MARS-ROBOTICS-star/Dummy-Robot-Reproduction/notes/钢网图案识别.png

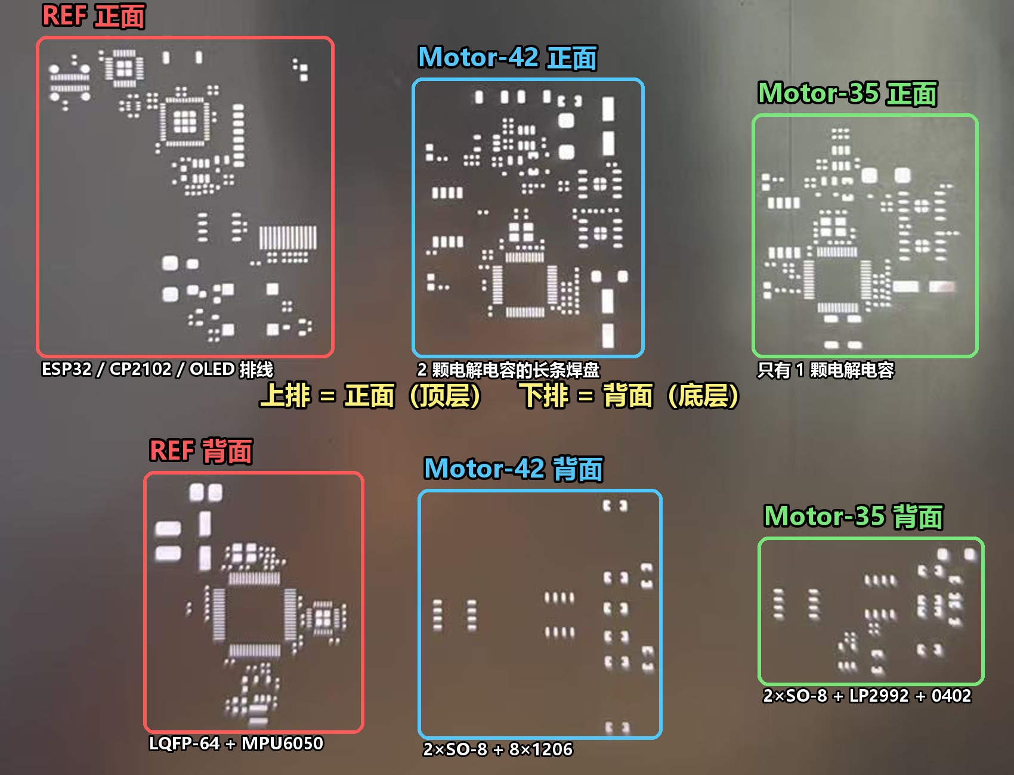
notes/钢网图案识别.png
