MARS-ROBOTICS-star/Dummy-Robot-Reproduction/notes/任同学视频字幕/README.md

# 不爱学习任同学 · Dummy 机械臂复刻系列 — 字幕（已修正）

来源：B 站 UP 主 **不爱学习任同学**（uid 341891548）合集《没有工科经验的人可以复刻稚晖君的 Dummy 机械臂吗》，共 15 集。
字幕为 B 站官方 **AI 自动字幕**（`ai-zh`），经本仓库上下文核对后修正术语与错词。仅作个人学习笔记用。

## 目录

| 目录 | 内容 |
|---|---|
| `srt_原始/` | 下载到的原始 AI 字幕，未改动，用于对照 |
| `srt_术语修正/` | **推荐使用**。时间轴与原始完全一致，可直接挂到视频上；同名 `.txt` 为带时间戳的纯文本 |
| `文稿_修正/` | 加标点、分段、句级改写的可读文稿（目前仅第 01 集，作为样例） |

## 分集清单

| # | BV 号 | 时长 | 标题 | 字幕条数 | 已修正 |
|---|---|---|---|---|---|
| 01 | BV18x421Q7Td | 18:39 | 开篇总览与软件准备 | 379 | 58 |
| 02 | BV1jD42157VY | 20:38 | 电路篇（上）· REF 主控板 | 474 | 81 |
| 03 | BV1YE421g7Uw | 26:19 | 电路篇（下）· CAN 布线与驱动板 | 561 | 58 |
| 04 | BV13m411r78Y | 07:29 | 必备工具 | 159 | 24 |
| 05 | BV1Jm411z78Y | 17:54 | 硬件选型 | 401 | 37 |
| 06 | BV1bi421f7VY | 34:41 | 焊接篇（上） | 621 | 67 |
| 07 | BV1mM4m1D7sS | 06:51 | 焊接篇（下）· 热风枪 | 104 | 20 |
| 08 | BV1vZ421Y77Q | 47:23 | 软件篇（全）· 编译 / 烧录 / CLI-Tool | 1018 | 73 |
| 09 | BV1ui421D7iA | 02:53 | 安装攻略定格动画 | — | 无字幕（纯定格动画，无旁白） |
| 10 | BV15D421V72k | 09:00 | 安装注意细节 / 避坑 | 179 | 38 |
| 11 | BV1by411h7FS | 29:53 | 整机调试教程 · DH 参数与 PID | 624 | 119 |
| 12 | BV11Z421e7YC | 00:22 | 橙白配色展示 | 6 | 0 |
| 13 | BV13Z421n7P3 | 00:24 | 青灰配色 | 4 | 0 |
| 14 | BV1cT421D7sL | 00:30 | 灰黑配色 | 8 | 0 |
| 15 | BV1SBi3eAE8P | 11:21 | 完结 QA + 抽奖 | 209 | 28 |

合计修正 **603** 条字幕。第 04、05 集片尾与第 06 集片头是纯音乐，AI 把歌词也转写了，已替换为「【片头/片尾 BGM，歌词略】」。

## 修正依据

术语拼写一律以**本仓库实际内容**为准，而非凭读音猜测：

- 目录与文件名：`motor42` / `motor35` / `ref-controller`、`dummy-ref-core-fw`、`CLI-Tool`、`DummyStudio`、`Robot/instances/dummy_robot.cpp`、`6dof_kinematic.cpp`
- 元器件型号：`ME3116`、`SY8089A`、`LP2992`、`CP2102`、`MT6816`、`SN65HVD232DR`、`TB67H450FNG`、`MPU6050`、`SH1107`
- 关节对应：`motor42` → J1/J2/J3，`motor35` → J4/J5/J6

### 高频错词对照（节选）

| AI 字幕 | 实际 | 依据 |
|---|---|---|
| 智慧军 / 智慧君 / 智慧基因 / 智慧运 | 稚晖君 | 人名 |
| 当机械臂 / 单机械毕业 / 挡米 / 当米 | Dummy 机械臂 | 项目名 |
| **斜坡** / 吸波减速器 / 细胞减速器 | **谐波减速器** | 全系列高频，108 处 |
| **勾一～勾六** / 高二 / go2 | **J1～J6** | 关节编号，经逐条核对 |
| **pad** / PAID / PIT | **PID** | 上下文为调参、KP/KI/KD |
| 向旭接错了 / 象限相续图 | 相序接错了 / 相序图 | 电机抖动的成因 |
| **镜像磁铁** | **径向磁铁** | 同音；原话解释"磁感线切割"即径向充磁 |
| 珐琅盘 | 法兰盘 | J5 转接件 |
| 卫衣孔 / 沉鱼孔 | 腰形孔 | 皮带轮收紧用 |
| 联系（了） | 连锡 | 焊接语境 |
| 续航 | 虚焊 | 焊接语境 |
| 吸球 / 稀疏 / 吃席 / 上劲 | 锡球 / 锡珠 / 吃锡 / 上锡 | 焊接语境 |
| 妥度 / 土豆 / 懂（吗） | 抖动 / 抖 | 调试语境 |
| 做上胶水 | 做个校准 | 电机校准 |
| 银角 / 阴角 / 音针 | 引脚 | — |
| 那后芯片 / QN 引脚 | QFN 引脚 | 引脚在底下的封装 |
| GABB 文件 | Gerber 文件 | 打板用 |
| STR 文件 / steam 文件 | STL 文件 / STEP 文件 | — |
| 报幕 / BB / BM | BOM 表 | — |
| boss 力 | 波特率 | 串口参数 |
| 包围宝马开关 / 拨码器 | 拨码开关 | 电机 ID 设定 |
| 饿死 / 饿死卡 fire | erase / erase configure | CLI 命令 |
| 木钩 / 木膏 / 木耳 / MOL | MOVJ / MOVL | 插补指令 |
| static | ST-Link | 烧录器 |
| open acd / 开过 | OpenOCD | 烧录后端 |
| 家里创 / 家里窗 / 加一创 | 嘉立创 | — |
| 乌班图 / 无关特 | Ubuntu | — |
| clean | CLion | — |
| out design / auto deserve | Altium Designer | — |
| fashion 360 / 费城 360 / 非 H360 | Fusion 360 | — |
| AITEE / g i t e git | Gitee | — |
| GBT / chat gbd | GPT / ChatGPT | — |
| 腮胡 / 三福 / 五福 | 3V3 / 3.3V / 5V | — |
| 长长臂 | 常闭 | 开关类型 |
| 零二电阻 / 02R | 0Ω 电阻 | 当跳线用 |
| 哈姆达克 | 哈默纳科 | 谐波减速器品牌 |
| 工矿经验 / 攻克经验 | 工科经验 | — |
| 复合成功 | 复刻成功 | — |

## ⚠️ 存疑未改（听音无法确定，保留原文）

这些地方术语表没有动，看视频时需自行判断：

1. **第 01 集 [03:08]**「建一个属于你自己的**纲领**」— 疑为某具体机型名，无法确定。
2. **第 01 集 [06:38]**「可以烧到这个**论坛**里」— 此处疑为 ROM / Flash；但本系列其他地方的"论坛"确实指开源社区，故未统一替换。
3. **第 01 集 [11:09]**「第一个是**孔指挥**的」— 疑为"稚晖君"。
4. **第 01 集 [12:17]**「把**三菱电机二零电机**的区别……板子也分为二零和三五」— 数字识别混乱。按仓库实际应为 42 与 35；已改为"35 电机、42 电机 / 分为 42 和 35"，但原话存疑。
5. **第 04 集 [04:52]**「包括**鞋包**也都买了」— 疑为锡膏。
6. **第 05 集 [01:27]**「STM32 是 103，可以**存档 200**」— 型号后缀不明。
7. **第 05 集 [03:41]**「芯片 232 **玩开镜片**」/「选 2VP232 是根据**报名表**选」— 已知芯片是 SN65HVD232DR，但这两句的修饰词不明。
8. **第 06 集 [02:21]**「但是呢**旺达罗斯**」— 完全不可解。
9. **第 06 集 [15:09]**「尤其是这个 **32 伏**的这个线」— 按电源规格应为 24V。
10. **第 06 集 [19:58]**「这个 **10 米 10 米法**耐压 50 的电容」— 疑为 10μF 或 100μF。
11. **第 08 集 [10:18]**「需要一个**航空员**」— 疑为航空插头。
12. **第 08 集 [18:18]**「为什么要加这个**括号**」— 按 CLI 用法疑为"空格"。
13. **第 08 集 [41:40]**「电机温度我一直是**理由**」— 疑为读数 0。
14. **第 11 集** 减速器参数（mini-11 瞬间最大扭矩 50 / 速比 17 / 平均 5.5；mini-8 为 6.6 / 2.3）— 数字由 AI 转写，未经核对，**不要直接当参数用**。
15. **第 11 集 [15:25]** 归巢位角度「把 70 改成 75」「-75」「木子的是 -73」— 与 `dummy_robot.cpp` 实际值是否一致未核对。

> 提醒：本系列口述的减速比、关节限位、连杆长度等关键参数，与 `6.Docs/DH参数` 图和 `dummy_robot.cpp` 源码之间本就存在冲突（见 `PROJECT_INDEX.md` 第五节）。字幕里的口述数值只能当线索，不能当依据。
