MARS-ROBOTICS-star/Dummy-Robot-Reproduction/workspace/stm32-roadmap-video-evidence/deliverables/zhihu-bilibili-synthesis-20260921.md

# 知乎与 Bilibili STM32/嵌入式调研综合报告

检索与综合日期：2026-09-21  
范围：知乎 13 篇 A 类回答、Bilibili 20 个去重 A 类视频。B/C 来源只用于说明筛选风险，不参与技术共识投票。  
用途：为 Dummy V2 E0-E13 学习与复刻阶段提供决策依据；本报告不是最终 6-12 个月日程表。

## 1. 执行结论

1. 最有效的学习方式不是“先学完再做”，也不是“完全不学基础直接抄项目”，而是以一个有边界的小项目为主线，按需求补 C、数字电路、MCU、外设和调试知识。
2. HAL、LL/标准库和寄存器不是互斥路线。工程层使用项目现有抽象以提高效率；理解和排障时回到参考手册、寄存器、时钟树、中断状态和数据手册。
3. 独立开发不等于不查资料。真正的独立性是能从需求拆模块、搭最小工程、读手册、设计观测点、定位故障、比较实现并记录验证结果。
4. FreeRTOS 和 Linux 不应成为 Dummy V2 前期门槛。Motor-42 的传感器、校准、本地闭环和安全停机稳定后，再在 F405/REF 阶段引入 FreeRTOS；Linux、ROS、视觉属于远期可选扩展。
5. B站的 BLDC/FOC 视频只能向 Dummy V2 迁移闭环、采样、PWM、电角度和坐标变换等概念。Motor-42 使用 MT6816 与 TB67H450，不能照搬三相桥、六步换相、相电流重构和引脚配置。
6. CAN 的学习目标不是“成功发出一帧”，而是完成双向协议、节点寻址、心跳、超时、错误恢复和安全 STOP。只有发送演示不足以通过 E6。
7. 两个平台共同支持“基础和项目交替推进”。对当前任务最合适的主线仍是：单块 Motor-42 可观察、可停止、可复现，再扩展 UART、CAN、F405/REF 和多轴。

## 2. 证据概况

| 平台 | A 类数量 | 强项 | 主要限制 |
|---|---:|---|---|
| 知乎 | 13 篇 | 路线取舍、HAL/寄存器争论、独立开发方法、调试思维 | 具体硬件操作、波形和完整工程证据较少；部分回答年代较旧 |
| Bilibili | 20 个 | 工程操作、代码界面、FOC/CAN/FreeRTOS 过程和可定位时间戳 | 容易受特定板卡、旧库和作者工程假设影响；AI 字幕可能误识别术语 |

知乎五主题中，HAL/寄存器达到 4 个 A 来源；系统嵌入式路线仅 1 个 A 来源。B站六主题中，项目、FOC、CAN、FreeRTOS 各有 4 个 A 入口；STM32 路线只有 2 个，嵌入式路线只有 3 个。缺口没有用广告、资料领取或培训内容补齐。

## 3. 两个平台如何互补

| 问题 | 知乎提供 | B站提供 | 综合用法 |
|---|---|---|---|
| 学习顺序 | 为什么要项目驱动、何时补基础 | 实际项目从建工程到外设运行的过程 | 知乎决定顺序，B站观察操作，再由官方资料确认细节 |
| HAL 与底层 | 抽象层的适用边界及争论 | CubeMX/HAL、标准库和移植实例 | 不为“追新”重写现有固件；排障时下钻寄存器 |
| 独立开发 | 空工程重写、驱动/应用分层、修改需求 | 遥控车、冰箱模拟、智能家居等完整操作 | 不照抄功能，抽取工程方法并改造成 Dummy V2 的下一阶段实验 |
| 调试 | SP/LR、异常压栈、mini shell、寄存器和手册 | 编译、配置、中断、CAN 回调与评论区故障案例 | 每一阶段都预先设计 UART、调试器、状态量和失败退出路径 |
| 电机闭环 | 强调项目、控制、反馈和系统约束 | PWM、ADC、Hall/编码器、Clarke/Park、桥臂画面 | 只迁移概念；Motor-42 参数、拓扑和限流必须本机验证 |
| CAN | 原则性强调协议和系统闭环 | 帧格式、发送/接收、ID、回调和电机报文 | 从单帧演示升级为双节点、超时和故障安全协议 |
| RTOS/Linux | 依据目标项目选择时机 | port、中断入口、任务创建和迁移操作 | FreeRTOS 放到 E8；Linux 不进入当前复刻主线 |

## 4. 跨平台高置信共识

### 4.1 项目驱动，但项目必须有边界

知乎 `512230445` 强调按项目需要学习外设、数据手册和调试；`2047983977533903446` 建议空工程重写、改写例程并做驱动/应用分层。B站 `BV1ptpFzCEix 00:03:18.430` 明确不必等 STM32 全部学完才开始项目，`BV1H4Lt6pENW 00:01:59.500` 建议先用小项目培养兴趣。

综合判断：每次只解决一个可验收问题。对 Dummy V2，项目单位应是“编译”“无运动烧录”“读取角度”“完成校准”“一次有界闭环”，而不是一开始就组装六轴。

### 4.2 底层知识应服务于实现和排障

知乎 `4521131322`、`1996577346627592562` 和 `3032793773` 都支持按目标组合 HAL/LL/寄存器；`62662899737` 建议用串口 mini shell 暴露寄存器和地址空间。B站项目与 FreeRTOS 视频则展示了抽象层对快速建工程和迁移的价值。

综合判断：保留 Dummy V2 原工程使用的库和初始化方式。遇到时钟、中断、SPI、PWM、CAN 或异常问题时，再查看参考手册、寄存器值和底层调用链，而不是提前把整个工程改写成寄存器版或 HAL 版。

### 4.3 教程到独立开发需要二次实现

知乎 `2047983977533903446` 的“脱离参考重写”和 `2448220703` 的时序、DMA、协议、内存约束都说明，跑通例程不是终点。B站项目视频能够演示工程过程，但其板卡、外设和业务需求并不等于 Dummy V2。

综合判断：每个教程只允许完成一次“参考实现”，随后必须完成至少一种二次实现：从空工程重建、修改接口、替换外设、增加故障处理、加入观测量，或在不看原代码时重新组织模块。

### 4.4 调试能力是核心产出

知乎 `512230445` 提到 SP/LR 和异常压栈，`62662899737` 提到寄存器访问与内存 dump，`115442835387` 强调调试器、寄存器状态和时钟。B站 CAN 与 FreeRTOS 视频显示，中断入口、接收回调、ID 分派、port 文件和时基配置决定系统是否真正工作。

综合判断：每一阶段的验收材料应包含构建结果、串口日志或调试变量、输入条件、输出结果、失败现象、定位过程和恢复方法。没有观测证据的“能跑”不算完成。

## 5. 主要分歧及裁决

### 5.1 先完整基础还是先做项目

- 基础优先派强调 C、数电、CPU、寄存器和手册。
- 项目优先派强调立即用小项目暴露知识缺口。
- 裁决：采用“最低必要基础 + 下一阶段实验”。只补足当前阶段需要的知识，不把整套模电、Linux 或 RTOS 课程作为 E0-E4 前置。

### 5.2 HAL 还是寄存器

- HAL 优先观点强调开发效率和现代工具链。
- 寄存器优先观点强调机制理解、性能和故障定位。
- 裁决：工程实现遵循现有项目栈；寄存器用于理解和验证。只有测量证明抽象层造成时序、性能或功能问题时，才在局部使用 LL/寄存器优化。

### 5.3 FreeRTOS 还是 Linux

- 有回答给出 C -> MCU -> RTOS -> Linux 的顺序。
- 也有回答认为应由岗位或现有项目决定。
- 裁决：Dummy V2 当前是 MCU 控制项目，FreeRTOS 与 F405/REF 的 E8 对齐；Linux 不属于 E0-E12 的必要条件。

### 5.4 六步换相是否等于 FOC

- 部分视频把硬件、六步换相和 FOC 放在同一系列中。
- 裁决：六步换相不是 FOC。相关视频可帮助理解电机和功率桥，但不能用六步换相代码替代 Dummy V2 的闭环控制逻辑。

### 5.5 学习广度还是主线深度

- 路线内容经常同时列出 RTOS、Linux、FPGA、无线、Qt、LVGL、ROS 和视觉。
- 裁决：这些是方向地图，不是当前待办。Dummy V2 的主线深度优先于技术栈数量。

## 6. Dummy V2 E0-E13 映射

| 阶段 | 综合学习重点 | 代表证据 | 进入下一阶段前必须证明 |
|---|---|---|---|
| E0 编译 | 工程结构、工具链、链接、错误定位 | 知乎 `2047983977533903446`；B站 `BV1kun3zBEu1` | 原工程可重复构建，错误和产物路径可解释 |
| E1 无运动烧录 | SWD、最小程序、恢复路径 | B站项目建工程演示 | 无电机运动、可擦写、可恢复、串口或 LED 可观察 |
| E2 读取 MT6816 | SPI、时序、状态位、角度连续性 | 知乎 `512230445`、`62662899737`；B站采样/编码器内容 | rawAngle、磁铁状态、奇偶校验和重复性有记录 |
| E3 校准 | 相序、传感器方向、零位、受限输出 | B站 FOC/无刷系列仅提供概念 | 低能量条件下校准可重复，异常可立即停止 |
| E4 本地闭环 | PWM、反馈、采样时序、状态机、限流 | B站 `BV19TSjB4EhV`、`BV1YiTb6dEED`；知乎 `2448220703` | 一次有界动作可重复，退出和断电判据明确 |
| E5 UART | 命令协议、授权、日志、watchdog | B站 `BV1Rven6BEH8`；知乎调试方法 | 非法/丢失命令进入安全状态，STOP 可验证 |
| E6 CAN 双节点 | 帧、ID、收发、心跳、超时、错误恢复 | `BV15b4y1Z7Tk`、`BV1bz411e7RG`、`BV1sZ4y1y7o2`、`BV1Z1421C7dP` | 双向通信、掉线和恢复均有测试；只有发送不通过 |
| E7 单关节 | 机械约束、负载、限位、断电 | B站电机内容仅作概念参考 | 夹具、行程、负载和急停条件经过实测 |
| E8 F405/REF | FreeRTOS port、中断、调度、节点管理 | `BV1394y1h7ho`、`BV1VG9ZYbEYQ`、`BV1BMdzB1E57` | 单节点功能不退化，调度和通信超时可测 |
| E9 参数冻结 | 参数来源、版本、复现实验 | 知乎文档化与工程闭环观点 | 参数、固件、硬件版本和验收结果可追溯 |
| E10-E12 多轴 | 资源预算、同步、故障隔离、整机联调 | 两平台只提供原则性支持 | 单轴成功不能外推；逐轴扩展并保留故障隔离 |
| E13 可选扩展 | ESP32、ROS、视觉、UI | 路线、MQTT、LVGL 内容 | 不影响基础控制安全；不作为当前主线前置 |

## 7. 推荐的按需资料栈

### 决策与学习方法

- 知乎 `2047983977533903446`：从教程到独立开发，空工程重写和分层。
- 知乎 `512230445`：项目驱动、手册、CPU 异常与调试。
- 知乎 `4521131322` 或 `1996577346627592562`：HAL/标准库/寄存器边界。
- B站 `BV1ptpFzCEix`：为什么不应等全部学完才开始项目。

### E0-E1 工程入口

- `BV1kun3zBEu1`：建工程和 GPIO 的操作路径。
- `BV1Rven6BEH8`：项目拆章、UART/蓝牙/状态机；只按需看章节，不建议一次看完近三小时。

### E2-E4 电机与闭环概念

- `BV19TSjB4EhV`：BLDC 基础与 Clarke/Park 概念。
- `BV1YiTb6dEED`：ADC 同步采样、PWM 与定时器初始化。
- `BV1tmsbzgExE`：传感器信号、ADC 和霍尔/编码器概念。
- `BV1RaNjzwEux`：三相桥和六步换相画面，只作拓扑对照。

### E6 CAN

- `BV15b4y1Z7Tk`：基础、发送与接收三部分。
- `BV1bz411e7RG`：电机 CAN 发送、接收回调和 ID 分派。
- `BV1sZ4y1y7o2`：CubeMX、中断和优先级配置。
- `BV1Z1421C7dP`：扩展帧和电机控制帧；作者明确没有接收应答，不能单独作为完整方案。

### E8 FreeRTOS

- `BV1394y1h7ho`：port 文件、中断宏和任务创建。
- `BV1VG9ZYbEYQ`：标准库工程迁移和中断定义。
- `BV1BMdzB1E57`：SVC 和最新 FreeRTOS 移植；LVGL 部分仅作 E13 参考。

## 8. 建议采用的学习闭环

1. 定义一个阶段唯一验收目标和禁止事项。
2. 阅读原项目代码、芯片手册和必要的一个知乎观点来源。
3. 只观看与当前阻塞点直接相关的 B站章节。
4. 先复现原始行为，再脱离教程完成一次重建或修改。
5. 记录输入、输出、日志、寄存器/变量、失败现象和修复过程。
6. 加入断线、非法输入、超时或复位等失败测试。
7. 通过验收后冻结参数、提交记录，再进入下一阶段。

## 9. 证据限制

- 知乎回答用于方法论和观点，不应替代 ST、MT6816、TB67H450、CAN 和 FreeRTOS 官方资料。
- B站 20 个 A 入口中，18 个有字幕时间戳；两个主要依靠实际画面抽帧。AI 字幕可能误识别 API 和芯片术语。
- CAN 视频包含 2020-2022 年材料，库 API 和工具界面可能过时，但帧、仲裁、ID 和收发模型仍可参考。
- FOC 视频主要面向三相 BLDC，与 Dummy V2 的两相驱动拓扑并不等价。
- 播放量、点赞和评论只用于描述来源，不作为技术正确性的证明。
- Gemini 视频提取因 HTTP 402 未完成，本综合报告没有引用未经核验的 Gemini 结论。

## 10. 最终判断

知乎和 B站共同否定了“先把所有课程学完再开始 Dummy V2”的做法，也不支持“照着视频把六轴一次拼完”。最稳妥的方案是以 Dummy V2 原代码和真实硬件为主线，把知识学习压缩到下一实验所需的最小集合；每次只扩大一个变量，并用日志、调试状态和安全退出证明结果。对当前阶段，优先级应保持为 Motor-42 单节点反馈与闭环，其次 UART/CAN，再到 F405/FreeRTOS 和多轴，Linux/ROS/视觉最后处理。
