MARS-ROBOTICS-star/Dummy-Robot-Reproduction/source/1.Dummy V2任同学整理/6.Docs/复刻审计_2026-09-06/deepseek_mechanical.md

> 原始子代理意见，保留用于审计追溯，不是执行依据。本文把同步带型号误认成 60 齿同步轮，3:1 传动比推断不成立；图片参数已由主审补读。以 [审计结论与证据](审计结论与证据.md) 及根目录冻结表为准，不据本文下单。

I now have complete evidence. Writing the final report.

---

# Dummy V2 机械与 BOM 只读审计报告（专职子代理 · DeepSeek V4 Pro）

## 0. 审计范围与方法

只读，未改动任何文件，未运行二进制/烧录/联网/安装依赖。已系统性读取：

- 根目录 `Dummy_V2复刻与学习方案_初稿.md`、`README.md`、`Dummy_V2项目全景科普讲义.md`（略读）
- `4.Model/` 全部机械版本文件树；**实际解析了**视频款 `Dummy-B v2装配体.step`、`改版/Dummy-B.STEP` 及 9 个 CNC `*.step` 的全部 `PRODUCT`/`PRODUCT_DEFINITION_FORMATION` 名称（STEP 为 ISO-10303-21 文本，用 grep 只读提取，非 CAD 几何解析）
- `5.Bom/dummy V2版本_bom.xlsx`（经现成的 `extracted/dummy V2版本_bom.json` 交叉核对原 xlsx，6 张表：REF / Motor-42 / Motor-35 / 部分淘宝123 / 一键购买443 / 其它）
- `6.Docs/`：DH 参数、减速器参数（JPG，**图像无法被本模型读取**，未据图断言）、PCB 照片、引脚/Cable PDF（pdftotext 已抽取）、芯片说明书
- 固件关键值：`dummy-ref-core-fw/Robot/instances/dummy_robot.cpp`、`Robot/algorithms/kinematic/6dof_kinematic.cpp`、`dummy-42motor-fw/UserApp/main.cpp`（用于交叉核对减速比/DH/校准电流，属机械参数溯源，不改动）
- `6.Docs/复刻审计_2026-09-06/` 的 `inventory_summary.json`、`file_inventory.csv`、全部 `extracted/*.txt` 作为辅助线索，均回溯源文件复核

**本报告未做 CAD 几何检查**（无 SolidWorks/FreeCAD、未解析面/体/装配约束），不把文件名当实物证据。

---

## 1. 关键发现（P0 = 阻塞项）

### P0-1 减速比冲突：装配体=50:1 vs 固件 J1~J5=30/24
- **证据**：`Dummy-B v2装配体.step` 与 `改版/Dummy-B.STEP` 的商品牌名含 `minif-11-50`、`min8-50`（谐波减速器标 50）；同文件另有 `D 及轮 5-30`、`5-28`。而 `dummy_robot.cpp:23-28` 配置 `CtrlStepMotor(... reduction=30/30/30/24/30, 角度 -170…720)`。`6.Docs/减速器参数/mini11_parameters.JPG`、`mini8_parameters.JPG` 为图像，本模型无法读，初稿“参数图证明 MINIF11/MINIF08 都有 30:1 和 50:1”**无法在此环境复验**，需人工核图。
- **触发条件**：直接按固件 30:1 或按装配体名 50:1 采购/装配。
- **影响**：总传动比（谐波 × 同步带 × 电机步距角）错 5/3，末端定位与 DH/运动学全错，标定失效，可能撞限位。
- **修复**：先人工读 mini11/mini8 JPG 确认可选减速比；再在 CAD 中反算每轴 `输出转角/输入转角`；同步带档位必须计入——装配体内含 GT2 同步轮 `GBN1302GT-60`、`GBN1502GT-60`（60T）与 `GPA20GT2060-A/B-H5`（20T，内孔 5mm），带传动比=3:1。
- **回归验收**：逐轴实测减速比与整机运动学一致后才写固件；给出“已确认参数表”见 §4。

### P0-2 42 电机长度未冻结（42-34 vs 42-40）
- **证据**：装配体与改版 STEP 同时出现 `42-34Motor Assembly` 与 `42-40Motor Assembly`；BOM“其它”表只列 `42电机 l=40 ×3`。初稿 10.1 已意识到此点，判断正确。
- **触发条件**：只按 BOM l=40 下单 3 台。
- **影响**：若某关节实际用 42-34，安装空间/轴伸/磁铁端不符，返工成本高。
- **修复**：在装配体中定位每个 `42-XXMotor Assembly` 归属的关节与数量，冻结 `l=34/l=40` 组合。
- **回归验收**：BOM 数量与 CAD 逐一对应，形成“零件-工艺-数量-版本-文件”矩阵。

### P0-3 Motor-42 无可机器读的 CPL/贴片坐标；BOM 非最终采购单
- **证据**：`1.Hardware/motor42/` 仅有 `motor42 Gaber.zip`、`Motor-42（焊盘更改版）.rar`、`.SchDoc/.PcbDoc`、History；`inventory_summary.json` 未列任何 `.cpl/.csv/.xlsx` 坐标。xlsx 的 Motor-42/Motor-35/REF 表是**原理图 Designator BOM**（含封装、层、TB/LC 价），但“一键购买/部分淘宝”是立创购物车导出（含 LC 商品编码），并非单套采购单，且**不是贴片坐标**。
- **触发条件**：直接拿现成 Gerber 委外贴片，期望机器可识别。
- **影响**：委外/贴片机无法识位；打样只能空板或手焊。
- **修复**：从 PcbDoc 重新导出 CPL/坐标并人工核对方向；补 REF/Motor 双板的单套 BOM。
- **回归验收**：CPL 与 Gerber 位置/方向一一比对通过。

### P0-4 减速器/同步轮/螺丝采购件不完整（分批门槛）
- **证据**：BOM“其它”表列 4×mini11、1×mini8、6×同步轮(20T 内孔5 外径18)、皮带(实测130×2/150×1)、圆柱销 5×35、轴承 5×13×4 ×4、5×10×4、LED、DC 插座、电源开关，电源 24V6A（原链接失效已换）。**螺丝仅“安装下图买即可”**，无消耗数量表。装配体商品牌名可辨认 `M3-5/8/10/14/16/25/35/40/45`、`M4-12/16/20`、hex nuts M3，但数量未核算。
- **触发条件**：阶段四整机下单。
- **影响**：缺件/多购/错规格，停机。
- **修复**：从 STEP 的紧固件 PRODUCT 去重后统计数量（可文本化统计），建立螺丝/销/轴承/皮带清单；分批采购（见 §6）。

### P0-5 6 针接口同载 24V+CAN，接线方向不同
- **证据**：`Cable_connection.pdf`（pdftotext）：“只有第一条线是同向线，其余都是反向线”；`Pins definations.pdf` 仅标题（REF/42/35 board Pins definations），正文为图片，引脚定义无法文本复验。初稿“接错可能损坏硬件”判断成立。
- **触发条件**：批量打线不分同向/反向或 24V 与 CAN 短接。
- **影响**：烧驱动/烧 MCU。
- **修复**：上线前逐根测通断与线序；统一线色/方向；限流上电。
- **回归验收**：每根 6P 线做 24V-GND-CANH-CANL 对位测试并留档。

---

## 2. P1 发现（中优先级）

- **P1-1 三版本并存**：4.Model 有 `稚晖君原版`(Case/Dummy v164/Motor42上下盖)、`木子晓汶版本3D模型`、`视频款V2`。BOM 仅对应视频款。初稿判断正确；建议物理隔离只读副本。
- **P1-2 改版关系未定**：视频款内有 `改版/`（基座改版.step、J1改版.step、Dummy-B.STEP、改版工程图8张）与 `CNC加工STEP文件/`、`Dummy-B 2D工程图/`。`基座改版/J1改版` 与 CNC 的 `基座/J1` 是否互相替换需在 CAD 中判定，**不可同时下单**。
- **P1-3 工程图维度可读但噪声大**：pdftotext 只抽出尺寸数字与 `M3/M4` 孔标注（±0.05/±0.20 公差），无标题栏/材料/数量。J4法兰盘.pdf、j5法兰盘.pdf 文本为空，Dimension 层缺失，尺寸缺失。公差普遍 `±0.05`（基座 `82 ±0.20`、`R20`、`贯穿 M4/M5`），属 CNC 精度等级，可支撑加工报价，但需人工读图补材料表。
- **P1-4 CCD 中电机/DH 已可确认**（§4），但 `6.Docs/DH参数/dummy V2 版本 DH参数.png` 为图像，无法以该图复核，仅以固件 `6dof_kinematic.cpp:32` 的 `DOF6Kinematic(0.109f,0.035f,0.146f,0.115f,0.052f,0.072f)` 为权威，与初稿 §10.2 提到的 109/35/146/115/52/72 一致。

---

## 3. P2 发现 / 已确认细节

- **P2-1** J2/J3 为合体件 `J23`（CNC `J23.step`、打印 `J23.stl`、工程图 `J23`），初稿按 J2、J3 分列传动比，但结构是一块。
- **P2-2** 打印件清单（25 项）：基座/J1/J2J3/J4/J5A/J5B/J6、J4法兰盘/J5法兰盘、42PCB外壳A/B、35PCB外壳A/B、外壳A/B/C、控制器外壳/内衬/屏幕底板、基座底板、以及 `.3mf`（基座、基座底板、35PCB外壳A/B）和亚克力 PCB 盖板 zip。CNC 件 9 项（基座/J1/J23/J4/J5A/J5B/J6/J4法兰盘/J5法兰盘）。
- **P2-3** 视频款打印件时间戳分散（2023-12 至 2025-02），`外壳A/B` 字节数完全相同（1589984），疑为复制件，需核对是否同一件两命名。
- **P2-4** 同步带档位同步轮明显为 GT2：60T 与 20T（H5=内孔 5mm），与 BOM“20齿内孔5外径18”对应，带传动比 3。
- **P2-5** 旧版模型夹带 `Out_stp1`（SolidWorks 源 SLDPRT/SLDDRW/DXF）为“木子晓汶”版，非视频款，不混用。
- **P2-6** Motor-42/Motor-35 原理图文件几乎字节级相同（inventory 重复组），初稿判断的“350 与 42 固件同源”成立，硬件差异主要在功率级，不在 MCU/编码器。

---

## 4. 已确认参数表（以源码/文本为据，未据图像）

| 项 | 值 | 来源（证据行） |
|---|---|---|
| DH: L_BS / D_BS / L_AM / L_FA / D_EW / L_WT (mm) | 109 / 35 / 146 / 115 / 52 / 72 | `6dof_kinematic.cpp:32` `DOF6Kinematic(0.109,0.035,0.146,0.115,0.052,0.072)` |
| 固件总减速比 J1~J6 | 30/30/30/**24**/30/50 | `dummy_robot.cpp:23-29` |
| 软件角度范围 J1~J6 (°) | -170~170 / -73~90 / 35~180 / -180~180 / -120~120 / -720~720 | `dummy_robot.cpp:24-29` |
| J6 电机 | 35 系列 l=20 行星减速 | BOM“其它”A4 |
| J4/J5 电机 | 35 系列 l=28 ×2 | BOM“其它”A3 |
| J1~J3 电机 | 42 系列 l=40 ×3（长 34 待核） | BOM“其它”A2 |
| 减速器 | mini11 ×4 + mini8 ×1 | BOM“其它”A5/A6 |
| 同步轮 | GT2 20T 内孔5mm 外径18 ×6；装配体含 60T(GBN1302/1502GT-60) | BOM A7 + STEP 商品牌名 |
| 皮带 | GT2，实测 130×2 / 150×1 | BOM“其它”A8 |
| 轴承/销 | 5×13×4 ×4、5×10×4 ×1、圆柱销 5×35 ×4 | BOM“其它”A14-16 |
| 电源 | 24V/6A（原链接失效已换） | BOM“其它”A11 |
| 42 电机板默认校准电流 | 2000 mA（额定 1000 mA） | `main.cpp:41,44` |
| 螺丝规格（可辨认） | M3-5/8/10/14/16/25/35/40/45, M4-12/16/20, M3 螺母 | STEP 商品牌名（数量未核算） |

---

## 5. 初稿必须修改的条目

1. **§10.1 表**：J4 减速比 24 是固件值，但 J4 是否经 3:1 同步带叠加需在装配体反算；表应加“待 CAD 反算”标记，不能当终值下单。
2. **§12 高优先级**：“参数图证明 MINIF11/MINIF08 都有 30:1 和 50:1” —— 本环境无法复验该图，应降为“待人工核图”而非事实；但装配体商品牌名 `minif-11-50`/`min8-50` 与固件 30/24 冲突是**文本可证**的矛盾，应上升为 P0。
3. **§12 高优先级**：需补一句“Motor-42/35/REF 均无机器可读贴片坐标(CPL)”，初稿只说“没有发现 Motor-42”，实测三块板都缺。
4. **§12**：同步轮/皮带“6 个 20 齿”正确，但应补充“装配体内现 60T 从动轮 GT2”，否则带减速比漏算。
5. **§10.2 机械冻结任务**：补充“先人工读 mini11/mini8 JPG 确定减速比”，并把“逐轴反算带传动”列为第一冻结动作（初稿已在第 5 项提反算，应把它从第 5 提到第 2，位置在版本判定之后、下单之前）。
6. **§6 采购**：单轴批“42×40 步进电机 … 80～250 元”之前，应先解决 P0-2 的 42-34/42-40 判定；否则可能买错长度。

---

## 6. 机械领域分阶段执行建议（冻结到加工）

**阶段 A：只读冻结（无需工具，1 周）**
1. 建立视频款零件编号-工艺-数量-版本-文件矩阵；明确 `改版/` 与 `CNC加工STEP文件/` 是否替换关系。
2. 人工读 `mini11_parameters.JPG`/`mini8_parameters.JPG`，记录可用减速比与额定扭矩。
3. 在 STEP 中定位 42-34 vs 42-40 归属关节与数量。

**阶段 B：CAD 复核（有 FreeCAD/Fusion 后）**
4. 打开两个总装 STEP，逐轴反算 `输出转角/输入转角`（谐波×带），与 30/30/30/24/30/50 对照。
5. 干涉/线束空间/限位角/装配顺序检查；DH 尺寸与装配体实测对照。
6. 导出每件 CNC 的 2D（含材料/数量/公差）→ 出正式加工图。

**阶段 C：样件验证**
7. 打印低成本样件验证孔位/装配**再**下 CNC 与金属件；同步轮/皮带/销/轴承/螺丝按冻结清单分批采购（先 J1~J3 下三轴，再腕部 J4~J6）。

**阶段 D：量测验收（每轴）**
8. 实测总减速比、回差、重复定位、温升、限位；与固件参数一致后写参数。
9. 逐根 6P 线做线序/绝缘测试；整机 24V 限流上电。

---

## 7. 未验证与缺件（明确声明）

- **未做 CAD 几何检查**：未解析 STEP 面/体/装配约束/干涉；PRODUCT 名称仅为文本证据。
- **图像不可读**：`减速器参数/*.JPG`、`DH参数/*.png`、`Pins definations.pdf` 正文、`工程图*.pdf` 图纸图形层本模型无法解析，相关数值仅以文本/源码为据。
- **螺丝消耗数量未核算**；皮带长度仅 BOM 文字“实测130×2/150×1”。
- **无贴片 CPL/钢网文件**（三块板均缺）；BOM 无单套归一清单。
- **未验证实物**：无实物器件、无电控测量结果；本报告不含任何实测电流/温升/定位数据，也未生成任何测试结果。
- **编译工具链**：环境未安装 `arm-none-eabi-gcc`（未验证），故未构建固件；固件结论均来自源码读数，非烧录运行。

（全文约 5000 字）
