MARS-ROBOTICS-star/Dummy-Robot-Reproduction/notes/每日工作概览.md

# Dummy-Robot 每日工作概览

> 用途：按日期记录 Dummy-Robot 的实际推进、关键判断和遗留项，供阶段复盘与最终总结使用。
>
> 当前覆盖：项目目录对应的 19 份 Claude JSONL 会话（去重后涉及 2026-10-13 至 2026-11-03）以及 2026-11-03 的 Codex 会话、现有项目笔记和 Git 提交。
>
> 记录原则：不逐条抄聊天；只保留当天的目标、完成项、证据、决策和未闭环事项。最新有效状态以 [项目最新进展](项目最新进展.md) 为准。

## 一、里程碑总览

| 日期 | 当日主线 | 当日结果 |
|---|---|---|
| 2026-10-13 | 认识 Altium、Gerber、Motor-42 原理图 | 建立 Motor-42 学习笔记，明确板文件、烧录口和手焊路线 |
| 2026-10-14 | REF 原理图、打板与 BOM 采购 | 建立 REF 笔记，形成实际采购 BOM 和分渠道采购思路 |
| 2026-10-23 | 仓库同步、焊接开工、LedRing 练手 | 完成第一次回流练习，开始 Motor-42 焊接准备 |
| 2026-10-25 | 热风枪与锡膏工艺练习 | 识别连涂锡膏导致小件漂移的风险，调整焊接方法 |
| 2026-10-27 | 钢网、摆件、Motor-42 正面焊接 | 完成首块 42 板正面回流与清洗，补齐连接器采购 |
| 2026-10-28 | 首块 42 板上电烧录、机械清单 | 首块板电源和烧录通过；定稿 3D 打印/CNC 清单 |
| 2026-10-30 | 三块 35 板和 REF 焊接 | 三块 35 板完成，开始统一断电测试和 REF 焊接 |
| 2026-10-31 | 七块板全部焊完、批量断电测试 | 发现 42-2 阻值差异和 35-2 的 3.3 V 短路 |
| 2026-11-01 | 分板上电与故障定位 | 5 块电机板通过；定位 42-3 CAN 事故与 35-2 连锡 |
| 2026-11-02 | 修板、编译、烧录、REF USB 排障 | 三类固件可编译；修 CAN 死锁；定位 REF 的 J1、U11 和启动阻塞 |
| 2026-11-03 | REF 3.3 V / VCAP 排障与状态归档 | 更换 U3/C20，锁定旧 L2 与 U12/VCAP 风险；建立长期状态与日志文档 |

## 二、每日明细

## 2026-10-13

**来源：Claude 会话**

### 目标

- 学习 Motor-42、Motor-35、REF 的原理图。
- 熟悉 Altium 的基本操作和工程文件类型。
- 判断哪些 Gerber 可以用于嘉立创打板，并为手焊和元器件采购做准备。

### 完成

- 解释了 Gerber、SchDoc、PcbDoc、PrjPCB 的用途以及原理图与 PCB 的对应关系。
- 学习了 Altium 的 2D/3D 视图、旋转、按位号查找元件等操作。
- 核对 Motor-42 的 P3：它由 UART 和 SWD 两组信号组成，没有供电脚；烧录时板子仍需从 P1/P2 供电。
- 明确 Motor-42、Motor-35、REF 都计划手焊，焊接流程需要兼顾双面元件和大体积电容。
- 建立 [motor42驱动板](motor42驱动板.md) 笔记。

### 决策与遗留

- 先从能看到实物结果的板卡学习，而不是先完整学完课程。
- Motor-42 的制造文件必须继续核对钻孔层，不能仅凭压缩包名称判断可直接投板。
- REF 与电机板接口定义不同，后续必须单独记录，不能套用同一接线。

## 2026-10-14

**来源：Claude 会话**

### 目标

- 继续读 REF 原理图。
- 确认打板参数、钢网用途、过孔和表面工艺。
- 把多个 BOM 转成可实际采购的清单，降低整机元件成本。

### 完成

- 建立 [ref主控板](ref主控板.md) 笔记，记录 REF 的接口、电源、芯片和焊接重点。
- 明确普通表面工艺可以使用，不必为本项目强制选择沉金。
- 讨论 0.254 mm 过孔、板厂下单参数和钢网的作用。
- 将原始 BOM 按立创商城模板整理，并把“立创商城、淘宝、已有物料”分开考虑。
- 用实际订单更新采购数据，形成当前的实际采购工作簿。
- 识别 REF 的 8 MHz 晶振负载电容匹配并非理想，但当时判断不影响 USB/CAN 基本工作。
- 规划焊接工具、可调电源、显微观察和板卡/电机固定工具。

### 决策与遗留

- 采购表是计划与订单记录，不等于现场库存；后续必须实物清点。
- 部分低价淘宝器件可能承担兼容和真伪风险，需要保留原型号与替代依据。
- REF 与电机板晶振外形相同、频率不同，分料时必须单独标记。

## 2026-10-23

**来源：Claude 会话、Git**

### 目标

- 把远端项目同步到本地并保留本地资料。
- 根据任同学视频字幕开始实际焊接。
- 先用 LedRing 练习，再进入 Motor-42。

### 完成

- 同步 GitHub 仓库，保留本地版本；将 Altium History 备份移出版本控制并写入忽略规则。
- 整理任同学焊接经验，建立 LedRing 和电机驱动板的焊接流程。
- LedRing 使用锡膏和加热台完成第一次回流；记录 150 ℃ 开始冒烟、约 200 ℃ 焊锡熔化的实际现象。
- 讨论助焊剂、加热台升温方式、焊后万用表检查和 ZH1.5 线束。
- 决定先焊 Motor-42，再焊 Motor-35；为三块板规划钢网。
- 查找江协课程中与电机驱动控制相关的内容。

### 决策与遗留

- 正式板优先使用钢网控制锡量，减少 0402 和密脚芯片的桥连。
- 第一块板承担工艺验证和对照板角色，后续板卡以它为参考。

## 2026-10-25

**来源：Claude 会话**

### 实践

- 用热风枪练习贴片焊接：先连涂锡膏、再放电阻，以约 350 ℃、风速 2–3 加热。
- 观察到部分小电阻被连续锡膏拖离焊盘，确认锡膏过量、连涂和风力都会造成漂移。

### 调整

- 正式板应尽量依靠钢网；手点时分焊盘少量点涂。
- 先低风速预热，待助焊剂变黏后再完成回流，避免直吹小件。
- 芯片是否受热不能只看热风枪设定温度，还要控制距离、时间、风量和板体预热。

## 2026-10-27

**来源：Claude 会话**

### 目标

- 使用无框钢网完成 Motor-42 摆件和正面回流。
- 让实际采购 BOM 可以快速定位元件、方向和位号。

### 完成

- 讨论钢网是否切分、如何用废板围边和胶带定位。
- 基于实际采购表制作 [我的采购BOM_交互版](我的采购BOM_交互版.html)，补充元件类别、位号和方向提示。
- 完成 Motor-42 正面元件摆放和加热台回流。
- 处理 K1、K2、S1 等不适合跟随正面回流的器件，记录焊后清洗方法。
- 确认 95% 酒精可用于板面清洁。
- 发现直插/弯插连接器选型问题，补充弯插下单需求。

### 遗留

- 首块 42 板仍需断电检查、上电、烧录和电机测试。

## 2026-10-28

**来源：Claude 会话、项目笔记**

### 电路板

- 首块 Motor-42 完成断电检查；曾发现背面电容焊接短路，返修后 C14、T1、T2 对地读数恢复。
- 使用可调电源缓升：输入、5.2 V、3.3 V 均正常，空载电流正常。
- 连接 ST-Link 并成功烧录，板上 LED 点亮。
- 开始规划连接电机、观察编码器与实现单电机动作，但当天没有形成闭环验收记录。

### 机械与预算

- 打开“视频款”装配体，核对 J1、J5 法兰、PCB 外壳、控制器屏幕底板等零件。
- 完成 [3D打印与CNC清单](3D打印与CNC清单.md)：
  - 有 CNC 文件的受力结构件走 CNC。
  - 其余外壳和底板走 3D 打印。
  - 从装配体补出 0013、0016、0027、0037 等缺失件。
- 历史记录中的估算：3D 打印 58.99 元；全套 CNC 约 1350 元；钢网 59 元已并入 PCB 项。

### 决策

- 机械结构固定使用“Dummy V2 版本 视频款”，不与木子版混装。
- 预算统计需区分工具、板卡、结构件和整机材料，避免重复计算。

## 2026-10-30

**来源：Claude 会话**

### 完成

- 三块 Motor-35 全部完成焊接。
- 开始对三块 35 板进行断电短路、供电轨和关键电阻检查。
- 明确实际测得电阻略低于标称值可能来自器件容差和板上并联通路，不能只凭单点读数判坏。
- 开始 REF 主控板焊接，重点讨论双面钢网、背面小元件和 OLED 排线的耐热与焊接顺序。

### 遗留

- 三块 35 板和 REF 仍需统一上电测试。
- REF 双面元件密集，后续必须把焊接工艺和电气测试分开验收。

## 2026-10-31

**来源：Claude 会话**

### 完成

- 7 块板全部完成焊接，开始统一万用表测试。
- 给板卡编号，便于后续记录：
  - Motor-42：42-1、42-2、42-3。
  - Motor-35：35-1、35-2、35-3。
- 记录 42-2 的 T2 对地约 13.4 kΩ，其他两块约 9.7 kΩ；后续上电证明该差异不影响工作。
- 对 42 板 STM32、CAN 芯片、编码器、电源轨和地线进行连通性对照。
- 在 35-2 发现 3.3 V 对地短路，开始用对照板和低压注入定位。
- 进入 REF 的断电测试。

### 决策

- 后续所有测试必须按板号记录，避免把一次测量结果套到另一块板。
- “蜂鸣”只能表示低阻或二极管通路，不能脱离原理图直接等同短路。

## 2026-11-01

**来源：Claude 会话、[七块板测试记录](七块板测试记录.md)**

### 正常板

- 42-1 上电通过，关键电压和电流正常。
- 42-2 上电通过，证明 13.4 kΩ 的静态差异不是故障。
- 35-1、35-3 上电通过；35-1 在 9 V 下电流约 0.009 A。

### 42-3 故障

- 24 V/CAN 线误碰后，3.3 V 对地短路，定位到 U5（CAN 收发器）发热。
- 拆 U5 后短路消失；重焊原 U7 稳压器后 T2 恢复 3.3 V。
- 后续 SWD 始终无法连接，结合供电、NRST、BOOT0、SWD 走线均正常，最终判断 STM32F103 也在同一次 24 V 事故中损坏。

### 35-2 故障

- 低压注入显示多个 3.3 V 测点电位接近，最初在 R4 一带排查。
- 重新处理 STM32 引脚后，T2 对地从 0 恢复到约 13 kΩ，确认主要问题是 STM32 引脚连锡。
- 上电后 5 V 仍未建立，留待次日继续查 D4/U6 输入链路。

### 记录

- 建立并持续扩充 [七块板测试记录](七块板测试记录.md)，把测量方法、误判和返修结果按板号保存。

## 2026-11-02

**来源：Claude 会话、Git 提交、项目笔记**

### 35-2 修复

- 发现 D4 下端测量会因表笔按压而暂时接通；更换 D4 后 5 V、3.3 V 和上电电流全部恢复。
- 35-2 上电测试通过。

### 固件编译与代码修复

- 修复 Motor-35 在 Linux 下引用不存在的 stdint-gcc.h。
- 修复 REF 中 mpu6050.hpp 与实际 MPU6050.hpp 的大小写不一致。
- Motor-42、Motor-35、REF 三份固件均在 Linux + arm-none-eabi-gcc 10.3.1 下构建成功，并保存 bin、elf、hex、map。
- 修复 Motor-42 / Motor-35 在 CAN 发送或接收失败时进入 Error_Handler 死循环的问题。
- 定位 REF 未接电机板时 OLED 不亮的固件原因：dummy.Init() 发送 CAN 后永久等待。源码暂时注释该调用。

### 烧录

- 42-2 烧录通过；42-1 之前已烧录。两块均早于 CAN 修复，需要重烧。
- 42-3 无法通过 SWD 连接，进一步确认 STM32 已损坏。
- 35-1、35-2、35-3 全部烧录成功；35-1 的 LED2 虚焊经补焊恢复。
- REF 烧录成功。

### REF USB / OLED 排障

- REF 初始断电和上电测试通过。
- 先定位到 J1 内部 D+ 与 CC1 短路；更换 J1 后短路消失，CP2102 一侧稳定枚举。
- Hot Plug、寄存器和引脚电压继续定位到 U11 第 4 脚接收输出卡低，导致 CAN1 初始化超时并进入 Error_Handler，USB 尚未初始化。
- 抬起 U11 第 4 脚后，焊盘恢复 3.3 V，USB 识别为 COM10，确认 U11 损坏而 STM32 当时仍能运行。
- 记录一个关键教训：REF 限流 0.1 A 会使降压电源卡在约 4 V，相关测量无效；当时稳定启动需 0.3 A。

### Git 与文档

- 同步 Altium、BOM、3D 模型、构建产物和测试记录。
- 提交 Linux 构建修复、CAN 死锁修复、REF dummy.Init() 临时修改及 USB 排障文档。

## 2026-11-03

**来源：Claude 会话开头、Codex 当日会话、项目文件**

### 目标

- 继续解决 REF 从 P1 上电时 3.3 V 不起、输入进入 CC、板上发热的问题。
- 尽量通过原理图、电压分段和低压注入定位，减少不必要的拆焊。
- 核对 L2 的原型号、库存和可购买替代品。

### 排障过程

- 选择 P1 GND 作为注入与测量公共地；寻找比 C10 更容易连接的 3.3 V 点。
- 1 V / 0.1 A 向 3V3 注入时，除 C20 外的各负载点约 0.97–0.98 V；2 V 时各点约 1.96 V。由此排除多数分支的金属性硬短路。
- 从 P1 上电时，9 V 输入进入 CC并掉到约 4–5 V，C10 只有约 1.4–2.87 V；C15 也随输入掉压。
- 拆下 L2 后，电源恢复 CV，C15 = 5.21 V、C10 = 0 V，问题被集中到 U3 / L2 / 3V3 负载侧，而不是 5.2 V 前级。
- 测得 L2 靠 U3 的开关节点约 2.52 V。更换 U3 和 C20；由于 L2 无库存，临时回装旧 L2。
- 回装后 C10 一度恢复 3.3 V，但 U12 开始明显发热；后续冷启动又出现 CC、C10 = 2.87 V、C34/C35 = 1.45 V。
- 将 C36 / NRST 持续拉低后，电源由 CC 恢复 CV，C10 回到 3.3 V；松开复位后仍保持稳定，说明不是持续性 3V3 硬短路。
- 在保持复位、3.3 V 稳定时，C34/C35 均为 1.71 V；该值超出 STM32F405 VCAP 正常 1.20–1.32 V。重新拖焊 U12 后现象不变。
- 断电时 C10 与 C34/C35、U12 的部分 VDD/VCAP 引脚蜂鸣；结合芯片内部稳压器结构，蜂鸣本身不再作为外部焊桥的决定性证据，稳定上电的 1.71 V 才是关键异常。

### 器件与采购结论

- 原 L2：TDK TFM252012ALTA2R2MTAA，2.2 µH、2.5 × 2.0 × 1.2 mm、Isat 2.8 A、DCR 最大 84 mΩ。
- 第一款淘宝候选 NLV25T 2.2 µH 额定电流只有约 200 mA、DCR 约 1.55 Ω，不可用于该降压级。
- 第二款 APH252012C2R2MP01 参数匹配：2.2 µH、2520、DCR 最大 65 mΩ、Irms 2.7 A、Isat 3.3 A，可作为替代候选。
- 采购表没有可确认的 L2 余货；U3 的账面余量与现场实物不一致，再次确认库存必须以现场为准。

### 当日结论

- 旧 U3/C20 已被替换，3.3 V 降压级可以建立输出。
- 当前仍有两个需要分开验证的问题：
  1. 旧 L2 的启动瞬态能力是否不足。
  2. C34/C35 外围或 U12 内部 1.2 V 稳压器是否损坏。
- 在换 L2、核对 VCAP 电容和地之前，不直接判定或更换 STM32F405。
- REF 暂停固件、USB、OLED 和 24 V 测试，防止 U12 继续受损。

### 文档建设

- 更新 [七块板测试记录](七块板测试记录.md) 的 REF 3.3 V / VCAP 故障章节。
- 建立 [项目最新进展](项目最新进展.md)，把当前有效状态与历史过程分开。
- 建立本每日工作概览，覆盖全部 Claude 工作日和当日 Codex 排障。
- 建立根目录 [AGENTS.md](../AGENTS.md)，规定后续代理的读取顺序、文件索引和维护方式。

## 2026-11-04

**来源：OpenCode 会话**

### 目标

- 按原版整机装配体复核螺丝、垫片、螺母的实际用量。
- 对比任同学 BOM 与 Ryan BOM 的螺丝和减速器，并打开淘宝链接核对现价。

### 完成

- 重新解析 `Dummy-B v2装配体.step`：71 个零件/装配定义、197 条 NAUO、180 个叶零件实例，紧固件结果与此前记录一致（12 种螺丝共 98 颗、M3 平垫片 12 片、M3 螺母 4 个）。
- 从任同学 BOM 内嵌的两张订单截图重新读出 11 种螺丝 490 颗、M3×8×0.8 平垫圈 100 片；Ryan 表 13 种规格 600 颗、39.24 元，其中 M3×8 重复两行。
- 用已登录淘宝会话实际打开两条减速器链接并读取 SKU：两家 MINIF11-50-B 均为 260 元、MINIF8-50-B 均为 300 元；任同学店另有交叉滚子轴承版 Mini11 300 元。任同学链接“60 元起”是波发生器 SKU，不是整机。
- 读取 Ryan 两家螺丝店的实时 SKU，按模型 98 颗重算约 49–66 元，并确认两家都缺 M3 螺母和 5×8×1.2 轴用垫片。
- 修复两条工具链：`chrome-devtools` MCP 原用 `--autoConnect`，读取到 11:08 遗留的 `~/.config/google-chrome/DevToolsActivePort`（端口 45119 已无进程），改为包装脚本固定连接 9222；`cn-scraper` 缺 `~/.cn-scraper-cookies/taobao.json`，用 `harvest_cookies(taobao, 9222)` 导出 46 条 cookie 后 `taobao_search/taobao_product` 恢复。清理了验证过程中打开的 47 个重复标签页。
- 对减速器和螺丝 SKU 做了真实鼠标点击复核（`isSelected` 状态 + 页面价格变化）：任同学店 Mini11-50 深沟球 260／交叉滚子 300、Mini8-50 300、波发生器 60；Ryan 店 Mini11-50 260、Mini8-50 300；天猫螺丝 M3×16 100 颗 6.54 元、M4×16 50 颗 4.86 元；另一家 M3×16 20 颗券后 1.90 元。

### 判断变化

- 此前“淘宝打不开、无法比较两家减速器价格”的边界已解除：同规格现价一致，差异在轴承版本、发货时效和店铺销量，不在价格。
- 两份 BOM 都漏 M3×16（模型需 14 颗）；任同学覆盖模型 11/12 种规格，Ryan 只覆盖 5/12 种。

### 未闭环

- 模型不含减速器轴承版本信息，深沟球/交叉滚子仍需按关节刚性需求选型。
- 任同学螺丝只有截图，无店铺和单价，无法做螺丝价格横比。
- 控制器屏幕底板与 OLED 固定螺丝、电机/减速器随件螺丝仍未纳入清单。

### 采购落地（同日晚）

- 把当天 10 笔订单录入 `实际采购iBOM_Dummy整机.xlsx`，金额以淘宝订单页为准，链接用订单里的真实商品 id：
  - 紧固件 → 「螺丝」表新建 16 行（12 种内六角螺丝 + M3 螺母 200 颗 + M3×8×0.8 平垫 50 片 + 5×8×0.2 与 5×8×1 超薄垫片各 100 片，共 1120 颗）：金超店 M4×20/16/12、M3×45/40/35/16/8（35.52），天诚五金补 M3×25/14/10/5（12.00，补齐装配体缺的四种短板长度），以瑟 M3 螺母 2.22、洋鑫 M3 平垫 1.51、劲功两种超薄垫片 10.24，5 单实付 61.49 元。
  - 传动件 → 「电机减速器」表：谐波 Mini11×4、Mini8×1（同单实付 1320.00）、同步轮×6、同步带 130 mm×2 与 150 mm×1、3P 单头 150 mm 短线×5；这些行由“核价”改为实付单价，并把总价公式改为 `SUM(G6:G24)`，此前公式刻意排除了 G10:G14（当时未下单）。
  - 补充元器件 → 「元器件采购」表新增「淘宝补购(2026-11-04)」区段：STM32F405RGT6×2（37.60）、SN65HVD232DR×5（17.50）、贴片一体成型电感 1008 2.2 µH 3.8 A×1 包 20 只（3.70），实付 58.80 元；采购总览同步加一行。
  - 结构件 → 新建「CNC结构件」表：闲鱼「手搓宅_（鱼小铺）」全套 CNC 含底座 1393.00 元 + 小尺寸底板 115.00 元，合计 1508.00 元，均待发货。
- 当天 11 笔订单实付合计约 1472.91 元（含运费 3.00 元的 3P 线订单 4.00 元），再加 2 笔 CNC 订单 1508.00 元，当天共约 2980.91 元。

### 成本核算（同日）

- 新建「成本总览」表，按已付款口径汇总 7 张表：本体 3928.98 元（元器件 509.08、PCB 211.90、电机/减速器/传动 1579.34、紧固件 61.49、3D 打印 59.17、CNC 1508.00）+ 工具 694.58 元 = 4623.56 元。
- 核对后确认这笔钱不等于“整机买齐”：3D 打印只下单 12/19 件，5×8×1.2 轴用垫片 6 件没买，补齐约 25–45 元；含备件余量约 250–300 元，装机口径本体约 3650 元。
- 与路线图阶段 8 的 2000–4000 元估价对照，当前 3928.98 元已在上沿，主要来自多买 1 颗 F405、13 片 PCB 和整包紧固件。

### 判断变化

- 缺口表里 SN65HVD232DR、ZH1.5 3P 线和 L2 候选都已下单，REF/42-3 维修不再卡在缺料；但 L2 是 1008/2520 封装的一体成型电感，DCR、Irms、Isat 与高度必须到货核对后才能替代 TFM252012ALTA2R2MTAA。
- CNC 全套 1393 元已含底座，同店又单买了 115 元小尺寸底板，存在重复件可能，到货要核对（多出的一块可作备用）。
- 谐波减速器实际单价 256.12/295.52 低于此前核价的 260/300，4+1 套装合计 1320 元。

## 三、后续每天怎么记

每个实际工作日只追加一节，推荐固定写五项：

1. 当天目标。
2. 实际完成。
3. 测量或文件证据。
4. 当天改变了什么判断。
5. 未闭环项与下一步。

如果当天结论改变了项目现状，还要同步更新 [项目最新进展](项目最新进展.md)；如果涉及板级测量，则同时更新 [七块板测试记录](七块板测试记录.md)。
