MARS-ROBOTICS-star/Dummy-Robot-Reproduction/notes/项目最新进展.md

# Dummy-Robot 项目最新进展

> 状态日期：2026-11-03
>
> 用途：这是项目“当前状态”的首要入口。历史过程看 [每日工作概览](每日工作概览.md)，板级测量证据看 [七块板测试记录](七块板测试记录.md)。
>
> 更新规则：只保留目前仍成立的结论；已被后续测试推翻的判断移入每日概览或具体排障记录。

## 一、当前结论

Dummy V2 的 7 块 PCB（Motor-42 ×3、Motor-35 ×3、REF ×1）均已完成焊接。当前有 5 块电机板可继续使用，42-3 和 REF 仍是硬件阻塞项：

- 42-1、42-2：上电和烧录均通过，但板上仍是 CAN 死锁修复前的固件，需要重烧。
- 35-1、35-2、35-3：上电、烧录和 LED 现象均已通过。
- 42-3：一次 24 V 误接损坏 U5（CAN）和 U3（STM32F103），等待一起更换。
- REF：U3、C20 更换后 3.3 V 能恢复，但冷启动仍可能进入 CC；U12 发热，保持复位时 VCAP 仍为 1.71 V，明显高于 STM32F405 的正常 1.20–1.32 V，当前禁止长时间上电。

实际进度已经超过 2026-09-29 路线图中的“尚未有硬件”快照，但还没有完成单电机闭环、两板 CAN 联调或整机六轴验收。现阶段应先把 42-3 和 REF 修到稳定，再进入电机和总线联调。

## 二、七块板状态

| 板卡 | 电源/硬件 | 固件 | 当前动作 |
|---|---|---|---|
| 42-1 | 9 V 上电通过，关键电压正常 | 已烧录旧版 | 重烧含 CAN 死锁修复的新 hex |
| 42-2 | 上电通过；T2 对地 13.4 kΩ 已证实不影响工作 | 已烧录旧版 | 与 42-1 一起重烧 |
| 42-3 | 电源级仍正常；U5、STM32F103 已损坏 | SWD 无法连接 | 更换 U5 + STM32F103 后重新做断电、缓升、烧录测试 |
| 35-1 | 上电通过；LED2 虚焊已修复 | 已烧录 | 可用于后续联调 |
| 35-2 | STM32 引脚连锡和 D4 故障均已修复 | 已烧录 | 可用于后续联调 |
| 35-3 | 上电通过 | 已烧录 | 可用于后续联调 |
| REF | J1 已换；U11 损坏；U3、C20 已换；旧 L2 临时回装；U12/VCAP 异常 | 旧固件可运行，USB 曾识别为 COM10 | 先修电源与 VCAP，再换 U11、重烧 REF 新固件 |

完整测量值、测点图和排障过程统一维护在 [七块板测试记录](七块板测试记录.md)。

## 三、REF 当前故障链

### 1. 已经确认并处理过的问题

- Type-C 座 J1 内部 D+ 与 CC1 短路：J1 已更换，短路消失。
- CAN 收发器 U11（SN65HVD232DR）接收输出长期为低：抬起第 4 脚后 CAN1 初始化可以通过，STM32 USB 曾正常识别为 COM10。U11 仍需更换；当前 CAN 不能接收。
- 未接电机板时，REF 固件在 dummy.Init() 的 CAN 发送中永久等待：源码已临时注释该调用，但板上还需重烧对应新固件。

### 2. 2026-11-03 新出现的 3.3 V / VCAP 问题

- P1 输入 9 V、限流 0.1–0.3 A 时曾进入 CC，输入掉到约 4–5 V，C10 不能稳定到 3.3 V。
- 拆下 L2 后，5.2 V 前级恢复正常，问题被隔离到 U3 / L2 / 3V3 负载侧。
- 已更换 U3（SY8089A1AAC）和 C20；无 L2 备件，因此回装旧 L2。
- 首次回装后 C10 恢复 3.3 V，但 U12（STM32F405）明显发热；后续冷启动仍出现 CC、C10 约 2.87 V。
- 保持 C36 / NRST 为低时，电源由 CC 恢复 CV，C10 恢复 3.3 V；松开复位后仍能保持 CV。这说明当前不是持续性 3V3 硬短路，冷启动瞬态、旧 L2 和 U12 启动状态均需继续排查。
- 在复位保持、C10 已稳定 3.3 V 时，C34、C35 均为 1.71 V。该值不能由程序负载解释，VCAP 外围或 U12 内部稳压器存在异常。
- U12 已重新拖焊，现象未消失。断电蜂鸣不能单独证明 VCAP 与 3V3 外部短接，因为芯片内部稳压器也可能形成万用表可检测的通路。

### 3. REF 下一步顺序

1. 不长时间上电，不提高限流，不升到 24 V。
2. 更换 L2。原件为 TDK TFM252012ALTA2R2MTAA；可用的淘宝替代候选为 APH252012C2R2MP01（2.2 µH、2520、DCR ≤65 mΩ、Irms 2.7 A、Isat 3.3 A）。低电流的 NLV25T 2.2 µH 不可用。
3. 断电确认 C34、C35 接地可靠；修复时按 STM32F405 官方要求改用 2.2 µF、X5R/X7R、≥6.3 V、0402。
4. 如果换 L2、确认 VCAP 电容后，保持复位上电仍为 1.71 V，再拆 U12 做空焊盘隔离，不能直接盲换。
5. 修复合格标准：9 V、0.2–0.3 A 限流，保持复位时 C10 = 3.3 V，C34/C35 = 1.20–1.32 V，电源保持 CV，U12 不迅速发热。
6. 电源稳定后再换 U11、重烧 REF 新固件、验证 USB/OLED/CAN。

## 四、固件与工具链

- Motor-42、Motor-35、REF 三份固件均已在 Linux + arm-none-eabi-gcc 10.3.1 下编译通过。
- 构建产物位于 source/1.Dummy V2任同学整理/2.Firmware/build/：
  - motor42-baseline
  - motor35-baseline
  - ref-baseline
- 已修复 Motor-42 / Motor-35 的 CAN 发送或接收失败即进入死循环的问题；遗留问题是 AutoBusOff 仍关闭，尚无 bus-off 恢复逻辑。
- 42-1、42-2 烧录的是修复前固件，需要重烧；35 三块已在修复后烧录。
- REF 源码已临时注释 dummy.Init()，但当前先暂停烧录，等 3.3 V / VCAP 硬件稳定后再继续。
- REF 的 CCMRAM 已占满 64 KB，后续增加静态对象或任务栈前必须先检查 map 文件。

## 五、采购与备件

### 当前明确缺口

| 物料 | 用途 | 状态 |
|---|---|---|
| SN65HVD232DR | 42-3 U5、REF U11 和备件 | 2026-11-04 已补购 5 颗（swthxt，运输中）：42-3 U5 + REF U11 + 3 颗备件，缺口解除 |
| STM32F103CBT6 | 42-3 U3 | 采购表记录过重购 6 颗，但实物到货状态需按现场确认 |
| L2：2.2 µH、2520、Isat ≥2.8 A、DCR ≤0.1 Ω、高度 ≤1.2 mm | REF 3.3 V 降压级 | 已购 1008（公制 2520）2.2 µH 3.8 A 一体成型电感 20 只（集科数码，运输中）；到货仍需核对 DCR/Irms/Isat/高度后才算可用 |
| 2.2 µF X5R/X7R、≥6.3 V、0402 | REF C34/C35 | 修 VCAP 时使用 |
| STM32F405RGT6 | REF U12 候选 | 2026-11-04 已补购 2 颗（ST ADI 直售）：U12 候选 + 1 颗备件 |
| 1N5819WS（SOD-323） | 电机板备件 | 35-2 已用掉最后一颗 |
| ZH1.5 3P 线 | REF P3 / LedRing | 2026-11-04 已购 3P 单头 150 mm ×5（晟之源），缺口解除 |

2026-11-04 的紧固件（12 种内六角螺丝 + M3 螺母/平垫 + 5×8×0.2 与 5×8×1 超薄垫片，共 1120 颗；金超 35.52 + 天诚 12.00 + 以瑟 2.22 + 洋鑫 1.51 + 劲功 10.24 = 61.49 元）、传动件（谐波 Mini11×4 + Mini8×1、同步轮×6、同步带 130/150 mm、3P 短线）与整机 CNC 结构件（闲鱼 手搓宅_ 全套 1393 元 + 小尺寸底板 115 元）均已下单，明细见下表文件；CNC 与谐波、同步件均为“待发货”，收货后必须逐件清点。

采购与库存应以 source/1.Dummy V2任同学整理/5.Bom/实际采购iBOM_Dummy整机.xlsx 和现场实物共同核对；表格中的“余量”不能替代实物清点。

### 已付款总额（2026-11-04 快照）

| 口径 | 金额 | 构成 |
|---|---|---|
| 机器人本体 | 3928.98 元 | 元器件 509.08 + PCB 打样 211.90 + 电机/减速器/传动/线束/电源 1579.34 + 紧固件 61.49 + 3D 打印 59.17 + CNC 结构件 1508.00 |
| 工具/耗材 | 694.58 元 | 电源、万用表、热风枪、加热台、烙铁、锡膏、放大镜、收纳盒等 |
| 合计 | 4623.56 元 | 明细与公式见 xlsx 的「成本总览」表 |

- 39.4% 的支出在电机与谐波减速器（1579.34），32.6% 在 CNC 结构件（1508.00）；这直接印证了[路线图](Dummy_V2复刻路线图.md)里“关节和结构件才是大头”的判断。
- 本体小计含备件余量（F405 多 1 颗、SN65HVD232 多 3 颗、PCB 20 片只用 7 片、紧固件 1120 颗只需约 100 颗），估算约 250–300 元，按装机口径本体约 3650 元。
- 仍缺、未计入：3D 打印 19 件清单里的 7 件（基座底板、外壳 A×2、外壳 C、控制器外壳、控制器内衬、控制器屏幕底板），以及 Dummy-0036 轴用垫片 5×8×1.2 共 6 件。补齐约 25–45 元。

## 六、机械、打印与整机物料

- 机械版本已锁定为“Dummy V2 版本 视频款”，不能与木子版混装。
- [3D打印与CNC清单](3D打印与CNC清单.md) 已按整机装配体核对：
  - CNC：13 件（含需从装配体导出的 0013、0016、0027、0037）。
  - 3D 打印：19 件。
  - 标准轴用垫片 5×8×1.2：6 件。
- 历史会话记录了 3D 打印费用 58.99 元、全套 CNC 估价约 1350 元；2026-11-04 已在闲鱼「手搓宅_（鱼小铺）」实际下单全套 CNC（含底座）1393 元，另单买小尺寸底板 115 元，均待发货，到货后需逐件对图清点，不能把估价当成已完成采购。
- 尚无单电机闭环、减速器装配、关节标定和六轴整机联调的完成记录。

## 七、接下来最短路径

1. 下单/到货 L2、SN65HVD232DR、VCAP 电容，并确认 STM32F103CBT6 实物库存。
2. 按第三节顺序修 REF，先恢复稳定电源和 VCAP，再恢复 CAN、USB、OLED。
3. 修 42-3：U5 与 STM32F103 一起换，完成断电测试、9 V 缓升、24 V 复测和 SWD 烧录。
4. 给 42-1、42-2 重烧 CAN 修复版固件。
5. 选一块正常电机板完成“电机 + 编码器 + 串口/USB-CAN”的单电机闭环，再进入两板 CAN 和 REF 联调。
6. 补齐打印/CNC/减速器/线束的实际到货与质检记录。

## 八、记录边界

- “当前状态”更新本文件。
- “当天做了什么、为什么改变判断”更新 [每日工作概览](每日工作概览.md)。
- 板级测量、波形、测点、维修证据更新 [七块板测试记录](七块板测试记录.md)。
- 长期执行阶段更新 [Dummy_V2复刻路线图](Dummy_V2复刻路线图.md)。
- 全仓库资料定位使用根目录 [PROJECT_INDEX.md](../PROJECT_INDEX.md)。
