MARS-ROBOTICS-star/Dummy-Robot-Reproduction/notes/七块板测试记录.md

# 七块板测试记录

> 测试方法见 [七块板万用表与上电测试指南.md](七块板万用表与上电测试指南.md)。
> 板号：**42-1 / 42-2 / 42-3**、**35-1 / 35-2 / 35-3**、**REF**（实物已贴标签）。
> 同型号板放在一起对比；有异常的板子单独记一节，写清楚排查过程。

---

## 一、总览

| 板号 | 断电测试 | 上电测试 | ST-Link | 固件 LED | 状态 |
|---|---|---|---|---|---|
| 42-1 | T2 对地 9.7 kΩ | ✅ 9 V 全套电压正常（2026-11-01） | ✅ 已烧录 | | 进行中 |
| 42-2 | T2 对地 13.4 kΩ（比另两块高，上电后证明无影响） | ✅ 上电测试通过（2026-11-01） | ✅ 0x410 / 128 KB，已烧录 | ✅ 与预期一致 | 进行中 |
| 42-3 | T2 对地 9.7 kΩ（上电前） | ⚠️ U5（CAN）被测试插线上的 24 V 打坏，已拆；9 V 下 T2 = 3.3 V（见二·六） | ❌ 连不上，STM32 已坏 | | 🔧 等新 U5 + STM32 |
| 35-1 | T2 对地二极管档 0.3x V | ✅ 上电测试通过（9 V 电流 0.009 A，2026-11-01） | ✅ 已烧录 | ✅（补焊 LED2 后） | 进行中 |
| 35-2 | 3.3 V 对地短路（STM32 引脚连锡）→ 已修好 | ✅ 上电测试通过（换 D4 后，2026-11-02，见第三节） | ✅ 已烧录 | ✅ | 进行中 |
| 35-3 | T2 对地二极管档 0.3x V | ✅ 上电测试通过（2026-11-01） | ✅ 已烧录 | ✅ | 进行中 |
| REF | ✅ 2026-11-02 通过；⚠️ 2026-11-03 出现新的 3V3 / VCAP 异常 | ⚠️ U3、C20 已换，旧 L2 回装后 C10 可恢复 3.3 V；U12 发热，VCAP 实测 1.71 V（见四·三） | ✅ 之前已烧录 | ✅ 之前 USB 识别为 COM10；当前暂停功能测试 | 🔧 先换 L2，并继续确认 U12 / VCAP 故障；禁止长时间上电 |

**当前进度（2026-11-02）**：7 块板断电、上电测试全部完成。35 与 REF 固件已在 Linux 上编译通过（见一·四）。同时改掉了电机固件 CAN 发送失败即死锁的缺陷（见一·四b），42 固件因此重新编译 —— **42-1、42-2 上烧的是修复前的版本，需要重烧**。42-3 的 STM32 和 U5 都被 24 V 事故打坏，等备件一起换。35-1~35-3、REF 已烧录。REF：J1 已换，U11 坏（第 4 脚临时翘起），USB 已识别为 COM10，见四·二。下一步：重烧 42-1 / 42-2；REF 重烧注释掉 `dummy.Init()` 的新固件，看 OLED。

**REF 补充进度（2026-11-03）**：REF 后续出现 3.3 V 启动掉压。现已更换 U3（SY8089）和 C20，旧 L2 暂时回装；C10 能恢复 3.3 V，但 U12 发热，保持复位时 C34 / C35（VCAP）仍为 1.71 V，超出正常范围。当前暂停 REF 的固件、USB、OLED 测试，先处理 L2 和 U12 / VCAP，详见四·三。

### 待采购（补货清单）
| 物料 | 用途 | 原因 |
|---|---|---|
| SN65HVD232DR（丝印 VP232） | 42-3 的 U5 + **REF 的 U11** + 备件（至少 3 颗） | 42-3 烧了一颗；REF 的 U11 接收输出卡低（四·二），无备件 |
| STM32F103CBT6（U3） | 42-3 换芯片 | 42-3 的 STM32 被打坏。先确认重新购买的 6 颗是否已到货 |
| LP2992AIM5X-3.3（丝印 LFEA/LFEB） | 备件 | 无备件 |
| 1N5819WS（SOD-323） | 备件 | 35-2 用掉最后一颗 |
| **ZH1.5 3P 线**（双头或单头） | REF P3 ↔ LedRing、调试 | 当初买的 8 根全是 6P，没有 3P |
| **L2：2.2 µH、2520、Isat ≥ 2.8 A、DCR ≤ 0.1 Ω、高度 ≤ 1.2 mm** | REF 3.3 V 降压级 | 原 TDK `TFM252012ALTA2R2MTAA`（立创 C5380714）只买 1 颗、无备件；淘宝可选 `APH252012C2R2MP01`（DCR ≤ 65 mΩ、Irms 2.7 A、Isat 3.3 A） |
| STM32F405RGT6（U12） | REF 可能更换 | 先拆下旧 U12 后测空焊盘 31 / 47 到 3V3；仅在确认短接随芯片消失或 VCAP 仍异常后更换 |
| 2.2 µF X5R / X7R、≥ 6.3 V、0402（C34 / C35） | REF 的 VCAP 稳压电容 | STM32F405 官方要求每个 VCAP 使用 2.2 µF；当前 BOM 标为 10 µF，修复时一并按官方值处理 |

---

## 一·四、固件编译记录（Linux + arm-none-eabi，2026-11-02）

工具链：`arm-none-eabi-gcc 10.3.1`（Debian 包 `15:10.3-2021.07-4`）、`cmake 3.22.1`、`make 4.3`。本机 Linux 侧没装 openocd / st-flash / CubeProgrammer，烧录仍在 Windows 侧用 STM32CubeProgrammer。

构建类型统一 `Debug`（`-Og -g`），与 42 最早那次基线一致，这样三块板的体积可以横向比。

```bash
cd "<V2>/2.Firmware/dummy-35motor-fw"       # 或 dummy-ref-core-fw / dummy-42motor-fw
cmake -B ../build/motor35-baseline -DCMAKE_BUILD_TYPE=Debug
cmake --build ../build/motor35-baseline -j$(nproc)
```

路径含空格和中文，**引号必须加**。编译目录放在源码树外面（`../build/xxx`），因为 `CMakeLists.txt` 用 `file(GLOB_RECURSE "Core/*.*" ...)` 收源文件，在树里建 build 目录有被扫进源列表的风险。CMakeLists 里已写死 `set(CMAKE_C_COMPILER arm-none-eabi-gcc)`，不需要额外的 toolchain file。

### 为了能在 Linux 下编过，改了 6 处

| 固件 | 文件 | 改动 | 原因 |
|---|---|---|---|
| 35 | `UserApp/common_inc.h:8`、`UserApp/configurations.h:9` | `#include "stdint-gcc.h"` → `<stdint.h>` | `stdint-gcc.h` 是 GCC 私有头，当前 arm-none-eabi 的三个 include 搜索路径都不提供（全机只有 x86_64 宿主 GCC 带它）。42 侧 2026-09-06 已这样改过，35 保持上游原样所以编不过 |
| 35 | `Port/Platform/Utils/st_hardware.h:4` | `<stdint-gcc.h>` → `<stdint.h>` | 同上 |
| REF | `Bsp/imu/MPU6050.cpp:37`、`MPU6050_6Axis_MotionApps20.h:42`、`MPU6050_9Axis_MotionApps41.h:42` | `"mpu6050.hpp"` → `"MPU6050.hpp"` | 实际文件名是大写。Windows 文件系统不区分大小写所以上游没暴露，Linux 区分 → 直接 fatal error。已扫全树确认只有这 3 处大小写不匹配 |

### 产物与容量（含一·四b 的 CAN 修复）

| 固件 | 产物目录 | FLASH | RAM | 其他 |
|---|---|---|---|---|
| 42 | `build/motor42-baseline/` | 74 540 B / 128 KB（56.9%） | 7 760 B / 20 KB（37.9%） | 到标定区还余 22.2 KB |
| 35 | `build/motor35-baseline/` | 74 548 B / 128 KB（56.9%） | 7 760 B / 20 KB（37.9%） | 同上 |
| REF | `build/ref-baseline/` | 255 580 B / 1 MB（24.4%） | 45 776 B / 128 KB（34.9%） | **CCMRAM 65 536 B / 64 KB = 100%** |

烧录用 `.hex`（CubeProgrammer 直接认）。`.elf` 给 gdb 用，`.map` 查某个符号占多少空间。

### 两条要记住的容量约束

1. **电机板 Flash 不能涨到 95 KB 以上**。链接脚本 `STM32F103CBTx_FLASH.ld` 把整片 128 KB 都给了代码，没为 `0x08017C00` 起的 32 KB 编码器标定区留保留段。代码越过 95 KB（偏移 97 280 B）会静默覆盖标定数据。现在 74.5 KB，余 22.2 KB。
2. **REF 的 CCMRAM 已经用满 100%**。`configTOTAL_HEAP_SIZE = 65536` 的 FreeRTOS 堆 `ucHeap` 恰好填满 64 KB CCMRAM。以后往 `.ccmram` 段再放任何东西都会直接链接失败，得先调小这个堆。这不是 bug，本来就是这么设计的，但没有余量。

### 一个无害的编译警告

35 固件会报 `Ctrl/Sensor/Encoder/mt6816_base.h:42: warning: no return statement in function returning non-void`。35 的基类 `SpiTransmitAndRead16Bits` 是空实现（42 改成了纯虚），看着像隐患，但 `Port/mt6816_stm32.h` 两个方法都带了 `override`，签名不匹配照样编译报错，所以不存在"静默调到空函数"的风险。可以忽略。

---

## 一·四b、电机固件 CAN 死锁修复（2026-11-02）

烧 35 板和 REF 之前先改掉的。42 和 35 两份固件一起改，改完 `Core/Src/can.c` 与 `Core/Inc/can.h` 仍然逐字节相同。

### 原问题

`Core/Src/can.c` 有两处一失败就调 `Error_Handler()`，而 `Core/Src/main.c:171-179` 的 `Error_Handler()` 实现是 `__disable_irq()` + `while(1){}` —— **关节板永久卡死，只能断电重启**。

触发条件很日常：总线没接终端电阻、主控没上电、CAN 线序接错，都会让发送失败。配合 `AutoRetransmission = DISABLE` 更容易踩到。

### 改法

| 位置 | 原来 | 现在 |
|---|---|---|
| `CAN_Send()` | `HAL_CAN_AddTxMessage` 失败 → `Error_Handler()` | 先自旋等一个空发送邮箱（上限 `CAN_TX_SPIN_LIMIT = 2000` 次轮询），等不到就丢这一帧并 `canTxDropCount++` |
| `HAL_CAN_RxFifo0MsgPendingCallback()` | `HAL_CAN_GetRxMessage` 失败 → `Error_Handler()` | `canRxErrorCount++` 后直接 `return` |

接收那处要注意：原来**就算不死锁也不能往下走**，否则会把上一帧残留的 `RxHeader` / `RxData` 当成新帧处理，所以必须 `return` 而不是只去掉 `Error_Handler()`。

两个计数器是 `volatile uint32_t`，在 `can.h` 里 `extern` 出来了，可以用调试器看，也可以以后加条 CAN 命令读出来。

### 两个设计取舍

**为什么敢在中断里自旋**：`CAN_Send` 的全部 8 个调用点都在 `UserApp/protocols/interface_can.cpp`，由 CAN RX 中断（抢占优先级 **3**）触发；20 kHz 电机控制环在 TIM4 中断（抢占优先级 **0**）里，优先级更高，所以这段自旋不会拖慢控制环。

**为什么不用 `HAL_GetTick()` 做超时**：SysTick 的优先级低于 CAN RX 中断，`uwTick` 在这个 ISR 里根本不会递增，拿它做超时会变成死循环。所以用的是轮询次数上限，不是精确超时。

### 没动的地方

`MX_CAN_Init()` 里 `HAL_CAN_Init` 和 `HAL_CAN_ConfigFilter` 失败仍然进 `Error_Handler()`（can.c:69、87）。那是开机配置失败，确定性的、也确实该停住，不是运行期风险。

### 代价与遗留

- Flash +104 B，RAM +8 B（两个计数器）。
- `AutoBusOff = DISABLE` 意味着一旦进 bus-off 要靠软件恢复，**现在没有恢复逻辑**。这是另一件事，留作后续。
- 42-1、42-2 上烧的是修复前的固件，**需要用新 hex 重烧**。

---

## 一·四c、REF 固件：没接电机板时 OLED 不亮（CAN 发送死等，2026-11-02）

起因：看到别人的复刻视频说「REF 的 `main.cpp` 要先连上电机板，OLED 才会亮，把那行注释掉就行」。对照源码确认**说法成立**，但机制不是「等电机板连上」，而是 **CAN 发送卡死**。

### 卡在哪

`UserApp/main.cpp` 的 `Main()` 按顺序执行：`InitCommunication()` → **`dummy.Init()`** → 死等 MPU6050 → `oled.Init()`。卡在第二步：

1. `dummy.Init()` → `SetCommandMode(COMMAND_TARGET_POINT_INTERRUPTABLE)` → `SetJointAcceleration()` → 对 J1–J6 各调一次 `SetAcceleration()`，**连发 6 帧 CAN**。
2. `Bsp/communication/interface_can.cpp` 的 `CanSendMessage()` 每发一帧，先要 `osSemaphoreAcquire(sem_can1_tx, osWaitForever)`。这个信号量计数为 1，**只在发送成功回调 `tx_complete_callback()` 里释放**。
3. 总线上没有别的节点，就没人回 ACK。`AutoRetransmission = DISABLE`，帧发一次失败就结束（TERR）。HAL 只记错误码，**不调 TxMailboxCompleteCallback**；`tx_error()` 是空函数。
4. 第 1 帧拿走了信号量，信号量就再也还不回来。**第 2 帧永远等下去**，Main 任务挂起，OLED 永远不初始化。

这和 CubeProgrammer 暂停 3 次都停在 `prvIdleTask` 的现象一致（所有任务都在等）。**之前判断「Main 卡在等 MPU6050」是错的**：先卡住的是 `dummy.Init()`，MPU6050 的循环还在它后面。

这和一·四b 电机板的 CAN 死锁是同一类缺陷：发送失败没有出路。

### 改法（临时）

`UserApp/main.cpp` 第 163 行 `dummy.Init();` **已注释掉**，并加了注释说明原因（2026-11-02）。**还没重新编译、没烧录。**

- 不改固件也有办法：CAN 总线上接**任意一块通电的电机板**，有节点回 ACK 就不会卡。
- 代价：开机不会把关节加速度发给电机板。**接上机械臂前必须改回来**。根治应该给 `CanSendMessage()` 加超时，并在发送失败 / 中止时也释放信号量。
- 注释掉之后还有第二道关：`do { mpu6050.Init(); } while (!testConnection())`。U10（MPU6050）没焊好或 I2C 不通，OLED 照样不亮，下一步就去查 U10。
- 与 USB 不识别**无关**：USB 在 `Main()` 之前初始化，由单独的任务处理。USB 还是 J1 / D+ 的硬件问题。

---

## 一·五、烧录记录（顺序：42 → 35 → REF）

| 板 | 固件 | Device ID / Flash | 烧录结果 | 烧完 LED | 备注 |
|---|---|---|---|---|---|
| 42-1 | `build/motor42-baseline/Ctrl-Step-STM32-fw.hex` | | ✅ 之前已烧录成功（用户报告） | | ⚠️ 烧的是 CAN 死锁修复前的版本，需用新 hex 重烧 |
| 42-2 | 同上 | **0x410 / 128 KB**（STM32F103 Medium-density） | ✅ 下载并校验成功，已运行（2026-11-02） | ✅ LED1 常亮、LED2 偶尔灭一下 | ⚠️ 同 42-1，需重烧 |
| 42-3 | 同上 | ❌ 连不上：「无法获取内核 ID / 未找到 STM32 目标机」（同一根线、同一设置在 42-2 上能连） | | | U5 未焊。已查：通电 T2 / NRST / BOOT0 正常；P3 ↔ U3 第 34、37 脚通；二极管档 34、37 脚 0.6 V（42-2 约 0.5 V）；按住复位连接无效。通电量 U3 各 VDD / VSS / VDDA / VSSA 脚都正常；整颗 U3 重新拖焊后仍连不上 → **判断 STM32 已被 24 V 事故打坏**（SWD 不依赖固件，和 U5 没焊无关）。计划等新 U5 到货时一起换 STM32 |
| 35-1 | `build/motor35-baseline/Ctrl-Step-STM32-fw.hex` | 应为 0x410 / 128 KB | ✅ 烧录成功（2026-11-02，用户说「烧完一块」，按顺序应为 35-1） | ✅ 修好（原 LED2 虚焊）。修前：LED1 常亮，**LED2 完全不亮**（应为大部分时间亮、每 1.2 s 灭一下）。42-2 的 LED 与预期一致。通电 R18 两端都是 3.3 V（LED2 没电流）；断电二极管档 LED2 右红左黑 2.207 V（正向，右边是阳极）、左红右黑 1.579 V。断电能导通、通电没电流 → 判断 LED2 一端虚焊（表笔压上去才通），待补焊。**补焊 LED2 两端后正常**（2026-11-02） | 已编译（2026-11-02，见一·四）。与 42 固件只差 `dce_kp` 195 / 200 |
| 35-2 | 同上 | 应为 0x410 / 128 KB | ✅ 烧录成功（2026-11-02） | ✅ 正常 | |
| 35-3 | 同上 | 应为 0x410 / 128 KB | ✅ 烧录成功（2026-11-02） | ✅ 正常 | |
| REF | `build/ref-baseline/Core-STM32F4-fw.hex` | 应为 0x413 / 1 MB | ✅ 烧录成功（2026-11-02） | ⚠️ OLED 不亮，待查（USB 是否枚举、OLED 是否已装、U10 MPU6050）。第一次插 Type-C：电脑上**既没有 STM32 的 USB 串口，也没有 CP210x**，连「未知设备」都没有（2026-11-02，PowerShell 查 PnP 设备确认）。两面都试过仍然没有；STM32 摸着微热（像是在 168 MHz 正常运行）。CP2102 只靠 VBUS 就能工作，它也不出现 → 先查线和 J1：插线时量 R1 左焊盘（VBUS）应 ≈ 5 V。用的是**两头 Type-C 的线**：电脑必须检测到 CC 脚上的 R8 / R9（5.1 kΩ 下拉）才会给 5 V，所以 R8、R9、J1 的 CC 脚是重点。OLED 已装（照片确认 13 脚排线已焊）。**换 A 转 C 线后出现「Unknown USB Device (Device Descriptor Request Failed)」**（VID_0000 / PID_0002）→ ① 5 V 能进来了，C 转 C 线不行说明 **CC 检测（R8 / R9 / J1 的 CC 脚）有问题**；② 电脑检测到有设备插入，但读不出设备信息，多半是 D+ / D− 这对线接触不良。待确认是哪一面、另一面怎样。之后直插电脑、A 转 C 线**两面都试：什么都不出现**（连未知设备也没有） → 时有时无，判断 **J1（Type-C 座）焊点接触不良**。下一步：断电，用 A 转 C 线插着 REF，从 USB-A 插头的 4 个触点量到板上（VBUS→R1 左焊盘、GND、D+→U12 第 45 脚、D−→U12 第 44 脚）。**结果：全都响**（2026-11-02），J1 的 VBUS、GND 和 STM32 这一面的 D+ / D− 断电都通。固件里 USB 的 VBUS 检测是关的（`vbus_sensing_enable = DISABLE`），不需要 VBUS 脚。所以 STM32 这一面连「未知设备」都不出现，更像是**固件没走到 USB 初始化**（比如开机时钟配置失败进了 `Error_Handler`）。下一步：CubeProgrammer 用 Hot plug 连上，在 CPU 页暂停，读 PC / LR。地址对照：`Error_Handler` = 0x08012FA8，`HardFault_Handler` = 0x0801336E，`SystemClock_Config` 从 0x08012FAC 开始，`Main` 从 0x0801FAE8 开始（来自 `build/ref-baseline/Core-STM32F4-fw.map`）。**Hot plug 暂停 3 次**：PC = 0x0801B852 / 0x0801B804 / 0x0801B84E，LR = 0x0801B853，都在 FreeRTOS 的 `prvIdleTask` 里，SP = PSP，寄存器是 0xA5A5A5A5（任务栈填充值）→ **固件和 FreeRTOS 在正常运行，没卡在 Error_Handler**，所有任务都在等待（当时以为 Main 在等 MPU6050；**更正**：实际先卡在 `dummy.Init()` 的 CAN 发送上，见一·四c）。USB 初始化已经执行过，电脑却看不到 → 怀疑 **USB 时钟不是 48 MHz**：最可能是 **Y1 装成了电机板用的 12 MHz 晶振**（应为 8 MHz，两种都买了、同一个 3225 封装）。12 MHz 时 CPU 跑到 252 MHz（发热）、USB 时钟 72 MHz、I2C 也变快，USB、IMU、OLED 都会出问题。待查 Y1 丝印；或者读 `xTickCount`（0x20002DF0）两次，看每秒涨 1000 还是 1500。**Y1 丝印：YJX 8.000M，没装错**，晶振假设排除。下一步：通电、不插 USB 线，量 U12 第 45 脚（D+）应 ≈ 3.3 V（STM32 内部 1.5 kΩ 上拉，固件打开 USB 后才有）、第 44 脚（D−）≈ 0 V；再把线直插笔记本本机 USB-A 口（不经集线器 / 扩展坞）。**实测：D+（第 45 脚）= 2.0 V，D−（第 44 脚）= 0.21 V**。上拉已经打开（说明固件 USB 正常启动），但 D+ 被拉低到 2 V，正常应 ≈ 3.3 V → D+ 上有一条约几 kΩ 的对地通路。J1 上 D+（A6）紧挨着 CC1（A5），CC1 经 R9（5.1 kΩ）接地：**怀疑 J1 的 A5–A6 连锡**。这一处也能解释 C 转 C 线不行（CC1 被 D+ 干扰）。待测：断电量第 45 脚对地电阻（正常应很大，连锡时约 5 kΩ），以及第 45 脚 ↔ R9 右焊盘（CC1 端）是否相通。**实测：断电第 45 脚（D+）对地 ≈ 5 kΩ**（正常应很大）→ D+ 确实挂上了一颗 5.1 kΩ（R9 或 R8）。R9 右焊盘 = CC1 端，R8 左焊盘 = CC2 端，都在正面。**USB-A 插头 D+ 触点 ↔ R9 右焊盘：响** → **确认 J1 的 A5（CC1）和 A6（D+）连锡**。待修：吸锡带清 J1 的 A5 / A6，修完 D+ 对地应恢复为很大、通电 D+ ≈ 3.3 V。**热风枪吹了好几遍、看不到连锡，D+ ↔ CC1 仍然相通、对地仍 5 kΩ** → 短路可能藏在 J1 外壳底下，或是 J1 本身 / PCB 走线的问题。**变通办法：先拆掉 R9**（CC1 的 5.1 kΩ 下拉）：D+ 就不再被拉到地，用 A 转 C 线时 STM32 的 USB 应能正常识别；代价是 C 转 C 线有一个方向不能用。根治要换 J1，或拆 J1 确认短路在器件还是在 PCB。**已拆 R9**（2026-11-02）：断电 D+ 对地 **≈ 140 kΩ**（原 5 kΩ），通电 D+ **2.67 V**（原 2.0 V，仍低于 3.3 V，但已高过主机判定「全速设备插入」的约 2 V 门槛）。插 A 转 C 线试（直插本机口，两面都试）：**只弹出过一次「未知 USB 设备」，碰一下就没了，其余时候什么都没有** → 接触时好时坏，J1 本身或它底下的焊接有问题。J1 是 GT-USB-7055E（立贴 Type-C，焊盘在外壳底下），采购 5 个用了 1 个，**还剩 4 个**。下一步：拆下 J1，**先在空焊盘上量 D+ ↔ CC1（R9 焊盘）**：还通 → PCB 本身有问题；不通 → 是焊锡或器件问题，清焊盘、少上锡重新焊新 J1，确认 D+ 和 CC1 不通后再装回 R9。**后续结果见四·二：J1 已换好；USB 还是不出来的真正原因是 U11 坏 → CAN1 初始化卡死，翘起 U11 第 4 脚后识别为 COM10** | 已编译（2026-11-02，见一·四）。固件启动顺序：USB 初始化 → `Main()` → `dummy.Init()`（没接电机板时 CAN 发送死等，见一·四c；已临时注释掉，待重编译）→ 死等 MPU6050 → 才初始化 OLED。所以 **USB 能认 = 固件在跑；USB 认、OLED 不亮 = 卡在 CAN 发送或等 IMU** |

### 电机板烧完固件后 LED 应该是什么样（按源码推出，2026-11-02）

- 硬件：LED 阳极经 1 kΩ（R11 / R18）接 STM32 的 PC13（LED1）/ PC14（LED2），阴极接地 → **引脚输出高电平时灯亮**
- 固件：`Port/led_stm32.cpp` 里「点亮」写的是 `GPIO_PIN_RESET`（低电平）→ **固件的亮 / 灭和实物正好相反**（42、35 两份固件相同）
- 刚烧完、没校准时，`mt6816_base.cpp` 发现标定区全是 0xFFFF → 状态 `STATE_NO_CALIB`：
  - LED1：固件让它「灭」→ 实物**常亮**
  - LED2：固件让它每 1.2 s「闪 1 下」（亮 0.1 s）→ 实物**大部分时间亮，每 1.2 s 灭 0.1 s**
- 所以「一个常亮、一个闪」里，闪的那个看起来是「亮着，偶尔眨一下」。LED2 **完全不亮**就不对

---

## 二、断电对地电阻对比

测法：电阻档，**红表笔接测点，黑表笔接 C11 负极**（功率地 PGND，经 R20 接信号地）。

| 测点 | 42-1 | 42-2 | 42-3 |
|---|---|---|---|
| T2（3.3V） | 9.7 kΩ | **13.4 kΩ** | 9.7 kΩ |

35 板（蜂鸣档 / 二极管档，表笔接 T2 和背面左侧 6P 座（P2）的地脚）：

| 测点 | 35-1 | 35-2 | 35-3 |
|---|---|---|---|
| T2（3.3V）↔ 地 | 0.3x V，不响 | **长响** | 0.3x V，不响（换到相邻插脚后才测到，见第三节） |

---

## 二·五、42 板上电测试（按指南第三节，顺序 42-1 → 42-3 → 42-2）

| 项目 | 应该是 | 42-1 | 42-2 | 42-3 |
|---|---|---|---|---|
| T1 开始出现电压时的输入 | 4~6 V | | | |
| 9 V：VCC（C11 正极） | 输入 − 0.3~0.45 V | ✅ | | |
| 9 V：T1（5 V） | 5.1~5.3 V | ✅ | | |
| 9 V：T2（3.3 V） | 3.25~3.35 V | ✅ | | **❌ 3.79 V** |
| 9 V：BOOT0（R9 右端 = U3 第 44 脚） | 0 V | ✅ | | |
| 9 V：NRST（C9 上端） | ≈ 3.3 V | ✅ | | |
| 9 V：C26 上端 | ≈ 0.78 V | ✅ | | |
| 9 V：CANH / CANL（U5 第 7 / 6 脚） | ≈ 2 V，两者相等 | | | |
| 9 V：电流 | 0.01~0.03 A | ✅ 0.02 A | | 0.006 A（无 U5） |
| 24 V：T1 / T2 | 同 9 V | | | T2 先 3.79 V，复测 T1 = 5.27 V、**T2 ≈ 0 V** |
| 24 V：电流 | 比 9 V 时小 | | | |
| 3 分钟手摸 | 不烫 | | | **❌ R13/R14/C16 一带烫** |
| ST-Link：Device ID / Flash | 0x410 / 128 KB | | | |
| 烧录后 LED | 一个常亮、一个闪 | | | |

> 42-2（2026-11-01）：用户报告断电、上电测量「一切正常，上电测试通过」，没有逐项报数。
>
> 42-1（2026-11-01）：9 V 下 7 项读数「和标准基本一样」，用户报告上电直接通过，具体数值没有逐项记。CANH/CANL、24 V、手摸、ST-Link 还没报。

---

## 二·五b、35 板上电测试（35-1、35-3；35-2 见第三节）

测点图：[Motor35上电测点图.png](Motor35上电测点图.png)。35 板没有 T1、没有 24 V 采样（C26）。

| 项目 | 应该是 | 35-1 | 35-3 |
|---|---|---|---|
| 5 V 开始出现时的输入 | 4~6 V | | |
| 9 V：VCC（C11 正极） | 输入 − 0.3~0.45 V | ✅ | |
| 9 V：5 V（C19 上端） | 5.1~5.3 V | ✅ | |
| 9 V：3.3 V（正面 C10 左端 / 背面 T2） | 3.25~3.35 V | ✅ | |
| 9 V：BOOT0（R9 上端） | 0 V | ✅ | |
| 9 V：NRST（C9 上端） | ≈ 3.3 V | ✅ | |
| 9 V：CANH / CANL（背面 U5 第 7 / 6 脚） | ≈ 2 V，两者相等 | | |
| 9 V：电流 | 0.01~0.03 A | 0.009 A（略低，正常） | |
| 24 V：5 V / 3.3 V | 同 9 V | | |
| 24 V：电流 | 比 9 V 时小 | | |
| 3 分钟手摸 | 不烫 | | |

---

## 二·六、42-3 维修记录：CAN 芯片 U5 和 STM32 被打坏（2026-11-01 ~ 11-02）

**结果**：电源部分已修复（拆掉坏的 U5，原 U7 焊回继续用），9 V 下 T2 = 3.3 V，电流 0.006 A。但烧录时发现 **STM32 也坏了**（见第 8 条）。**等新的 U5 和 STM32 到货一起换**。

### 1. 现象
| 时间 | 情况 |
|---|---|
| 上电前 | T2 对地 9.7 kΩ，和 42-1 一样，断电测试正常 |
| 9 V 上电 | T2 = **3.79 V**（应为 3.25~3.35 V） |
| 升到 24 V | T2 仍是 3.79 V；R13 / C16 / R14 那一片发烫 |
| 复测 | T1（5 V）= 5.27 V 正常，**T2 掉到接近 0 V** |
| 断电 | T2 对地 **0 Ω**（42-1 同一点 9.68 kΩ） |

供电方式：用 P1 测试插线供电，**插线上 CAN 两根线头没处理好**。

### 2. 用到的测试方法
- **同型号板对比**：拿 42-1 量同一个点
- **拆件隔离**：拆掉嫌疑元件，再量还短不短
- **灌电流找发热**：稳压电源 1.0 V、限流 0.5~2 A，从 T2 往 3.3 V 灌电，摸哪颗芯片发热
- **压降法**：灌电时万用表 2 V 档、黑笔接 C11 负极，逐个量 3.3 V 网络上 16 个点（[Motor42-3V3短路测点图.png](Motor42-3V3短路测点图.png)），电流流向短路点，**读数最低、或者比别处低的点**就是短路方向

### 3. 排查过程
| 步骤 | 做了什么 | 结果 | 当时的判断 |
|---|---|---|---|
| 1 | 断电量 T2 对地 | 0 Ω；上电前是 9.7 kΩ | 上电后有元件坏了，不是焊接连锡 |
| 2 | 拆 U7（LP2992） | 还是 0 | 短路不在 U7 |
| 3 | 1 V / 0.5 A 灌电，手摸 | 摸不出发热；电源电压显示 0 | 短路电阻极小，0.5 A 下发热太少 |
| 4 | 压降法 1 A，量 16 点 | C22 = 0，U5 第 3 脚 = 0.15 V，其余 0.207 V | ❌ 以为短在 C22 |
| 5 | 复核 C22 两个焊盘 | 重测：C22 的 3.3 V 端 = 0.207 V，GND 端 = 0 | **C22 没问题，第 4 步是表笔点到了 GND 那一端** |
| 6 | 重新看第 4 步 | 只有 U5 第 3 脚比别处低 57 mV（旁边 C36 是 0.207 V） | 电流在流向 U5 → **U5 击穿** |
| 7 | 限流加到 1.5~2 A 灌电 | **U5 发烫** | ✅ 确认 U5 |
| 8 | 拆 U5，旧 U7 焊回 | T2 对地 5.7 kΩ；9 V 下 T2 = 3.3 V；电流 0.006 A（42-1 带 U5 是 0.02 A） | 电源修好，U7 是好的，没有漏电 |

### 4. 最终解决办法
拆掉击穿的 **U5（SN65HVD232）**，原来的 U7 焊回继续使用。U5 暂时空着，等新芯片。

### 5. 原因分析
1. P1 第 2 脚是 +24V，第 3 脚是 CAN_L，两个脚紧挨着。测试插线的 CAN 线头没处理，**碰到了 +24V（当时 9 V / 24 V）**。用户说是 CAN 两根线碰在了一起；但 CAN_H 和 CAN_L 互碰不会烧芯片（SN65HVD232 能扛总线短路），所以一定还碰到了 +24V
2. 高电压从 CAN_L 进入 U5，再从芯片内部**倒灌进 3.3 V**。U7 是 LDO，只能往外送电流，不能往回吸，所以 T2 被顶到 3.79 V
3. 随后 U5 内部击穿，3.3 V 对地短路，T2 掉到 0；U7 带着短路发热（它自带限流和过热保护，所以没坏）
4. 那片「发烫」其实是 U7 在扛短路，R13 / R14 / C16 正常时只有 0.4 mA 电流，不会发热

### 6. 走过的弯路
- 第 4 步把 C22 的 GND 端当成 3.3 V 端量，误判为 C22 短路。**0402 两个焊盘只隔 1 mm，压降法读到 0 时一定要两端都量一次**

### 7. 经验
- **测试插线必须先把 CAN 两根（第 3、4 脚）从插头里挑出来或剪掉**（已写进指南 3.1）
- 3.3 V 这一路比 LDO 的固定输出还高 → 优先怀疑有别的电源在**倒灌**，不一定是 LDO 坏了
- 金属性短路（电阻接近 0）用小电流摸不出热，要加大电流或者用压降法

### 8. 烧录时发现 STM32 也坏了（2026-11-02）
| 步骤 | 做了什么 | 结果 |
|---|---|---|
| 1 | ST-Link 连接 42-3 | ❌「无法获取内核 ID / 未找到 STM32 目标机」。**同一根线、同一设置在 42-2 上能连**（0x410 / 128 KB，已烧录成功） |
| 2 | 连接时量 T2、C9（NRST）、R9（BOOT0） | 3.3 V / 3.3 V / 0 V，正常 |
| 3 | 断电蜂鸣 P3 第 2、3、1 脚 ↔ U3 第 37、34 脚、C11 负极 | 都通 |
| 4 | 二极管档 U3 第 34、37 脚（红笔接地） | 42-3 约 0.6 V，42-2 约 0.5 V，差别不大，SWD 脚没有明显击穿 |
| 5 | 频率 480 kHz + Under reset，镊子短接 C9 按住复位再连接 | 无效 |
| 6 | 通电量 U3 第 1、24、36、48 脚（VDD）、第 9 脚（VDDA）、第 23、35、47 脚（VSS）、第 8 脚（VSSA） | 全部正常 |
| 7 | 整颗 U3 加助焊剂重新拖焊 | 仍连不上 |

**结论**：**STM32（U3）内核已损坏**，也是同一次 24 V 事故造成的：高电压从 CAN_L 打坏 U5 后，很可能经 U5 和 STM32 之间的两根线（U3 第 32、33 脚）进入 STM32，同时 3.3 V 被顶到 3.79 V。电源部分没坏，所以当时电压、电流都量不出问题。
和 U5 没焊**无关**：SWD 是芯片自带的硬件功能，不依赖固件，空白芯片只要供电正常就能连上；U5 接的是第 32、33 脚，SWD 是第 34、37 脚。

### 9. 遗留待办
- [ ] **更换 STM32F103CBT6（U3）**。采购表有一笔重新购买的 6 颗（订单号 5127384963452120323），到货后先在别的板上读 Flash 确认是 128 KB
- [ ] 买 SN65HVD232DR（丝印 VP232），焊上 U5（采购表已无备件）。**和 STM32 一起换**
- [ ] 焊好后先断电量 T2 对地，再缓升法上电
- [ ] 24 V 复测、3 分钟手摸 U3 和背面 U8
- [ ] ST-Link 读 Device ID / Flash（确认 STM32 没被 3.79 V 伤到）

---

## 三、35-2 维修记录：STM32 引脚连锡 + D4 不导通（2026-10-31 ~ 11-02）

**结果**：✅ **上电测试全部通过**（2026-11-02）。这块板前后有**两处独立的问题**。

### 1. 现象
| 时间 | 情况 |
|---|---|
| 2026-10-31 断电 | 蜂鸣档 T2 对地**长响**（35-1、35-3 是 0.3x V、不响） |
| 2026-11-01 复测 | 电阻档 T2 ↔ C11 负极 **0 Ω**（35-1 是 9.31 kΩ） |
| 修好短路后，11-02 上电 | 9 V 下 5 V（C19）、3.3 V、NRST、BOOT0、TEMP **全部为 0**，电流 0 |

### 2. 用到的测试方法
- **同型号板对比**：拿 35-1 量同一个点
- **压降法**：1 V / 1 A 从背面 T2 灌电，黑笔接 C11 负极，量 17 个 3.3 V 点（[Motor35-3V3短路测点图.png](Motor35-3V3短路测点图.png)）
- **PCB 文件分析**：解析 `Motor-35.PcbDoc` 的走线和铺铜，看哪些铜皮离得近（[Motor35-R4一带放大图.png](Motor35-R4一带放大图.png)）
- **分地隔离**：板上三种地用 0 Ω 电阻连接（AGND —R22— GND —R20— PGND），拆掉 R22 / R20，看 3.3 V 短在哪一种地上（[Motor35-地线隔离图.png](Motor35-地线隔离图.png)）
- **逐颗量「3.3 V–GND」元件两端电压**：+ 接 T2、− 接 P3 第 1 脚，1 V / 1 A 灌电，每颗去耦电容只量它自己的两端，**越靠近短路点电压越低**。这块板是 4 层板，3.3 V 和 GND 是两整层铜，这个方法最准
- **逐级测电压**：从电源入口往后量（D1 → C11 → D4 → U6 输入 → C19），看电在哪一级断掉
- **二极管档**测 D4 正反向

### 3. 第一个问题：3.3 V 对地短路
| 步骤 | 做了什么 | 结果 | 当时的判断 / 后来的结论 |
|---|---|---|---|
| 1 | 压降法 17 点 | R4 = 0，U8 第 2 脚 = 0.17 V，其余 0.23~0.27 V | 以为短在 R4（热敏电阻，夹在 U1 / U2 中间） |
| 2 | 量 R4 两端 | 上端 0.019 V，下端 0 | 我把 R4 上下端说反过，一度误判为「电流穿过 R4」。正确是：**上端 = TEMP，下端 = 3.3 V** |
| 3 | 拆旧 R4（没量，已丢）、换新 NTC | T2 对地还是 0 | 不是 R4 本身 |
| 4 | R4 空着量 | T2 = 0；TEMP 焊盘 3.26 kΩ（= R5，正常）；3.3 V 焊盘 0；新 R4 = 8.33 kΩ | R4、TEMP 线都正常 |
| 5 | 放大镜 + 拍照看 R4 和 U1 第 1 脚之间 | 没有连锡 | — |
| 6 | 分析 PCB 走线 | 给 R4 供电的 0.2 mm 细线离 C3 的 AGND 焊盘 0.12 mm、离 U1 第 1 脚（PGND）0.33 mm | 怀疑锡搭到了绿油下的走线上 |
| 7 | 拆 R22（AGND 分开） | 还是 0 | 不是 AGND / C3 |
| 8 | 再拆 R20（PGND 分开） | T2 ↔ PGND = **OL**；T2 ↔ 信号 GND = **0** | **3.3 V 短在信号 GND 上**，U1 第 1 脚、C3 排除 |
| 9 | 查 PCB 铺铜 | **4 层板**：中间一层整层 3.3 V、一层整层 GND | 短路可能在任何一颗 3.3 V–GND 元件下面 |
| 10 | 逐颗量两端电压（V） | **C10 0.025、C6 0.025**、C8 0.030、C36 0.033、U5 0.033、C7 0.036、C24 0.039、C25 0.039、C22 0.041、C21 0.043 | 最低点在 C10 / C6，越远越高 → STM32 第 1 脚那个角，挨着**第 47 脚（VSS）/ 第 48 脚（VDD）** |
| 11 | 没拆电容，把 STM32 引脚重新拖焊一遍 | T2 对地 **13.67 kΩ**，短路消失 | ✅ **STM32 引脚连锡** |
| 12 | 焊回 R22、R20、R4 | T2 对地 13 kΩ（35-1 是 9.31 kΩ，偏高不是故障，42-2 也是这样） | — |

### 4. 第二个问题：5 V 起不来（D4 不导通）
| 步骤 | 做了什么 | 结果 | 当时的判断 / 后来的结论 |
|---|---|---|---|
| 1 | 9 V 上电 | 5 V、3.3 V、NRST、BOOT0、TEMP 全 0 | 5 V 这一级（D4 → U6 ME3116 → L1）没工作。这块板以前从没上过电，这一级第一次通电 |
| 2 | 逐级量 | 电流 0；C11 正极 8.95 V；D4 有色环端 8.4 V；C19 0 | 以为电已到 U6 输入，U6 没启动 |
| 3 | 蜂鸣 R20 | 响 | R20 正常，U6 有地 |
| 4 | 量 R15 两端（U6 输入 / EN） | 0.42→0.35 V、0.37→0.33 V，越量越低 | 同一网络和 D4 端差 8 V → 以为 D4 虚焊 |
| 5 | 断电蜂鸣 D4 有色环端 ↔ R15 左、↔ C20 右 | 都响 | ❌ 当时据此排除了虚焊（**后来证明被骗了**，见下） |
| 6 | 断电量 5 V、VCC 对地，和 35-1 比 | 5 V 都是 11.72 kΩ，VCC 都是 OL | 没有短路 |
| 7 | 一次性记录（电源屏幕 + 各点） | 电源 9 V、0 A、C.C 不亮；C11 8.95 V；R15 左 1.92 V↓、右 1.60 V↓；C19 0 | 怀疑电在 D4 过不去 |
| 8 | 断电二极管档量 D4 | 正向 0.1~0.3 V，反向 OL；方向也对 | ❌ 当时据此认为 D4 正常（**也被骗了**） |
| 9 | 放掉 C11 的电，重新逐级量 | D1、C11、D4 两端正常；C19 0、电流 0 | — |
| 10 | 量 R15 右、U6 第 5 / 4 脚 | 约 0.33 V | 和 D4 端读数矛盾 |
| 11 | 用户确认同一次通电 | **D4 有色环端 8.6 V，U6 第 5 脚、R15 约 0.4 V** | 电到了 D4 金属端，但没进到板子 |
| 12 | 对照 35-1 | D4 端 8.6 V，EN 3.87 V，C19 5.2 V | **EN 正常就是 3.9 V 左右**（不是我说的 8.6 V）；35-2 的 EN 只有 0.4 V |
| 13 | **换一颗新 D4** | ✅ **全部指标通过** | — |

### 5. 最终解决办法
1. **STM32 全部引脚重新拖焊**，清掉第 47 / 48 脚附近的连锡
2. **更换 D4**（1N5819WS，SOD-323）

### 6. 原因分析
- **短路**：STM32 第 47 脚（VSS）和第 48 脚（VDD）之间连锡。这两个脚相邻、间距 0.5 mm，是 LQFP 最容易连锡的地方之一
- **D4**（用户分析）：D4 有色环那一端**虚焊**（或 D4 本身不良）。量「D4 下端」时表笔把 D4 压到了焊盘上，所以通电读数正常（8.4 / 8.6 V），断电蜂鸣、二极管档也都通过；不压的时候电送不到 U6，U6 输入只有零点几伏，U6 不启动，电流为 0。换件后正常
- 压降法第 1 步把矛头指向 R4、读到 0 的原因**没有完全弄清楚**，最可能是表笔误差（和 42-3 的 C22 类似）。R4 本身是好的

### 7. 走过的弯路（含我的错误）
- R4 上下两端说反了，导致一次错误分析
- 说「D4 在 U6 左下方」是错的：**D4 在 U6 左上方**（大 TVS 二极管 D2 左边），U6 左下方的是 **D3**
- 说「R15 在 U6 正下方」是错的：**R15 在 U6 上方**（丝印在 P2 旁边）
- 说 EN 应该约 8.6 V 是错的：**ME3116 的 EN 正常约 3.9 V**（35-1 实测 3.87 V）
- 用蜂鸣档、二极管档判断 D4「正常」：肖特基二极管正向压降小，蜂鸣档也会响；而且**表笔一压，虚焊就暂时接通**，所以这两个断电测试都没测出问题
- 拆下的旧 R4 没有量就丢了，少了一个判断依据

### 8. 经验
- 4 层板上 3.3 V 对地短路，**逐颗量去耦电容两端电压**最准：不受黑表笔接哪里的影响
- 一时找不到短路的话，可以**拆 0 Ω 电阻把几种地分开**，先确定短在哪一种地上
- **虚焊「压上去才通」**：要量焊盘的铜皮或者下游的点，不要只量元件的金属端；也可以通电时一边看下游读数，一边用牙签按元件
- 怀疑供电不稳时，**先用镊子短接 C11 放电再量**：C11 对地是 OL，充上电后几分钟都不会掉，会骗人
- 上电时**一定看电源屏幕的电流**：电流 0 说明后级根本没在工作
- 拿好板（35-1）量同一个点，是纠正错误预期最快的办法
- 拆下来的元件**先量再扔**

### 9. 备件消耗
- 1N5819WS：用掉最后一颗备件（采购 15 颗，需要 14 颗）
- NTC（R4）：用了一颗新的，旧的已丢

---

## 四、REF 断电测试与上电测试（2026-11-02 通过）

测点图：[REF测点图.png](REF测点图.png)。REF 只有一块，没有对照板，按指南第四、五节的标准值判断。烧录（ST-Link、ESP32）统一放到后面做。

### 断电测试

| 项目 | 结果 |
|---|---|
| C6（220 µF/35V 电解，背面 P1 右上方） | **未焊**（2026-11-01），用烙铁焊；新电容单独测量显示 OL，属正常 |
| D4 左端 ↔ C15 左端（正面） | 蜂鸣档响（2026-11-01）。**正常**：两个焊盘都是 GND |
| 目检（含 R27 空、R29 已焊） | ✅ 2026-11-02 用户报告断电万用表测试全部通过（含 3V3↔5V 不通、STM32 相邻脚、CAN 引脚） |
| VCC_IN / VCC / 5V / 3V3 对地 | 2026-11-02：「C10」「C1 左端」量到 0、长响；AVCC（C33）约 6 kΩ。**作废**：REF测点图上 C10、C1 的圈画在了接地的那一端（已更正）。**重测：C10（3V3）、C1 右端（3V3A）、LED1 正极都是 33 kΩ，3.3 V 没有短路**。AVCC 约 6 kΩ 和 3V3 不一样，待查 R25（0 Ω，3V3↔AVCC）是否焊通 |
| 3V3 ↔ 5V 不通 | |
| 0 Ω：R2 / R25 / R26 / R31 / R29 | |
| 反馈电阻在板阻值：R11 / R14 / R33 / R35 | R33（标称 100 kΩ）在板测得 **36 kΩ**（2026-11-01）。在板电阻会被 R35 + 3V3 对地负载并联拉低，读数偏低不一定是错。待测 3V3 对地电阻、R35 读数来核算 |
| R8 / R9（CC）对地 | |
| STM32 相邻脚（18–19、63–64、12–13、31–32、47–48） | |
| P1 / P2 / P3 引脚确认 | |

### 上电测试
| 步骤 | 测点 | 应该是 | 结果 |
|---|---|---|---|
| A：5 V 轨灌 3.5 V / 限流 0.2 A | 电流 | 0.04~0.12 A（会跳） | |
| A | LED1 | 亮 | |
| A | C10（3V3） | 3.28~3.34 V | |
| A | C1（3V3A）、C33（AVCC） | 3.3 V | |
| A | C35、C34（VCAP） | ≈ 1.2 V | |
| A | C36（NRST）、C3 上端（ESP_EN） | ≈ 3.3 V | |
| A | 3 分钟手摸 U12、U2、U10、U3 | 不烫 | |
| B：P1 进电缓升，限流 0.2 A | C15（5 V）在 6~9 V 时 | 稳在 5.1~5.3 V | |
| B | 24 V：C6 正极 / C15 / C10 | VCC / 5.2 V / 3.3 V | |
| B | 24 V：U11 第 7 / 6 脚 | ≈ 2 V，两者相等 | |
| B | 24 V 电流 | ≈ 0.01~0.05 A | |
| C（可选）：Type-C 接电脑 | 设备管理器 | 出现 CP210x（不行就翻面插） | |

> 2026-11-02：用户报告「REF 板上电测试通过」，没有逐项报数。第 A 步用 P3 第 1、3 脚焊临时线灌 3.5 V（没有 3P 线）。

### 四·二、烧录后排障：USB 不识别、OLED 不亮（2026-11-02）

**最终结论**：两个独立的问题叠在一起。① **J1（Type-C 座）里 D+ 和 CC1 短路** → 已换 J1。② **U11（SN65HVD232）接收输出卡在低电平** → 开机时 CAN1 初始化超时进 `Error_Handler`，USB 根本没初始化。第 4 脚翘起后，STM32 的 USB 识别为 **USB 串行设备（COM10）**。

#### 1. 现象
- 烧录成功后 OLED 不亮；Type-C 插电脑，STM32 那一面什么都不出现，CP2102 那一面时有时无。

#### 2. 问题一：J1 内部 D+（A6）与 CC1（A5）短路
| 测量 | 结果 |
|---|---|
| 通电 D+（STM32 第 45 脚） | 2.0 V（正常 ≈ 3.3 V） |
| 断电 D+ 对地 | ≈ 5 kΩ（正常很大）；D+ ↔ R9 右焊盘（CC1）响 |
| 热风吹多遍、拆 R9 | 仍时好时坏，看不到连锡 |
| **换 J1**（加热台从底下加热 + 热风，新 J1 少锡） | D+ ↔ CC1 不响，D+ 对地 OL；CP2102 那一面稳定识别（缺 CP210x 驱动，显示黄色感叹号）；R9 已装回 |

J1 是立贴 Type-C（GT-USB-7055E），焊盘全在外壳底下，看不见也吹不透。四层板内电层吸热，底部加热比单用热风有效得多。**J1 两面分别接两颗芯片**：A6/A7 → STM32，B6/B7 → CP2102；A 转 C 线不看 CC，C 转 C 线的 STM32 那一面要靠 R9（CC1 下拉）。

#### 3. 插曲：电源限流 0.1 A 把电压卡在 4 V
24 V 开机后电压掉到 4 V 多、电流恒 0.1 A。原因：板上 5 V 是降压开关电源，输入电压越低吸的电流越大，限流太紧时会卡在低压状态出不来。**限流调到 0.3 A 后稳在 24 V、电流 0.01~0.05 A，板子没坏**。之前在 4 V 状态下量的 USB 读数作废。**REF 上电限流至少 0.3 A。**

#### 4. 问题二：U11 接收输出卡低 → CAN1 初始化失败 → USB 没启动
| 步骤 | 结果 | 说明 |
|---|---|---|
| 插着电脑量 D+ | ≈ 0 V | STM32 没开 USB 上拉 |
| Hot plug 暂停 3 次 | PC = 0x08012FAA，LR = 0x080128C9，PSP = 0 | 卡在 `Error_Handler`，由 **`MX_CAN1_Init`** 调用，FreeRTOS 还没启动 |
| 读寄存器 | RCC_CFGR = 0x0000940A（PLL 正常）；APB1ENR = 0x12600070（CAN1 时钟开，CAN2 未开）；AHB2ENR、USB GCCFG、DCTL 全 0 | 时钟没问题；停在 CAN1，USB 从未初始化 |
| U11 第 3 脚 VCC / 第 1 脚 D / CANH、CANL | 3.3 V / 3.3 V / 都 ≈ 2 V，压差 0 | 输入全部正常，总线是隐性 |
| U11 第 4 脚（R → PB8） | **0 V** | 隐性时应为 3.3 V |
| 断电第 4 脚对地 | 67 kΩ，二极管档 0.683 V；STM32 第 60–61、61–62 脚不响 | 没有对地短路、没有连锡 |
| **翘起 U11 第 4 脚** | **焊盘（PB8）3.3 V，U11 引脚 0 V** | **U11 坏，STM32 好** |
| 翘脚后插电脑 | **USB 串行设备（COM10）** ✅ | |

`HAL_CAN_Init` 要等 CAN1_RX 上出现 11 个隐性位才能退出睡眠，RX 一直低就超时 → `Error_Handler`。开机顺序是 CAN1 初始化 → … → FreeRTOS → USB 初始化，所以 CAN 一卡，USB 也一起消失。

原理图（`REF-Controller.SchDoc`）：CAN1_R 网络 = U12 第 61 脚（PB8）↔ U11 第 4 脚，中间无元件；CAN1_D = 第 62 脚（PB9）↔ U11 第 1 脚。

**U11 怎么坏的不确定**：修 J1 之前 Hot plug 看到 CPU 在空闲任务（CAN1 初始化当时是通过的），所以是之后坏的。J1 在板子最下方，离 U11 很远，用户判断不是加热台烤坏的；静电、表笔打滑都有可能。

#### 5. 走过的弯路（含我的错误）
- 一开始以为 OLED 不亮是「卡在等 MPU6050」，实际先卡在 `dummy.Init()` 的 CAN 发送（见一·四c）；这次又发现更早还卡在 CAN1 初始化。**看 PC / LR 比猜快得多**。
- 曾推算「D+ 上只有约 32 kΩ 弱上拉」并怀疑 45–46 脚连锡，其实那些读数是在电源被限流卡在 4 V 时量的，前提不成立。
- 曾断言 U11 是加热台烤坏的，没有依据，用户指出 J1 离得很远。
- 量第 61 脚曾读到 1.71 V，复测为 0 V，多半是表笔滑了。

#### 6. 现状与待办
- U11 第 4 脚**保持翘起**：CAN1 初始化能过、USB 能用，但 **CAN 总线不能收**。
- 板上仍是旧固件：`dummy.Init()` 会卡在 CAN 发送，OLED 仍不亮。**重烧一·四c 的新固件**后再看 OLED；还不亮就查 U10（MPU6050）。
- 装 CP210x 驱动（Silicon Labs 官网），CP2102 那一面才会显示成 COM 口。
- 新 SN65HVD232DR 到货：拆掉旧 U11、焊新的，第 4 脚正常焊好；隐性时第 4 脚应为 3.3 V。

### 四·三、3.3 V 启动掉压、U12 发热与 VCAP 异常（2026-11-03，处理中）

#### 1. 初始现象

- 从 P1 上电，9 V、限流 0.1~0.3 A 时电源进入 CC，输入被拉到约 4~5 V，3.3 V 负载点无正常电压；一次实测为输入掉到 5.21 V、C10 = 2.7 V、C15 = 3.51 V。
- 从 3V3 端低压注入：1 V 时除 C20 外的测点约 0.97~0.98 V；2 V 时约 1.96 V。C20 接近 0 V，后续确认该点存在局部连接异常。
- 拆下 L2 后，P1 上电恢复 CV，C15 = 5.21 V、C10 = 0 V；说明 5.2 V 前级能够空载工作，问题集中在 U3 / L2 / 3V3 负载一侧。
- L2 靠 U3 的 SW 焊盘测得约 2.52 V，表明 U3 空载时有开关动作，但不能证明带载能力正常。

#### 2. 已完成的处理

- 更换 **U3（SY8089A1AAC）**。
- 更换 **C20**。
- L2 没有备件，暂时把原 L2 回装。
- 回装后第一次以 9 V、0.3 A 上电：C10 恢复 3.3 V，C20 的 3V3 端也恢复 3.3 V，但 U12（STM32F405）开始明显发热。
- 后续一次冷启动再次进入 CC：电源电压掉到约 5 V，C10 = 2.87 V，C34 / C35 = 1.45 V。此时 VCAP 数值受整板掉压和反复启动影响，不作为最终值。

#### 3. NRST 隔离测试

用金属镊子短接 C36 两端，使 NRST 保持低电平：

| 状态 | 电源 | C10 | C34 / C35（VCAP） | 结论 |
|---|---|---|---|---|
| C36 保持短接 | **CC → CV** | **恢复 3.3 V** | **均为 1.71 V** | 复位可消除启动过流，但稳定 3V3 下 VCAP 仍明显异常 |
| 先保持复位启动，再松开镊子 | **仍保持 CV** | **仍保持 3.3 V** | 未复测 | 原先 CC 主要是冷启动瞬态 / 反复重启，不是持续性 3V3 硬短路；旧 L2 的瞬态能力仍是重点嫌疑 |

STM32F405 在 168 MHz / VOS=1 时，VCAP 正常范围应为 **1.20~1.32 V**。在 C10 已稳定 3.3 V、U12 仍保持复位时测到 1.71 V，不能用程序运行或 CPU 负载解释，必须继续查 VCAP 外围或 U12 内部稳压器。

#### 4. U12 / VCAP 当前排查结果

- 重新拖焊 U12 后，现象没有消失。
- 断电蜂鸣：C10（3V3）↔ C34、C35 非接地端均响；C10 ↔ U12 第 31、32、47、48 脚均响。
- 其中第 32、48 脚是 VDD，本来就应与 C10 相通；第 31、47 脚是 VCAP。**仅凭蜂鸣不能再断言外部连锡**，因为未上电时芯片内部稳压器也可能形成万用表可检测的通路。决定性异常仍是稳定上电时 VCAP = 1.71 V。
- 当前剩余可能：
  1. C34 / C35 接地端或电容本身异常，导致内部稳压器不稳定；
  2. U12 引脚根部 / 芯片下面存在看不到的焊桥；
  3. U12 内部 1.2 V 稳压器已经损坏。

#### 5. 下一步（按顺序）

1. **暂停长时间上电，也不要提高限流或升到 24 V。**
2. 更换 L2。原件：TDK `TFM252012ALTA2R2MTAA`，2.2 µH、2.5 × 2.0 × 1.2 mm、Isat 2.8 A、DCR 最大 84 mΩ；无库存。淘宝替代件可选 `APH252012C2R2MP01`（2.2 µH、2520、DCR 最大 65 mΩ、Irms 2.7 A、Isat 3.3 A）。
3. 断电确认 C34、C35 的接地端都可靠连接 P1 GND；修复时按 STM32F405 官方要求给 VCAP 使用 2.2 µF、X5R / X7R、≥ 6.3 V 的电容。
4. 若换 L2、确认 VCAP 电容和地以后，保持复位上电仍为 1.71 V，则拆下 U12；芯片拆除后测 PCB 空焊盘 31 / 47 ↔ C10：
   - 不再相通或异常消失：旧 U12 内部损坏，更换 STM32F405RGT6；
   - 仍相通：先清理 PCB 焊盘 / 隐藏焊桥，不能直接安装新 U12。
5. 修复后的首次上电继续使用 9 V、限流 0.2~0.3 A，并保持 C36 短接；合格标准：C10 = 3.3 V、C34 / C35 = 1.20~1.32 V、电源保持 CV、U12 不迅速发热。通过后再释放 NRST。

---

## 五、42-2：T2 对地电阻偏高（2026-10-31）

### 现象
T2（3.3V，U7 正下方的测试点）对 C11 负极 **13.4 kΩ**，另外两块 42 板都是 9.7 kΩ。偏高说明这一路上少了一部分对地负载，不是短路。

### 排查过程（全部断电，蜂鸣档 / 电阻档）

| 测哪里 | 结果 | 结论 |
|---|---|---|
| U3 STM32 第 1、24、36、48 脚（VDD）、第 9 脚（VDDA，经 R21）↔ T2 | 响 | 正常 |
| U3 第 23、47 脚（VSS）↔ C11 负极 | 响 | STM32 的地正常 |
| R20 两端（0 Ω，连接 PGND 和 GND） | ≈ 0 Ω | 正常 |
| U8 MT6816 第 8 脚（GND）↔ 地 | 响 | 正常 |
| U8 第 2 脚（HVPP）、第 4 脚（VDD）对地 | ≈ 13.x kΩ，和 T2 相同 | 正常，已接到 3.3V |
| U5 CAN 第 2 脚（GND）↔ 地 | 响 | 正常 |
| U5 第 3 脚（VCC）对地 | ≈ 13.x kΩ，和 T2 相同 | 正常，已接到 3.3V |

> 插曲：一开始按「P3 最上面那个脚是第 1 脚（GND）」去测，蜂鸣档显示 **0.567 V**。这是芯片保护二极管的压降，说明那个脚是信号线，不是地。**P3 的第 1 脚不在最上面**，以「和 C11 负极相通的两个脚」为准。

### 当前结论
3.3V 上每颗芯片的电源脚和地脚都确认焊通，**没有找到开路或短路**。13.4 kΩ 和 9.7 kΩ 的差别，剩下的可能是：
1. 芯片批次不同（STM32 / MT6816 / CAN / LP2992），用电阻档测时芯片内部是非线性的
2. 万用表自动量程不同，测试电压不一样
3. R4（NTC）或 R5（3.3 kΩ，丝印 332）用错了料

**判断：可以按缓升法上电。**

### 结论（2026-11-01）
**上电测试一切正常，13.4 kΩ 不影响使用**，属于芯片个体或万用表读数差异。下面的待办只剩 ST-Link 一项有意义。

### 待办
- [ ] 万用表手动固定 20 kΩ 档，三块 42 板重测 T2 对 C11 负极
- [ ] 二极管档（红笔 C11 负极、黑笔 T2），三块板对比
- [ ] 放大镜核对 R4、R5 是否和另外两块板一样
- [ ] 缓升法上电：T1 / T2 电压、9V 和 24V 下的电流，和 42-1、42-3 对比
- [ ] 3 分钟后手摸，看芯片是否发烫
- [ ] ST-Link：Device ID 是否 0x410，Flash 是否 128 KB

---

## 六、排障方法总结（从 42-3、35-2 学到的）

### 电源对地短路（断电电阻接近 0）
1. **先和好板比**：同一个点、同一种表笔接法
2. **想清楚是「上电前就短」还是「上电后才短」**：上电前就短，多半是连锡、锡珠；上电后才短，多半是元件被打坏
3. **压降法**：从短路的电源轨灌电流（电压 1.0 V，限流 1 A），逐点量电压，最低的地方就是短路方向。读到 0 时，**两个焊盘都量一遍**，防止点错端
4. **逐颗量两端电压**：每颗去耦电容只量它自己的两端。适合 4 层板（电源、地都是整层铜）
5. **分地隔离**：拆 0 Ω 电阻（R22：AGND↔GND，R20：GND↔PGND），确定短在哪种地上
6. **加大电流摸发热**：限流 1.5~2 A，金属性短路也能热起来；也可以滴酒精，看哪里先干
7. **拆件验证**：拆下嫌疑元件，再量还短不短。**拆下来的元件先量再扔**

### 有电压进来，但后级不工作（断路 / 虚焊）
1. **逐级量电压**：从入口往后（D1 → C11 → D4 → U6 → C19），哪一级开始掉下来，问题就在哪两级之间
2. **同一网络两个点电压差很大 → 中间断了**
3. **小心「压上去才通」的虚焊**：量焊盘铜皮或下游点，不要只量元件的金属端；通电时一边看下游读数，一边用牙签按元件
4. **先给大电容放电**：C11 对地是 OL，存着的电会让读数「看起来正常」
5. **看电源电流**：电流 0 = 后级根本没工作

### 上电操作
- 测试插线**拔掉 CAN 两根**（第 3、4 脚），只留 +24V、GND
- 缓升法：9 V、限流 0.1 A，红表笔先按在 5 V 测点上再升压
- 不确定的预期值，**拿好板实测一次**
