MARS-ROBOTICS-star/Dummy-Robot-Reproduction/source/1.Dummy V2任同学整理/Dummy_V2详细复刻方案_审计修订版.md

# Dummy V2 详细复刻与学习方案：审计修订版

版本：R1，2026-09-06。适用工程：`1.Dummy V2任同学整理/`。

**本方案替代《Dummy_V2复刻与学习方案_初稿》的执行安排。结论是：继续采用“单电机起步、分阶段集成”，但必须先补制造资料和安全固件，不能把现有文件集合当成已经配套验证过的复刻套件。**

本次完成的是文件审计与实施规划，不是已完成硬件复刻。文中的修复项、采购项和验收项，除明确标注“本次已核验”外，均为后续待执行工作。

配套文件：

- [审计结论与证据](6.Docs/复刻审计_2026-09-06/审计结论与证据.md)：已确认问题 A01～A14、证据路径、子代理误判纠正、审计边界。
- [实施记录模板](6.Docs/复刻审计_2026-09-06/实施记录模板.md)：版本、线束、首板上电、六轴参数、采购放行和实验日志模板。
- [全文件快照](6.Docs/复刻审计_2026-09-06/file_inventory.csv)：审计开始时 3,970 个文件的大小与 SHA-256。
- [子代理运行记录](6.Docs/复刻审计_2026-09-06/agent_runs.json)：五个 OpenCode 工作会话均使用 `opencode-go/deepseek-v4-pro`，主审进行了源码、图像与逻辑交叉核验。

## 1. 目标、背景与范围

### 1.1 沿用的用户背景

本版沿用初稿中的条件，不把它们当成本次重新确认过的新事实：机械专业，能建模和理解运动学；嵌入式、电路、焊接及调试经验少；Windows/Linux 可用；以理解原理为主，希望首月得到一个能解释、能复现的闭环电机成果；不先承担整臂材料和加工费用。

因此，成功不是“六轴最快转起来”，而是建立以下可迁移能力：

1. 能独立从源码构建、烧录、调试和恢复一块 STM32 板。
2. 能区分电源、焊接、时钟、通信、编码器、驱动和控制参数问题。
3. 能记录目标、反馈、有效性、误差、电流命令和实际温升。
4. 能解释关节角、电机转数、编码器原始角与内部计数之间的换算。
5. 能说明每个停止条件在断线、传感器坏帧、任务卡死时是否仍有效。
6. 最后才追求六轴一致性、末端精度和上位机体验。

### 1.2 保留与后置

| 项目 | 本版决定 | 原因 |
|---|---|---|
| 首个执行器 | 一块 Motor-42 + 一个匹配的两相四线 1.8° 电机 | 最小闭环单元，降低诊断复杂度 |
| 第一块正式电机板 | 优先可追溯的已知良好板或经过制造审核的委外 SMT 板 | 避免首板同时承担焊接和固件五类未知故障 |
| 自己焊板 | 保留为第二块板的分区复现任务 | 学焊接但不把首次全板手焊放在首月关键路径 |
| 首月通信 | UART，但先做安全解析/授权/遥测 | 不需要 REF，也不能直接裸用原始解析器 |
| CAN | 单轴闭环后进入；可提前做断开功率的协议测试 | 多节点前必须补长度、超时、ID 与错误处理 |
| 机械版本 | 视频 V2 为候选主线，内部改版尚未冻结 | “目录选定”不等于几何和加工版本已经确定 |
| REF | 单关节之后，先做仅含活动轴的试验程序 | 原工程依赖六轴到达掩码和若干外设 |
| ESP32/Wi-Fi | 后置且默认不接控制链路 | 构建文件损坏线索、网络控制面无鉴权 |
| DummyStudio | 有线整机验收后作为客户端使用 | 仅有成品，不能依赖它实现底层安全 |
| ROS/MoveIt/视觉/夹爪 | 不进入基础复刻里程碑 | 当前目录没有完整配套资料，需要独立立项 |

## 2. 相对初稿的关键修改

| 初稿的假设或不足 | 本版修改 | 依据 |
|---|---|---|
| Motor-42 现成 Gerber 可直接打裸板 | 暂停投板，先补 NC 钻孔并统一版本导出 | A01 |
| 机械主要只有 30/50 减速比冲突 | 同时冻结方向位、限位、几何长度；J6 图中 5 与代码 50 单列 | A02 |
| 线束只需知道同向/反向 | 两端观察方向、针脚、网络逐一核验；P3 防误插 | A03 |
| 原始 `c/v/p` 可直接作为首月试验入口 | 先修有界解析和显式授权，明确 A、转/秒、绝对转数单位 | A04 |
| 无磁/校验状态只是遥测项目 | 变成必须接入故障锁存的保护条件 | A05 |
| 断线后“行为符合预期” | 预先定义状态、时限、测量方法，新增节点本地超时 | A05、A08 |
| 增加遥测后直接编译烧录 | 先保护 Flash 校准/参数区域，再验证容量和执行时间 | A06 |
| `!STOP` 可以用作安全停止 | 它不是硬件急停，并存在零位移计算风险；独立整改 | A07 |
| 两块电机接 REF 就能做双轴 | 活动轴集合、反馈掩码、任务/外设裁剪、超时必须同步改 | A09 |
| 把编码器校准和整机 `!CALIBRATION` 相邻罗列 | 拆成不同目的、入口和风险的两套 SOP | A10 |
| CAN 写 ID 后可按 EEPROM 恢复 | 当前每次启动以三位拨码覆盖，逐板冷启动核验 | A10 |
| 上位机和 ESP32 只是“晚一点再用” | 先修协议边界、路径占位文件和网络鉴权，再接运动系统 | A11～A13 |
| 固定首月/整机预算区间 | 拆成可加总的阶段预算，不重复计入已购件；价格均非询价 | 第 16 节 |

本版不因原始源码有风险就要求先重写整个项目。只实现当前阶段必须的最小修复，且每个修复都要对应测试。

## 3. 总路线与放行门槛

```text
原始资料冻结 + 工具链
    -> 不带功率运动的硬件/编码器检查
    -> 安全固件 + 裸电机校准 + 单轴闭环
    -> 第二块板复现 + CAN
    -> 单个受约束关节
    -> F405/REF 双轴最小系统
    -> 六轴版本/参数/制造冻结
    -> 逐轴集成 + 零位 + FK/IK + 整机验收
    -> 有线上位机
    -> 可选网络与二次开发
```

| Gate | 成果 | 必需放行证据 | 未通过时不做什么 |
|---|---|---|---|
| G0 | 可重建的开发基线 | 工具版本、构建日志、存储区检查、GPIO/UART/Timer/SWD 实验 | 不烧录未经确认的来源不明 HEX |
| G1 | 可观测、无功率运动的单板 | 电源轨、静态电流、SWD、原始编码器、线束表 | 不校准、不切换电流/速度/位置模式 |
| G2 | 安全单电机闭环 | 安全修复回归、校准记录、小范围往返、故障与冷启动数据 | 不接减速器或悬臂负载 |
| G3 | 可恢复的双节点 CAN | ID/终端/协议、掉线、本地超时、错误帧、A/B 板对比 | 不批量复制六套板 |
| G4 | 一个受约束关节 | 实测传动比、零位、输出侧量测、温升、断电安全 | 不购全套减速器/CNC |
| G5 | 双轴主控集成 | 活动轴模型、外设降级、反馈超时、急停、调度数据 | 不用原始六轴 HOME/CALIBRATION |
| G6 | 六轴制造与参数冻结 | 版本化机械 BOM、单轴参数表、加工图、制造文件、供应确认 | 不发整套加工订单 |
| G7 | 六轴有线整机 | 单轴到整机记录、零位恢复、FK/IK、故障、温升和性能报告 | 不联网远控、不做无人看管运行 |

Gate 编号以本版为准。每个阶段允许重复和退回，不以日期到达自动放行。

## 4. 安全设计必须先于首次运动

### 4.1 三层停止机制

| 层级 | 目的 | 本方案要求 |
|---|---|---|
| 正常停止 | 控制良好时平滑结束任务 | 停止新目标、受控减速、保持/失能策略明确 |
| 故障停止 | 失联、编码器错误、越界、任务异常时限制危险 | 节点本地检测、主控联动、故障锁存、人工重新授权 |
| 物理功率切断 | 软件不响应时的最终干预 | 可立即触达、适用于直流负载的断电装置；在实际电压/电流下验证 |

三层不能互相替代。普通按钮加软件 `!STOP` 不是经过认证的安全急停。限流电源也不保证所有错误接线都不会烧板。

裸电机应固定在台面，磁铁有防飞出结构，周围无缠绕物。进入关节阶段前必须增加托架、限位或受控支撑，尤其 J2/J3 不得在重力负载悬空时用“直接 Sleep”作为唯一故障策略。断电后的机构行为也必须验收。

### 4.2 建议的最小状态机

下列是待开发的安全结构，不是原固件已有命令：

```text
BOOT_SAFE -> SENSOR_CHECK -> DISARMED -> ARMED -> RUNNING
                    |            |          |        |
                    +------------+----------+--------+-> FAULT_LATCHED

FAULT_LATCHED -> 排除故障 + 显式人工确认 -> DISARMED
```

- BOOT_SAFE：功率输出关闭；不因旧 EEPROM 或上次运动状态自动使能。
- SENSOR_CHECK：确认当前采样有效、磁铁正常、校准状态和参数范围可解释。
- DISARMED：可以查询；运动/校准/写 Flash 必须分别授权。
- ARMED：设置当前反馈为初始目标，禁止恢复历史残留目标。
- RUNNING：只接受有界、有效、属于当前会话的命令。
- FAULT_LATCHED：屏蔽新运动命令；恢复通信、重新插 USB 或重连 GUI 均不自动运动。

建议首个**低能量裸电机试验**把命令更新周期定为 20～50 ms，本地命令失联阈值先按 100～200 ms 设计并实测；传感器持续错误检测目标可先设为不超过 5 ms。它们是教学试验初始设计值，不是整臂安全认证指标。装载、速度、制动距离变化后必须重新计算允许响应时间。

位置点命令不能简单要求不停重发而没有协议定义。可以采用已授权目标加独立心跳租约，也可以采用带时间戳的周期目标；无关查询不能刷新运动存活计时。主控断线时已断线节点收不到失能帧，因此检测必须在电机本地实现。

### 4.3 禁止的试验方式

- 不在运行中用手拔磁铁、插拔相线、接触旋转轴或堵住电机轴。
- 不把 CAN、UART 或 USB 线当作物理急停线。
- 不先装减速器再做会多圈转动的编码器校准。
- 不在无支撑的六轴机械臂上验证断电坠落。
- 不在正常伺服中断里打印长文本或执行长时间 Flash 写入。
- 不向整条总线广播校准、擦除、改 ID 或恢复配置以“试一下”。

故障注入优先用软件测试桩、断开功率的板卡、可控 SPI 数据源和固定防护夹具，再进入受控实物验证。

## 5. 开发基线与工具链

### 5.1 本次环境实况

审计时 PATH 中有 `make`、宿主 `gcc/g++`、Python、PDF 工具；没有发现 `cmake`、`arm-none-eabi-gcc` 或 `ninja`。**没有完成三个 STM32 固件的 ARM 构建。** 本次通过的 HSE 预处理和 Python AST 检查只是静态验证。

### 5.2 工作区管理

1. 保留当前原始资料，不删除 History、老 Gerber 或旧模型。
2. 另建实施工作副本或个人版本库，记录复制来源和本次哈希快照；不覆盖同级已有项目目录。
3. 分开存放原始输出、实验构建、安全修订固件、参数备份和测量记录。
4. 构建输出放新目录，不复用仓库中的 `cmake-build-debug` 缓存。
5. 每次试验同时记录源码版本、编译器、优化等级、固件 SHA-256、板号、电机、有效 EEPROM、磁铁和线束。

### 5.3 编译与下载路线

Windows 可用 STM32CubeProgrammer 和 SWD 工具；Linux 使用 GNU Arm Embedded Toolchain、CMake 3.20+ 和 Make/Ninja。先选一套主开发环境，另一套作为后期可移植性验证，首周不同时维护两套不同生成工程。

以下是工具安装完成后，在**工作副本根目录**执行的构建示例；本次未执行，也不是烧录命令：

```bash
cmake -S "2.Firmware/dummy-42motor-fw" -B "build/motor42-baseline" -G "Unix Makefiles" -DCMAKE_BUILD_TYPE=Debug
cmake --build "build/motor42-baseline" --parallel 2
cmake -S "2.Firmware/dummy-35motor-fw" -B "build/motor35-baseline" -G "Unix Makefiles" -DCMAKE_BUILD_TYPE=Debug
cmake --build "build/motor35-baseline" --parallel 2
cmake -S "2.Firmware/dummy-ref-core-fw" -B "build/ref-baseline" -G "Unix Makefiles" -DCMAKE_BUILD_TYPE=Debug
cmake --build "build/ref-baseline" --parallel 2
```

先保留原始构建结果，包括失败日志。若需要修改 CMake 才能构建，单独记录为构建修复，不把“修复后的成功”称为“原始工程开箱成功”。优先完成 Motor-42，Motor-35/REF 的问题可排队，不阻塞最小开发板实验。

注意事项：

- CMake 的 REF `COMMON_FLAGS` 变量声明不等于这些参数一定传给了编译/链接命令；必须检查实际 verbose 命令和 float printf/scanf 行为。
- 当前 Release 使用 `-Ofast`，安全输入验证中的 NaN/Inf 检查不能未经检查就运行在放宽浮点假设的构建下。先固定调试构建，再分别验证优化构建与 20 kHz 时间预算。
- 不先用新版 CubeMX 重生成。电机 README 已提醒中断代码中有手改逻辑，重生成可能破坏控制路径。
- 普通 F103C8 最小板可用于 GPIO/UART/Timer 学习，但不能未经核对就替代 128 KiB Flash 的 F103CB 正式电机板。
- SWD 正常连接、复位下连接、选择性擦除和全片擦除的区别必须清楚。烧录器参考电压和目标供电不可盲目并联。

G0 输出：三个工程各自的构建状态；Motor-42 的 ELF/MAP/HEX/BIN 和大小记录；已审核的 Flash 边界；至少三次干净重建及开发板下载恢复记录。

## 6. 首月安排：20 个工作单元，而不是交期承诺

以每单元约 2～4 小时安排。首月目标为 G0～G2，取决于每周可投入时间和 A 板交期；采购、贴片和返工等待不计入实验工作量。若只能投入每周 6～8 小时，把本表自然延长，不降低安全门槛。

| 单元 | 动手任务 | 即时补的知识 | 当日记录/停止条件 |
|---|---|---|---|
| D01 | 读审计报告，建立工作副本和版本表 | 版本、哈希、源码与产物区别 | 不混用三套机械或旧构建缓存 |
| D02 | 安装主环境工具，构建原 Motor-42 | 编译/链接/启动文件/MAP | 留完整成功或失败日志 |
| D03 | F103 开发板 GPIO、SWD、断点 | 电平、时钟、复位 | 三次可下载、复位、连接 |
| D04 | UART 回显和有界命令解析离线测试 | 115200 8N1、缓冲、帧边界 | 空串/超长/坏数字不进入执行 |
| D05 | Timer 输出观测，整理 Flash 分区 | 中断周期、计数、Flash/RAM | 能解释实测频率与计算式 |
| D06 | 画 Motor-42 五功能区框图，询 A 板来源 | 电源、MCU、传感器、驱动、接口 | 板版本和器件丝印未明不下单 |
| D07 | 核对电机/磁铁/接口；加工固定夹具 | 相电流、绕组、磁化方向 | 不按“42 电机”四个字采购 |
| D08 | 审查制造四件套或验收成品板资料 | Gerber、钻孔、BOM、CPL | 缺钻孔/版本不一致不投板 |
| D09 | 不接电机，静态检查与限流上电 | 极性、短路、电源树 | 电流异常或电源轨不对立即停 |
| D10 | SWD 与无运动诊断固件，手动转轴看原始角 | SPI、无磁、parity、回绕 | G1：不能用校准角掩盖坏采样 |
| D11 | 实现最小 ARM/STOP、故障锁存和遥测 | 状态机、命令/反馈生命周期 | 原固件运动入口不得绕过授权 |
| D12 | 实现传感器错误传播与命令超时 | 失效检测、停止时限 | 先软件注入测试，不手拔磁铁 |
| D13 | 检查电流/校准参数、存储保留、冷启动 | EEPROM 优先级、写入寿命 | 读回实际参数，不只看源码 |
| D14 | 无传动负载的编码器校准 | 电角度、机械角度、误差映射 | 磁铁、相序、额定电流必须已确认 |
| D15 | 以当前反馈为起点，小范围位置试验 | 绝对目标、计数、运动方向 | 第一次不发 p0 或 p1 猜零位 |
| D16 | 单变量调整，正反向阶跃记录 | DCE、速度估计、饱和 | 不同时改电流、增益和磁铁间隙 |
| D17 | 50 次小范围往返，独立测温 | 重复性、温升、负载 | 记录失败，不只录演示视频 |
| D18 | 断命令、坏帧、复位、掉电恢复 | 本地看门狗、故障锁存 | 故障恢复不自动继续旧目标 |
| D19 | 对照日志解释完整闭环与参数来源 | 采样至两相输出的数据流 | 能区分命令电流和测得电流 |
| D20 | 首月验收，整理缺陷、决定是否进入 CAN | 回归、预算 Gate | G2 未过则停留补测 |

交期延误时，可提前做解析器测试、Flash 审查、协议解码和机械版本矩阵；不得用尚未验收的另一块未知板替代 A 板强行推进。

## 7. Motor-42 硬件与制造方案

### 7.1 单板功能拆分

| 功能区 | 项目中的关键器件/文件线索 | 实际要证明什么 |
|---|---|---|
| 电源 | ME3116、LP2992、SS54、SMBJ28CA，Power.SchDoc | 输入保护连接、每级输出、电流容量和热状态 |
| MCU | STM32F103CBT6、晶振、复位、SWD，MCU.SchDoc | 芯片/容量、时钟、可恢复下载 |
| 编码器 | MT6816、轴端磁铁、SPI | 数据有效、方向、间隙、偏心、机械固定 |
| 功率驱动 | 两个 TB67H450FNG、采样电阻、PWM/方向线 | 两相输出对应、限流、关断、热设计 |
| 接口 | CAN 收发器、P1/P2/P3、拨码 | 网络、电平、终端、节点 ID 与防误插 |

上表中器件存在已经有 BOM/IBOM 证据，但电源连接和具体输出电压仍需原理图/实板核验。不能凭 ME3116/SY8089 的型号自行补出未经验证的 REF 电源树。

### 7.2 A 板与 B 板

**A 板要求**：供应方能给出板版本、MCU/驱动/编码器丝印、晶振频率、固件来源、CAN 拨码/终端说明和至少一次基本测试记录。“网上买到的成品”不自动等于“已知良好”。收到后仍执行 G1。

**B 板要求**：G2 后再开始，用于自主焊接与分区排故。沿电源输入、逻辑电源、MCU/SWD、UART、编码器、CAN、驱动的顺序装配，并与 A 板同点位对照。实际是否能按此顺序独立供电，由原理图决定，不擅自拆断关键地回路。

若找不到可信 A 板：先请熟悉 Altium 与贴片的人员审查制造资料，委外一块并进行进料验收；不要为赶首月把全板手焊当成唯一选择，也不因为 Motor-35 包有钻孔就随意更换首个执行器路线。

### 7.3 PCB 放行四件套

1. 冻结选定的原理图、PCB 与版本号；“焊盘更改版”需实际比对后选择。
2. 从同一 PCB 导出 Gerber、NC Drill、装配 BOM、CPL，连同板框、钢网和装配图归档。
3. 在 CAM 中检查铜层顺序、板框、钻孔与焊盘对齐、孔径、板厚/铜厚等制造参数。
4. 按位号核对 BOM 与 CPL，不把 HTML 交互视图当成免审核的机器坐标。
5. 检查 TB67H450 散热焊盘、MT6816 位置、连接器方向、双面贴装旋转和 Pin 1。
6. 确认 CAN 终端只在总线物理两端形成所需终端；BOM 上 R12=120R 不意味着每个节点都应焊一个永久终端。
7. 收到工厂工程确认图后再次复核，不接受未经说明的器件替换、层数修改和连接器替换。

**本次未给 PCB 制造参数签字放行。** Motor-42 缺钻孔是明确发现，其他板也只是“有制造文件线索”，不是“可直接下单”的保证。

## 8. 必须实现的固件修复清单

这些是后续开发任务，本次没有修改生产源码。先做 Motor-42，验证后把共性修复同步到 Motor-35，避免两套复制代码安全能力分叉。

| 编号 | 最小改动目标 | 涉及位置 | 放行前必须证明 |
|---|---|---|---|
| FW01 | 显式授权、STOP、故障锁存；所有运动入口统一检查 | 电机 UserApp 与 Motor 控制入口 | UART/CAN/按键不能绕过 DISARMED；重连不恢复旧运动 |
| FW02 | 有界解析，严格数字转换，拒绝 NaN/Inf/溢出/尾随垃圾 | `interface_uart.cpp`、接收缓冲 | 空帧、裸 c/v/p、分包粘包、满缓冲均不执行错误命令 |
| FW03 | 编码器 valid、连续错误计数、采样年龄传播到控制层 | `mt6816_base.cpp`、`motor.cpp` | 校准有效但无磁或持续坏帧仍触发故障 |
| FW04 | 节点本地命令租约/超时，启动与恢复无自动运动 | 电机慢任务/安全任务 | 拔命令线后在批准时间内进入安全状态 |
| FW05 | 电流/校准/速度/加速度/增益范围验证；校准独立授权 | 电机配置、CAN、按键 | 未确认电机额定值时不能校准；改普通限流不误认为改了校准电流 |
| FW06 | Flash 保留区链接保护、参数有效性和存储失败处理 | 两电机链接脚本及 Memory | 应用所有 Flash 加载段低于 0x08017C00；写入失败可识别 |
| FW07 | CAN 命令表长度、ID/IDE/RTR、有限值、广播门控 | 两端 CAN 收发 | DLC 0～8、节点 0～15、未知帧测试不越界/误写 |
| FW08 | 发送失败不锁死；有界等待、邮箱/信号量恢复、bus-off 故障 | CAN BSP、Error_Handler 路径 | TX 失败后仍能处理故障；PWM 不因死循环无限保留 |
| FW09 | REF 急停独立于 MoveJ；处理零位移/零速/非法 IK 值 | `dummy_robot.cpp` | 当前位姿重复命令和 STOP 不产生 NaN；失败不回复假成功 |
| FW10 | 活动轴集合、到达掩码、反馈年龄、运动总超时 | REF Robot/任务 | 两轴可以验收；缺席/掉线轴可识别，不能伪造六轴到位 |
| FW11 | IMU/OLED/无线可选启动，限定重试，传感器任务条件化 | REF `UserApp/main.cpp` | 未贴外设仍可进入安全诊断，且未误使能电机 |
| FW12 | REF 精确命令匹配、sscanf 返回值、64 字节队列和多通道边界 | ASCII、CommandHandler | 短/长/错误命令不越界；响应区分接受、完成、拒绝、故障 |

附加约束：

- 校准状态不只检查“没有 0xFFFF”，还应核对表范围、版本、完整性；参数写入和校准写入失败不得假报成功。
- 先用受限构建和固定夹具验证 FW01～FW08，再允许正常闭环；增加日志后重新测定 20 kHz 最坏执行时间。
- 使用 20～50 Hz 遥测快照或环形缓冲，不在高速中断里做格式化串口输出。
- 电流反馈 `GetFocCurrent()` 是软件命令量，不是新增了真实相电流传感器。温度数值也要区分 MCU 内温、驱动表面和电机表面。
- 如果采用非整数总传动比，REF 当前 `uint8_t reduction` 不能准确表示；需改数据类型和相关序列化/测试，不能四舍五入。

## 9. 首板上电与编码器验收 SOP

### 9.1 断电检查

1. 板卡拍照编号，记录正反面、Pin 1、功率/CAN 与调试口。
2. 核对 MCU、驱动、编码器、晶振、电容极性、采样电阻及连接器料号。
3. 测量输入和逻辑电源对地阻值，考虑电容充电，不把蜂鸣一次等同于短路。
4. 确认电源正负极、保险保护、开关额定直流分断能力和线端压接。
5. 电机相线暂不连接；CAN、REF、ESP32 暂不接入。
6. 建立实测点与批准范围，不凭经验指定“所有板都安全”的固定静态电流。

### 9.2 限流上电

1. 根据选定原理图确认输入范围，设置实验电源限流；从单板无负载状态开始。
2. 检查输入电流、每级降压输出、3.3 V 和异常发热；异常立即断电定位。
3. 断电后接 SWD，核对目标供电/参考电压，避免 ST-Link 与实验电源反向供电。
4. 读取芯片 ID、容量和原固件信息；成品板已有可用校准/参数时先备份再擦除。
5. 下载无运动诊断固件，确认默认不驱动；测试三次冷启动和恢复连接。
6. 外部 UART 使用 3.3 V 逻辑，TX/RX 交叉并共地；不把 RS-232 电平接入 MCU。

### 9.3 编码器检查

磁铁必须有已确认的尺寸、磁化方向、允许工作间隙和固定方式。按 MT6816 的对应资料和实际机械安装确认，不用任意小磁铁代替，也不只看磁铁“能吸住”。

在功率输出禁用时手转电机轴一整圈，至少记录原始角度、校验有效性、无磁状态、回绕和方向。未校准时 `rectifiedAngle` 的读数不能当作真实闭环位置。

G1 通过标准：供电/SWD/UART 可重复，原始角度单圈变化可解释，磁铁异常与坏帧能被观测，三次冷启动一致，接线记录完整；没有验证完电源、接口、磁铁前不进入校准。

## 10. 裸电机校准与闭环 SOP

### 10.1 校准前必须齐备的资料

| 项 | 必须记录的内容 |
|---|---|
| 电机 | 完整型号、步距角、额定相电流及峰值/RMS 口径、电阻/电感、相线配对 |
| 磁铁 | 型号、方向、安装同心度、间隙、固定与防飞出措施 |
| 电路 | 采样电阻、驱动电流换算、供电限制、散热路径 |
| 参数 | 实际 EEPROM、运行限流、校准电流、速度/加速度、故障阈值 |
| 固件 | FW01～FW08 适用项测试记录、Flash 区域和校准表备份方法 |
| 环境 | 无减速器/皮带/悬臂、轴自由转动空间、可触达断电开关 |

不能把默认 `currentLimit=1000 mA` 当成实物额定值，也不能认为它会自动把 `calibrationCurrent=2000 mA` 截断到 1 A。保守电流要根据实际电机和驱动确定；过低到无法完成校准时应停止诊断，不盲目加电流。

### 10.2 电机编码器校准

1. 固定电机与磁铁，断开传动机构，防止多圈标定带动关节撞限位。
2. 下载经批准的测试固件；读回实际参数，核对校准电流。
3. 在 DISARMED 状态单独授权校准；检查按键不会因误触或上电组合自动触发。
4. 执行校准，监视电源电流、异常声响和温升；不用手接触旋转件。
5. 检查成功/失败原因和写入结果；失败不自动进入正常运动。
6. 导出并校验 32 KiB 表，核对有效范围与持久化；断电重启后再次确认。
7. 重新手转检查校准角连续性，记录原始与映射后的关系。

这一步不是 REF 的 `!CALIBRATION`，也不是六轴机械零位标定。

### 10.3 第一次位置闭环

1. 优先位置模式，不以持续速度或持续电流模式作为首个运动展示。
2. 读取当前多圈反馈 `q0`，以它为初始目标，确认软件零点含义。
3. 设置保守电流、速度和加速度；空载教学试验可把速度上限 0.02～0.05 转/秒、加速度 0.1 转/秒²作为待评估起点，不当成所有电机的固定参数。
4. 首次增量按 0.001～0.005 电机轴圈量级试验，即约 0.36～1.8°；目标是 `q0 + 增量`，不是无条件发送 `p0.005`。
5. 确认反馈方向和实际轴方向一致，连续观测超调、振荡、饱和与温升。
6. 再做相反方向和更小阶跃，保持每次只改一个参数。
7. 验证停止、失联和故障锁存，然后才进入重复定位与持续运行。

原始 UART 单位速查，**只用于理解，修复与授权完成前不作为直接发送清单**：

| 命令族 | 外部值含义 | 内部换算 | 主要误用 |
|---|---|---|---|
| `c数值` | 安培 | ×1000 得 mA | 误把 mA 当 A，或以为是只读查询 |
| `v数值` | 电机轴转/秒 | ×51200 得计数/秒 | 与关节度/秒混淆，失联仍保留旧速度 |
| `p数值` | 相对软件零位的电机轴绝对转数 | ×51200 得内部位置计数 | 误当增量、度或关节角 |

MT6816 原始一圈 16384 档；51200 是控制内部尺度，不能据此宣称实际编码器精度或机械臂精度。

### 10.4 首月量化验收

以下是本项目建议的教学验收目标，不是原作者性能承诺：

- 50 次小范围往返，无不可控运动、不可解释复位、长期饱和或持续振荡。
- 三次冷启动保持 DISARMED，参数和校准状态一致，只有显式授权后允许运动。
- 每次目标都能在预设超时内完成或明确失败；首轮可按 5 秒完成窗口记录，不用“永远等待”。
- 位置误差采用测得反馈记录，并另做机械轴角对照；初始可用电机轴稳态误差不超过 0.5°作教学目标，未达到则调查而不是伪造通过。
- 低负载连续运行 15 分钟并记录温度曲线。可先以可触及表面 50°C 或相对环境升温 25°C 作为保守试验中止阈值；测量位置、仪器误差及器件额定值另行记录，该阈值不代表器件额定温限。
- 失联与传感器故障在批准的时间内触发锁存，重新连线不能自动运动。
- 日志能串联“输入目标、解析、授权、规划、采样、误差控制、两相输出、反馈与故障”。

## 11. CAN 与第二块板阶段

### 11.1 物理层

先用一块节点加 USB-CAN，再接第二块，不同时引入 REF。USB-CAN 必须支持真实 CAN 收发，逻辑分析仪不能代替 CAN 控制器和收发器。

1. 短线连接 CAN_H/CAN_L/必要地参考，核验共地与电源，避免功率地压差。
2. 只在总线物理两端保留所需 120 ohm 终端；断电测总线 H-L，约 60 ohm 仅是两只 120 ohm 并联的预期，不是所有拓扑无条件成立的判据。
3. 记录三位拨码与节点 ID，节点逐个接入冷启动核验，六轴计划使用 1～6，广播 0 不分配给关节。
4. 初始只发只读查询，先验证返回 ID、数据格式与终端，再授权运动。
5. 核对总线实际 1 Mbit/s，不能因软件设置了这个值就假定晶振和位时序正确。

### 11.2 协议核对

标准帧 ID 为 `(nodeID << 7) | command`，数据通常按 32 位小端整数或 IEEE754 float 编排。应由两端代码逐命令生成协议表，而不是只抄注释。主线可先统一要求经典 CAN 数据帧 DLC=8，其余帧拒绝；这是拟定的安全测试基线，需要明确落实到代码。

| 命令 | 当前源码语义 | 复刻阶段处理 |
|---|---|---|
| `0x01` | 值为 1 请求速度模式，其余 STOP | 不当作独立硬件总使能；所有入口仍须授权门 |
| `0x02` | 电机编码器校准 | 默认禁止广播，单节点维护授权 |
| `0x05` | 电机轴位置，byte4 请求 ACK | 检查有限值、范围、长度和反馈含义 |
| `0x06` | 位置加时间；高 4 字节还与 ACK 判断共用 | 首轮禁用，单独澄清协议再开放 |
| `0x07` | 位置加速度上限，自动返回位置/状态 | REF 主线路径，必须完整 8 字节且参数有效 |
| `0x11` | 修改节点 ID，可保存 | 冷启动会被拨码覆盖，首轮不在线批量改 |
| `0x12`～`0x1B` | 若干参数/零位/开关写入 | 逐项白名单，区别 RAM 与 Flash 写入 |
| `0x21` | 软件电流命令反馈 | 不标为实际绕组电流测量 |
| `0x23` | 位置/状态反馈 | 接收不等于完成；持续读取状态与反馈年龄 |
| `0x7D` | 开启温度监视 | 不是急停/使能命令，也不证明温度数值有效 |
| `0x7E/0x7F` | 恢复配置/重启 | 维护模式中执行，不作正常试验探针 |

### 11.3 故障与负载试验

按只读、单节点小位移、第二节点、错误帧、失联、bus-off/发送失败、恢复顺序进行。所有错误帧测试先断开功率或接模拟节点。

六轴 200 Hz 若每周期每轴一发一收，量级约 2400 帧/秒。按每帧约 110～135 bit 粗估，在 1 Mbit/s 总线上约占 26%～32% 的线时，再加查询、重发和错误开销。这是规划估计，不是实测；必须抓包记录周期、抖动和总线负载，CAN 不是六轴同时到达的硬同步保证。

G3 输出：协议表、逐节点参数、总线拓扑和终端照片、错误注入结果、本地超时记录、A/B 板同电机/同固件对比，以及恢复流程。

## 12. 单关节阶段

优先从台面受约束的旋转关节试验开始，不直接把长臂、重力负载和复杂线束一起引入。

1. 先在夹具上加已知惯量负载，比较空载与负载响应。
2. 选定一个真实关节的传动链与安装件，先做低成本几何样件。
3. 根据装配关系记录电机轴、同步带、减速器、输出轴各级方向和传动比。
4. 静态/低速实测总传动比，正反向各做多次，不只测一个方向。
5. 用独立输出侧角度基准测量回差、重复定位和弹性，不用电机编码器反馈冒充输出侧精度。
6. 记录轴承预紧、皮带张力、紧固方式、减速器安装面和平行/同心度。
7. 增加机械限位和支撑；确定正常停机、故障停机、断电时的输出行为。
8. 负载稳定后调整控制参数，每次只变一个量，重做温升和冷启动。

参数关系：

```text
r_total = 电机轴转数 / 关节输出转数
r_total = 各级减速比的乘积
皮带级减速比 = 从动轮齿数 / 主动轮齿数
电机目标转数 = 方向符号 × (关节目标角 - 关节软件基准角) / 360 × r_total
```

不要把电机步距角乘入机械传动比，也不要从 `GBN...-60` 的型号后缀推出齿数。若存在腕部耦合，必须建立多轴传动关系，不能强行套独立单轴比例。

G4 输出：一个可受控停机的关节、真实传动比/零位表、输出侧量测报告、负载和温升数据。该阶段通过后才批准其他减速器与整套加工的预算准备。

## 13. REF 与双轴最小系统

### 13.1 先分开验证，再集成

F405 开发板可用于 FreeRTOS、CAN 和任务调度学习，但其引脚、晶振、电源与外设通常不等同于 REF，不能直接刷原 REF 镜像并期待运行。

建议先在开发板上写一个只调用 `CtrlStepMotor` 的双轴试验应用，不运行六轴 `DummyRobot` 的 HOME/CALIBRATION。待通信、时序和故障路径稳定，再把 FW09～FW12 集成到 REF 工作副本。

最小 REF 裁剪必须同时处理：

- IMU 初始化改有限重试/显式可选；依赖它的更新任务也要条件化。
- OLED、RGB、无线与相关 DMA/PWM/任务不能只“不贴硬件”而不处理软件调用。
- 将活动轴列表用于下发、反馈判定、到达掩码、限位、故障和 GUI 显示。
- 缺席轴与掉线轴分别定义；不能把不存在的反馈伪造成“已到达”。
- 所有等待到位、发送信号量、查询和复位过程均有超时与可观察结果。
- 模拟两轴时不对外宣称得到真实六轴末端位姿；六轴运动学用离线数据单独验证。

### 13.2 REF 的命令使用顺序

先无运动查询、再单轴已授权目标、再双轴；原始 `!HOME`、`!RESET`、`!CALIBRATION` 在整改和六轴参数冻结前禁止使用。

| 入口 | 当前行为 | 本版要求 |
|---|---|---|
| `!START` | 节点使能相关请求 | 必须增加系统 READY、反馈新鲜和授权条件 |
| `!DISABLE` | 通过 CAN 请求停止模式 | 不是独立硬件急停；断线时不可达 |
| `!STOP` | 回发当前位置目标后停主控下发 | 先修独立安全路径，不能照旧使用 |
| `!HOME` | 移动到 `{0,0,90,0,0,0}` 并等待 | 不是寻零开关搜索；需可靠基准和超时 |
| `!RESET` | 进入 REST_POSE | 会运动，不是仅软件复位 |
| `!CALIBRATION` | 写偏置、移动、重启 | 只在整机校准维护流程开放 |
| `>` / `&` | 关节空间目标 | 区分接受、拒绝、到达，检查有限值/限位 |
| `@` | 末端位姿经 IK 转关节目标 | 只在 FK/IK 和坐标系验证后开放 |

G5 通过标准：缺失 IMU/OLED 时能安全诊断；两个活动轴可以完成任务；任一节点掉线或错误反馈不会永久等待或误判完成；200 Hz 调度抖动和 CAN 开销有测量；停止行为不依赖 GUI 正常工作。

## 14. 视频 V2 机械与参数冻结

### 14.1 版本选择不能只看目录名

候选主装配为 `4.Model/Dummy V2 版本 视频款/Dummy-B v2装配体.step`，另有 `改版/Dummy-B.STEP` 及改版基座/J1、改版工程图。先比较接口和替换关系，再选一个闭合装配基线。其余版本只作参考，不从中随意拣一件补缺口。

制造矩阵至少包含：零件号、版本、原始文件、装配实例数、材料、工艺、表面处理、关键尺寸/公差、配合对象、净用量、备件量、检验方法、供应商和状态。

`PRODUCT` 名称数量不等于装配实例数量；STL/STEP 同名也不等于两种都要做。CAD 中应展开实例与替代件，明确 CNC 与打印是否二选一。旧购物截图和一键购数量不能当装机净用量。

### 14.2 六轴参数冲突表

以下只记录现有来源，不代表已经批准使用：

| 轴 | 当前 REF 代码比值 | 视频 V2 参数图比值 | 代码 inverse | 图片 inverse | 采购/参数冻结要求 |
|---|---:|---:|---|---|---|
| J1 | 30 | 50 | true | false | 42 电机长度、mini11、轴向安装、方向 |
| J2 | 30 | 50 | false | true | 重力支撑、限位差异、机械基准 |
| J3 | 30 | 50 | true | true | 起始角范围 35°/0° 冲突、臂部装配 |
| J4 | 24 | 50 | false | true | 皮带/减速器链路及可能耦合需量测 |
| J5 | 30 | 50 | true | true | mini8/实际归属、负向限位 -120°/-100° |
| J6 | 50 | 5 | true | true | 行星减速完整型号、实际总比、线束扭转 |

| 几何常量 | 当前源码，mm | 视频 V2 参数图，mm | 冻结方法 |
|---|---:|---:|---|
| L_BS | 109 | 126.5 | 按求解器坐标定义测基座到肩部轴线 |
| D_BS | 35 | 35 | 核对基座/肩部偏置方向，不只量外壳 |
| L_AM | 146 | 146 | 核对关节轴线距离 |
| L_FA | 115 | 117 | 核对前臂轴系尺寸 |
| D_EW | 52 | 52 | 核对腕部偏置 |
| L_WT | 72 | 75.5 | 核对末端基准；附加工具 TCP 单独定义 |

由 `6dof_kinematic.cpp` 的具体定义反推 CAD 量测基准，再形成单位、坐标方向、零位偏置和变换链。不能把图片上的六个长度机械套到其他 DH 约定。

### 14.3 整机关键物料候选表

| 物料 | 仓库候选数量/规格 | 未冻结内容 |
|---|---|---|
| Motor-42 / Motor-35 / REF | 3 / 3 / 1 | 每板版本、制造资料、终端配置和单板验收 |
| 42 电机 | BOM 为长 40 mm ×3 | STEP 同时有 42-34 与 42-40，逐轴归属待核 |
| 35 电机 | 长 28 mm ×2 | 额定电流、轴端、磁铁和安装尺寸 |
| J6 行星电机 | 35 系列长 20 mm ×1 | 完整型号、行星比、总比、回差 |
| mini11 / mini8 | 4 / 1 | 30/50 档、每轴归属、法兰/轴孔、承载与供应版本 |
| 同步轮 | 20 齿、内孔 5 mm、外径 18 mm ×6 | 齿形、宽度、紧固与实际传动关系 |
| 同步带 | BOM 写 130×2、150×1 | 与旧指南 110/116/148/182 冲突，重新量中心距和张紧范围 |
| 圆柱销 | 5×35 ×4 | 配合、公差与装配方式 |
| 轴承 | 5×13×4 ×4；5×10×4 ×1 | 类型、游隙、安装和实际数量 |
| 线束 | ZH1.5、22AWG，长短多种 | 逐根实际长度、端子额定、线序、弯曲半径与运动寿命 |
| 电源 | BOM 为 24 V/6 A | 真实峰值、压降、再生能量、接头与开关能力 |
| CNC/打印/外壳/紧固件 | 有候选文件和购买截图 | 材料、净用量、替代工艺、关键公差与表面处理 |

### 14.4 CAD、加工与进料检查

1. 在 CAD 中定位每一个执行器、减速器、皮带和线束通道，建立关节归属。
2. 检查全行程干涉、限位、线束余量、装配工具可达性和磁铁安装空间。
3. 对轴承座、定位台阶、法兰、销孔和电机止口做配合审查；不把全部尺寸统一标成高精度。
4. 补齐材料、热处理/表面处理、基准、关键公差和数量；让加工厂确认可制造性。
5. 先打印或低成本加工接口样件验证几何，再做一套关节验证承载；打印样件能装上不代表其适合长期承载。
6. 明确谐波/行星减速器的安装与预紧要求，不用锤击装配精密配合面。
7. 进料时测关键孔距、轴孔、安装平面、轴伸、螺纹、毛刺和方向标识；未检验件不直接进入总装。
8. 拧紧力矩、螺纹锁固剂、皮带张力按材料/紧固件/供应商资料确定，不编造统一数值。

G6 输出必须是一份可发给供应商且可据此验收的制造包，而不仅是文件夹截图。

## 15. 六轴集成、标定与验证

### 15.1 装配顺序

1. 六块电机板和六个电机逐个完成单节点验收，标注 ID、固件与校准备份。
2. 每个关节分别装配，测总比、方向、行程、温升和输出侧重复性。
3. 固定基座，J2/J3 使用支撑；先做下部关节，再装腕部，最后装线束和外壳。
4. 断电逐针核验整条线束，确认终端位置与保险/开关，不把前面的单线测试自动视为整机测试。
5. 首次整机只供逻辑/保持运动禁用，依次确认六节点在线和反馈合理。
6. 每次只授权一个轴，受限范围内确认方向、反馈、限位和机械间隙。
7. 检查多轴同时动作的供电压降、总线抖动、热负载和紧固松动。

J6 软件允许 ±720°不证明线束允许旋转两圈，更不表示有滑环；先按实际线束可承受行程设更窄限位。

### 15.2 分清三类基准

| 基准 | 解决的问题 | 验证方式 |
|---|---|---|
| 编码器校准表 | 电机轴磁角映射和非线性 | 裸电机标定与有效性检查 |
| 关节机械/软件零位 | 关节输出角、编码器零偏与安装姿态对应 | 机械基准、量具、逐轴正反向检查 |
| 机器人基座/工具坐标 | 六轴关节角与末端位姿对应 | CAD 几何、FK、外部量测、TCP 标定 |

原固件启动姿态假定为 `REST_POSE={0,-73,180,0,0,0}`，并不等于有绝对多圈关节编码器或自动寻找机械零点。关机后移动关节、磁铁/电机/减速器重装或整片擦除，都可能破坏这一假定。

因此先建立可重复的人工定位治具或可靠的零位恢复流程，并规定断电后能否移动关节。不能一上电便发 `!HOME` 试图“自动纠正一切”。

### 15.3 REF 零偏校准

原 `CalibrateHomeOffset()` 包含人工摆 L-Pose 的注释、使能、两次写偏置、移到收拢姿态和重启，中间没有完善的人机确认。复刻工作副本应改为明确的分步流程：

1. 所有节点已通过电机编码器校准，参数、方向、传动比和限位已冻结。
2. 机构有支撑，操作者按定义的 L-Pose 用治具定位并确认，不只凭肉眼摆直。
3. 软件读取当前反馈，验证姿态可接受后才进入写零偏阶段。
4. 若需收拢运动，先验证路径与剩余空间，受限速度执行；每一步有超时和可中断状态。
5. 保存偏置与参数，重启后以机械基准和读回值双重验证。
6. 原流程把 J2/J3 电流恢复到 1 A；实施时必须恢复到本机已批准的值，不能盲目保留固定 1 A。

### 15.4 FK/IK 与整机性能

先关节空间，后笛卡尔空间；先离线计算，后实物动作。当前函数名 `MoveL` 不足以证明末端整条路径是直线，它主要完成位姿逆解并转为关节运动，不能承诺经过碰撞检查的笛卡尔直线插补。

| 验证 | 执行方法 | 应保存的数据 |
|---|---|---|
| FK | 若干已知关节姿态与 CAD/量具比较 | 输入关节、坐标约定、计算位姿、外测位姿 |
| IK | FK→IK→FK 往返，含边界和不可达点 | 可行解、残差、拒绝原因、限位和连续性 |
| 奇异/非法值 | 离线注入 NaN/Inf、零速、极限姿态 | 无非法 CAN 下发；返回明确失败 |
| 重复定位 | 同一姿态双向接近，至少 10 次 | 输出侧/末端分布，不只保存编码器误差 |
| 负载 | 先无工具，再逐步增加已知负载 | 载荷、臂展、速度、温升、误差和供电 |
| 故障 | 单轴掉线、错误反馈、主机断开、复位 | 停止时间、输出行为、恢复条件 |
| 热稳定 | 分段延长到 30～60 分钟低风险运行 | 温度曲线、压降、总线错误、复位与松动 |

末端精度/重复定位指标应在负载、速度、温度、量具和测试姿态确定后设定。这里不承诺原项目宣传参数，也不把 `ok` 当作“目标实际到达”。

## 16. 采购与预算控制

### 16.1 第一批只购买能支持单轴的资产

以下为规划估算，未做当前商家询价，人民币区间不含运费/起步费/返工。优先借用电源、示波器和显微镜。未冻结电机长度时，可以明确把首个电机作为独立实验台资产；不能默认保证以后装得进整机。

| 必需工具 | 数量 | 要求 | 估算小计，元 |
|---|---:|---|---:|
| 可调直流电源 | 1 | 覆盖计划输入电压、可设限流、输出可切断 | 300～700 |
| 万用表 | 1 | 电压/阻值/通断/二极管测量可靠 | 80～200 |
| ST-Link 或等效调试器 | 1 | 支持 F1/F4 SWD，来源可追溯 | 50～200 |
| USB-UART | 1 | 3.3 V 逻辑，115200 稳定 | 20～60 |
| 线材、端子、保险、断电装置 | 1 批 | 适用直流负载，防误接 | 80～200 |
| **必需工具合计** | | | **530～1360** |

| 单轴实物 | 数量 | 要求 | 估算小计，元 |
|---|---:|---|---:|
| A 板 | 1 | 已知良好 Motor-42 或经过审核的委外板 | 150～600 |
| 42 电机 | 1 | 相电流、绕组、轴端、磁铁孔明确 | 80～250 |
| 磁铁/备件 | 1 批 | 规格和固定方式已确认 | 20～100 |
| 固定与防护夹具 | 1 套 | 刚性固定、防飞出、无缠绕 | 30～150 |
| F103 最小开发板 | 1 | 用于基础实验，不代替正式电机板 | 30～100 |
| **单轴实物合计** | | | **310～1200** |

基础估算合计 **840～2560 元**，两张表已算术复核。这不是“840 元保证复刻成功”的报价；若 A 板报价不含 SMT 起步费、钢网或元件，需要另列，不能仍沿用同一合计。

可选/后续工具独立计价：焊接工具与耗材约 200～600 元、逻辑分析仪约 40～150 元、放大观察约 100～400 元、USB-CAN 约 80～400 元、B 板裸板/器件/钢网/贴片另行报价。示波器优先借用；逻辑分析仪不能替代对电源纹波和模拟电流的观察。

### 16.2 分批释放预算

| 批次 | 买什么 | 放行条件 | 预算做法 |
|---|---|---|---|
| B0 | 基础工具和最小开发板 | 学习路线确认 | 有可借设备就扣除，不重复买 |
| B1 | A 板、电机、磁铁、夹具 | 制造/型号/接口已确认 | 对照上表逐项询价 |
| B2 | B 板、焊接工具、USB-CAN、第二节点 | G2 通过 | 建立新增费用清单，不再计入 B0/B1 资产 |
| B3 | 单关节减速/传动/样件 | G3 通过且单关节模型冻结 | 先一套接口样件，再负载件 |
| B4 | F405/REF、第二关节与线束 | G4 通过 | 先双轴，不顺带买全六轴 |
| B5 | 其余电控、减速器、CNC/打印/紧固件 | G5、G6 通过 | 用完整净用量 BOM 正式报价后批准 |

整机预算使用：`尚缺净用量成本 + 制造起步/治具费用 + 运税费 + 明确备件 + 20%～30% 风险准备金`。已经用于整机的 A/B 板、电机和减速器从尚缺净用量里扣除，借用工具不计采购支出。

本版不继续给一个未经当前报价支撑的“整机只需 3900～6000 元”结论。G6 之前，整机总价属于待确认项；可以先设置支出上限，但不能把上限当完成报价。

### 16.3 给供应商的询价字段

电机：完整型号、外形和轴端图、额定电流口径、电阻/电感、磁铁接口、批次一致性。减速器：完整后缀、精确比值、输入/输出法兰、额定/峰值转矩、回差、安装说明。板卡：PCB 版本、芯片丝印、晶振、烧录/校准状态、终端/拨码、出厂测试。加工件：材料、关键公差、数量、表面处理、交期与不合格返工标准。

先要规格和图纸，后问价格；不以商品标题、旧淘宝链接或“兼容 Dummy”替代型号确认。

## 17. 上位机、ESP32 与二次开发

### 17.1 三种入口分开管理

| 入口 | 对象 | 本版使用方式 |
|---|---|---|
| 自制单轴测试工具 | Motor UART `c/v/p` 及新增安全/遥测协议 | G2 的最小客户端；接口有界、默认只读 |
| `3.Software/simple-cli/` | REF ASCII | 修端口参数、超时、错误处理；连接时不得自动使能 |
| `3.Software/CLI-Tool/` | Fibre/REF 对象接口 | 核对依赖、路径与协议对象，清理 ODrive 残留后验证 |
| DummyStudio | REF 的 Windows 客户端 | G7 后接入，不赋予绕过安全门的权限 |

客户端需有明确连接目标、当前模式、使能/故障、反馈年龄、命令接受/到达/拒绝状态。第一版只做终端与 CSV，不先开发复杂 GUI。

### 17.2 ESP32 必须单独验收

1. 先修复主线被展平为普通文本的链接文件，逐一核对实际目标，记录上游来源；不能直接相信 `.c` 后缀。
2. 锁定 ESP-IDF、Docker 镜像/工具版本和分区表；不使用未固定版本的环境作为可重复构建基线。
3. 不把空 `dummy-iot.hex` 或空工具 ZIP 当成可烧录资料；确认 Linux/Windows 工具可用。
4. 用无电机的串口回环测试 HTTP/TCP/WebSocket/MQTT，不直接连 REF 运动接口。
5. 默认关闭公共 MQTT 和不必要监听；增加认证、最小命令权限、会话超时和本地授权。
6. 错误 Wi-Fi 凭据、断网、重连、配置写入失败均不使能机械臂。
7. 网络层绝不能绕过电机/主控本地安全机制，不能暴露到公网做无人值守控制。

### 17.3 可选学习方向

G7 后再考虑 URDF/ROS、MoveIt、轨迹规划、视觉和夹爪。URDF 必须来自最终冻结的坐标系、惯量和限位；夹爪需补机械、电控、固件与安全设计，不能因为 REF 有 node 7 类就认定已有可复刻夹爪。

未来公开发布或商业使用前，单独审查根 GPL、README 限制、模型来源、Unity 资产和 Mongoose 等组件的许可。GPL 不等于禁止商业使用，也不自动解决全部混合素材的授权。

## 18. 验收用例清单

以下均为**待执行**，本次只完成审计，不把表中标准冒充实测结果。每项填写前置条件、刺激、期待结果、实测结果、日志和日期。

| 用例 | 阶段 | 试验 | 合格标准 |
|---|---|---|---|
| T01 | G0 | 干净构建与重建 | Motor-42 三次可重建；35/REF 构建状态和问题已记录 |
| T02 | G0 | 链接区与烧录区检查 | 所有应用 Flash 加载段不侵占校准/参数区 |
| T03 | G0 | 下载、复位、连接恢复 | 三次可重复，知道全擦的后果 |
| T04 | G1 | 板卡静态和限流上电 | 电源轨、电流、极性符合已批准检查表 |
| T05 | G1 | 接线逐针通断 | 每条线网络和观察方向可追溯，P3 不误接功率 |
| T06 | G1 | 原始编码器单圈 | 回绕、方向、无磁和校验可解释 |
| T07 | G2 | 启动/重连授权 | 不因 EEPROM、USB 重连或旧目标自动运动 |
| T08 | G2 | UART 空串/裸前缀/分包/粘包/超长 | 无越界、无错误执行、错误响应可见 |
| T09 | G2 | NaN/Inf/溢出/负时间/非法范围 | 被拒绝，不进入电流/规划运算 |
| T10 | G2 | 传感器坏帧/无磁/过期注入 | 在批准阈值内锁存故障，无静默旧反馈 |
| T11 | G2 | 命令源中断 | 节点本地超时有效；普通查询不能延长运动租约 |
| T12 | G2 | 校准电流与维护授权 | 参数未确认或未授权时拒绝校准 |
| T13 | G2 | 校准完成与冷启动 | 表、参数和诊断状态一致；失败不误报成功 |
| T14 | G2 | 50 次小范围正反往返 | 无失控、复位、持续振荡；误差记录完整 |
| T15 | G2 | 15 分钟低负载热测试 | 不超过批准中止阈值，无不可解释温升 |
| T16 | G3 | CAN ID/终端/速率 | 逐节点与重启一致，无冲突；实测速率和拓扑正确 |
| T17 | G3 | DLC 0～8、IDE/RTR、节点 0～15 | 非法帧不越界、不执行、不写 Flash |
| T18 | G3 | 广播危险写/误命令 | 被拒绝或需独立维护授权 |
| T19 | G3 | 发送失败、邮箱耗尽、bus-off | 不死锁，故障路径和本地停止仍有效 |
| T20 | G3 | A/B 板同条件对比 | 关键测点和控制行为可解释；差异已定位 |
| T21 | G4 | 正反向传动比和零位 | 外部量测与换算一致，不用源码反证自身 |
| T22 | G4 | 输出侧回差/重复性 | 有独立量测记录、载荷和接近方向 |
| T23 | G4 | 支撑下物理断电 | 无坠落/飞出/夹伤，复电保持禁用 |
| T24 | G5 | 缺 IMU/OLED/非活动轴 | 可安全诊断，缺席不伪装成到达 |
| T25 | G5 | 活动轴掉线/反馈过期 | 任务有界结束，故障可见、不可自动续跑 |
| T26 | G5 | STOP/重复当前位置/零速 | 不产生 NaN，不依赖正常 MoveJ 完成 |
| T27 | G5 | REF 短/长队列命令及多通道 | 无固定长度越界读取和截断后错误执行 |
| T28 | G5 | 200 Hz 调度与多轴 CAN | 周期、抖动、总线占用有记录，满足冻结时限 |
| T29 | G6 | CAD/采购/制造一致性 | 文件、版本、实例数、材料和验收标准闭合 |
| T30 | G7 | 六轴静态在线与逐轴授权 | ID、方向、比值、限位和线束行程对应 |
| T31 | G7 | 零位恢复与重启 | 机械基准、偏置、反馈一致，重启无误动 |
| T32 | G7 | FK/IK 往返与不可达/奇异 | 残差符合预设标准；非法解不下发 |
| T33 | G7 | 末端重复定位与分级负载 | 外部量测、负载/速度/温度和误差报告齐备 |
| T34 | 后置 | GUI/网络断开、未认证命令 | 不能绕过本地授权，未授权不可触发运动 |

## 19. 学习地图与故障排查顺序

| 现象 | 先排查 | 不要先做 |
|---|---|---|
| 无法烧录 | 供电、共地、SWD、复位、芯片容量和工具连接 | 调 PID 或反复全擦 |
| UART 乱码/CAN 不通 | 逻辑电平、晶振、时钟树、位时序、线序和终端 | 按源码函数名假定时序正确 |
| 编码器跳变 | 原始数据、parity、无磁、SPI、磁铁偏心/间隙 | 用滤波把无效数据隐藏 |
| 校准失败 | 电机步距角/相序、磁铁、校准电流、Flash 写入 | 装着减速器反复大电流校准 |
| 振荡/发热 | 电流口径、方向、采样时序、传动松动、饱和 | 同时改多个增益 |
| 断线不停 | 本地超时、授权状态、固件版本 | 只在上位机增加一个停止按钮 |
| REF 等待不返回 | 在线轴、到达掩码、反馈年龄、无限等待和 CAN TX | 直接加大速度“让它快点到” |
| 末端位置不对 | 当前参数与 V2 图冲突、坐标系、零位、总比、TCP | 先怀疑全部 IK 算法或加入视觉纠偏 |

每次实验固定采用“现象 → 假设 → 单变量试验 → 原始数据 → 结论 → 修改 → 回归”。无需先学习完 HAL、FreeRTOS、USB、CAN、控制和机器人学全部课程，但也不跳过当前风险所依赖的基础理论。

## 20. 最近应执行的三个工作包

### 工作包 1：开发与安全基线

完成主工具链安装、Motor-42 原始构建、Flash 保留区审查；在开发板/宿主测试环境验证有界解析和状态机。交付构建日志、固件版本表、FW01～FW06 的开发清单与首批离线测试。尚未完成这些时，不发电机运动命令。

### 工作包 2：单轴实物放行

确定 A 板可追溯来源、电机额定参数、磁铁和夹具；没有 A 板时先补 Motor-42 钻孔与 CPL，统一制造版本。只询价和采购 B0/B1，交付单轴采购单、线束逐针表与首板检查表，不订整套 CNC/谐波减速器。

### 工作包 3：机械数字冻结

在 CAD 中比较视频 V2 两个装配体，定位 42-34/42-40、J4 传动链和 J6 行星比；逐项量测源码与截图不同的几何常量。交付“轴—执行器—传动链—零位—限位—参数来源”矩阵，待定项明确标红或写“未放行”，不以截图替代量测。

**执行原则：先把一个低能量闭环单元做得可解释、可停止、可恢复，再复制到关节和整机。原始源码、已有 Gerber、商品链接和演示视频都只能作为起点，不能替代本机的版本冻结和验收证据。**
