MARS-ROBOTICS-star/Dummy-Robot-Reproduction/workspace/stm32-roadmap-video-evidence/deliverables/bilibili-stm32-roadmap-review-20260921.md

# Bilibili STM32/嵌入式调研审查报告

检索日期：2026-09-21  
范围：仅 Bilibili 搜索、视频详情、一级热门评论和本地下载媒体。未使用 Google、知乎或小红书。  
用途：为 Dummy V2 E0-E13 学习阶段提供可追溯的学习材料，不替代项目安全审计，也不直接生成新的 6-12 个月路线。

## 1. 结论摘要

- 最终保留 20 个去重 A 条目。FOC、CAN、FreeRTOS 和项目教程各有 4 个入口；STM32 学习路线仅 2 个，嵌入式学习路线仅 3 个。`BV1H4Lt6pENW` 在两个路线主题中交叉引用，但去重后只计一次。
- A 类不是“全部都值得完整观看”，而是满足相关性、独立性和商业筛选后，至少能提供两条可核验内容证据的候选。
- 最适合 Dummy V2 当前阶段的材料集中在：项目早开始、编码器/电流采样/FOC 基础、CAN 报文与驱动代码、FreeRTOS 移植边界。
- 六个主题的共同结论是“基础和项目交替推进”，但没有任何一个视频能替代 Motor-42 实物、MT6816、供电、限流、断电和固件边界的本机验证。
- `BV1oz421m7Zb` 因热门评论出现个人微信号，按严格导流规则降为 B；以 `BV1Z1421C7dP` 补充 CAN 主题。
- Gemini 批量视频分析未形成可用证据：API 返回 HTTP 402，账户预付额度耗尽。因此本报告只使用本地字幕、视频帧和 Bilibili 元数据，不声称存在 Gemini 证据。

## 2. 证据规则

- `T`：本地 `source.ai-zh.srt` 字幕中的时间戳和口播。AI 字幕只作为定位索引，技术含义仍以画面/代码和原始上下文复核。
- `V`：本地视频画面核验，尤其用于无字幕视频；不把画面推断写成口播事实。
- `D`：Bilibili 详情页中的标题、简介、分P、时长、日期和互动数。
- 每个 A 条目保留至少两条 `HH:MM:SS.mmm` 证据。多P条目在证据中标明 `pN`；未下载的分P不推断其内容。
- 评分为学习价值评分，不是视频制作质量或作者能力评分：5 = 可作为当前阶段主参考，4 = 强参考但需交叉验证，3 = 局部参考，2 以下不进入 A。
- “无商业导流”仅表示详情、视频正文和抽取的一级热门评论未发现作者售卖开发板/套件、课程、资料包、私信、QQ群/公众号或技术服务获客信号。直接公开的 GitHub、Gitee、博客或文档链接不单独算导流；要求关注、评论、回复关键词，或只承诺另行提供网盘资料的资源磁铁则降级。

## 3. A 类白名单

### 3.1 STM32 学习路线

| BVID / 主题 | 标题；UP主 | 日期；时长；播放/赞/评 | 评分；Dummy V2 映射 | 商业筛选 |
|---|---|---|---|---|
| [BV1ptpFzCEix](https://www.bilibili.com/video/BV1ptpFzCEix/) | 直接做单片机项目，不要等全学会了才开始；电工水果子 | 2025-09-14；06:28；17,592 / 423 / 115 | 4；E0-E5 | 通过；个人复盘，未见收费或获客 |
| [BV1H4Lt6pENW](https://www.bilibili.com/video/BV1H4Lt6pENW/) | 如何丝滑入门电子工程师？我的学习路线分享；Expert电子实验室 | 2026-05-21；11:56；109,897 / 3,994 / 382 | 4；E0-E5，部分 E8/E13 参考 | 通过；公开博客和开源项目，不见售卖 |

证据：

- `BV1ptpFzCEix`：`00:02:11.700` 提到工作中使用的单片机项目；`00:03:18.430` 明确表达不必等 STM32 内容全部学完再做项目；`00:05:10.880` 对比开发板学习和工作项目学习。`T`
- `BV1H4Lt6pENW`：`00:01:59.500` 建议用小项目培养兴趣；`00:05:34.080` 从电路基础理论开始；`00:06:50.680` 提到强化阶段制作两个项目。`T`

本主题严格 A 数量为 2，缺口 2。`BV1K6UCBREer` 和 `BV1dPn2zZEec` 的技术内容仍有参考价值，但正文存在网盘文档或“评论区免费自取 + 关注”资源磁铁，因此降为 B。

### 3.2 嵌入式学习路线

| BVID / 主题 | 标题；UP主 | 日期；时长；播放/赞/评 | 评分；Dummy V2 映射 | 商业筛选 |
|---|---|---|---|---|
| [BV1Fw3ozBEaz](https://www.bilibili.com/video/BV1Fw3ozBEaz/) | 嵌入式如何自学；嵌入式_小王在努力 | 2025-07-05；11:20；165,443 / 5,402 / 799 | 4；E0-E5 | 通过；仅指向公开开源硬件平台/博主 |
| [BV1zu5e6NE9y](https://www.bilibili.com/video/BV1zu5e6NE9y/) | 嵌入式三大学习路线；诗的结尾255 | 2026-05-15；04:00；84,976 / 5,618 / 247 | 3；E0-E5 | 通过；明确为个人观点，未见售卖 |
| `BV1H4Lt6pENW` | 同上 | 同上 | 4；路线交叉参考，不重复计数 | 同上 |

证据：

- `BV1Fw3ozBEaz`：`00:00:23.100` 解释嵌入式开发学习入口；`00:00:29.160` 以蓝牙模块和电机驱动模块举例；`00:10:50.390` 建议在复刻项目时学习。`T`
- `BV1zu5e6NE9y`：`00:00:11.320` 将公共基础和尽早做项目并列；`00:00:34.870` 强调嵌入式路线不是一条直线；`00:03:55.360` 回到在项目中学习。`T`
- `BV1H4Lt6pENW`：证据同上；其价值在于把电路基础、开源小项目和电机方向放在同一张路线图中，而不是把它当作 Dummy V2 的具体实现教程。`T`

本主题严格 A 数量为 3，缺口 1。`BV1W44y1k729` 虽有路线内容，但正文多次要求关注公众号并回复关键词获取路线图，列 C。

### 3.3 STM32 项目教程

| BVID / 主题 | 标题；UP主 | 日期；时长；播放/赞/评 | 评分；Dummy V2 映射 | 商业筛选 |
|---|---|---|---|---|
| [BV1bUnKziED2](https://www.bilibili.com/video/BV1bUnKziED2/) | 学完江协科技 STM32 课程的第一个项目实战——冰箱功能模拟；红茶oy3 | 2025-09-23；01:59；11,234 / 162 / 28 | 3；E0-E4 | 通过；GitHub 项目，无作者收费信号 |
| [BV1kun3zBEu1](https://www.bilibili.com/video/BV1kun3zBEu1/) | 如何优雅地开始第一个 STM32 开发项目：点亮 LED；Silver三维码 | 2025-09-26；26:04；43,669 / 668 / 328 | 4；E0-E1，GPIO 工程习惯 | 通过；GitHub/网盘公开资源，未见收费获客 |
| [BV1Rven6BEH8](https://www.bilibili.com/video/BV1Rven6BEH8/) | 一个项目速通单片机 STM32F103C8T6：遥控车；电导不是韩导 | 2026-09-15；02:58:52；5,964 / 177 / 51 | 4；E0-E5，蓝牙/UART/状态机 | 通过；项目章节和公开图文资源，未见收费信号 |
| [BV19qKizsEw4](https://www.bilibili.com/video/BV19qKizsEw4/) | 超详细 STM32 HAL 物联网智能家居毕设参考案例；壹知半解 | 2025-06-27；已核验 p1 00:43、p4 15:00、p10 19:35；61,166 / 454 / 252 | 4；E0-E5，MQTT/网络仅作 E13 远期参考 | 通过；技术步骤和兼容性说明，未见账号售卖 |

证据：

- `BV1bUnKziED2`：`00:00:20.350` 用旋钮编码器控制温度；`00:00:25.790` 用电机模拟压缩机启动运行；`00:01:33.970` 转到 GitHub 项目说明。`T`
- `BV1kun3zBEu1`：`00:00:20.130` 创建新 STM32 项目；`00:00:51.690` 选择 STM32F 型号；`00:24:50.940` 配置 GPIO 输出高电平。`T`
- `BV1Rven6BEH8`：`00:00:36.660` 将项目分成三个章节；`02:54:36.980` 使用手机蓝牙调试器；`02:54:47.820` 在调试器中创建项目。`T`
- `BV19qKizsEw4`：`p1 00:00:00.100` 展示物联网小项目；`p4 00:00:18.130` 说明从标准库项目迁移到 HAL 的比较价值；`p10 00:00:07.480` 开始连接 MQTT 服务器。`T`

### 3.4 无刷电机 FOC

| BVID / 主题 | 标题；UP主 | 日期；已核验时长/分P | 评分；Dummy V2 映射 | 商业筛选 |
|---|---|---|---|---|
| [BV19TSjB4EhV](https://www.bilibili.com/video/BV19TSjB4EhV/) | 从 1 开始学习 FOC；Reborn大侠 | 2025-11-28；已核验 p1-p3，p3 16:17 | 5；E2-E4，E7 前置知识 | 通过；工程仓库/资料公开，未见收费获客 |
| [BV1tmsbzgExE](https://www.bilibili.com/video/BV1tmsbzgExE/) | 开源项目讲解：STM32 无刷电机驱动；若忘即安- | 2025-10-22；21:46 | 4；E2-E4，MT6816/霍尔硬件理解 | 通过；开源项目分析，无作者导流 |
| [BV1RaNjzwEux](https://www.bilibili.com/video/BV1RaNjzwEux/) | 玩转 FOC 无刷电机系列：硬件介绍和六步换相；苏格拉底冇底 | 2025-06-18；20:38 | 4；E3-E4，六步换相作为前置理解 | 通过；画面为课程/PPT和代码分析，未见收费入口 |
| [BV1YiTb6dEED](https://www.bilibili.com/video/BV1YiTb6dEED/) | 开源 STM32G431 FOC 无刷电机：初始化；智能魔术师 | 2026-07-15；16:16 | 4；E2-E4，ADC/TIM/Hall/采样 | 通过；开源项目讲解，未见收费/群导流 |

证据：

- `BV19TSjB4EhV`：`p2 00:00:00.000` 为直流无刷电机基础；`p3 00:00:00.000` 进入克拉克变换和帕克变换；两页为本地视频章节/画面证据，p2/p3 无可用本地字幕。`D/V`
- `BV1tmsbzgExE`：`00:00:07.960` 明确主题为 STM32 无刷电机驱动；`00:18:28.300` 将传感器信号送入 MCU ADC；`00:20:44.460` 讲到霍尔编码器/传感器。`T`
- `BV1RaNjzwEux`：`00:00:30.000` 画面显示三相绕组、永磁体和电角度关系；`00:08:00.000` 画面显示六管桥臂和三相 A/B/C 接线；未把画面内容伪装成字幕口播。`V`
- `BV1YiTb6dEED`：`00:00:17.050` 讨论三相电流同步采集；`00:00:58.049` 说明定时器生成 PWM；`00:01:12.740` 进入 ADC 注入中断。`T`

### 3.5 CAN 总线教程 STM32

| BVID / 主题 | 标题；UP主 | 日期；已核验时长/分P | 评分；Dummy V2 映射 | 商业筛选 |
|---|---|---|---|---|
| [BV15b4y1Z7Tk](https://www.bilibili.com/video/BV15b4y1Z7Tk/) | STM32 CAN 总线收发实例；天涯倚剑 | 2021-05-30；已核验 p1 26:54、p2 34:09、p3 37:49 | 4；E6，CAN 收发基础 | 通过；三P技术实例，评论为调试讨论 |
| [BV1bz411e7RG](https://www.bilibili.com/video/BV1bz411e7RG/) | RoboMaster 电控教程：CAN 总线与电机；学长大人兼前辈 | 2020-06-21；68:48 | 4；E6，多电机寻址/报文 | 通过；GitHub 代码；年份较旧需核 HAL/API |
| [BV1sZ4y1y7o2](https://www.bilibili.com/video/BV1sZ4y1y7o2/) | STM32 零基础 CubeMX 配置和 CAN 通讯；夜莺_- | 2022-05-03；49:15 | 3；E0/E6，CubeMX 中断配置 | 通过；源码/配置讨论，无收费导流 |
| [BV1Z1421C7dP](https://www.bilibili.com/video/BV1Z1421C7dP/) | STM32F103 用 CAN 通讯驱动小米电机；小天在线学理工 | 2024-05-31；11:43；42,590 / 1,101 / 164 | 4；E6，扩展帧/电机控制帧 | 通过；作者评论有勘误和代码解释，未见收费获客 |

证据：

- `BV15b4y1Z7Tk`：`p1 00:00:09.220` 进入 CAN 基础；`p1 00:00:59.020` 说明 CAN 总线两根线；`p1 00:18:50.920` 区分数据帧/远程帧。p2/p3 下载但未将无字幕内容扩写为字幕事实。`T/D`
- `BV1bz411e7RG`：`00:30:00.000` 画面为 `CAN_cmd_chassis` 发送函数、ID 和 8 字节数据拆分；`00:55:00.000` 画面为 `HAL_CAN_GetRxMessage` 接收回调、ID 分派和调试窗口；视频无本地字幕。`V`
- `BV1sZ4y1y7o2`：`00:25:19.240` 配置 CAN 通信；`00:32:23.540` 使能 CAN 中断；`00:35:46.280` 修改中断优先级。`T`
- `BV1Z1421C7dP`：`00:01:16.910` 区分扩展帧和标准帧；`00:03:31.350` 将波特率设为 1 MHz；`00:08:49.560` 发送控制帧；`00:11:19.850` 画面/口播显示电机成功转动。视频同时明确 `00:11:23.290` 只有发送控制帧、没有接收应答，应作为局部示例而非完整双向 CAN 方案。`T`

### 3.6 FreeRTOS STM32

| BVID / 主题 | 标题；UP主 | 日期；时长；播放/赞/评 | 评分；Dummy V2 映射 | 商业筛选 |
|---|---|---|---|---|
| [BV1394y1h7ho](https://www.bilibili.com/video/BV1394y1h7ho/) | STM32 移植 FreeRTOS；小科不好奇 | 2023-10-01；07:28；62,976 / 1,227 / 291 | 4；E8，移植边界/中断 | 通过；评论为编译排错 |
| [BV1ku411t71m](https://www.bilibili.com/video/BV1ku411t71m/) | STM32F103C8T6 移植 FreeRTOS；深夜课堂-嵌入式编程 | 2023-05-17；09:16；19,720 / 277 / 63 | 3；E0/E8，平台迁移 | 通过；源码开源说明，无收费评论 |
| [BV1VG9ZYbEYQ](https://www.bilibili.com/video/BV1VG9ZYbEYQ/) | STM32 标准库移植 FreeRTOS；Sliuam | 2025-03-05；12:54；42,097 / 1,059 / 290 | 4；E8，标准库工程移植 | 通过；工程文件公开，未见售卖 |
| [BV1BMdzB1E57](https://www.bilibili.com/video/BV1BMdzB1E57/) | STM32 从零移植最新 FreeRTOS 与 LVGL；孢子有心任 | 2026-04-17；已核验 p1 10:59 | 4；E8，E13 可选 UI 参考 | 通过；Gitee 工程，未见收费获客 |

证据：

- `BV1394y1h7ho`：`00:01:09.540` 定位 port 文件夹；`00:03:53.060` 添加中断服务函数宏；`00:05:59.520` 完成任务创建。`T`
- `BV1ku411t71m`：`00:03:14.780` 将工程移植到 C8T6；`00:04:25.340` 进入任务内容；`00:06:03.640` 说明移植完成。`T`
- `BV1VG9ZYbEYQ`：`00:03:22.420` 完成工程文件迁移；`00:06:07.080` 添加中断定义；`00:08:48.820` 创建任务。`T`
- `BV1BMdzB1E57`：`00:00:07.850` 同时提出 FreeRTOS 和 LVGL 移植目标；`00:07:43.840` 找到 SVC 中断；`00:10:54.160` 说明 FreeRTOS 移植成功，随后 `00:10:56.740` 进入 LVGL。`T`

## 4. 六主题覆盖矩阵

| 主题 | A 入口 | 主要覆盖 | 对 Dummy V2 的直接价值 | 不能直接照搬的部分 |
|---|---:|---|---|---|
| STM32学习路线 | 2，缺口 2 | 基础、外设、项目顺序 | E0-E5 的学习入口选择 | 路线视频没有 Motor-42 的电流/反馈安全条件 |
| 嵌入式学习路线 | 3 个入口，2 个新来源，缺口 1 | 单片机、项目、Linux/职业背景 | 帮助识别暂时不需要的外围内容 | 薪资/岗位叙事不是实验验收标准 |
| STM32项目教程 | 4 | GPIO、PWM、UART、编码器、状态机、MQTT | E0-E5 的“先做可见实验”示例 | 智能家居网络项目不能替代裸电机闭环 |
| 无刷电机FOC | 4 | 电机结构、六步换相、ADC、PWM、Hall、Clarke/Park | E2-E4 的反馈、采样和闭环概念 | FOC 视频的电流限值、机械固定和板级引脚仍需本机确认 |
| CAN总线教程 STM32 | 4 | CAN 帧、滤波、CubeMX、收发、ID、底盘/电机报文 | E6 的双节点寻址和协议理解 | 老视频使用标准库/旧 HAL；`BV1Z1421C7dP` 只有发送示例 |
| FreeRTOS STM32 | 4 | port、SVC/PendSV/SysTick、任务创建、LVGL | E8 以后理解调度/平台迁移 | E0-E4 不应为了学习 RTOS 先重构整个固件 |

## 5. 共识与分歧

### 共识

- 不需要等所有理论课程完成才开始做项目；小项目是暴露知识缺口的工具。
- GPIO、时钟、定时器、PWM、ADC、串口和中断是 STM32 项目共同基础。
- 电机方向必须同时理解电机结构、功率桥、PWM、位置/电流反馈和采样时序，不能只看控制算法名词。
- CAN 学习应同时看物理/帧格式、过滤/仲裁、STM32 外设配置和真实代码收发。
- FreeRTOS 移植的关键不是“创建一个任务”本身，而是平台 port 文件、中断入口、时基和工程链接边界。

### 分歧或需保留判断

- 有些路线建议先系统学 C、模电/数电和 MCU；另一些建议直接从 STM32 小项目开始。Dummy V2 可把二者并列：E0/E1 只补当前编译、烧录、GPIO 所需知识，不把完整课程作为 E2 前置。
- 项目教程常把 HAL、CubeMX、标准库和通信网络混在一起；这对学习有帮助，但不能据此改变 Dummy V2 原固件的外设边界。
- FOC 系列中六步换相、FOC、编码器和电流环的深度不同；“看懂变换”不等于已经验证 Motor-42 的采样、相序和限流。
- CAN 示例可能只发送、不接收，或只面向 RoboMaster 电机协议；不能把一个能发帧的函数升级解释成 E6 双节点安全通信。
- FreeRTOS/LVGL 能作为 E8/E13 以后参考，但不应提前成为 E0-E4 的必要门槛。

## 6. Dummy V2 阶段映射

| 阶段 | 可复用的视频证据 | 采用边界 |
|---|---|---|
| E0 编译工程 | `BV1kun3zBEu1`、`BV1Rven6BEH8`、FreeRTOS 工程迁移视频 | 只借工程组织和编译排错，不先移植 RTOS |
| E1 烧录无运动程序 | 项目路线视频中的“先做可见小项目”共识 | 视频没有本板 SWD、FLASH_ONLY 和恢复验证证据，仍按本地方案执行 |
| E2 观察 MT6816/角度 | `BV1tmsbzgExE` 的 ADC/霍尔硬件、`BV1YiTb6dEED` 的 ADC 同步采样 | 视频只提供概念和画面，rawAngle、noMag、parity 必须本机测 |
| E3 校准 | FOC/无刷电机系列 | 校准电流和相线不能从视频默认值复制；必须有匹配板、电机、磁铁 |
| E4 一次有界闭环 | FOC 的采样、PWM、反馈概念；项目视频的有限状态机思路 | 视频没有 Dummy V2 的 ONE_SHOT 退出/断电判据；需保留本地安全约束 |
| E5 UART 控制 | `BV1Rven6BEH8` 的 UART/蓝牙项目；路线视频的项目优先原则 | 只能在 E4 成功后增加接收、授权、watchdog 和 STOP 行为 |
| E6 CAN 双节点 | `BV15b4y1Z7Tk`、`BV1bz411e7RG`、`BV1sZ4y1y7o2`、`BV1Z1421C7dP` | 需要重新定义 ID、超时、失联和电机侧安全；不能复制旧标准库代码即视为完成 |
| E7 单关节 | FOC 机械/反馈视频 | 视频没有 Dummy V2 夹具、负载、行程和断电实测 |
| E8 F405/REF | FreeRTOS 移植视频 | 仅作平台和调度知识参考，不代表 REF 工程已能直接移植 |
| E9-E12 | 路线视频中的远期 Linux/网络/多节点内容 | 暂不作为 E0-E4 前置；需先完成真实单电机闭环 |
| E13 ESP32/ROS/视觉 | 智能家居、LVGL、Linux 等外围视频 | 仅作可选扩展背景，不纳入当前复刻主线 |

## 7. B/C 降级与排除

### B：相关但不进入 A

- `BV1K6UCBREer`：路线内容较完整，但 `00:17:27.220` 明确承诺把学习文档放进网盘分享；按零资料引流标准降级。
- `BV1dPn2zZEec`：路线内容有价值，但 `00:08:34.249` 起要求从评论区“免费自取”整理文档，随后要求关注；属于资源磁铁。
- `BV1oz421m7Zb`：内容相关，但一级评论出现个人微信号，按严格导流规则排除。
- `BV1Wj5yznE3a`：热门评论含第三方兑换码/外部推广。
- `BV1JB4y1D7dB`：评论质疑内容与正点原子教程高度相似，独立性不足。
- `BV1mhWqzFEzn`、`BV1KchnzwEt9`：热门评论出现购买/工坊/交流群导流。
- `BV1Ki4y1U7em`、`BV1cQdnBeEeZ`：相关但过短或仅演示，不能稳定提供两条具体论据。

### C：明确商业化或不符合研究边界

- `BV1W44y1k729`：`00:01:55.990`、`00:02:02.860` 和 `00:05:13.189` 多次要求关注公众号并回复关键词获取路线图；标题还以“月薪 5k 到 5w”吸引点击。
- `BV1Df421X7oP`：简介明确售卖 KW407A 开发板；媒体保留但不作学习白名单。
- `BV1th411z7sn`、`BV1vu4y1F7Gt`、`BV1AZ4y1V7wt`、`BV1hv4y1g7s3`：账号/简介含套件、开发板、店铺或官方课程营销。
- `BV1GAMt6WEKs`、`BV1FxqoBpE1o`、`BV1wV3M6dEnV`、`BV1ZVJH6rEdq`、`BV18F411f7gM`：资料包、置顶领取、一对一辅导、就业/简历或课程获客信号。
- `BV1zrBLYyEgk`：评论出现“文档资料和简历指导等技术服务可以扫码订阅专栏”。
- `BV1dy4y1X7yx`、`BV1Ur4y1T7fG`：出现开源硬件、淘宝成品板或技术交流群销售导流。

## 8. 证据完整性和限制

- 20 个 A 入口中，18 个有可定位的本地字幕证据；`BV1RaNjzwEux` 和 `BV1bz411e7RG` 主要依靠本地视频画面核验。部分合集只下载了相关分P，因此不能把未下载分P当作已审查内容。
- AI 字幕存在“CAN/STM32/ADC”等术语识别错误，报告保留原始时间戳但避免把错误转写当作精确 API 名称；代码和画面优先。
- `BV1RaNjzwEux` 的视觉证据为 `00:00:30.000` 和 `00:08:00.000` 抽帧；`BV1bz411e7RG` 的视觉证据为 `00:30:00.000` 和 `00:55:00.000` 抽帧。它们是可复核画面位置，不是作者口播逐字稿。
- 播放、点赞、评论数是检索时 Bilibili 返回值，可能随时间变化；同一多P视频的父条目统计会在不同分P元数据中出现轻微差异。
- `BV1Z1421C7dP` 明确说明只有发送控制帧、没有接收应答；它适合 E6 报文理解，不足以证明闭环双向协议。
- 公开视频不能证明某个参数对 Motor-42 安全；电流、相序、磁铁安装、供电、夹具、断电和限位仍属于本机测量/实验条件。
- Gemini 批量分析因 HTTP 402 未完成，也没有用外部平台补偿；本报告不包含未经核验的 Gemini 结论。

## 9. 本地证据索引

- 检索计划和初筛：`deliverables/search-plan.md`
- A 候选 URL：`deliverables/a-candidate-urls-20260921.txt`
- 补充分P：`deliverables/supplemental-page-urls-20260921.txt`
- 视频、字幕、详情元数据：`videos/<BVID>/source.*`
- Dummy V2 阶段定义：`/home/lbz/Dummy-Robot/source/1.Dummy V2任同学整理/Dummy_V2项目驱动复刻方案_PBL版.md`
