MARS-ROBOTICS-star/Dummy-Robot-Reproduction/workspace/stm32-roadmap-video-evidence/deliverables/search-plan.md

# Bilibili STM32 Roadmap Search Plan

检索日期：2026-09-21

范围：仅 Bilibili；使用 Bilibili 搜索、视频详情和一级热门评论。未调用 Google、知乎或小红书。

## 固定主题

1. STM32学习路线
2. 嵌入式学习路线
3. STM32项目教程
4. 无刷电机FOC
5. CAN总线教程 STM32
6. FreeRTOS STM32

允许的紧密同义检索词：`嵌入式如何自学`、`嵌入式学习路线 个人经验 STM32`、`STM32 FOC 无刷电机 教程`、`STM32 CAN 总线 教程`、`FreeRTOS STM32 移植 实战 个人`、`STM32 FreeRTOS 任务 队列 信号量`。

## 下载前 A 候选

以下候选通过标题/简介/账号与一级热门评论初筛。开源仓库、个人文档和免费源码链接不单独视为商业导流；出现开发板/套件售卖、课程/培训、资料包获客、私信/QQ群/公众号导流或账号商业服务信号的候选不进入 A。

| 主题 | BVID | UP主 | 初筛依据 | 既有媒体 |
|---|---|---|---|---|
| STM32学习路线 | BV1ptpFzCEix | 电工水果子 | 个人学习复盘；简介无导流；评论主要讨论基础与项目取舍 | 是 |
| STM32学习路线 | BV1H4Lt6pENW | Expert电子实验室 | 个人路线分享；简介仅有公开博客文档 | 是 |
| STM32学习路线 | BV1K6UCBREer | 叶江航 | 个人学习路线；简介无商业链接 | 否 |
| STM32学习路线 | BV1dPn2zZEec | 指针游侠 | 个人路线整理；简介为空；评论为路线讨论 | 否 |
| 嵌入式学习路线 | BV1H4Lt6pENW | Expert电子实验室 | 与上组去重复用 | 是 |
| 嵌入式学习路线 | BV1Fw3ozBEaz | 嵌入式_小王在努力 | 个人自学经验；仅指向立创开源硬件平台及推荐博主 | 否 |
| 嵌入式学习路线 | BV1zu5e6NE9y | 诗的结尾255 | 明确标注个人观点；无资料、课程或购物导流 | 否 |
| 嵌入式学习路线 | BV1W44y1k729 | 科岩成果 | 学习路径与行业分析；详情/评论未见账号导流 | 否 |
| STM32项目教程 | BV1bUnKziED2 | 红茶oy3 | 个人冰箱模拟项目；GitHub 仓库；评论为代码与设计讨论 | 否 |
| STM32项目教程 | BV1kun3zBEu1 | Silver三维码 | 个人点灯项目移植流；GitHub 与网盘并列，未见收费/获客 | 否 |
| STM32项目教程 | BV1Rven6BEH8 | 电导不是韩导 | 项目章节、代码和调试讨论；公开图文资源；无收费信号 | 否 |
| STM32项目教程 | BV19qKizsEw4 | 壹知半解 | 多P完整物联网项目；简介为技术步骤和兼容性说明 | 否 |
| 无刷电机FOC | BV19TSjB4EhV | Reborn大侠 | FOC 系列，章节覆盖变换、PWM、编码器；工程仓库公开 | 否 |
| 无刷电机FOC | BV1tmsbzgExE | 若忘即安- | 开源项目原理图/驱动分析；评论为硬件问题讨论 | 否 |
| 无刷电机FOC | BV1RaNjzwEux | 苏格拉底冇底 | STM32 手敲代码、硬件与六步换相；评论集中于调试问题 | 否 |
| 无刷电机FOC | BV1YiTb6dEED | 智能魔术师 | STM32G431、ADC/TIM/Hall/电流环；公开项目讲解 | 否 |
| CAN总线教程 STM32 | BV15b4y1Z7Tk | 天涯倚剑 | 三P覆盖 CAN 理论、STM32 发送、接收；评论为总线调试 | 否 |
| CAN总线教程 STM32 | BV1bz411e7RG | 学长大人兼前辈 | RoboMaster CAN 与电机；GitHub 代码 | 否 |
| CAN总线教程 STM32 | BV1Z1421C7dP | 小天在线学理工 | STM32F103 驱动小米电机；代码与勘误在评论公开；未见作者收费/获客信号 | 否 |
| CAN总线教程 STM32 | BV1sZ4y1y7o2 | 夜莺_- | CubeMX/CAN 配置记录；评论为源码和配置问题 | 否 |
| FreeRTOS STM32 | BV1394y1h7ho | 小科不好奇 | STM32 移植 FreeRTOS；评论包含中断宏、时基和编译排错 | 否 |
| FreeRTOS STM32 | BV1ku411t71m | 深夜课堂-嵌入式编程 | F103C8T6 移植；简介称源码开源；无收费评论 | 否 |
| FreeRTOS STM32 | BV1VG9ZYbEYQ | Sliuam | 标准库移植，公开网盘工程文件；评论讨论 SysTick/PendSV | 否 |
| FreeRTOS STM32 | BV1BMdzB1E57 | 孢子有心任 | STM32 上移植最新 FreeRTOS/LVGL；Gitee 工程 | 否 |

## 明确排除或降级

- `BV1K6UCBREer`：正文承诺将学习文档放进网盘分享，二次正文核验后列 B。
- `BV1dPn2zZEec`：正文以“评论区免费自取”资料和关注作为结尾，二次正文核验后列 B。
- `BV1W44y1k729`：正文多次要求关注公众号并回复关键词获取路线图，二次正文核验后列 C。
- `BV1Df421X7oP`：简介写明 UP 主在售 KW407A 开发板，已有媒体保留但列 C。
- `BV1th411z7sn`、`BV1vu4y1F7Gt`、`BV1AZ4y1V7wt`、`BV1hv4y1g7s3`：账号/简介含套件、开发板、店铺或官方课程营销，列 C。
- `BV1GAMt6WEKs`、`BV1FxqoBpE1o`、`BV1wV3M6dEnV`、`BV1ZVJH6rEdq`、`BV18F411f7gM`：资料包、置顶评论领取、一对一辅导、就业/简历或课程获客信号，列 C。
- `BV1zrBLYyEgk`：热门评论出现“文档资料和简历指导等技术服务可以扫码订阅专栏”，列 C。
- `BV1mhWqzFEzn`、`BV1KchnzwEt9`：热门评论出现购买/工坊/交流群导流信号，列 B/C，不计 A。
- `BV1dy4y1X7yx`、`BV1Ur4y1T7fG`：账号/评论明确出现开源硬件、淘宝成品板或技术交流群销售导流，列 C。
- `BV1Wj5yznE3a`：内容相关性高，但热门评论含第三方兑换码/外部推广，列 B，不计 A。
- `BV1oz421m7Zb`：热门评论出现个人微信号，按严格导流规则列 B，不计 A。
- `BV1JB4y1D7dB`：评论质疑内容与正点原子教程高度相似，独立性不足，列 B。
- 仅演示或过短、无法覆盖两个具体论据的项目视频（例如 `BV1Ki4y1U7em`、`BV1cQdnBeEeZ`）列 B，不为满足数量下载。

## 证据处理

- 优先复用工作区已有平台字幕；新 A 候选只下载通过本计划初筛者。
- 下载后运行 `batch_extract.py`，复用已有成功结果，不覆盖既有媒体，不删除媒体。
- 每个 A 条目至少保留两条 `HH:MM:SS.mmm` 证据，标注口播、屏幕代码/波形或推断，并检查最后时间戳接近源时长。
