MARS-ROBOTICS-star/Dummy-Robot-Reproduction/workspace/stm32-roadmap-video-evidence/deliverables/zhihu-stm32-roadmap-review-20260921.md

# 知乎最终审查报告

仅使用本会话已核验的知乎回答正文。未修改 Dummy V2 项目源码，未使用其他平台内容。

## 判定标准

- **A**：正文技术充分，无公众号、网盘、课程、培训、付费咨询、资料领取、私信交流、商品链接、简历/面试/Offer 获客等信号。
- **B**：有参考价值，但正文过短、论证不足、年代/身份信息有限，或存在轻度内容推广。
- **C**：明确存在引流、商业获客、资料包、商品链接、咨询、公众号、网盘，或明确 AI 辅助生成。

Dummy V2 映射采用以下阶段：

- **S0**：C 语言、数字/模拟电路、CPU 基础
- **S1**：MCU 裸机、时钟、GPIO、中断、定时器
- **S2**：外设驱动、协议、寄存器、调试
- **S3**：RTOS、任务架构、状态机
- **S4**：Linux、驱动、应用、上位机
- **S5**：完整项目、软硬件联调、工程闭环
- **S6**：可靠性、异常恢复、性能与量产意识

## A 最终白名单

### 主题一：系统学习 STM32

1. **标题**：学 stm32，有什么学习方法？  
   **答主**：Kevin Zhang  
   **answer_id/URL**：`512230445`，https://www.zhihu.com/question/298288316/answer/512230445  
   **日期/互动**：编辑于 2018-10-17；288 赞同，19 评论  
   **论据**：强调项目驱动；覆盖串口、定时器、GPIO、中断、CPU 运行、SP/LR、异常压栈、数据手册、调试和竞赛实践。  
   **Dummy V2**：S0、S1、S2、S5  
   **评分**：4.5/5  
   **年代风险**：中高；HAL、工具链和就业建议需更新。  
   **无引流依据**：正文无商品、课程、公众号、网盘、咨询或私信获客。

2. **标题**：学 stm32，有什么学习方法？  
   **答主**：Silk Chen  
   **answer_id/URL**：`62662899737`，https://www.zhihu.com/question/298288316/answer/62662899737  
   **日期/互动**：编辑于 2026-03-07；240 赞同，48 评论  
   **论据**：提出用串口移植 mini shell，直接访问寄存器、读写地址空间、dump Flash/SRAM，并以 STM32F103 I2C 和 uC/OS-II 为例。  
   **Dummy V2**：S1、S2、S3、S6  
   **评分**：4.5/5  
   **年代风险**：低；但作者职业背景与嵌入式并不完全匹配。  
   **无引流依据**：正文无外部资源、商品、咨询或私信引流。

3. **标题**：学 stm32，有什么学习方法？  
   **答主**：知鱼之乐1004  
   **answer_id/URL**：`2002223602125263979`，https://www.zhihu.com/question/298288316/answer/2002223602125263979  
   **日期/互动**：编辑于 2026-03-09；29 赞同，0 评论  
   **论据**：从数字电路、CPU 原理、最小系统板、焊接和寄存器驱动开始；逐步覆盖 GPIO、I2C、SPI、UART、ADC、RTOS，并主张 HAL/LL 与寄存器结合。  
   **Dummy V2**：S0、S1、S2、S3、S5  
   **评分**：4.0/5  
   **年代风险**：低；部分“HAL 开销很大”等判断缺少量化依据。  
   **无引流依据**：正文无外部链接、课程、资料包或咨询信息。

**主题一真实 A 数量：3，缺口 1。**

### 主题二：系统学习嵌入式

4. **标题**：怎么系统自学嵌入式？  
   **答主**：若影  
   **answer_id/URL**：`3453807181`，https://www.zhihu.com/question/651089158/answer/3453807181  
   **日期/互动**：编辑于 2024-04-04；23 赞同，2 评论  
   **论据**：结合硬件转嵌入式软件经历，区分 MCU、Linux 应用和 Linux 驱动方向；建议先明确岗位，再按 C、单片机、RTOS/Linux、项目实践推进。  
   **Dummy V2**：S0、S1、S3、S4、S5  
   **评分**：4.5/5  
   **年代风险**：中；就业判断和岗位需求会变化。  
   **无引流依据**：正文无课程、培训、公众号、资料包、咨询或私信获客。

**主题二真实 A 数量：1，缺口 3。**

### 主题三：学完 STM32 后学什么

5. **标题**：学了 stm32 后，继续下去还应该学些什么？  
   **答主**：Rock Sun  
   **answer_id/URL**：`2062819432947251057`，https://www.zhihu.com/question/1947614581418599443/answer/2062819432947251057  
   **日期/互动**：发布于 2026-07-21；18 赞同，3 评论  
   **论据**：列出 BLDC/FOC、传感器/PLC、RF/WiFi/BLE/LoRa/ZigBee、FPGA 等方向，并强调方向选择应结合需求、实践和长期积累。  
   **Dummy V2**：S5、S6  
   **评分**：3.5/5  
   **年代风险**：低；内容偏方向罗列，缺少学习顺序和项目细节。  
   **无引流依据**：正文无商业或资源领取信号。

6. **标题**：自学嵌入式，能不能推荐个既成本低又能综合锻炼 STM32 编程能力的项目？  
   **答主**：善计者不以筹  
   **answer_id/URL**：`2448220703`，https://www.zhihu.com/question/528715584/answer/2448220703  
   **日期/互动**：编辑于 2025-04-11；32 赞同，7 评论  
   **论据**：推荐 STM32 VGA VT100 终端项目，覆盖 VGA 时序、SPI、定时器、DMA、PS/2、串口、协议解析、内存约束和裸机任务组织。  
   **Dummy V2**：S1、S2、S3、S5、S6  
   **评分**：5.0/5  
   **年代风险**：低；项目较难，不适合完全初学者。  
   **无引流依据**：正文虽提及 B 站演示，但未以其作为报告证据，且无课程、商品、咨询或资料领取。

7. **标题**：学会 STM32、RTOS、QT 后能找到工作吗？  
   **答主**：若安好则为明  
   **answer_id/URL**：`3100967321`，https://www.zhihu.com/question/609999432/answer/3100967321  
   **日期/互动**：发布于 2023-07-03；344 赞同，83 评论  
   **论据**：提醒“学过”不等于“学精”；建议先完成 STM32 理论和 HAL，再根据时间选择 LVGL/EmWin，避免同时铺开 STM32 小项目和 QT。  
   **Dummy V2**：S1、S2、S3、S5  
   **评分**：3.5/5  
   **年代风险**：中；路线建议依赖具体就业目标。  
   **无引流依据**：正文无公众号、课程、培训、咨询或资料领取。

**主题三真实 A 数量：3，缺口 1。**

### 主题四：HAL、标准库与寄存器

8. **标题**：stm32 学习标准库还是 HAL 库啊？  
   **答主**：游星空  
   **answer_id/URL**：`4183098598`，https://www.zhihu.com/question/739241361/answer/4183098598  
   **日期/互动**：发布于 2024-10-04；20 赞同，0 评论  
   **论据**：主张新项目优先 HAL/CubeMX；认为 HAL 的抽象并不阻碍底层学习，底层理解可以通过架构和寄存器继续建立。  
   **Dummy V2**：S1、S2、S5  
   **评分**：3.5/5  
   **年代风险**：低；表达较情绪化。  
   **无引流依据**：正文无外部资源或获客信息。

9. **标题**：stm32 学习标准库还是 HAL 库啊？  
   **答主**：小麦大叔  
   **answer_id/URL**：`4521131322`，https://www.zhihu.com/question/739241361/answer/4521131322  
   **日期/互动**：日期未在本次页面卡片中显示；25 赞同，0 评论  
   **论据**：区分寄存器、标准库和 HAL 的代码效率与开发效率；强调不能停留在 API 表面，遇到硬件问题仍需回到底层手册和寄存器。  
   **Dummy V2**：S1、S2、S5  
   **评分**：4.5/5  
   **年代风险**：中；日期缺失。  
   **无引流依据**：正文无商品、课程、公众号、咨询或资料包。

10. **标题**：stm32 学习标准库还是 HAL 库啊？  
    **答主**：老侃硬件  
    **answer_id/URL**：`1996577346627592562`，https://www.zhihu.com/question/739241361/answer/1996577346627592562  
    **日期/互动**：日期未在本次页面卡片中显示；15 赞同，0 评论  
    **论据**：指出标准库适合老项目和理解外设机制，新项目应转向 HAL/LL；强调时钟、GPIO、USART、NVIC、结构体映射和寄存器思维的迁移价值。  
    **Dummy V2**：S1、S2、S6  
    **评分**：4.5/5  
    **年代风险**：中；日期缺失。  
    **无引流依据**：正文无商品、课程、公众号、咨询或资料领取。

11. **标题**：stm32 入门建议跳过固件库去学习 HAL 库吗？  
    **答主**：Nephalem  
    **answer_id/URL**：`3032793773`，https://www.zhihu.com/question/477505551/answer/3032793773  
    **日期/互动**：发布于 2023-05-18；20 赞同，1 评论  
    **论据**：建议产品开发使用 CubeMX/HAL，理解架构时使用寄存器；认为 HAL、LL、寄存器应按目标和性能需求组合。  
    **Dummy V2**：S1、S2、S5  
    **评分**：4.0/5  
    **年代风险**：中；需结合具体芯片系列验证。  
    **无引流依据**：正文无商业、课程或资源领取信号。

**主题四真实 A 数量：4，达到目标。**

### 主题五：从教程到独立项目能力

12. **标题**：stm32 学了一年了，但是还是不能自己独立写代码，基本都要看资料才能写出来，怎么办？  
    **答主**：老侃硬件  
    **answer_id/URL**：`2047983977533903446`，https://www.zhihu.com/question/1955747472149316544/answer/2047983977533903446  
    **日期/互动**：2026-07-28 更新；17 赞同，1 评论  
    **论据**：按 C 语言、MCU 概念、STM32 平台、工程架构分层；建议空工程重写、默写与改写、驱动/应用分层，并完成 UART、PWM/ADC、I2C 等闭环项目。  
    **Dummy V2**：S0、S1、S2、S3、S5、S6  
    **评分**：5.0/5  
    **年代风险**：低；内容较新。  
    **无引流依据**：正文没有课程、商品、咨询或资料领取。

13. **标题**：有哪些相见恨晚的 STM32 学习的方法？  
    **答主**：wjjj  
    **answer_id/URL**：`115442835387`，https://www.zhihu.com/question/332300063/answer/115442835387  
    **日期/互动**：发布于 2025-03-03；18 赞同，1 评论  
    **论据**：建议先做小功能，再逐个攻克外设；通过调试器、寄存器状态、时钟和例程改写建立独立开发能力。  
    **Dummy V2**：S1、S2、S5、S6  
    **评分**：3.5/5  
    **年代风险**：低；部分表达偏鼓励性，系统性有限。  
    **无引流依据**：正文无公众号、课程、商品、咨询或资料领取。

**主题五交叉来源**：第 6 条“善计者不以筹”同时支撑本主题，已在总数中只计一次。

**主题五真实 A 数量：3，缺口 1。**

## 覆盖矩阵

| 主题 | A 数量 | A 来源 | B 数量 | C 重点来源 | 缺口 |
|---|---:|---|---:|---|---:|
| 系统学习 STM32 | 3 | Kevin Zhang、Silk Chen、知鱼之乐1004 | 0 | 编码书生、为霜 | 1 |
| 系统学习嵌入式 | 1 | 若影 | 2 | 大川搬砖、张本庸robotics、victor | 3 |
| 学完 STM32 后学什么 | 3 | Rock Sun、善计者不以筹、若安好则为明 | 2 | CodeAllen、工科老生-陈 | 1 |
| HAL/寄存器 | 4 | 游星空、小麦大叔、老侃硬件、Nephalem | 3 | zsky | 0 |
| 项目与独立开发 | 3 | 老侃硬件、wjjj、善计者不以筹 | 5 | 嵌入式基地、华清远见、小康 | 1 |

**A 白名单去重总数：13 篇。**  
同一回答 `2448220703` 在主题三和主题五重复出现，但总数只计一次。老侃硬件的两个回答主题不同，内容不属于高度重复，因此分别保留。

## B 可参考但不计入高质量

| 回答 | 原因 |
|---|---|
| `1952417705102669579` 陌欢醉 | 方向判断正确，但正文过短，仅列项目、控制理论和上位机。 |
| `3337339210` ggboy | 讨论了 MCU、RTOS、Linux 和行业差异，但后半主要是就业市场评论，学习路线不够集中。 |
| `1979470334886440962` snowdream | RTOS 先于 Linux 的条件性判断有价值，但页面带专栏订阅信息，且本次未显示回答日期。 |
| `2001009627559663422` yepman | HAL 与 C 库类比有启发，但正文很短、论断过于绝对。 |
| `3375482284` Yeah He | 技术要点基本合理，但页面明确标注“包含 AI 辅助创作”，不进入 A。 |
| `2236526094` Grayson Zheng | 玩具车项目有实践价值，但正文只有极简项目建议，论据不足。 |
| `2397609866` 月关吖 | 强调从需求、硬件、焊接到代码的完整过程，但内容较短。 |
| `2054654862273655510` 嵌入式日常分享 | 系统链路、状态机、异常恢复观点较好，但有“点关注，不迷路”信号，且互动证据弱。 |

## C 明确排除

| 回答 | 赞同/评论 | 排除依据 |
|---|---:|---|
| `102047468` 编码书生 | 1042/58 | 正文出现“私信发给你”，并提及代做毕业设计。虽技术充分，仍排除。 |
| `1440111178` 为霜 | 67/5 | 提供百度网盘链接和提取密码。 |
| `1834680462` 大川搬砖 | 321/67 | 京东商品链接、商品广告、付费咨询和“去咨询”。 |
| `3071017542` 张本庸robotics | 15/0 | “参考资料附在最后可以自取”，且作者提供就业/技术咨询。 |
| `2913294855` victor | 17/11 | 作者明确标注微信公众号。 |
| `2895012364` CodeAllen嵌入式 | 20/0 | 公众号同名、职业规划获客、导流到其他文章。 |
| `1998709297337620455` 小智学长 | 16/3 | 明确提供完整学习资料包、公众号和视频教程导流。 |
| `2078445896342180393` 金橙智能 | 1/0 | 机构账号，含学员就业、培训和人才培养宣传；页面还标注知乎直答生成内容。 |
| `18665478613` 华清远见研发中心 | 1/0 | 培训机构、开发板、课程资料、项目资料和“需要资料找我”。 |
| `2200813694` 嵌入式基地 | 96/2 | 公众号、百度网盘资料包和提取密码。 |
| `2621270421` 嵌入式研发基地 | 0/0 | “看我主页，薇我”，明确私信获客。 |
| `2045952514336597770` 科技数码龙 | 0/0 | “代码模板可以公众号私信我”。 |
| `2042276642073077350` xiaokang | 16/0 | 明确销售 C++ 项目课程、微信咨询和打包购买优惠。 |
| `119495868037` FPGA SIR | 2/0 | 页面明确标注“内容疑似 AI 生成”，且含明显求职资源包和薪资宣传。 |
| `2901706736` zsky | 9/0 | 公众号和微信文章外链。 |
| `1929470334886440962` snowdream | 互动信息未完整显示 | 页面出现咨询次数、评分和“去咨询”，属于付费咨询获客。 |

## 共识与分歧

### 项目优先还是底层优先

- **共识**：不能只看教程或只跑例程；需要 C/硬件基础、外设理解、实际项目和调试循环。
- **项目优先观点**：Kevin、若影、若安好强调尽早做项目、参加竞赛或结合岗位实践。
- **底层优先观点**：Silk、知鱼、小麦、老侃强调寄存器、时钟、手册和硬件机制。
- **Dummy V2 建议**：采用“底层知识驱动的小项目”，而不是在两者之间二选一。

### HAL 与寄存器

- **共识**：HAL/LL 适合提高开发效率，寄存器和参考手册用于理解、调试和性能关键路径。
- **HAL 优先**：游星空、Nephalem 更支持直接使用 HAL/CubeMX。
- **混合路线**：小麦、老侃主张 HAL/LL 与寄存器思维并行。
- **寄存器强优先**：知鱼明显反对只停留在 HAL，但其关于性能差异的部分说法缺少实测证据。

### RTOS 与 Linux 时机

- 没有统一顺序。
- 学习时间充足、目标为 MCU 系统开发时，FreeRTOS 先行更自然。
- 已有 Linux 项目机会时，可以直接进入 Linux。
- 以求职为目标时，若影认为单片机项目能力达到岗位要求后即可先入行，再补 RTOS/Linux。
- 真正决定顺序的是目标岗位、项目机会和已有硬件基础。

### 从教程到独立开发

- **共识**：例程只能作为脚手架，必须经历空工程重写、修改、抽象、文档化和故障复盘。
- 老侃给出的“跟敲、脱离参考重写、驱动与应用分层”最接近可执行训练法。
- 善计者的 VGA/VT100 项目体现了从外设调用到系统设计的跨越。
- 独立开发不等于永远不查手册；工业实践仍然需要查芯片手册、官方例程和既有工程。

### 调试与软硬件联调

- 需要掌握时钟、寄存器、标志位、中断、DMA、串口和异常路径。
- Kevin强调 SP/LR、异常压栈和调试器。
- Silk强调通过 mini shell 暴露地址空间。
- 善计者强调严格时序、协议、内存约束和任务组织。
- 老侃进一步将能力提升到状态机、驱动/应用分层、README、异常恢复和长期运行验证。

**最终结论**：本次严格筛选后，知乎正文中只有 13 篇可进入 A，主题二和主题五存在明显来源缺口，不能用高赞但带有商业或引流信号的回答凑数。
