MARS-ROBOTICS-star/Dummy-Robot-Reproduction/source/1.Dummy V2任同学整理/6.Docs/复刻审计_2026-09-06/PBL路线复核补充.md

# PBL 路线复核补充：Motor-42 本地实验是否可行

日期：2026-09-06。本文是针对新学习路线的定点源码复核，不是重新宣称整个工程已经完成运行验证。

配套主文档：[Dummy V2 项目驱动复刻方案：PBL 版](../../Dummy_V2项目驱动复刻方案_PBL版.md)。原审计结论继续保留；本次改变的是启用某功能之前的依赖关系，不是删除风险。

## 1. 结论

**可以先做 TX-only 编码器观察，再做板上触发的有限次本地闭环，最后才做双向 UART 控制。** 电机位置环可直接通过 C++ 方法调用，不依赖 UART、CAN、REF 或 Python 实时下发目标。

前提是实验固件真正不启动外部命令接收和原有按键动作，而不是只在文档上说“不发送命令”。首次校准本身就会产生力矩并转轴；最基本的固定、断电、匹配电流和当前反馈有效性要求必须在校准前生效。

本轮只制作路线与实验固件改造规格，**未创建或测试可下载的 `motor42_lab` 固件，未安装 ARM 工具链、未烧录、未通电**。不能把文中的新命令、诊断字段或实验阶段名称当成仓库已经实现的功能。

## 2. 重新核对的事实

所有路径相对项目根目录。标记：**证**＝文件中可直接确认；**设**＝本次实验设计选择；**测**＝必须由本机实测确定。

| 编号 | 证据与结论 | 对新路线的影响 |
|---|---|---|
| P01 | **证**：`2.Firmware/dummy-42motor-fw/CMakeLists.txt:4-19,75-90` 指定 CMake 3.20、Arm GCC、C++17 和 ELF→HEX/BIN | E0 只构建 Motor-42，不要求先构建 REF、35 和 ESP32 |
| P02 | **证**：`Core/Src/main.c:92-104` 在应用 Main 前初始化 UART、CAN、SPI、Timer；`Core/Src/usart.c:60-65` 已启用 IDLE、绑定 OnUartCmd 并启动 RX DMA | 仅从应用 Main 删除命令调用不够；lab 必须在外设初始化中取消 RX/IDLE/命令绑定，并跳过 CAN 启动路径 |
| P03 | **证**：`Core/Src/usart.c:49-55,84-98` 为 115200、8N1，PB6 TX、PB7 RX；RX DMA 配置是 `DMA_NORMAL`，不是循环 DMA | E2 可以只接板 TX→适配器 RX 和 GND；DMA/分帧学习留到 E5，不沿用子报告“循环 DMA”的说法 |
| P04 | **证**：`Ctrl/Sensor/Encoder/encoder_base.h:10-23` 的 public angleData 含 rawAngle/rectifiedAngle/rectifyValid，RESOLUTION=16384 | E2 直接观察 rawAngle；校准表无效不妨碍原始角度实验，不能反向要求先校准才看原始值 |
| P05 | **证**：`Ctrl/Sensor/Encoder/mt6816_base.h:22-36` 的 spiRawData、noMagFlag、checksumFlag 为 private；`.cpp:25-56` 有三次 parity 尝试，失败仍使用旧 rawAngle | 需要很小的只读诊断接口；不能在 UserApp 直接访问私有字段。坏帧要明确显示，运动时不得把旧角度视为新有效样本 |
| P06 | **证**：`Port/mt6816_stm32.cpp:9-17` 使用 HAL_MAX_DELAY 且不检查 HAL 返回值；`Ctrl/Motor/motor.cpp:7-13` 和校准器均自行读编码器 | E2 无力矩时可先定位 SPI；E3/E4 前加最小有界传输/状态返回。健康检查必须覆盖运动和校准实际使用的那一次采样，不先检查一次后又用未经检查的第二次采样 |
| P07 | **证**：`UserApp/main.cpp:30-70` 的 EEPROM 加载早于应用参数，默认运行 1000 mA、校准 2000 mA；速度和加速度也另行加载 | lab 在加载后、驱动使能前覆盖本次 RAM 限制，不必先重构 EEPROM。保留已有校准/零偏，不把“改默认值”当成改掉实际参数 |
| P08 | **证**：`UserApp/main.cpp:96-97,168-184` 的开机组合按键/长按/短按可能触发校准或切模式 | E1～E4 停用原按键动作；只允许当前实验阶段的一次性本地按键触发。无需因此先实现完整串口 ARM/DISARM |
| P09 | **证**：`Ctrl/Sensor/Encoder/encoder_calibrator_base.cpp:134-232` 直接调用 SetFocCurrentVector，并走预备、正转采样、回退消隙、反转采样 | E3 是首次可能主动运动，不是“全程静止准备”。校准不经过正常位置规划器，降低 ratedVelocity 不会降低校准速度 |
| P10 | **证**：校准器头文件 `:9-12` 为 200 整步、每步 16 点、粗步进 2、细步进 1；实现中有 `goPosition == ...` 的状态切换 | 首轮保留已知状态机/采样节拍，不任意改步进常数。要改慢须核对整除、状态切换和采样条件，不套 E4 的低速值 |
| P11 | **证**：校准器 `.cpp:256-382` 在主循环计算和写 Flash，成功后自动 HAL_NVIC_SystemReset，失败设置无效并清表；state/errorCode 在头文件为 private | 显示状态需只读 getter；校准重启后仍等待新按键，禁止开机自动再次校准/运动；保留或重做校准必须明确选择 |
| P12 | **证**：`Ctrl/Motor/motor.cpp:29-58,555-583` 在 Init 后位置先归零，再由首次控制 tick 初始化真实位置；GetPosition 在 `:471-478` 返回扣除零偏后的转数 | q0 要在校准有效、STOP tick 已初始化且轴静止后抓取；不能在 Init 后立即把返回的 0 当当前位置 |
| P13 | **证**：`motor.cpp:415-430` 的 SetCtrlMode 只改 requestMode；SetPositionSetPoint 接受整数计数并加 encoderHomeOffset | q0=GetPosition(false) 的转数要乘 51200 后取整再设目标；不能把度/原始 14-bit 数或已经加过偏置的内部位置直接混用 |
| P14 | **证**：`motor.cpp:311-317` 的 STATE_FINISH 只检查软规划目标/速度，未检查实际位置误差 | E4 去程/返程要检查反馈误差、速度和短暂稳定时间，不以 FINISH 一个标志作为成功 |
| P15 | **证**：`Ctrl/Driver/tb67h450_base.cpp:56-65` 的 Sleep 置两相参考为 0、输入为 false；`motor.cpp:96-118` 控制路径仍可能更新输出 | DONE/ABORT 必须持续阻止后续输出，不是调用一次 Sleep 后继续原运动 tick；这可以是实验局部布尔锁，不要求完整产品故障框架 |
| P16 | **证**：`Port/Platform/retarget.c:32-38` 的 printf 底层是 HAL_MAX_DELAY 的同步发送；TIM2 在 `Core/Src/tim.c:104-118` 初始化后以零比较值启动 PWM | E2 低频、主循环输出整数即可。E3/E4 的动作计时和退出不能依赖 printf 返回；不是“必须先做 UART TX DMA” |
| P17 | **证**：`STM32F103CBTx_FLASH.ld:62-65` 仍定义 128 KiB；`Port/Platform/Memory/stockpile_config.h:82-89` 校准起点 0x08017C00 | 保留一次简单的应用加载区检查/95 KiB 上限，防止 lab 覆盖校准；双槽、迁移和断电事务不是 E4 前置 |

上表中未写完整前缀的电机路径均位于 `2.Firmware/dummy-42motor-fw/`。REF 的 STOP、活动轴、IMU 启动和几何冲突已再次对照当前 `UserApp/main.cpp`、`Robot/instances/dummy_robot.cpp` 与原始 V2 参数图；分配到 E8～E11，而非 E2～E4。

## 3. 最小实验与完整工程保护的界线

| 不变的风险事实 | E2～E4 的缩小实验范围办法 | 重新启用功能时要补的工作 |
|---|---|---|
| 原 UART 解析不可靠 | TX-only，适配器 TX 不接板 RX，固件不启动 RX DMA/IDLE/旧解析 | E5 实现有界命令、STOP 和通信存活策略 |
| 原 CAN 校验/发送故障路径有问题 | 不连接总线，lab 不启动 CAN 路径 | E6 实现电机/测试主机侧校验；REF 侧到 E8 |
| 普通命令没有通用失联停止 | E4 不使用外部运动命令，固定一次动作并设本地最大执行时长 | E5 UART 失联，E6 CAN 失联；不能让查询或重连自动续跑 |
| 编码器失效仍可能输出 | 不能绕开；加同次采样有效性检查、异常即终止本次动作 | 后续再加诊断码、恢复策略、系统级传播 |
| 软件卡死可能保持输出 | 有人看守、固定裸电机、低电流、物理断 24 V；本地超时和有界 SPI 处理正常故障 | 上负载/长时运行前扩展到硬件 watchdog、异常路径和实测停机时间 |
| 原校准按键/自动复位 | 替换本地触发；重启后不自动重放 | 后期维护权限和 Flash 恢复流程 |
| 图纸/BOM/参数冲突 | 裸电机不使用六轴几何和减速器 | E7 解决所选关节，E9 全部冻结，E11 实测核对 |

本地最大执行时长不是通信 watchdog，软件超时也不能覆盖 CPU 完全卡死。这个残余风险没有被隐瞒，而是限定在有人看守、无负载、不接网络的实验边界内；不把这个豁免带到机械关节或整机。

## 4. 哪些数值不是已验证参数

**证**：源码给出的是默认 1 A 运行/2 A 校准，以及 30 转/秒和 100 转/秒²等默认值，不是通用低能量实验参数。

**设**：E4 可从 Δ=256 内部计数（0.005 圈、1.8°）、v=1024 计数/秒（0.02 圈/秒）、a=5120 计数/秒²（0.1 圈/秒²）规划首轮试验；每段设置有限超时，结束后 Sleep。这些是待本机验证的实验设定，不是仓库已经测试通过的性能参数。

**测**：I_RUN_mA、I_CALI_mA、电源限流、允许持续时间、反馈误差阈值、实际时序与温升，仍需依据 A 板/电机匹配资料和实际表现填写。不能因为“42 电机常用 1 A”就拿默认值运行，也不需要为填写这几项先完成六轴 BOM。

## 5. 本次限制

工具存在性复核仍未在 PATH 发现 `cmake` 或 `arm-none-eabi-gcc`。本轮没有构建 lab 固件，也没有验证任何低电流、校准时间或误差阈值。所有执行步骤中的新字段/阶段/协议均明确标为待实现；对现有源码的结论与对新实验的建议分开记录。
