MARS-ROBOTICS-star/Dummy-Robot-Reproduction/source/1.Dummy V2任同学整理/6.Docs/复刻审计_2026-09-06/实施记录模板.md

# Dummy V2 复刻实施记录模板

日期：2026-09-06。以下都是待填写记录，不是已经完成的试验结果。

## 1. 版本冻结单

| 字段 | 待填内容 |
|---|---|
| 实验编号 / 日期 / 操作者 | |
| 目标阶段 / 关联验收用例 | |
| 源码目录 / 自建版本号 / 源码快照哈希 | |
| 本次修改列表 / 原因 / 回退方法 | |
| 编译器、CMake、构建类型、编译参数 | |
| ELF / HEX / BIN 路径及 SHA-256 | |
| 程序实际占用 / 链接区间 / 校准和参数保留区 | |
| 板号 / PCB 版本 / 芯片丝印 / 制造批次 | |
| 电机型号 / 相电流定义 / 电阻 / 电感 / 步距角 | |
| 编码器磁铁型号 / 磁化方向 / 固定方式 / 间隙 | |
| 调试器 / 电源 / 仪表编号 | |
| 供电设置 / 电源限流 / 固件限流 / 校准电流 | |
| EEPROM 实际值 / 表版本 / 备份哈希 | |
| 上电默认模式 / 使能状态 / 故障状态 | |
| 当前 CAN ID / 物理拨码 / EEPROM 来源 | |
| 掉线策略 / 超时阈值 / 人工复位条件 | |
| 原始资料与本次硬件差异 | |
| 允许执行的命令白名单 | |

## 2. 线束逐针核验单

不得只填“同向线”或“反向线”。接口正视方向、锁扣朝向和 Pin 1 必须与照片一致；不能根据线色猜测网络。

| 线束编号 | A 端板号/接口/观察方向 | A Pin | A 网络 | B 端板号/接口/观察方向 | B Pin | B 网络 | 通断/阻值 | 相邻针绝缘 | 复核人 |
|---|---|---:|---|---|---:|---|---|---|---|
| | | 1 | | | | | | | |
| | | 2 | | | | | | | |
| | | 3 | | | | | | | |
| | | 4 | | | | | | | |
| | | 5 | | | | | | | |
| | | 6 | | | | | | | |

| 系统级检查 | 结果 |
|---|---|
| 所有板卡和外部电源断电、放电完毕 | |
| 每条线缆 24 V/GND/CAN_H/CAN_L 与目标板网络一一对应 | |
| 调试接口与功率/CAN接口有明显防误插标识 | |
| 两根并联供电导体实际均导通，端子额定电流已核对 | |
| CAN 总线终端位置，仅物理两端安装终端 | |
| 断电测 CAN_H-CAN_L，约 60 ohm 仅作为两只 120 ohm 并联的预期值 | |
| 支线长度、屏蔽/地参考、总线拓扑已记录 | |

## 3. 首板上电记录

预期电压、可接受静态阻值和电流上限，须先从选定板的原理图、器件数据手册及已知良好板确定；不使用统一的“万能安全电流”。

| 步骤 | 预期或批准范围 | 实测值 | 是否通过 / 异常处理 |
|---|---|---|---|
| 外观、焊桥、极性、芯片 Pin 1、连接器焊点 | | | |
| 24 V-GND 静态阻值 / 电容充电趋势 | | | |
| 各逻辑电源轨-GND 静态阻值 | | | |
| 电机断开，功率输出保持禁用 | | | |
| 输入电压 / 限流设置 / 实际输入电流 | | | |
| 第一降压输出 | | | |
| 3.3 V 逻辑电源 | | | |
| 关键芯片表面温度 / 环境温度 / 测温位置 | | | |
| SWD 读芯片 ID 与 Flash 容量 | | | |
| UART 3.3 V 电平 / 115200 8N1 | | | |
| 编码器原始角度 / 有效性 / 错误计数 | | | |
| 物理断电动作，断电后机构不坠落 | | | |

## 4. 六轴参数冻结表

`r_total = 电机轴转数 / 关节输出转数`，同步带级按从动轮齿数除以主动轮齿数计算。不得将 STEP 产品名称计数当成装配实例数量。

| 轴 | CAD 版本/零件号 | 电机/板号 | 减速器完整型号 | 各级主动/从动齿数 | 推导总比 | 实测总比 | 电机方向符号 | 编码器零/机械零/软件零 | 物理行程/线束行程 | 软件限位 | 当前固件值 | 冻结状态 |
|---|---|---|---|---|---:|---:|---:|---|---|---|---|---|
| J1 | | | | | | | | | | | | 待定 |
| J2 | | | | | | | | | | | | 待定 |
| J3 | | | | | | | | | | | | 待定 |
| J4 | | | | | | | | | | | | 待定 |
| J5 | | | | | | | | | | | | 待定 |
| J6 | | | | | | | | | | | | 待定 |

输出侧至少用可追溯角度基准或独立量具核验。电机侧编码器无法直接证明输出侧回差、柔顺性或绝对定位精度。

## 5. 制造与采购放行单

| 项目 | 待填内容 |
|---|---|
| 零件号 / 板号 / 适用轴 / 版本 | |
| 原始文件路径 / 文件哈希 / 供应商文件版本 | |
| 装机净用量 / 样件量 / 备件量 / 最小订购量 | |
| 材料 / 表面处理 / 工艺 / 关键公差 / 检验基准 | |
| PCB 层数 / 板厚 / 铜厚 / 阻焊 / 表面处理 | |
| 元件完整 MPN / 封装 / 耐压 / 功率 / DNP | |
| Gerber / 钻孔 / 板框 / BOM / CPL / 钢网 一致性 | |
| 正反面贴装、旋转、Pin 1 和坐标原点审查 | |
| 商家书面确认项 / 不允许替代项 | |
| 单价 / 起步费 / 运费 / 税费 / 交期 / 售后 | |
| 进料检验方法 / 不合格退换标准 | |
| 所属预算批次 / 是否重复计入旧购资产 | |
| 放行前置 Gate / 当前结果 / 批准日期 | |

## 6. 实验日志

推荐 CSV 字段如下。未配置电流或温度测量时写 `NA`，不可用命令值冒充测量值。

```csv
time_ms,test_id,board_id,mode,enabled,target_count,position_count,velocity_count_s,current_command_mA,input_current_A,raw_angle,rectified_angle,encoder_valid,encoder_error_count,command_age_ms,can_error_count,fault,ambient_C,motor_surface_C,driver_surface_C
```

| 复盘字段 | 内容 |
|---|---|
| 现象 | |
| 可证伪假设 | |
| 唯一改变的变量 | |
| 预期结果 | |
| 实际结果与原始日志路径 | |
| 是否推翻假设 | |
| 当前结论 / 未决项 | |
| 回退方式 / 回归测试 | |

## 7. 阶段验收签署

| 用例编号 | 前置条件 | 激励/故障注入 | 合格标准 | 实测结果与日志 | 结论 | 日期 |
|---|---|---|---|---|---|---|
| | | | | | 未执行 | |

任何未执行项都不能填“默认通过”。上位机返回 `ok`、LED 常亮、一次运行正常，都不能替代明确的反馈、故障与冷启动验收。
