MARS-ROBOTICS-star/Dummy-Robot-Reproduction/source/1.Dummy V2任同学整理/6.Docs/复刻审计_2026-09-06/extracted/6.Docs__Pins definations.pdf.txt

REF board Pins definations

42 board Pins definations

35 board Pins definations
