MARS-ROBOTICS-star/Dummy-Robot-Reproduction/source/1.Dummy V2任同学整理/6.Docs/复刻审计_2026-09-06/extracted/6.Docs__芯片说明__OLED 13H.pdf.txt

                          Product Specification

              Part Name:         OEL Display Module
              Customer Part ID:
              Wisevision Part ID: X077-6428TSWCG01-H13
              Ver: A

               Customer:
                Approved by

               From: Wisevision Optronics Co.,Ltd.
                Approved by

                               Wisevision Optronics Co.,Ltd.

Notes:
  1. Please contact Wisevision Optronics Co.,Ltd. before assigning your product based on this module
     specification
  2. The information contained herein is presented merely to indicate the characteristics and performance of
     our products. No responsibility is assumed by Wisevision Optronics Co.,Ltd. for any intellectual property
     claims or other problems that may result from application based on the module described herein.

                    Wisevision Optronics Co.,Ltd.                        Ver:A

Revised History

      Part Number        Revision         Revision Content   Revised on
  X077-6428TSWCG01-H13      A       New                       20220609

                                                                             i

                        Wisevision Optronics Co.,Ltd.          Ver:A

Contents
Revision History
Contents
1. Basic Specifications
   1.1 Display Specifications
   1.2 Mechanical Specifications
   1.3 Active Area / Memory Mapping & Pixel Construction
   1.4 Mechanical Drawing
   1.5 Pin Definition
2. Absolute Maximum Ratings
3. Optics & Electrical Characteristics
   3.1 Optics Characteristics
   3.2 DC Characteristics
   3.3 AC Characteristics
       3.3.1 Serial Interface Characteristics (4-wire SPI)
       3.3.2 I2C Interface Characteristics
4. Functional Specification
   4.1 Commands
   4.2 Power down and Power up Sequence
       4.2.1 Power up Sequence
       4.2.2 Power down Sequence
   4.3 Reset Circuit
   4.4 Actual Application Example
       4.4.1 VPP Supplied Externally
5. Reliability
   5.1 Contents of Reliability Tests
   5.2 Failure Check Standard
6. Outgoing Quality Control Specifications
   6.1 Environment Required
   6.2 Sampling Plan
   6.3 Criteria & Acceptable Quality Level
       6.3.1 Cosmetic Check (Display Off) in Non-Active Area
       6.3.2 Cosmetic Check (Display Off) in Active Area
       6.3.3 Pattern Check (Display On) in Active Area
7. Package Specifications
8. Precautions When Using These OEL Display Modules
   8.1 Handling Precautions
   8.2 Storage Precautions
   8.3 Designing Precautions
   8.4 Precautions when disposing of the OEL display modules
   8.5 Other Precautions
Warranty
Notice

                                                                   ii

                      Wisevision Optronics Co.,Ltd.                                     Ver:A

1. Basic Specifications

  1.1 Display Specifications
      1)   Display Mode:       Passive Matrix
      2)   Display Color:      Monochrome (White)
      3)   Drive Duty:         1/128 Duty

  1.2 Mechanical Specifications
      1)   Outline Drawing:    According to the annexed outline drawing
      2)   Number of Pixels:   64  128
      3)   Panel Size:         12.13  23.6  1.22 (mm)
      4)   Active Area:        9.26  17.26 (mm)
      5)   Pixel Pitch:        0.135  0.145 (mm)
      6)   Pixel Size:         0.115  0.125 (mm)
      7)   Weight:             TBD

  1.3 Active Area / Memory Mapping & Pixel Construction

                                                                     0.135
                                                                     0.115

                                                                                0.125
                                                                                0.145

                                                                          Dots detail
                     Com & Seg layout                                     scale 10x

                                                                                                                                                                                                                                                                                                                    Item         Date                Remark
                                                                                                                                                                                                                                                                                                                      A        20220521          Original Drawing               1.4

                                                                                                                   12.13±0.2(Panel)
                                                                                                                   11.63±0.2(POL)                                                                       0.25±0.2
                                                                                                                      10.26(V.A)                                                                        (0.935)
                                                                                                                       9.26(A.A)                                                                        (1.435)                                        1.2±0.1

                                                                   0.25±0.2
                                                                                     (1.1)
                                                                                                  (1.6)
                                                                                                                                                                                                                                                                                                                                                                                Mechanical Drawing

                                                                                     18.26(V.A)
                                                                                                  17.26(A.A)
                                                                                                                                                                                                                                                                                                   Com & Seg layout

                                                                   19.86±0.2(POL)
                                                  20.72±0.2(CAP)
                                23.6±0.2(Panel)
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
3. FPC Number:NFP1312-26                                                                                                                                                                                                 Signature                                            Wisevision Optronics Co.,Ltd.                                      X077-6428TSWCG01-H13     A
4. Interface:                                                                                                                                                                                                                                    Unless Otherwise Specified                                                                                Material
   4-wire SPI                                                                                                                                                                                                                                                                          X077-6428TSWCG01-H13 Folding Type OEL Display Module
5. General Tolerance: ±0.30                                                                                                                                                                                                                         Unit             mm        Title     Pixel Number: 128 x 64, Monochrome, COG Package
                                                                                                                                                                                                                                               General Roughness                                                                                  Soda Lime / Polyimide
                                                                                                                                                                                                                                                    Tolerance                            Drawn           E.E.         Panel / E.          P.M.
                                                                                                                                                                                                                                                Dimension    ±0.3               By        Jesen                                                   Scale      Sheet       Size
                                                                                                                                                                                                                                                  Angle       ±1               Date     20220521                                                   1:1       1 of 1       A3
                                                                                                                                                                                                                                                                                                                                                                                                       Ver:A

                  Wisevision Optronics Co.,Ltd.                                                                           Ver:A

1.5        Pin Definition

Pin Number         Symbol   I/O                                           Function
Power Supply
                                  Power Supplly for OEL Panell
       2             VPP     P    This is the most positive voltage supply pin of the chip. It must be supplied externally.
                                  Power Supplly for Logiic
       4             VDD     P    This is a voltage supply pin. It must be connected to external source.
                                  Ground of OEL System
       12            VSS     P    This is a ground pin. It also acts as a reference for the logic pins, the OEL driving voltages,
                                  and the analog circuits. It must be connected to external ground.

Driver
                                  Current Reference for Brightness Adjustment
       6             IREF    I     This pin is segment current reference pin. A resistor should be connected
                                   between this pin and VSS. Set the current at 12.5A maximum.
                                  Voltage Output High Level for COM Signal
       3           VCOMH    O      This pin is the input pin for the voltage output high level for COM signals. A
                                   capacitor should be connected between this pin and VSS.
Interface
                                  Communiicatiing Protocoll Sellect
                                  These pins are MCU interface selection input. See the following table:
       5             IM1     I                         IM1
                                    4-wire SPI          0
                                    I2C                 1
                                  Power Reset for Controller and Driver
       8            RES#     I      This pin is reset signal input. When the pin is low, initialization of the chip is
                                    executed. Keep this pin pull high during normal operation.
                                  Chip Select
       7             CS#     I      This pin is the chip select input. The chip is enabled for MCU communication only
                                    when CS# is pulled low.
                                  Data/Command Controll
                                  This pin is Data/Command control pin. When the pin is pulled high, the input at D7~D0
                                  will be interpreted as display data. When the pin is pulled low, the input at D7~D0 will be
                                  transferred to the command register.
                                  When the pin is pulled high and serial interface mode is selected, the data at SI will be
       9              A0     I    interpreted as data. When it is pulled low, the data at SI will be
                                  transferred to the command register. In I2C mode, this pin acts as SA0 for slave address
                                  selection.
                                  For detail relationship to MCU interface signals, please refer to the Timing Characteristics
                                  Diagrams.
                                  Seriiall Data Input/Output and cllock
                                  When serial mode is selected, D1 will be the serial data input SI and D0 will be the serial
      10,11         D0,D1   I/O   clock input SCL.
                                  When I2C mode is selected, D1 be the serial data input SDA and D0 is the serial clock
                                  input, SCL.
Reserve
                                  Reserved Piin
      1,13            NC     -    The N.C. pins between function pins are reserved for compatible and flexible design.

                       Wisevision Optronics Co.,Ltd.                                                         Ver:A

2. Absolute Maximum Ratings

               Parameter                      Symbol           Min          Max           Unit        Notes
         Supply Voltage for Logic                VDD           -0.3           4            V            1, 2
        Supply Voltage for Display               VPP             0            18           V            1, 2

          Operating Temperature                  TOP            -40           70           C

           Storage Temperature                  TSTG            -40           85           C            3
          Life Time (260 cd/m2)                               10,000          -           hour           4
  Note 1: All the above voltages are on the basis of “VSS = 0V”.
  Note 2: When this module is used beyond the above absolute maximum ratings, permanent breakage of the
          module may occur. Also, for normal operations, it is desirable to use this module under the
          conditions according to Section 3. “Optics & Electrical Characteristics”. If this module is used
          beyond these conditions, malfunctioning of the module can occur and the reliability of the module
          may deteriorate.
  Note 3: The defined temperature ranges do not include the polarizer.                The maximum withstood
          temperature of the polarizer should be 80C.
  Note 4: End of lifetime is specified as 50% of initial brightness reached. The reference average operation life
          time at room temperature is estimated by the accelerated at high temperature conditions.

                       Wisevision Optronics Co.,Ltd.                                                     Ver:A

3. Optics & Electrical Characteristics

  3.1 Optics Characteristics

            Characteristics          Symbol            Conditions         Min       Typ       Max      Unit

               Brightness
                                         Lbr             Note 4           260       320         -      cd/m2
        (VPP Supplied Externally)

                                         (x)                              0.25      0.29      0.33
             C.I.E. (White)                            C.I.E. 1931
                                         (y)                              0.27      0.31      0.35
          Dark Room Contrast             CR                                -      ＞10000:1      -
             Viewing Angle                                                 -        Free        -      degree
      * Optical measurement taken at VDD = 2.8V, VPP = 9V.
        Software configuration follows Section 4.5 Initialization.

  3.2 DC Characteristics

            Characteristics          Symbol            Conditions         Min       Typ       Max      Unit

        Supply Voltage for Logic        VDD                               1.65      2.8        3.5       V

       Supply Voltage for Display        VPP             Note 5           8.5       9.0        9.5       V

            High Level Input             VIH       IOUT = 100μA, 3.3MHz 0.8VDD      -        VDD        V

            Low Level Input              VIL       IOUT = 100μA, 3.3MHz    0         -       0.2VDD     V
           High Level Output            VOH        IOUT = 100μA, 3.3MHz 0.9VDD      -        VDD        V
           Low Level Output             VOL        IOUT = 100μA, 3.3MHz    0         -       0.2VDD     V
       Operating Current for VCI         IDD                               -        180       300       μA
       Operating Current for VPP         IPP             Note 6            -        12         17       mA

      Sleep Mode Current for VDD      IDD, SLEEP                           -         1         5        μA

      Sleep Mode Current for VPP      IPP, SLEEP                           -         2         10       μA
      Note 5 & 6: Brightness (Lbr) and Supply Voltage for Display (VPP) are subject to the change of the panel
                  characteristics and the customer’s request.
      Note 6: VDD = 2.8V, VPP = 9.0V, 100% Display Area Turn on.

      * Software configuration follows Section 4.5 Initialization.

                     Wisevision Optronics Co.,Ltd.                   Ver:A

 3.3 AC Characteristics
     3.3.3.1 Serial Interface Timing Characteristics: (4-wire SPI)

   (VDD - VSS = 1.65V to 2.4V, Ta = 25°
                                      C)

(VDD - VSS = 2.4V to 3.5V, Ta = 25°
                                  C)

Wisevision Optronics Co.,Ltd.   Ver:A

                        Wisevision Optronics Co.,Ltd.                                                    Ver:A

      3.3.3.2      4-wire Serial Interface
特别提醒(Special Tips):主板设计务必加电子开关, 否则, 可能引起漏电流现象
(When design main board, Please add Electronic Switch circuit, otherwise, will be caused leak current)

       Recommended Components:
       C1,:    0.1μF / 6.3V, X5R
       C2:     4.7μF / 6.3V, X5R
       C3:     2.2μF/ 16V, X7R
       C4:     4.7μF / 16V, X7R
       C5:     0.1μF / 16V, X7R
       R3:     560KΩ, R3 = (Voltage at IREF - VSS) / IREF
       R2, R1: 47kΩ
       Q1:     FDN338P
       Q2:     FDN335N
       Notes:
       VDD:    1.65~3.5V, it should be equal to MPU I/O voltage.
       Vpp_in: 8.5~9.5V

                       Wisevision Optronics Co.,Ltd.                                  Ver:A

3.3.4.1    I2C Interface Timing Characteristics:

          Symbol        Description                                      Min   Max   Unit
              tcycle    Clock Cycle Time                                 2.5    -     μs
            tHSTART     Start Condition Hold Time                        0.6    -     μs
                        Data Hold Time (for “SDAOUT” Pin)                 0
              tHD                                                               -     ns
                        Data Hold Time (for “SDAIN” Pin)                 300
               tSD      Data Setup Time                                  100    -     ns
                        Start Condition Setup Time
             tSSTART                                                     0.6    -     μs
                        (Only relevant for a repeated Start condition)
             tSSTOP     Stop Condition Setup Time                        0.6    -     μs
               tR       Rise Time for Data and Clock Pin                       300    ns
               tF       Fall Time for Data and Clock Pin                       300    ns
              tIDLE     Idle Time before a New Transmission can Start    1.3    -     μs
          * (VDD - VSS = 1.65V to 3.3V, Ta = 25°
                                               C)

                     Wisevision Optronics Co.,Ltd.                                                    Ver:A

3.3.4.2 I2C Interface Characteristics
   特别提醒(Special Tips):主板设计务必加电子开关, 否则, 可能引起漏电流现象
 (When design main board, Please add Electronic Switch circuit, otherwise, will be caused leak current)

     Recommended Components:
     C1,:     0.1μF / 6.3V, X5R
     C2:      4.7μF / 6.3V, X5R
     C3:      4.7μF/ 16V, X7R
     C4:      4.7μF / 16V, X7R
     C5:      0.1μF / 16V, X7R
     R3:      560KΩ, R3 = (Voltage at IREF - VSS) / IREF
     R2, R1:  47kΩ
     R4, R5 : 4.7 kΩ
     Q1:      FDN338P
     Q2:      FDN335N
     Notes:
     VDD:     1.65~3.5V, it should be equal to MPU I/O voltage.
     Vpp_in:  8.5~9.5V

                      Wisevision Optronics Co.,Ltd.                                                                    Ver:A
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
