MARS-ROBOTICS-star/Dummy-Robot-Reproduction/source/1.Dummy V2任同学整理/6.Docs/复刻审计_2026-09-06/extracted/6.Docs__芯片说明__STM32F405.pdf.txt

                                                                                               STM32F405xx
                                                                                               STM32F407xx
ARM Cortex-M4 32b MCU+FPU, 210DMIPS, up to 1MB Flash/192+4KB RAM, USB
         OTG HS/FS, Ethernet, 17 TIMs, 3 ADCs, 15 comm. interfaces & camera
                                                                                                  Datasheet - production data

                                                                            IC/OC/PWM or pulse counter and quadrature
                                                             FBGA
                                                                            (incremental) encoder input
                                                                       •    Debug mode
  LQFP64 (10 × 10 mm)                                                       – Serial wire debug (SWD) & JTAG
  LQFP100 (14 × 14 mm)
                                     WLCSP90
                                                        UFBGA176                interfaces
  LQFP144 (20 × 20 mm)                                 (10 × 10 mm)
  LQFP176 (24 × 24 mm)                                                      – Cortex-M4 Embedded Trace Macrocell™
                                                                       •    Up to 140 I/O ports with interrupt capability
                                                                            – Up to 136 fast I/Os up to 84 MHz
Features                                                                    – Up to 138 5 V-tolerant I/Os
• Core: ARM 32-bit Cortex™-M4 CPU with FPU,                            •    Up to 15 communication interfaces
  Adaptive real-time accelerator (ART                                       – Up to 3 × I2C interfaces (SMBus/PMBus)
  Accelerator™) allowing 0-wait state execution                             – Up to 4 USARTs/2 UARTs (10.5 Mbit/s, ISO
  from Flash memory, frequency up to 168 MHz,                                   7816 interface, LIN, IrDA, modem control)
  memory protection unit, 210 DMIPS/
  1.25 DMIPS/MHz (Dhrystone 2.1), and DSP                                   – Up to 3 SPIs (42 Mbits/s), 2 with muxed
  instructions                                                                  full-duplex I2S to achieve audio class
                                                                                accuracy via internal audio PLL or external
• Memories                                                                      clock
  – Up to 1 Mbyte of Flash memory                                           – 2 × CAN interfaces (2.0B Active)
  – Up to 192+4 Kbytes of SRAM including 64-                                – SDIO interface
      Kbyte of CCM (core coupled memory) data
      RAM                                                              •    Advanced connectivity
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
