MARS-ROBOTICS-star/Dummy-Robot-Reproduction/notes/LedRing焊接示意图.png

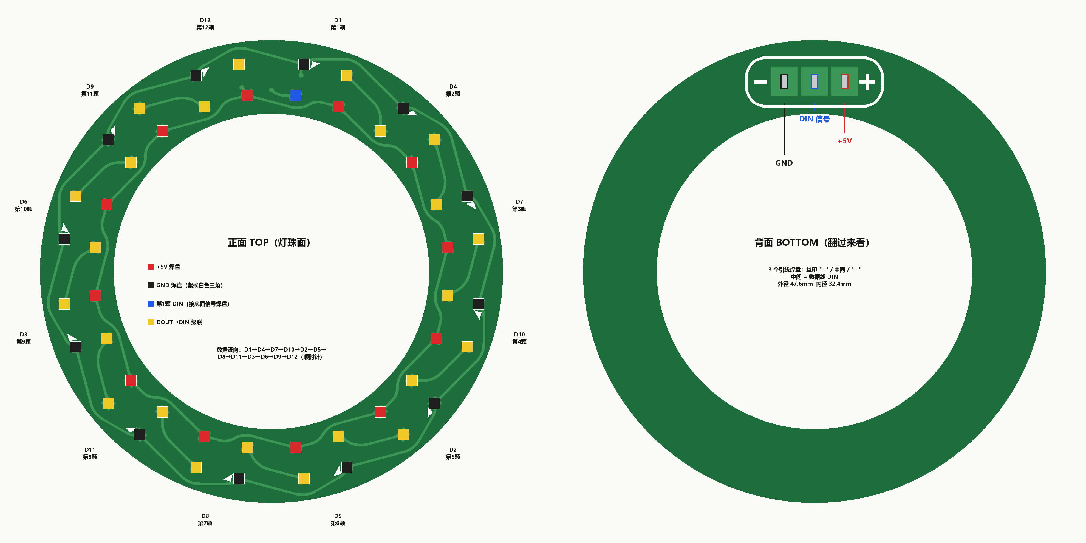
notes/LedRing焊接示意图.png
