MARS-ROBOTICS-star/Dummy-Robot-Reproduction/notes/Motor35-3V3短路测点图.png

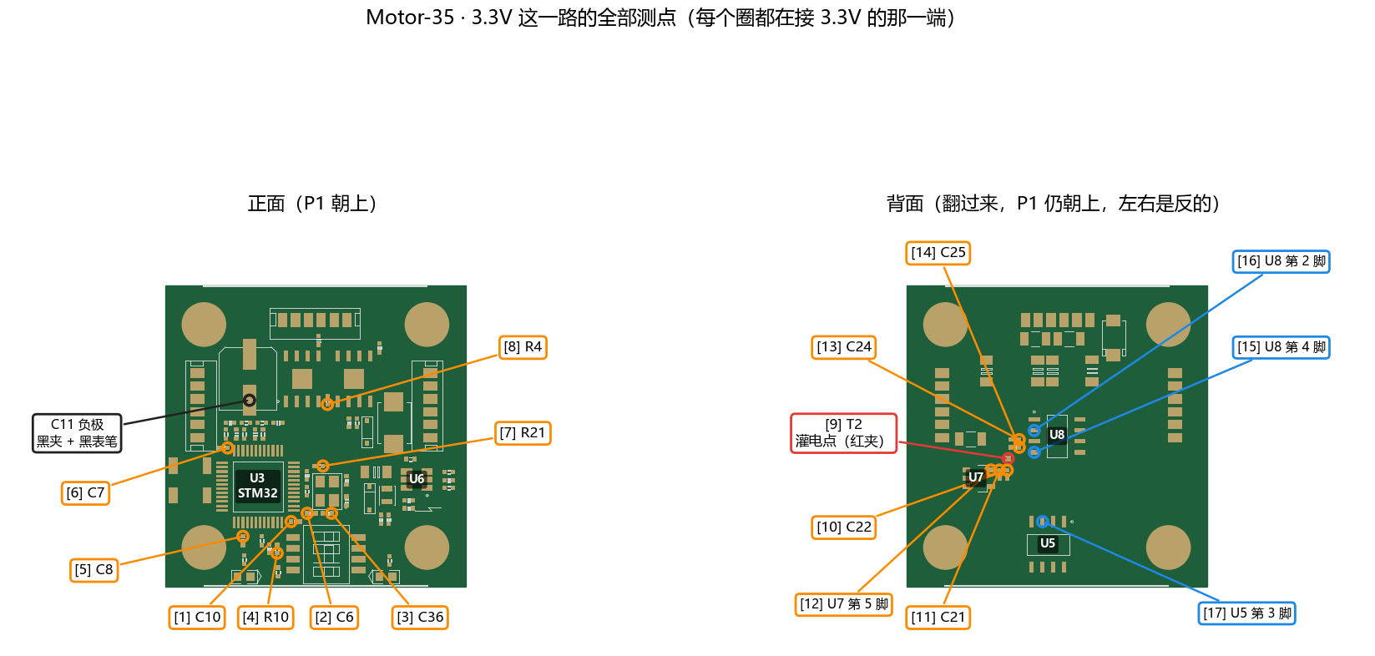
notes/Motor35-3V3短路测点图.png
