MARS-ROBOTICS-star/Dummy-Robot-Reproduction/notes/Motor35-R4一带放大图.png

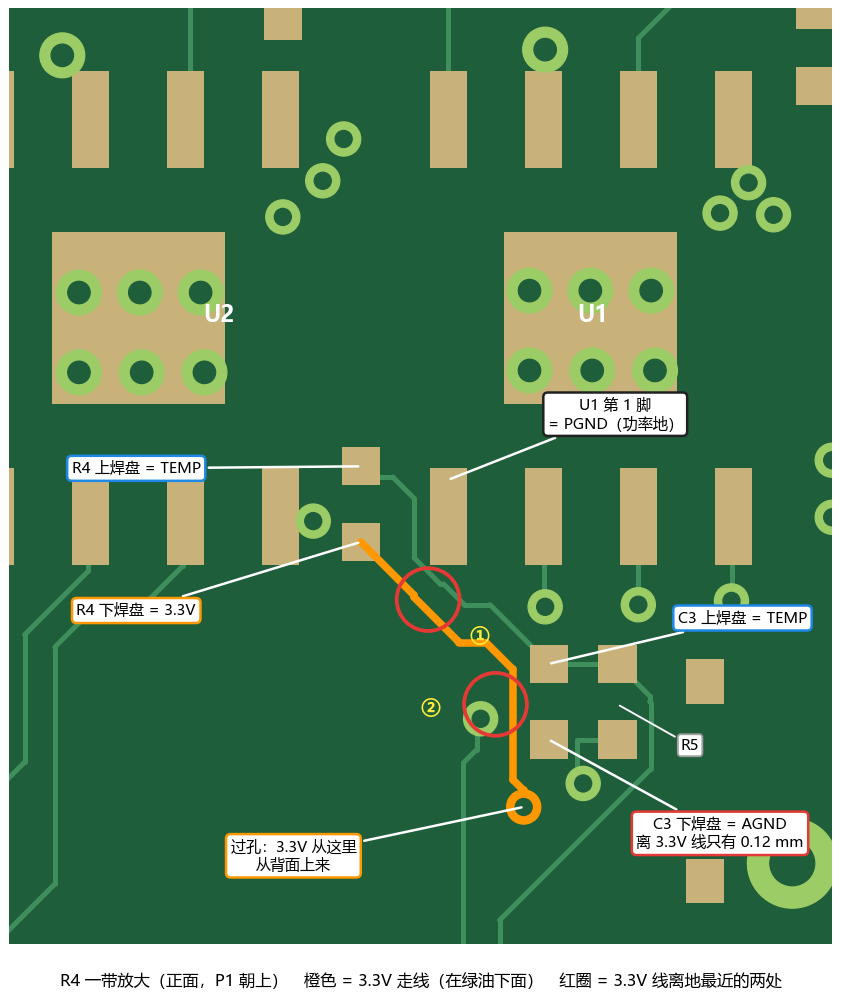
notes/Motor35-R4一带放大图.png
