MARS-ROBOTICS-star/Dummy-Robot-Reproduction/notes/Motor35上电测点图.png

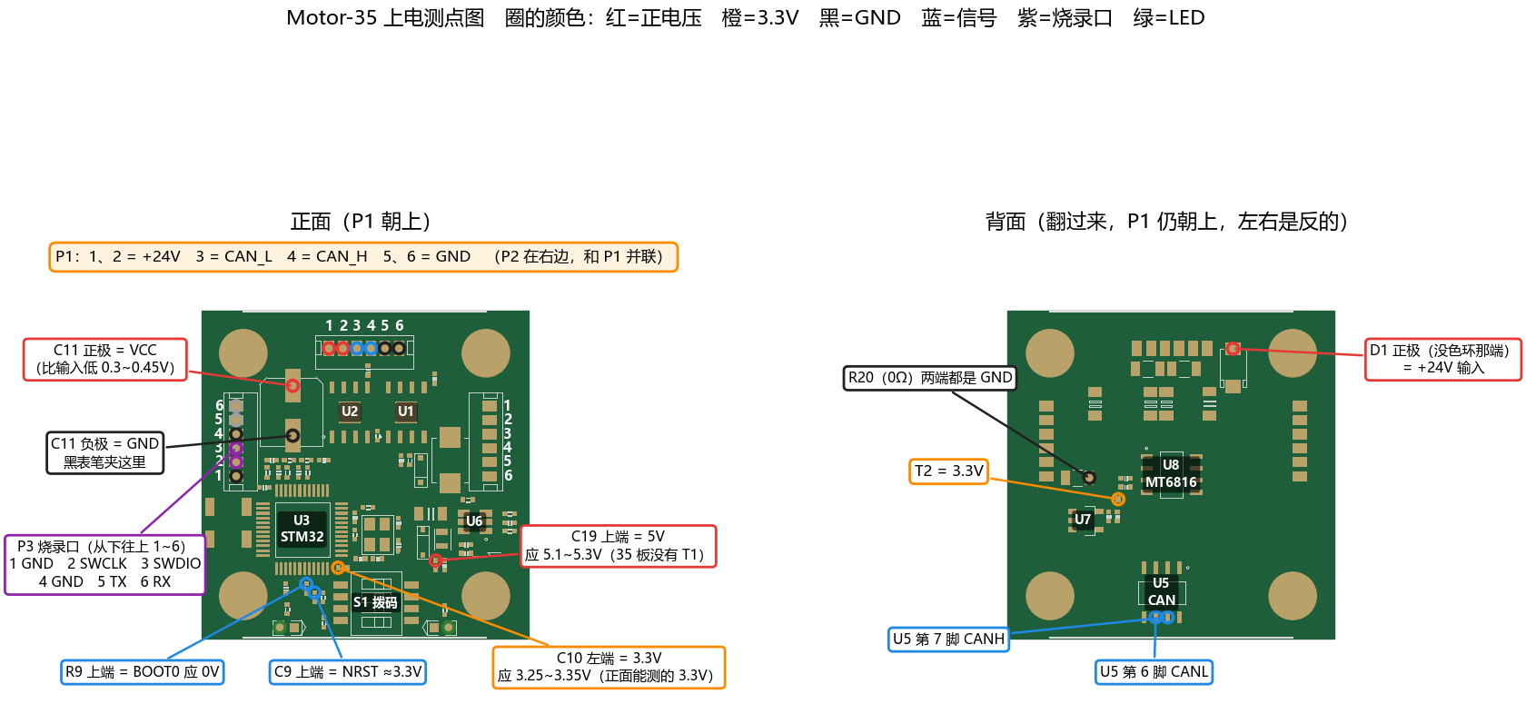
notes/Motor35上电测点图.png
