MARS-ROBOTICS-star/Dummy-Robot-Reproduction/notes/Motor35分阶段焊接图.png

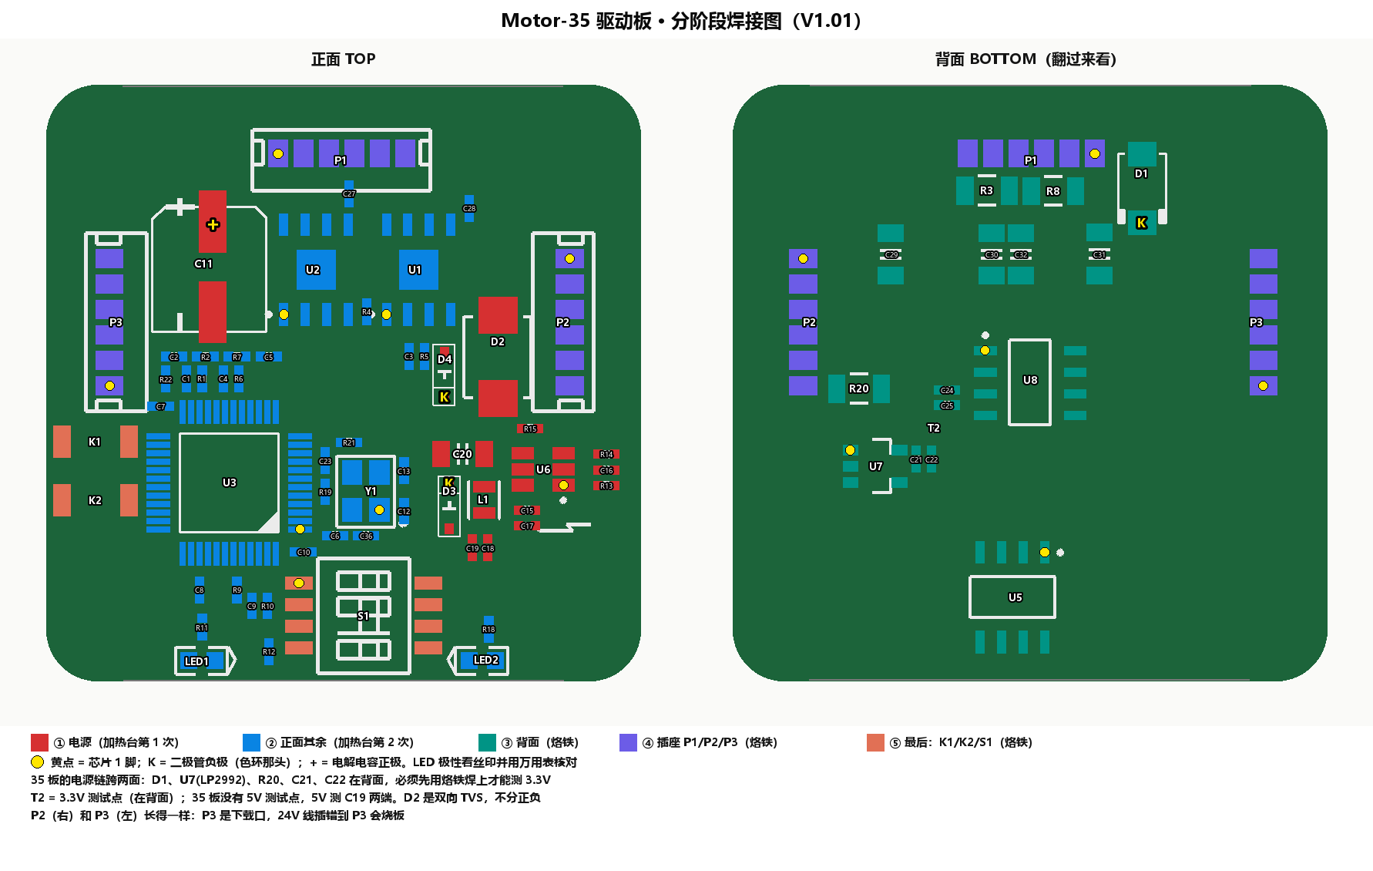
notes/Motor35分阶段焊接图.png
