MARS-ROBOTICS-star/Dummy-Robot-Reproduction/notes/Motor42-3V3短路测点图.png

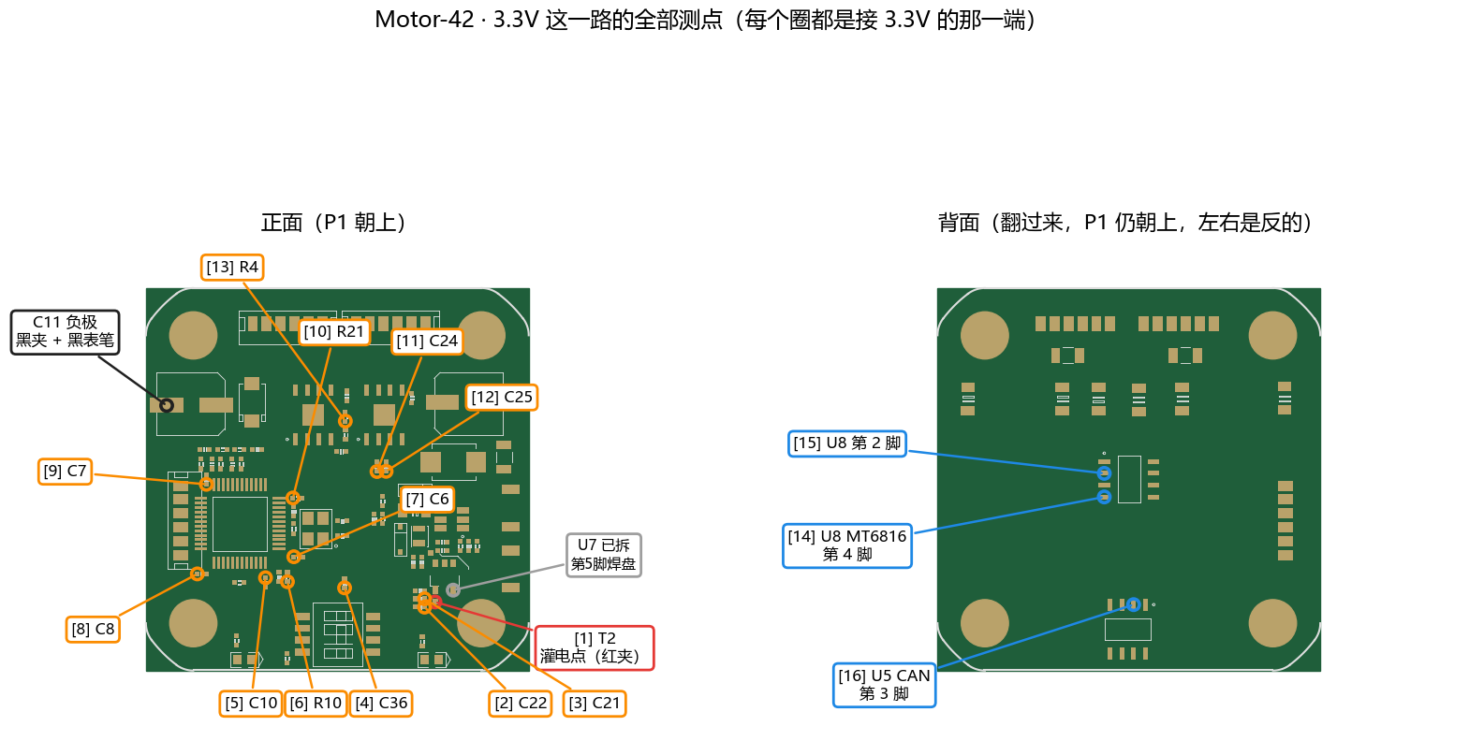
notes/Motor42-3V3短路测点图.png
