MARS-ROBOTICS-star/Dummy-Robot-Reproduction/notes/Motor42上电测点图.png

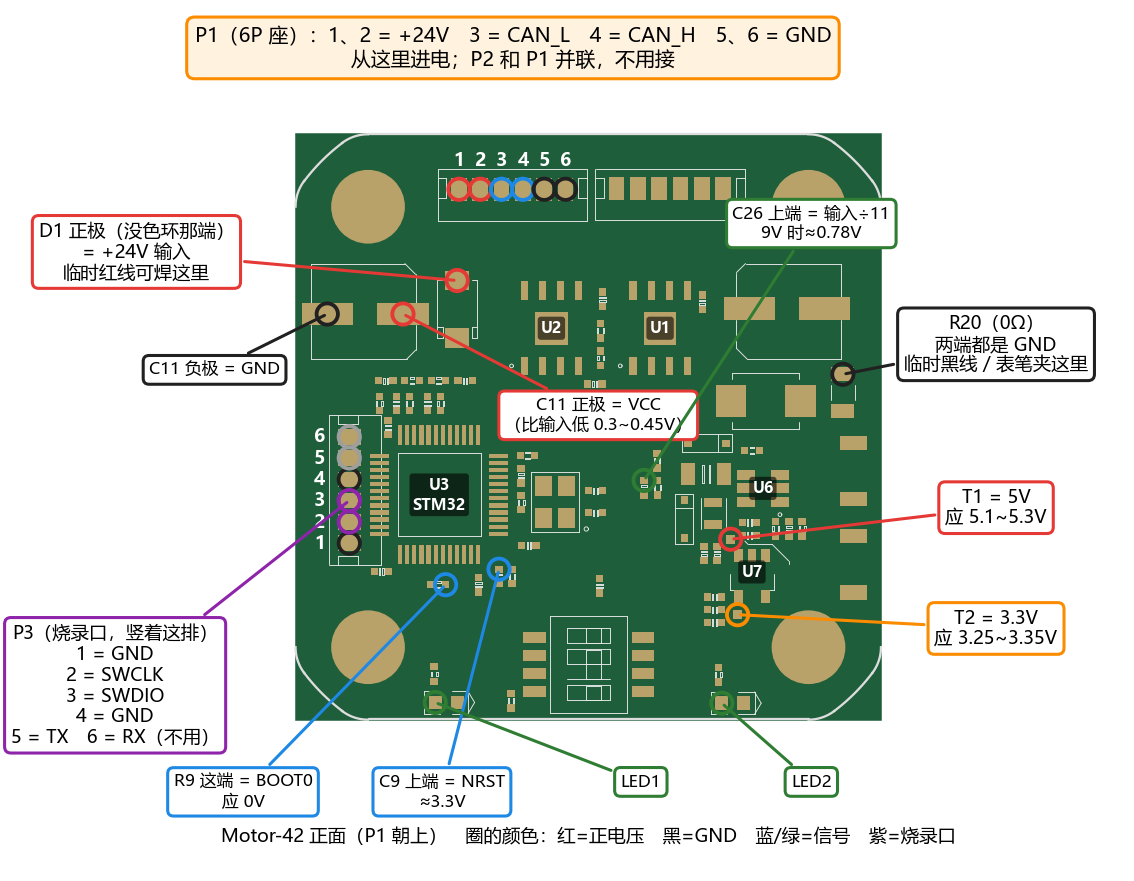
notes/Motor42上电测点图.png
