MARS-ROBOTICS-star/Dummy-Robot-Reproduction/notes/Motor42分阶段焊接图.png

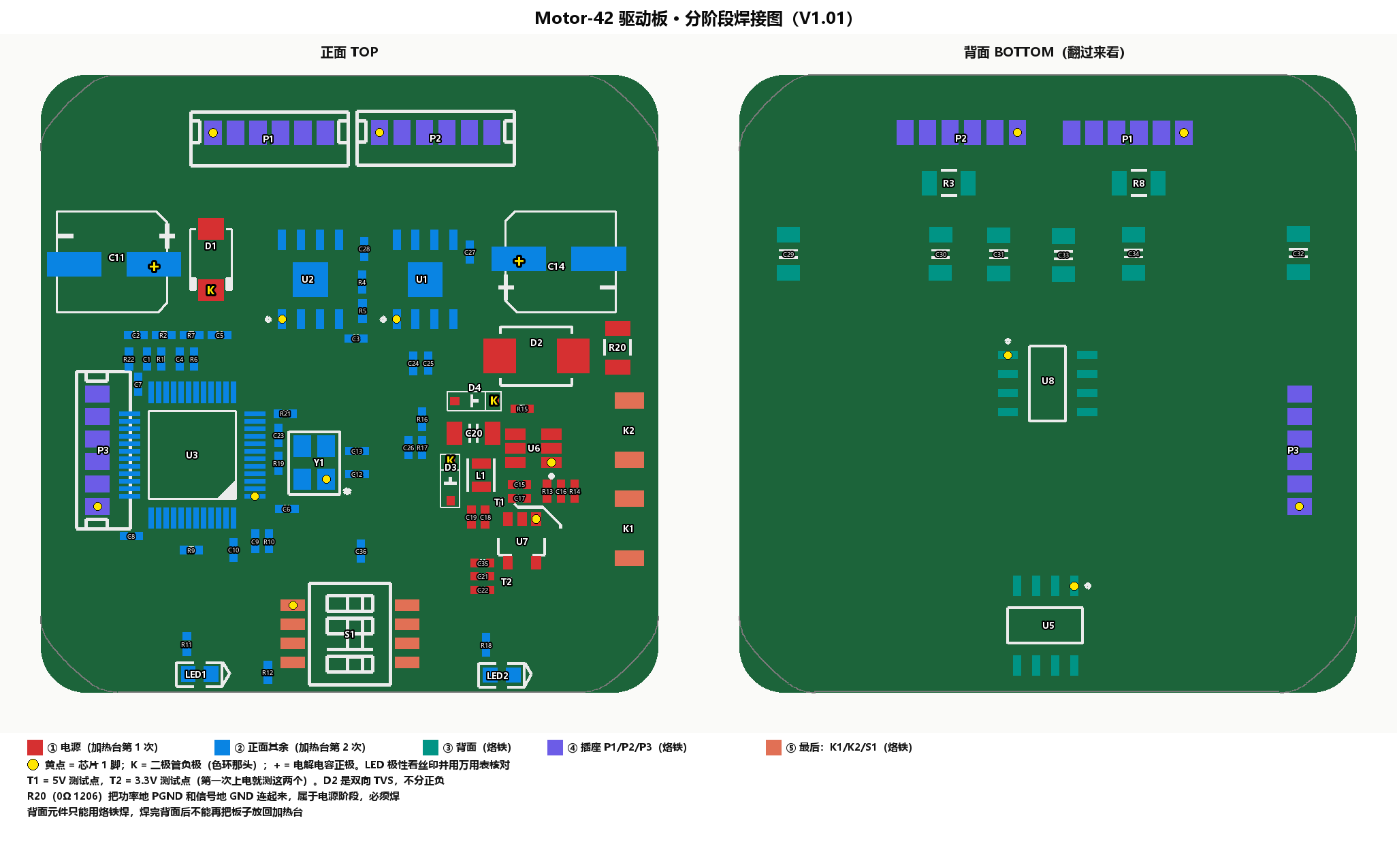
notes/Motor42分阶段焊接图.png
