MARS-ROBOTICS-star/Dummy-Robot-Reproduction/notes/REF-3V3短路测点图.png

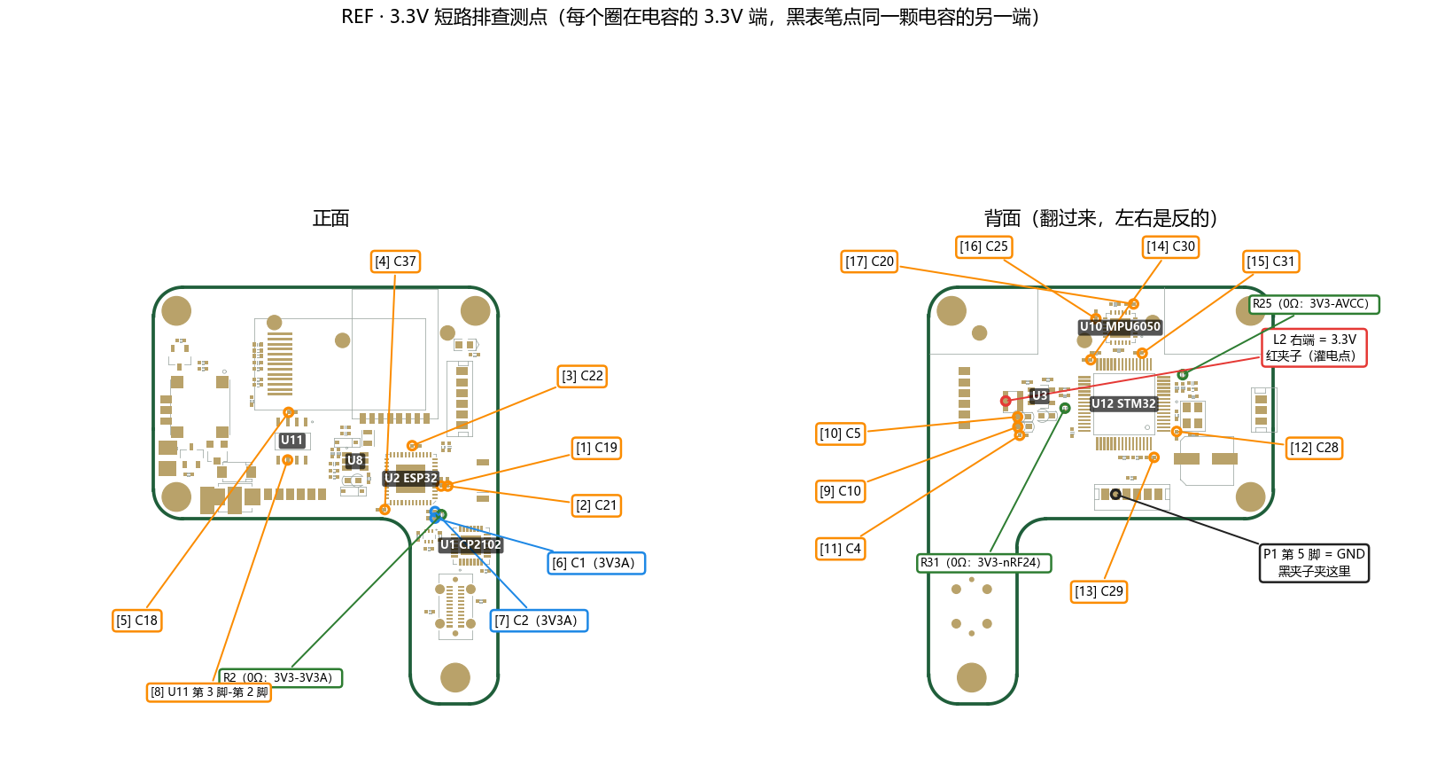
notes/REF-3V3短路测点图.png
