MARS-ROBOTICS-star/Dummy-Robot-Reproduction/notes/REF测点图.png

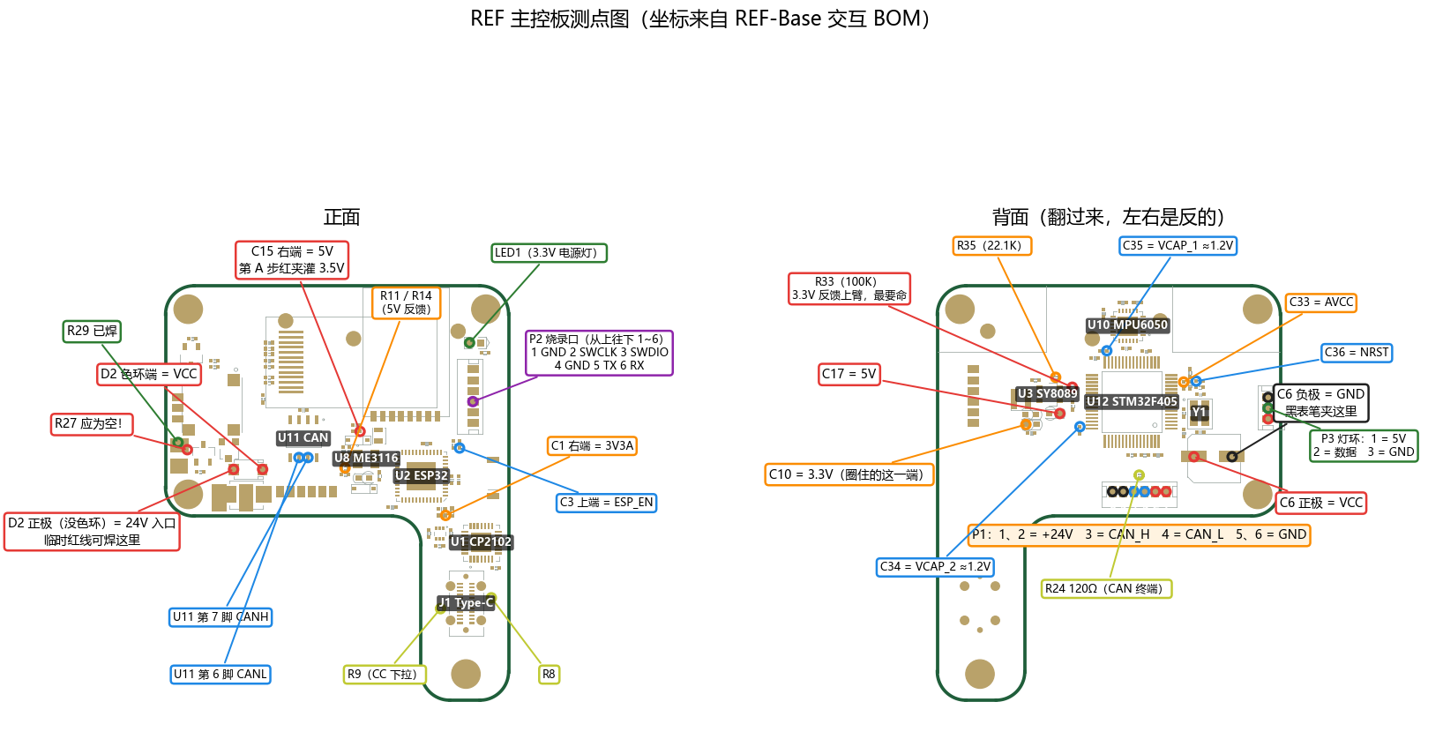
notes/REF测点图.png
