MARS-ROBOTICS-star/Dummy-Robot-Reproduction/source/1.Dummy V2任同学整理/6.Docs/复刻审计_2026-09-06/extracted/pins-1.png

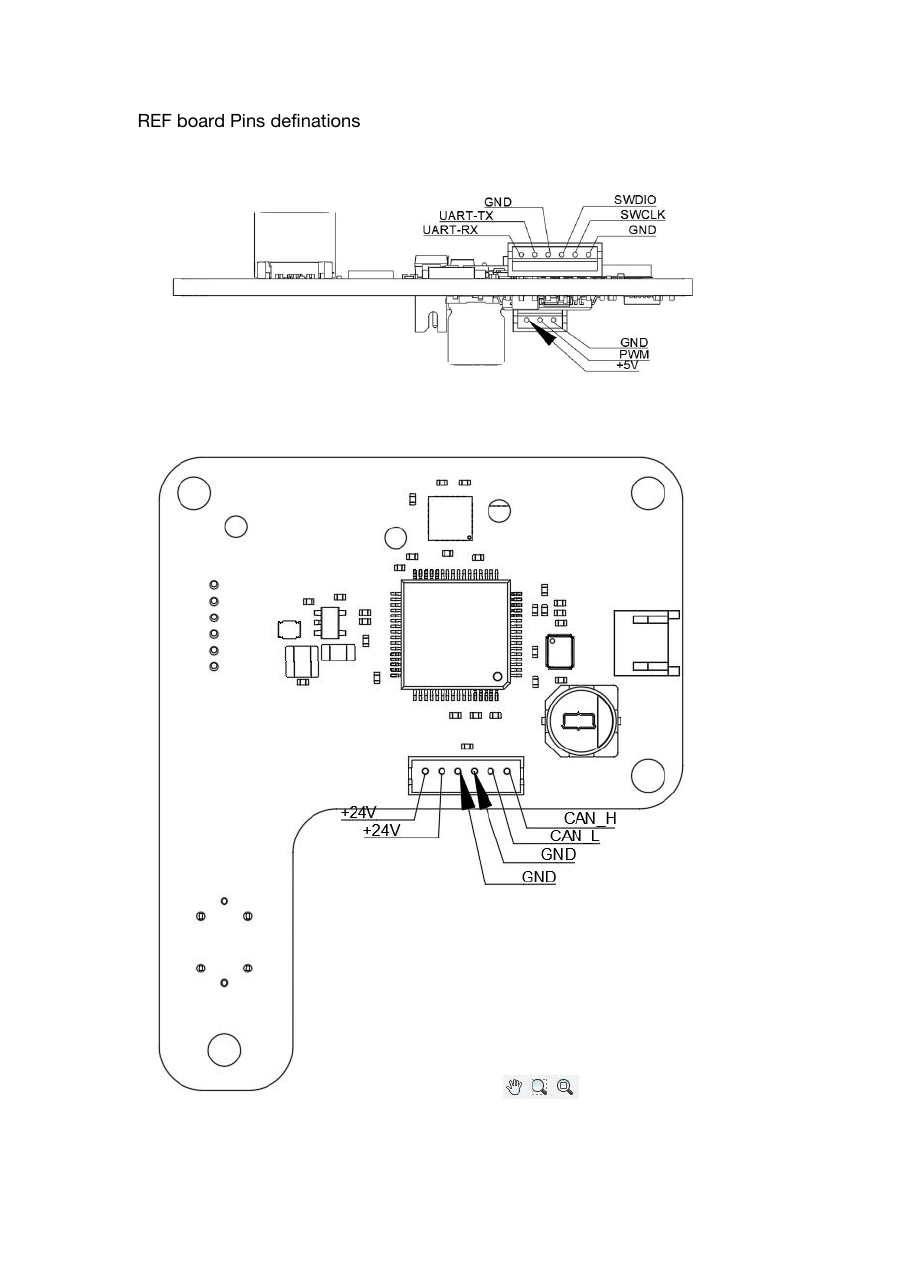
source/1.Dummy V2任同学整理/6.Docs/复刻审计_2026-09-06/extracted/pins-1.png
