MARS-ROBOTICS-star/Dummy-Robot-Reproduction/notes/3D打印与CNC清单.md

# Dummy V2(视频款)3D 打印与 CNC 清单

> 依据:`<V2>/4.Model/Dummy V2 版本 视频款/Dummy-B v2装配体.step`(原版整机装配体),2026-10-28 解析核对。
> 数量 = 该零件在整机装配体中出现的实例总数(子装配实例数已乘进去)。
> 文件夹简写:`STL/` = `3D打印STL文件/`,`STEP/` = `CNC加工STEP文件/`。

## 〇、最终下单方案(2026-10-28 定:有 CNC 文件的全部走 CNC,其余 3D 打印)

**CNC(铝 6061),共 13 件**

| 文件 | 数量 | 备注 |
|---|---|---|
| `STEP/基座.step` | 1 | 原版(与装配体一致) |
| `STEP/J1.step` | 1 | 原版,须与基座同版 |
| `STEP/J23.step` | 1 | |
| `STEP/J4.step` | 1 | |
| `STEP/J4法兰盘.step` | 1 | |
| `STEP/J5A.step` | 1 | |
| `STEP/J5B.step` | 1 | |
| `STEP/J5法兰盘.step` | 1 | |
| `STEP/J6.step` | 1 | |
| Dummy-0037(自行从装配体导出,建议命名 `J1法兰盘.step`) | 1 | 2×Ø3.3 攻 M4 通孔,见第四节 |
| Dummy-0016(导出) | 1 | Ø49.9/Ø30.1 × 6 垫环 |
| Dummy-0013(导出) | 2 | Ø34.9 × 3 台阶垫片 |
| Dummy-0027(导出) | 1 | Ø24 × 1.5 薄垫片 |

**3D 打印,共 19 件**

| 文件 | 数量 |
|---|---|
| `STL/基座底板.stl` | 1 |
| `STL/外壳A.stl` | 2 |
| `STL/外壳C.stl` | 1 |
| `STL/控制器外壳.stl` | 1 |
| `STL/控制器内衬.stl` | 1 |
| `STL/控制器屏幕底板.stl` | 1 |
| `STL/42PCB外壳A.stl` | 3 |
| `STL/42PCB外壳B.stl` | 3 |
| `STL/35PCB外壳A.stl` | 3 |
| `STL/35PCB外壳B.stl` | 3 |

**外购标准件**:Dummy-0036 轴用垫片 5×8×1.2,6 件。

> BOM 核对(2026-10-28):`5.Bom/` 下 4 份 BOM(任同学 `dummy V2版本_bom.xlsx` 含其「螺丝安装下图」两张截图、Ryan BOM、实际采购 iBOM、立创模板)
> **均无** 0013 / 0016 / 0027 / 0036 对应的条目。唯一的垫圈是 M3×8×0.8 平垫圈,对应装配体里的「平垫片 M3」,不是这几件。
> Ryan BOM 写「全套CNC包括底座」咸鱼 1435 元,卖家套件里是否含这些垫环不明,若买成品套件需向卖家确认。

---

## 一、3D 打印清单(按装配体)

| # | 文件 | 数量 | 装配体编号 | 所在位置 | 核对方式 |
|---|---|---|---|---|---|
| 1 | `STL/J1.stl` | 1 | Dummy-0001 | J1 | 对应 STEP 面数+孔径完全一致 |
| 2 | `STL/J2J3.stl` | 1 | Dummy-0009 | J2&J3 | 同上 |
| 3 | `STL/J4.stl` | 1 | Dummy-0008 | J4 | 同上 |
| 4 | `STL/J4法兰盘.stl` | 1 | Dummy-0022 | J4(电机↔Mini11 转接) | 同上 |
| 5 | `STL/J5A.stl` | 1 | Dummy-0011 | J5 | 同上 |
| 6 | `STL/J5B.stl` | 1 | Dummy-0002 | J5 | 同上 |
| 7 | `STL/J5法兰盘.stl` | 1 | Dummy-0026 | J5 → 普赢改轴输入(Mini8 输入轴座) | 同上 |
| 8 | `STL/J6.stl` | 1 | Dummy-0003 | J6 | 同上 |
| 9 | `STL/基座.stl` | 1 | Dummy-0004 | BASE | 同上 |
| 10 | `STL/基座底板.stl` | 1 | Dummy-0006 | BASE | 外形尺寸一致 |
| 11 | `STL/外壳A.stl` | **2** | Dummy-0012(外壳) ×2 | J2&J3 两侧 | 外形一致;装配体里同一零件用两次 |
| 12 | `STL/外壳C.stl` | 1 | Dummy-0007(外壳) | J5 | 外形一致 |
| 13 | `STL/控制器外壳.stl` | 1 | Dummy-0017 | BASE → 控制器 | 外形一致 |
| 14 | `STL/控制器内衬.stl` | 1 | Dummy-0035 | BASE → 控制器 | 外形一致 |
| 15 | `STL/42PCB外壳A.stl` | **3** | Dummy-0018 | 3 个 42 电机组件(基座 1 + J2&J3 2) | 外形一致 |
| 16 | `STL/42PCB外壳B.stl` | **3** | Dummy-0019 | 同上 | 外形一致 |
| 17 | `STL/35PCB外壳A.stl` | **3** | Dummy-0020 | 3 块 35 驱动板(J4/J5/J6) | 外形一致 |
| 18 | `STL/35PCB外壳B.stl` | **3** | Dummy-0021 | 同上 | 外形一致 |

**装配体外,建议加打**:

| 文件 | 数量 | 说明 |
|---|---|---|
| `STL/控制器屏幕底板.stl` | 1 | 装配体里没有;按 STL 坐标位于控制器外壳内上部,是 OLED 支架。几毛钱,建议带上 |

**合计:装配体内 27 件 + 屏幕底板 1 件 = 28 件**(另有第三节待定的小件)。

注意:
- `外壳B.stl` 与 `外壳A.stl` 是同一文件(md5 相同),**只传 `外壳A.stl`,数量填 2**。
- 4 个 `.3mf` 不要传(拓竹工程文件,名字与内容对不上且每种摆了 6 件)。
- J1 / 基座 按**原版**列出。若改用改版,两件必须一起换,需自行把 `改版/J1改版.step`、`改版/基座改版.step` 导出 STL。

## 二、CNC 清单(可选,替换对应打印件)

`STEP/` 下 9 个文件,**全部与装配体零件面数和孔径逐一精确吻合**,各 1 件:

| 文件 | 数量 | 替换打印清单中的 |
|---|---|---|
| `STEP/基座.step` | 1 | #9 基座 |
| `STEP/J1.step` | 1 | #1 J1 |
| `STEP/J23.step` | 1 | #2 J2J3 |
| `STEP/J4.step` | 1 | #3 J4 |
| `STEP/J4法兰盘.step` | 1 | #4 J4法兰盘 |
| `STEP/J5A.step` | 1 | #5 J5A |
| `STEP/J5B.step` | 1 | #6 J5B |
| `STEP/J5法兰盘.step` | 1 | #7 J5法兰盘 |
| `STEP/J6.step` | 1 | #8 J6 |

- 走 CNC 路线时,打印清单的 #10–#18 与屏幕底板**仍需打印**(没有 CNC 文件)。
- 加工图纸(公差、螺纹):`Dummy-B 2D工程图/`;改版 J1/基座用 `改版/J1改版.step`、`改版/基座改版.step` + `改版/改版工程图/`。
- `Dummy-B 2D工程图/工程图拆分版本/Baseboard.pdf` 是 300×250 的安装大底板,**不在整机装配体里**,按需另做。

## 三、装配体里有、但没有任何零件文件的件(下单前要定)

按几何特征判断(未在 SW 中目视确认):

| 装配体编号 | 数量 | 位置 | 几何 | 判断 |
|---|---|---|---|---|
| **Dummy-0037** | 1 | BASE | 43×43×6 方板,中心 Ø22.05 孔 + Ø33/Ø35 台阶,2 个沉头孔间距 31×31 | **J1 的 42 电机↔Mini11 转接法兰**(Ø22 止口 + 31 mm 孔距正是 42 步进电机标准)。STL、STEP 都没有,**需要从装配体导出或照第四节自建** |
| Dummy-0016 | 1 | BASE | 圆环 外 Ø49.9 / 内 Ø30.1,厚 6 | 垫环/隔圈,可能在 J1 与基座的 Ø50 配合处 |
| Dummy-0013 | 2 | J2&J3 | 圆环 外 Ø34.9 / 内 Ø30 与 Ø11,厚 3 | 垫环 |
| Dummy-0027 | 1 | J5 → 普赢改轴输入 | 圆环 外 Ø24 / 内 Ø22 与 Ø11,厚 1.5 | 薄垫片 |
| Dummy-0036 | 6 | J2&J3 ×4、J5 ×2 | 外 Ø8 / 内 Ø5,厚 1.2 | **标准轴用垫片 5×8×1.2**,配 695 轴承和 Ø5 D 字轴,买成品即可 |

从装配体导出 STL 的方法(SW):打开 `Dummy-B v2装配体.step` → 设计树中右键该零件 → **打开零件** → 另存为 STL。

## 四、无文件小件的尺寸(从装配体 STEP 几何解析)

> 数值直接取自 `Dummy-B v2装配体.step` 中各零件的平面与圆柱面,单位 mm,保留原始精度(如 Ø22.05 即模型里的配合间隙)。
> 解析为脚本读取,未在 SW 中目视;若与 SW 里测得的不一致,以 SW 为准。

### Dummy-0037 — J1 电机法兰(BASE 内,1 件)⚠️ 必需

```
外形   43 × 43 方板,厚 6,四角 C1 倒角
中心   阶梯通孔,沿厚度方向分三段:
         电机侧  Ø22.05 深 1.5   ← 卡 42 电机 Ø22 止口
         中段    Ø33.05 深 2.0
         另一侧  Ø35.05 深 2.5   ← 推测为 Mini11 定位止口
孔 1   2 × Ø3.4 通孔 + Ø6 沉孔(沉孔深 4.5,开在 Ø35 一侧)
         位置:一条对角线上,相对中心 (±15.5, ±15.5) → 孔距 31 × 31(42 电机安装孔)
孔 2   2 × Ø3.3 通孔(M4 底孔 / 或自攻用)
         位置:另一条对角线上,相对中心 (±17.68, ∓17.68) → 距中心 25,即 PCD Ø50
```

打印建议:沉孔一侧朝上平放,无需支撑;关节受力件,填充 ≥ 30%、墙 ≥ 3。

**推荐 CNC(铝 6061)**:直接贴 42 电机,电机外壳运行时可达 50–70 ℃,接近 PLA 软化点;且承担电机↔减速器同轴定位。
送 CNC 时注明:2×Ø3.3 孔 **攻 M4 通孔**(依据:同接口的 `J4法兰盘.pdf` 在对应孔位标注「M4螺纹过孔」);其余孔按模型。

**不能用 J4法兰盘 代替**:两者减速器侧接口相同(Ø22.05 止口、Ø35 定位、2×Ø3.3 于 PCD Ø50),
但电机侧不同 —— 0037 是 42 电机孔距 31×31、43 方板厚 6;J4法兰盘 是 35 电机孔距 26×26、50 圆角板厚 7,另有 8×Ø4 + 2×Ø4.3 固定到 J4 壳体的孔。

### Dummy-0016 — 垫环(BASE 内,1 件)

```
圆环   外 Ø49.9 / 内 Ø30.1,厚 6,无其他特征
```

### Dummy-0013 — 带台阶垫片(J2&J3 内,2 件)

```
外形   外 Ø34.9,总厚 3
一侧   Ø30 沉槽,深 2
底部   剩 1 mm 厚,中心 Ø11 通孔
```

### Dummy-0027 — 薄垫片(J5 → 普赢改轴输入,1 件)

```
外形   外 Ø24,总厚 1.5,两端外缘 C0.2
一侧   Ø22 沉槽,深 0.7(槽口 C0.2)
底部   剩 0.8 mm 厚,中心 Ø11 通孔
```

只有 0.8 mm 底厚,FDM 打印约 4 层,强度一般;可考虑用金属垫片替代或照常打印试装。

### Dummy-0036 — 轴用垫片(6 件)— 买标准件

```
外 Ø8 / 内 Ø5 / 厚 1.24  → 淘宝搜「5×8×1.2 垫片」或「5×8×1 轴用调整垫片」
```

## 五、视频款装配体中的螺丝与紧固件（2026-11-04 核对）

依据仍为原版 `Dummy-B v2装配体.step`，不是改版 `改版/Dummy-B.STEP`，也不是木子版。读取 `PRODUCT_DEFINITION` 和 `NEXT_ASSEMBLY_USAGE_OCCURRENCE`，从唯一整机根节点递归展开所有子装配；再用独立的拓扑权重传播复核。共 71 个零件/装配定义、197 条装配关系、180 个展开后的叶零件实例。

下表是**模型明确建模的装配数量**，不是采购包装数量，也不是实物装配验收后的完整用量。规格取模型名称；材料、强度等级和螺纹长度未由本次几何测量确认。原模型中 `M3 x 10` 与 `M3-10` 合并统计。

| 螺丝规格 | 数量/颗 | 所属顶层组件（模型分组） |
|---|---:|---|
| M3×5 | 4 | J6：2；BASE：2 |
| M3×8 | 11 | J5：6；J6：3；BASE：2 |
| M3×10 | 15 | J2&J3：8；J5：5；BASE：2 |
| M3×14 | 12 | J1：12 |
| M3×16 | 14 | J4：6；J5：8 |
| M3×25 | 8 | J5：4；J6：4 |
| M3×35 | 2 | J4：2 |
| M3×40 | 8 | J2&J3：4；J4：2；BASE：2 |
| M3×45 | 4 | J2&J3：4 |
| M4×12 | 8 | J2&J3：4；BASE：4 |
| M4×16 | 10 | J2&J3：4；J4：4；BASE：2 |
| M4×20 | 2 | BASE：2 |
| **合计** | **98** | **12 种规格** |

其他紧固件：M3 平垫片 12 片（J2&J3：8、J5：4），M3 六角螺母 4 个（BASE/控制器）。平垫片的采购参考为任同学 BOM 截图的 M3×8×0.8；不与前文的 5×8×1.2 轴用垫片混淆。

与采购 BOM 的差异：

- 任同学 BOM 两张订单截图共 11 种螺丝、490 颗；均能在本模型找到，但截图**未列 M3×16**。另有 M3×8×0.8 平垫圈 100 片，未列 M3 螺母。
- Ryan BOM 共 13 种规格、600 颗、表内总价 39.24 元；M3×8 两行各 100 颗、同一链接，是否重复录入未确认。它未列本模型所需的 M3×5、M3×10、M3×14、M3×16、M3×40、M4×16、M4×20；其中 M3×16 也不在任同学截图中。
- Ryan 另列的 M3×12、M3×15、M3×20、M3×28、M3×30、M4×22、M4×30、M4×35，在这份原版装配体的螺丝定义中未找到；不能据此断言其他版本或实物改装不需要，也不能用接近长度直接替代。
- 本模型没有控制器屏幕底板，因此该件与 OLED 的固定用量尚未闭环；成品电机、同步轮等内部或随件提供的紧固件，不可把本表当作其完整零件清单。安装视频 10 的 08:05–08:39 还特别要求 J6 电机保留两颗原装螺丝，仅拆两颗安装固定架。

减速器也按装配体复核：11 号 `minif-11-50` 共 4 个（BASE：1、J2&J3：2、J4：1），8 号 `min8-50` 共 1 个（J5）。这是模型命名与配置证据，不是整机各轴最终总减速比或商品后缀兼容性的验收结论。

价格与渠道核对（2026-11-04 用已登录淘宝会话打开商品页，并逐个点击 SKU 读取页面实际显示价，不是只读列表页或页面内嵌数据）：

| 项目 | 任同学 BOM | Ryan BOM |
|---|---|---|
| 链接 | `item.taobao.com/item.htm?id=680325492406` | `item.taobao.com/item.htm?id=902846205607` |
| 标题 | 厂家直销微型谐波减速机 MINIF11 可配 42/35 步进 | 超小微型谐波减速器配 42/35 步进电机 |
| 店铺 | 宁波普赢科技有限公司 | 普赢谐波减速机 |
| MINIF11-50-B | 深沟球轴承版 260 元；交叉滚子轴承版 300 元 | 260 元（未标轴承版本） |
| MINIF8-50-B | 深沟球轴承版 300 元 | 300 元 |
| 4×Mini11 + 1×Mini8 | 1340 元（深沟球）/ 1500 元（交叉滚子） | 1340 元 |
| 发货 | 预售，7 天内发货 | 48 小时内发货 |
| 销量/评价 | 已售 2000+，评价 300+，近 3 个月好评率 100% | 已售 200+，评价 41 |

- 两家都免运费；页面均有“建行分期限量满 500 减 25”，属于支付/分期活动，不是商品直降。
- 任同学链接列表页的“￥60 起”是最低价 SKU 波发生器（MINIF11-50 波发生器 60 元），不是整台减速器，不能当成减速器单价。
- 同规格整机两家现价一致。任同学店多一个交叉滚子轴承版（Mini11 每台 +40 元）；Ryan 店该链接未标注轴承版本。
- 模型只写 `minif-11-50` / `min8-50`，不含轴承版本信息，因此不能由模型判定买深沟球还是交叉滚子。

螺丝价格边界：任同学 BOM 只有订单截图，无单价、无链接；Ryan 表内 39.24 元是历史价。按 2026-11-04 实时 SKU 重算，模型所需 98 颗在 Ryan 两家店（天猫 587639753812 + 淘宝 655646005874）混买约 49 元、全部在天猫买 50/100 颗装约 66 元；两份 BOM 都没有 M3 螺母和 5×8×1.2 轴用垫片的采购条目。

实际下单（2026-11-04，明细见 `实际采购iBOM_Dummy整机.xlsx`）：

| 项目 | 店铺/订单 | 数量 | 实付 |
|---|---|---|---|
| 全套 CNC（含底座） | 闲鱼 手搓宅_（鱼小铺） | 1 套 | 1393.00 |
| dummy 机械臂 v2 金属底板（小尺寸 CNC） | 闲鱼 手搓宅_（鱼小铺） | 1 块 | 115.00 |
| 内六角螺丝 M4×20/M4×16/M4×12、M3×45/M3×40/M3×35 | 天猫 金超官方旗舰店 5127895333731111141 | 各 50 颗 | 35.52 |
| 内六角螺丝 M3×16、M3×8 | 同上 | 各 100 颗 |  |
| 内六角螺丝 M3×25（20 只）、M3×14/M3×10/M3×5（各 50 只） | 淘宝 天诚五金TC 5127833844735029939 | 20 + 50×3 颗 | 12.00 |
| M3 六角螺母 | 天猫 以瑟官方旗舰店 5127895333731039121 | 200 颗 | 2.22 |
| M3×8×0.8 平垫圈 | 天猫 洋鑫旗舰店 5127895333731084313 | 50 片 | 1.51 |
| 5×8×0.2、5×8×1 超薄垫片 | 天猫 劲功官方旗舰店 5127895333731048303 | 各 100 片 | 10.24 |

- 若按“天猫 587639753812 一家买齐”的方案，98 颗螺丝约 49 元；本次实际按 12 种规格各买整包（共 670 颗螺丝、47.52 元），余量用于备件和后续关节垫配。
- M3×5/10/14/25 这四种长度在原版装配体里有需求，但首单两家都没买，由天诚五金一单补齐（12.00 元，免运费）。
- 全套 CNC 已含底座，同店又单买了 115 元小尺寸底板，到货要核对是否重复件（多出的一块作备用）。
- 两单均为“待发货（待卖家预约快递）”，收货后按 13 件 CNC 逐件对图清点，再更新状态。
