MARS-ROBOTICS-star/Dummy-Robot-Reproduction/source/1.Dummy V2任同学整理/5.Bom/Dummy_V2_BOM_Ryan_v1.1.xlsx

Sheet: History
Version | Change list | Date
v1.0 | First release | 2026-07-04
v1.1 | 增加木子晓汶硬件v1.0.0和v1.0.1的说明和Gitee链接 | 2026-07-19

Sheet: Motor35
 | Sourced | Placed | References | Value | Footprint | Quantity
1 |  |  | Y1 | XTAL-4 | LC-SMD-3225_4P | 1 | 12M
2 |  |  | U5 | SN65HVD232D | so-8 | 1
3 |  |  | U6 | ME3116 | SOT23-6 | 1
4 |  |  | U7 | LP2992 3V3 | SOT23-5 | 1
5 |  |  | U8 | MT6816 | SO-8 | 1
6 |  |  | U1, U2 | TB67H450FNG | SO-8-PAD | 2
7 |  |  | U3 | STM32F103CBT6 | LQFP-48 | 1
8 |  |  | S1 | DSHP04TSGER | SW-SMD_DSHP04TS-S | 1
9 |  |  | R4 | NCP15XH103F03RC | RES_0402 | 1
10 |  |  | R5 | 3.3K | RES_0402 | 1
11 |  |  | R15, R19 | 1M | RES_0402 | 2
12 |  |  | R1, R2, R6, R7, R11, R18 | 1K | RES_0402 | 6
13 |  |  | R12 | 120R | RES_0402 | 1
14 |  |  | R9, R10, R13 | 10K | RES_0402 | 3
15 |  |  | R14 | 1.8K | RES_0402 | 1
16 |  |  | R21, R22 | 0 | RES_0402 | 2
17 |  |  | R20 | 0R | 1206-RES | 1
18 |  |  | R3, R8 | 0.1R | 1206-RES | 2
19 |  |  | LED1, LED2 | LED GREEN | LED-0603 | 2
20 |  |  | L1 | 6.8uH | IND-201612 | 1
21 |  |  | K1, K2 | TACT 2P | ButtonTACT_3x4x2_180 | 2
22 |  |  | D3, D4 | 二极管-5819W | SOD-323 | 2
23 |  |  | D2 | SMBJ28CA | SMBJ-CA_MFG | 1
24 |  |  | D1 | SS54 | DO-214AC | 1
25 |  |  | C12, C13 | 20pF | CAP_0402 | 2
26 |  |  | C3, C10, C19, C22, C24 | 10uF | CAP_0402 | 5
27 |  |  | C16 | 100pF | CAP_0402 | 1
28 |  |  | C1, C2, C4, C5, C6, C7, C8, C9, C15, C17, C18, C21, C23, C25, C27, C28, C36 | 0.1uF | CAP_0402 | 17
29 |  |  | C11 | 220uF/25V | CAP-SMD_BD8.0-L8.3-W8.3-LS9.3-FD | 1
30 |  |  | C20, C29, C30, C31, C32 | 10uF/50V | 1206-CAP | 5
31 |  |  | P1, P2, P3 | Header 6H | CONN-TH_HC-ZH1.5-6A-s | 3
Note
1. 我使用的是木子晓文的v1.0.0版本的硬件，注意不是v1.0.1版本，这两个版本的主要区别是v1.0.1优化了2.0mm 6pin连接器的引脚顺序，具体的引脚顺序请参考下表，且v1.0.1版本PCB板上会有v1.0.1的丝印，理论上这两个版本的BOM是一样。请注意REF板和J1 Motor42板P1的连接需要使用同向线，J2-J6电机板直接的连接使用反向线，如果使用v1.0.0版本，则同向线的pin3/4需要交叉一下。 2. 木子晓文的开源地址: https://gitee.com/switchpi/dummy, 可以从这个链接获取两个版本的硬件设计文件和代码，也可以从B站不爱学习任同学的视频下方获取百度网盘的链接
 | v1.0.0 |  |  | v1.0.1
Pin number | REF P1 | Motor42 P1,P2 | Motor35 P1,P2 | REF P1 | Motor42 P1,P2 | Motor35 P1,P2
1 | VCC | VCC | VCC | VCC | VCC | VCC
2 | VCC | VCC | VCC | VCC | VCC | VCC
3 | CAN_H | CAN_L | CAN_L | GND | GND | GND
4 | CAN_L | CAN_H | CAN_H | GND | GND | GND
5 | GND | GND | GND | CAN_L | CAN_L | CAN_L
6 | GND | GND | GND | CAN_H | CAN_H | CAN_H

Sheet: Motor42
 | Sourced | Placed | References | Value | Footprint | Quantity
1 |  |  | Y1 | XTAL-4 | LC-SMD-3225_4P | 1
2 |  |  | U5 | SN65HVD232D | so-8 | 1
3 |  |  | U6 | ME3116 | SOT23-6 | 1
4 |  |  | U7 | LP2992 3V3 | SOT23-5 | 1
5 |  |  | U8 | MT6816 | SO-8 | 1
6 |  |  | U1, U2 | TB67H450FNG | SO-8-PAD | 2
7 |  |  | U3 | STM32F103CBT6 | LQFP-48 | 1
8 |  |  | S1 | DSHP04TSGER | SW-SMD_DSHP04TS-S | 1
9 |  |  | R4 | NCP15XH103F03RC | RES_0402 | 1
10 |  |  | R5 | 3.3K | RES_0402 | 1
11 |  |  | R15, R19 | 1M | RES_0402 | 2
12 |  |  | R1, R2, R6, R7, R11, R17, R18 | 1K | RES_0402 | 7
13 |  |  | R12 | 120R | RES_0402 | 1
14 |  |  | R9, R10, R13, R16 | 10K | RES_0402 | 4
15 |  |  | R14 | 1.8K | RES_0402 | 1
16 |  |  | R21, R22 | 0 | RES_0402 | 2
17 |  |  | R20 | 0R | 1206-RES | 1
18 |  |  | R3, R8 | 0.1R | 1206-RES | 2
19 |  |  | LED1, LED2 | LED GREEN | LED-0603 | 2
20 |  |  | L1 | 6.8uH | IND-201612 | 1
21 |  |  | K1, K2 | TACT 2P | ButtonTACT_3x4x2_180 | 2
22 |  |  | D3, D4 | 二极管-5819W | SOD-323 | 2
23 |  |  | D2 | SMBJ28CA | SMBJ-CA_MFG | 1
24 |  |  | D1 | SS54 | DO-214AC | 1
25 |  |  | C12, C13 | 20pF | CAP_0402 | 2
26 |  |  | C3, C10, C19, C22, C24 | 10uF | CAP_0402 | 5
27 |  |  | C16 | 100pF | CAP_0402 | 1
28 |  |  | C1, C2, C4, C5, C6, C7, C8, C9, C15, C17, C18, C21, C23, C25, C26, C27, C28, C35, C36 | 0.1uF | CAP_0402 | 19
29 |  |  | C11, C14 | 220uF/25V | CAP-SMD_BD8.0-L8.3-W8.3-LS9.3-FD | 2
30 |  |  | C20, C29, C30, C31, C32, C33, C34 | 10uF/50V | 1206-CAP | 7
31 |  |  | P1, P2, P3 | Header 6H | CONN-TH_HC-ZH1.5-6A-s | 3

Sheet: REF_Controller
 | Sourced | Placed | References | Value | Footprint | Quantity
1 |  |  | Y1 | XTAL-4 | LC-SMD-3225_4P | 1
2 |  |  | VT1 | S8050 | SMT_TRIODE_NPN | 1
3 |  |  | U8 | ME3116 | SOT23-6 | 1
4 |  |  | U3 | SY8089 2A | SOT23-5 | 1
5 |  |  | U11 | SN65HVD232D | SO-8 | 1
6 |  |  | U2 | ESP32_SIP | QFN-48_7X7 | 1
7 |  |  | U1 | CP2102 | QFN-28 | 1
8 |  |  | U10 | MPU6050 | QFN-24 | 1
9 |  |  | U7 | NRF24L01 | NRF24L01-MODULE | 1
10 |  |  | U12 | STM32F405RGT6 | LQFP-64_N | 1
11 |  |  | U4 | MLT-7525 | BUZ-SMD_4P-L7.5-W7.5-P7.59-TL | 1
12 |  |  | R22 | 560K | RES_0402_1 | 1
13 |  |  | R8, R9 | 5.1K | RES_0402_1 | 2
14 |  |  | R19, R20, R23 | 4.7K | RES_0402_1 | 3
15 |  |  | R7, R12, R17, R18 | 2K | RES_0402_1 | 4
16 |  |  | R35 | 22.1K | RES_0402_1 | 1
17 |  |  | R3 | 200R | RES_0402_1 | 1
18 |  |  | R16 | 1M | RES_0402_1 | 1
19 |  |  | R13 | 1K | RES_0402_1 | 1
20 |  |  | R4, R6 | 12K | RES_0402_1 | 2
21 |  |  | R24 | 120R/NC | RES_0402_1 | 1
22 |  |  | R1, R5, R10, R11, R15, R21, R28, R34 | 10K | RES_0402_1 | 8
23 |  |  | R33 | 100K | RES_0402_1 | 1
24 |  |  | R14 | 1.8K | RES_0402_1 | 1
25 |  |  | R2, R25, R26, R27, R29, R31 | 0R | RES_0402_1 | 6
26 |  |  | R30 | 1M | RES_0402 | 1
27 |  |  | Q1 | BC847BVC-7 | SOT563-6 | 1
28 |  |  | Q3 | AO3401A | SOT23-3 | 1
29 |  |  | Q2 | AO3400A | SOT23-3 | 1
30 |  |  | LED1 | LED GREEN | LED-0603 | 1
31 |  |  | L2 | 2.2uH | IND-252012A-2R2 | 1
32 |  |  | L1 | 6.8uH | IND-201612 | 1
33 |  |  | D4, D5 | 二极管-5819W | SOD-323 | 2
34 |  |  | D3 | SMBJ28CA | SMBJ-CA_MFG | 1
35 |  |  | D2 | SS54 | DO-214AC | 1
36 |  |  | C13 | 22pF | CAP_0402 | 1
37 |  |  | C7, C9 | 20pF | CAP_0402 | 2
38 |  |  | C24 | 2.2nF | CAP_0402 | 1
39 |  |  | C3 | 1uF | CAP_0402 | 1
40 |  |  | C1, C15, C26, C27, C33, C34, C35 | 10uF | CAP_0402 | 7
41 |  |  | C20 | 10nF | CAP_0402 | 1
42 |  |  | C11 | 100pF | CAP_0402 | 1
43 |  |  | C2, C4, C8, C12, C14, C18, C19, C21, C22, C23, C25, C28, C29, C30, C31, C32, C36, C37 | 0.1uF | CAP_0402 | 18
44 |  |  | C6 | 220uF/25V | CAP-SMD_BD8.0-L8.3-W8.3-LS9.3-FD | 1
45 |  |  | C16 | 4.7uF | C0603 | 1
46 |  |  | C5, C10, C17 | 22uF | C0603 | 3
47 |  |  | A1 | RAINSUN | ANT-Rainsun-AN5120 | 1
48 |  |  | 1 | OLED-12880 | OLED-12880 | 1
49 |  |  | P1 | Header 6H | CONN-TH_HC-ZH1.5-6A | 1
50 |  |  | P2 | Header 6H | CONN-TH_HC-ZH1.5-6A-s | 1
51 |  |  | P3 | Header 3 | CONN-TH_HC-ZH1.5-3A-S | 1
52 |  |  | J1 | USB-TYPE-C-STAND | USB-TYPE-C-STAND | 1

Sheet: 总价
 | 名称 | 价格
1 | 立创商城BOM | 467
2 | PCB打样 | 153.36
3 | 3D打印 | 42.37
4 | CNC结构件 | 1558
5 | 电机和减速器 | 1630
6 | 螺丝 | 39.24
 | 总价 | 3889.97

Sheet: 立创商城BOM
 |  |  |  |  | 合并了REF,电机板中相同的物料
REF Board |  | References | Value | Footprint | Total Quantity | 立创商城编号 | 购买数量 | 单价 | 总价 | 淘宝单价数量 | 淘宝购买数量 | 淘宝购买总价 | 余量 | Comments
 | 1 | Y1 | XTAL-4 | LC-SMD-3225_4P | 1 | C400090 | 5 | 0.7688 | 3.844 |  |  |  | 4 | 8MHz
 | 2 | VT1 | S8050 | SMT_TRIODE_NPN | 1 | C20069125 | 50 | 0.0638 | 3.19 |  |  |  | 49
 | 3 | U8 | ME3116 | SOT23-6 | 7 | C97643 | 10 | 0.8733 | 8.733 |  |  |  | 3
 | 4 | U3 | SY8089 2A | SOT23-5 | 1 | C479074 | 5 | 0.544 | 2.72 |  |  |  | 4
 | 5 | U11 | SN65HVD232D | SO-8 | 7 | C30530 | 7 | 5.19 | 36.33 |  |  |  | 0
 | 6 | U2 | ESP32_SIP | QFN-48_7X7 | 1 | C193707 | 1 | 26.49 | 26.49 |  |  |  | 0
 | 7 | U1 | CP2102 | QFN-28 | 1 | C964632 | 1 | 10.2 | 10.2 |  |  |  | 0
 | 8 | U10 | MPU6050 | QFN-24 | 1 | 自有 | 0 | 0 | 0 |  |  |  | 0
 | 9 | U7 | NRF24L01 | NRF24L01-MODULE | 1 |  | 0 | 0 | 0 | 3 | 2.74 | 8.22 | 0
 | 10 | U12 | STM32F405RGT6 | LQFP-64_N | 1 | C15742 | 1 | 29.96 | 29.96 |  |  |  | 0
 | 11 | U4 | MLT-7525 | BUZ-SMD_4P-L7.5-W7.5-P7.59-TL | 1 | C95299 | 5 | 1.4578 | 7.289 |  |  |  | 4
 | 12 | R22 | 560K | RES_0402_1 | 1 | C2909369 | 100 | 0.00304 | 0.304 |  |  |  | 99
 | 13 | R8, R9 | 5.1K | RES_0402_1 | 2 | 自有 | 0 | 0 | 0 |  |  |  | 0
 | 14 | R19, R20, R23 | 4.7K | RES_0402_1 | 3 | C25900 | 100 | 0.0061 | 0.61 |  |  |  | 97
 | 15 | R7, R12, R17, R18 | 2K | RES_0402_1 | 4 | 自有 | 0 | 0 | 0 |  |  |  | 0
 | 16 | R35 | 22.1K | RES_0402_1 | 1 | C2929993 | 100 | 0.00323 | 0.323 |  |  |  | 99
 | 17 | R3 | 200R | RES_0402_1 | 1 | C25087 | 100 | 0.005049 | 0.5049 |  |  |  | 99
 | 18 | R16,R30 | 1M | RES_0402_1 | 14 | C26083 | 100 | 0.006138 | 0.6138 |  |  |  | 86 | 2+6+6
 | 19 | R13 | 1K | RES_0402_1 | 40 | 自有 | 0 | 0 | 0 |  |  |  | 0
 | 20 | R4, R6 | 12K | RES_0402_1 | 2 | C25752 | 100 | 0.005544 | 0.5544 |  |  |  | 98
 | 21 | R24 | 120R | RES_0402_1 | 7 | 自有 | 0 | 0 | 0 |  |  |  | 0 | 1+3+3
 | 22 | R1, R5, R10, R11, R15, R21, R28, R34 | 10K | RES_0402_1 | 29 | 自有 | 0 | 0 | 0 |  |  |  | 0 | 8+12+9
 | 23 | R33 | 100K | RES_0402_1 | 1 | 自有 | 0 | 0 | 0 |  |  |  | 0
 | 24 | R14 | 1.8K | RES_0402_1 | 7 | C25871 | 100 | 0.0051 | 0.51 |  |  |  | 93
 | 25 | R2, R25, R26, R27, R29, R31 | 0R | RES_0402_1 | 18 | C106231 | 100 | 0.0048 | 0.48 |  |  |  | 82
 | 26 | Q1 | BC847BVC-7 | SOT563-6 | 1 | C150761 | 5 | 0.5853 | 2.9265 |  |  |  | 4
 | 27 | Q3 | AO3401A | SOT23-3 | 1 | C15127 | 10 | 0.3649 | 3.649 |  |  |  | 9
 | 28 | Q2 | AO3400A | SOT23-3 | 1 | C20917 | 5 | 0.4961 | 2.4805 |  |  |  | 4
 | 29 | LED1 | LED GREEN | LED-0603 | 13 | C12624 | 0 | 0 | 0 |  |  |  | 0
 | 30 | L2 | 2.2uH | IND-252012A-2R2 | 1 | C5380714 | 1 | 1.0108 | 1.0108 |  |  |  | 0
 | 31 | L1 | 6.8uH | IND-201612 | 7 | C2757911 | 10 | 0.3808 | 3.808 |  |  |  | 3
 | 32 | D4, D5 | 二极管-5819W | SOD-323 | 14 | C2927280 | 15 | 0.0597 | 0.8955 |  |  |  | 1
 | 33 | D3 | SMBJ28CA | SMBJ-CA_MFG | 7 | C19077583 | 10 | 0.3189 | 3.189 |  |  |  | 3
 | 34 | D2 | SS54 | DO-214AC | 7 | C7420369 | 10 | 0.2764 | 2.764 |  |  |  | 3
 | 35 | C13 | 22pF | CAP_0402 | 1 | C1555 | 100 | 0.008118 | 0.8118 |  |  |  | 99
 | 36 | C7, C9 | 20pF | CAP_0402 | 14 | C107000 | 100 | 0.0068 | 0.68 |  |  |  | 86
 | 37 | C24 | 2.2nF | CAP_0402 | 1 | C1531 | 100 | 0.0076 | 0.76 |  |  |  | 99
 | 38 | C3 | 1uF | CAP_0402 | 1 | 自有 | 0 | 0 | 0 |  |  |  | 0
 | 39 | C1, C15, C26, C27, C33, C34, C35 | 10uF | CAP_0402 | 37 | C6119763 | 50 | 0.0439 | 2.195 |  |  |  | 13
 | 40 | C20 | 10nF | CAP_0402 | 1 | C60133 | 100 | 0.0065 | 0.65 |  |  |  | 99
 | 41 | C11 | 100pF | CAP_0402 | 7 | C5137573 | 100 | 0.00513 | 0.513 |  |  |  | 93
 | 42 | C2, C4, C8, C12, C14, C18, C19, C21, C22, C23, C25, C28, C29, C30, C31, C32, C36, C37 | 0.1uF | CAP_0402 | 126 | C5137468 | 200 | 0.005225 | 1.045 |  |  |  | 74
 | 43 | C6 | 220uF/25V | CAP-SMD_BD8.0-L8.3-W8.3-LS9.3-FD | 10 | C2918361 | 20 | 0.2035 | 4.07 |  |  |  | 10
 | 44 | C16 | 4.7uF | C0603 | 1 | C6119856 | 50 | 0.0776 | 3.88 |  |  |  | 49
 | 45 | C5, C10, C17 | 22uF | C0603 | 3 | C6119868 | 10 | 0.2345 | 2.345 |  |  |  | 7
 | 46 | A1 | RAINSUN | ANT-Rainsun-AN5120 | 1 | C99727 | 1 | 2.54 | 2.54 |  |  |  | 0
 | 47 | OLED-12880 | OLED-12880 | OLED-12880 | 1 | C5123562 | 0 | 0 | 0 | 2 | 7 | 14 | 1
 | 48 | P1 | Header 6H | CONN-TH_HC-ZH1.5-6A | 1 | C2845554 | 10 | 0.4153 | 4.153 |  |  |  | 9
 | 49 | P2 | Header 6H | CONN-TH_HC-ZH1.5-6A-s | 19 | C2845554 | 20 | 0.4242 | 8.484 |  |  |  | 1
 | 50 | P3 | Header 3 | CONN-TH_HC-ZH1.5-3A-S | 1 | C2845551 | 20 | 0.2197 | 4.394 |  |  |  | 19
 | 51 | J1 | USB-TYPE-C-STAND | USB-TYPE-C-STAND | 1 | C7450622 | 5 | 1.84965 | 9.24825 |  |  |  | 4
Motrol Board | 52 | Y1 | XTAL-4 | LC-SMD-3225_4P | 6 | C5280576 | 10 | 0.396312 | 3.96312 |  |  |  | 4 | 12MHz
 | 53 | U7 | LP2992 3V3 | SOT23-5 | 6 | C5370974 | 10 | 0.6631 | 6.631 |  |  |  | 4
 | 54 | U8 | MT6816 | SO-8 | 6 | C5449395 | 6 | 9.67 | 58.02 |  |  |  | 0
 | 55 | U1, U2 | TB67H450FNG | SO-8-PAD | 12 | C545417 | 12 | 3.42 | 41.04 |  |  |  | 0
 | 56 | U3 | STM32F103CBT6 | LQFP-48 | 6 | C279569 | 6 | 13.82 | 82.92 |  |  |  | 0
 | 57 | S1 | DSHP04TSGER | SW-SMD_DSHP04TS-S | 6 | C319050 | 6 | 2.831 | 16.986 |  |  |  | 0
 | 58 | R4 | NCP15XH103F03RC | RES_0402 | 6 | C77131 | 50 | 0.0674 | 3.37 |  |  |  | 44
 | 59 | R5 | 3.3K | RES_0402 | 6 | C25890 | 100 | 0.005445 | 0.5445 |  |  |  | 94
 | 60 | R12 | 120R | RES_0402 | 6 | C2909315 | 100 | 0.00315 | 0.315 |  |  |  | 94
 | 61 | R3, R8 | 0.1R | 1206-RES | 12 | C25334 | 50 | 0.045837 | 2.29185 |  |  |  | 38
 | 62 | K1, K2 | TACT 2P | ButtonTACT_3x4x2_180 | 12 | C561517 | 20 | 0.423415 | 8.4683 |  |  |  | 8
 | 63 | C20, C29, C30, C31, C32, C33, C34 | 10uF/50V | 1206-CAP | 36 | C7432781 | 40 | 0.2316 | 9.264 |  |  |  | 4
 | 64 | R20 | 0R | 1206-RES | 6 | C49164949 | 10 | 0.29 | 2.9 |  |  |  | 4
Led Ring board | 65 | D1,D2,D3,D4,D5,D6,D7,D8,D9,D10,D11,D12 | WS2812B | 5050 | 12 | C2761795 | 15 | 0.6 | 9 |  |  |  | 3
 |  |  |  |  |  |  |  |  | 444.86222 |  |  | 22.22
 |  |  |  |  |  |  |  |  |  |  | BOM总价 | 467.08222
 |  | NRF24L01-MODULE | 迷你版 NRF24L01 无线模块 功率加强版 2.4G无线收发模块-淘宝网 (https://item.taobao.com/item.htm?id=40352572949)
 |  | OLED-12880 | 0.78寸OLED液晶显示屏128x80驱动SH1107接口IIC/SPI白光4针模块-淘宝网 (https://item.taobao.com/item.htm?id=789310228166)
Note
1. 我使用的是木子晓文的v1.0.0版本的硬件，注意不是v1.0.1版本，这两个版本的主要区别是v1.0.1优化了2.0mm 6pin连接器的引脚顺序，具体的引脚顺序请参考下表，且v1.0.1版本PCB板上会有v1.0.1的丝印，理论上这两个版本的BOM是一样。请注意REF板和J1 Motor42板P1的连接需要使用同向线，J2-J6电机板直接的连接使用反向线，如果使用v1.0.0版本，则同向线的pin3/4需要交叉一下。 2. 木子晓文的开源地址: https://gitee.com/switchpi/dummy, 可以从这个链接获取两个版本的硬件设计文件和代码，也可以从B站不爱学习任同学的视频下方获取百度网盘的链接
 | v1.0.0 |  |  | v1.0.1
Pin number | REF P1 | Motor42 P1,P2 | Motor35 P1,P2 | REF P1 | Motor42 P1,P2 | Motor35 P1,P2
1 | VCC | VCC | VCC | VCC | VCC | VCC
2 | VCC | VCC | VCC | VCC | VCC | VCC
3 | CAN_H | CAN_L | CAN_L | GND | GND | GND
4 | CAN_L | CAN_H | CAN_H | GND | GND | GND
5 | GND | GND | GND | CAN_L | CAN_L | CAN_L
6 | GND | GND | GND | CAN_H | CAN_H | CAN_H

Sheet: PCB打样
嘉立创PCB打样 |  |  |  | 我的嘉立创PCB打样
 | 名称 | 数量 | 价格 |  | 名称 | 数量 | 价格
1 | Ref板 | 5 | 57.24 | 1 | Ref板 | 5 | 58.3
2 | 42电机板 | 5 | 35.64 | 2 | 42电机板 | 5 | 36.3
3 | 35电机板 | 5 | 35.64 | 3 | 35电机板 | 5 | 36.3
4 | LedRing | 5 | 24.84 | 4 | LedRing | 5 | 22
 | 总价 |  | 153.36 |  | 总价 |  | 152.9

Sheet: 3D打印
嘉立创3D打印
 | 名称 | 数量 | 单价 | 价格
1 | 35电机底板 | 3 | 2.32 | 6.96
2 | 35电机顶板 | 3 | 2.96 | 8.88
3 | 42电机底板 | 3 | 2.49 | 7.47
4 | 42电机顶板 | 3 | 3.64 | 10.92
5 | 税费+运费 |  |  | 8.14
 | 总价 |  |  | 42.37
如果是准备用任同学DummyV2版本的CNC结构件，这里建议使用任同学版本的模型，我的视频中用的是木子晓文的模型

Sheet: CNC结构件
CNC结构件 (咸鱼购买)
 | 名称 | 价格
1 | 全套CNC包括底座 | 1435
2 | CNC底板 | 123
 | 总价 | 1558

Sheet: 电机和减速器
 | 名称 | 型号 | 数量 | 单价 | 总价 | 购买连接 | 备注
1 | 42电机 | l=40 1A, MT-1703HS168A | 3 | 35 | 105 | https://item.taobao.com/item.htm?id=549501040122 | 需要自己安装径向磁铁
2 | 35电机 | I=28 , 轴长24cm, 35HS2808A4 | 1 | 24.6 | 24.6 | 35步进电机微型小电机身长28mm力矩12Ncm四线单双轴35byg步进马达-淘宝网 (https://item.taobao.com/item.htm?id=15168111895) | 需要自己安装径向磁铁，如果不考虑价格，建议大家直接购买下面的那款带径向磁铁的
3 | 35电机 | I=28 , 轴长19 | 1 | 29.99 | 29.99 | 35步进电机带磁柱孔马达两相四线雕刻机写字机闭环加装3D打印配件-淘宝网 (https://item.taobao.com/item.htm?id=723690490192) | J4电机，需要配合法兰盘和Mini11减速器安装在一起，电机轴不能太长了
4 | 35电机 | I=20, 35BYGH20 | 1 | 25 | 25 | 35步进电机带磁柱孔马达两相四线雕刻机写字机闭环加装3D打印配件-淘宝网 (https://item.taobao.com/item.htm?id=919770674722) | J6电机
5 | 谐波减速器 | MINIF11-50-B | 4 | 260 | 1040 | https://item.taobao.com/item.htm?id=902846205607 | 4个Mini11，1个Mini8是任同学V2的配置，如果是复刻稚晖君原版或者木子晓汶版机械臂，则谐波减速器的配置是不同的
6 | 谐波减速器 | MINIF8-50-B | 1 | 300 | 300 | https://item.taobao.com/item.htm?id=902846205607
7 | 同步轮 | 20齿轮内孔5mm外径18 | 6 | 2.91 | 17.46 | 2gt同步轮 电机皮带轮同步带从动轮 3d打印机配件16-40齿带宽6mm-淘宝网 (https://item.taobao.com/item.htm?id=625483500699)
8 | 传动皮带 | 2gt-6-150， 150mm | 1 | 4.47 | 4.47 | 3D打印机2GT环形闭口闭环同步带 橡胶传动皮带gt2 周长110-1524mm-淘宝网 (https://item.taobao.com/item.htm?id=626759355655&sku_properties=148226461:3629053) | 连接J5的电机和减速器
9 | 传动皮带 | 2gt-6-130， 130mm | 2 | 4.58 | 9.16 | 3D打印机2GT环形闭口闭环同步带 橡胶传动皮带gt2 周长110-1524mm-淘宝网 (https://item.taobao.com/item.htm?id=626759355655&sku_properties=148226461:3629053) | 连接J2,J3的电机和减速器
10 | 6pin排线 | ZH1.5mm, 6pin/3pin, | 8 |  | 7.34 | 连接线 ZH1.5mm电子线 2P/3/4/5/6Pin 5-30cm 单头/双头同向/反向-淘宝网 (https://item.taobao.com/item.htm?id=944567579547) | 这个链接里都是同向线，我是自己把其中的5条改成了反向线了，建议大家直接买反向线，也需要考虑SWD下载线和LEDring板子的连线 6根电机连接线，1根SWD下载线，一根LEDring的连接线
11 | 6pin排线 | PH2.0mm, 6pin | 6 | 0.77 | 4.62 | PH2.0-2/3/4/5/6/7/8/9/10P 电子线端子线 单头镀锡 长30CM连接线-淘宝网 (https://item.taobao.com/item.htm?id=558147874154)
12 | 电源开关 | 开孔直径：16mm，12-24v，高头环形灯，自锁 | 1 | 4.8 | 4.8 | 金属按钮12/16/19/22mm带灯5V12V24V220V不锈钢点动自锁复位开关-淘宝网 (https://item.taobao.com/item.htm?id=589544046782)
13 | DC电源插座 | DC5.5*2.5mm | 1 | 2.7 | 2.7 | https://item.taobao.com/item.htm?id=679108658727
14 | 电源 | 24v 6a | 1 | 31 | 31 | 原装爱普生 24V6A电源适配器 24V6A 5A4A通用监控显示器24V8A电源-淘宝网 (https://item.taobao.com/item.htm?id=552809889509)
15 | 内六角螺丝刀套装 | 0.71mm-3mm | 1 | 8.4 | 8.4 | 绿林内六角扳手套装6角螺丝刀六角匙工具六棱内六方工业级L型迷你-淘宝网 (https://item.taobao.com/item.htm?id=659783460801)
16 | 径向磁铁 | N52径向充磁，6x3mm | 6 | 0.7 | 4.2 | N52圆形径向充磁钕铁硼强力磁铁圆柱侧面充磁强磁吸铁石特殊充磁-淘宝网 (https://item.taobao.com/item.htm?id=958611899677)
17 | 轴承 | 5x13x4 | 10 | 0.88 | 8.8 | https://detail.tmall.com/item.htm?id=611796709407
18 | 圆柱销 | 直径5，长35mm | 10 | 0.264 | 2.64 | https://detail.tmall.com/item.htm?id=617042322309
总价 |  |  |  |  | 1630.18

Sheet: 螺丝
 | 型号 | 数量 | 价格 | 购买链接
 | M3x8 | 100 | 3.44 | 304不锈钢内六角螺丝钉圆柱头杯头螺栓加长M2M3M4M5M6M8M10M12M16-tmall.com天猫 (https://detail.tmall.com/item.htm?id=587639753812)
 | M3x12 | 20 | 2.24 | 304不锈钢圆柱头内六角螺丝杯头螺栓M3*x3x7x9x11x13x15x17x23-32-淘宝网 (https://item.taobao.com/item.htm?id=655646005874)
 | M3x15 | 20 | 1.96 | 304不锈钢圆柱头内六角螺丝杯头螺栓M3*x3x7x9x11x13x15x17x23-32-淘宝网 (https://item.taobao.com/item.htm?id=655646005874)
 | M3x8 | 100 | 3.4 | 304不锈钢内六角螺丝钉圆柱头杯头螺栓加长M2M3M4M5M6M8M10M12M16-tmall.com天猫 (https://detail.tmall.com/item.htm?id=587639753812)
 | M3x20 | 50 | 2.82 | 304不锈钢内六角螺丝钉圆柱头杯头螺栓加长M2M3M4M5M6M8M10M12M16-tmall.com天猫 (https://detail.tmall.com/item.htm?id=587639753812)
 | M3x25 | 10 | 1.49 | 304不锈钢圆柱头内六角螺丝杯头螺栓M3*x3x7x9x11x13x15x17x23-32-淘宝网 (https://item.taobao.com/item.htm?id=655646005874)
 | M3x28 | 10 | 1.68 | 304不锈钢圆柱头内六角螺丝杯头螺栓M3*x3x7x9x11x13x15x17x23-32-淘宝网 (https://item.taobao.com/item.htm?id=655646005874)
 | M3x30 | 50 | 3.88 | 304不锈钢内六角螺丝钉圆柱头杯头螺栓加长M2M3M4M5M6M8M10M12M16-tmall.com天猫 (https://detail.tmall.com/item.htm?id=587639753812)
 | M3x35 | 50 | 5.04 | 304不锈钢内六角螺丝钉圆柱头杯头螺栓加长M2M3M4M5M6M8M10M12M16-tmall.com天猫 (https://detail.tmall.com/item.htm?id=587639753812)
 | M3x45 | 20 | 2.46 | 304不锈钢内六角螺丝钉圆柱头杯头螺栓加长M2M3M4M5M6M8M10M12M16-tmall.com天猫 (https://detail.tmall.com/item.htm?id=587639753812)
 | M4x12 | 50 | 3.21 | 304不锈钢内六角螺丝钉圆柱头杯头螺栓加长M2M3M4M5M6M8M10M12M16-tmall.com天猫 (https://detail.tmall.com/item.htm?id=587639753812)
 | M4x22 | 50 | 4.64 | 304不锈钢内六角螺丝钉圆柱头杯头螺栓加长M2M3M4M5M6M8M10M12M16-tmall.com天猫 (https://detail.tmall.com/item.htm?id=587639753812)
 | M4x30 | 50 | 2.43 | 304不锈钢内六角螺丝钉圆柱头杯头螺栓加长M2M3M4M5M6M8M10M12M16-tmall.com天猫 (https://detail.tmall.com/item.htm?id=587639753812)
 | M4x35 | 20 | 0.55 | 304不锈钢内六角螺丝钉圆柱头杯头螺栓加长M2M3M4M5M6M8M10M12M16-tmall.com天猫 (https://detail.tmall.com/item.htm?id=587639753812)
总价 |  |  | 39.24
