MARS-ROBOTICS-star/Dummy-Robot-Reproduction/source/1.Dummy V2任同学整理/5.Bom/立创商城BOM模板.xlsx

序号 | 型号 | 封装 | 参数/规格 | 单套用量 | 品牌 | 分类 | 商品编号 | 物料编码 | 位号
1 | 1N4007W | SOD-123 | 100V 150mA 1uA@75V 4ns | 6 | R+O(宏嘉诚) | 开关二极管 | C7420318 |  | D8
2 | MAX3232ESE+ | SOIC-16 |  | 1 | MAXIM | 收发器 | C143435 |  | U1
3 | CC0603KRX7R9BB104 | 0603 | 100NF ±10% 50V | 3 | YAGEO | 贴片电容 | C14663 |  | C10
4 |  |  | 螺母 DIN934 M6*1 六角 304不锈钢 | 10 | AOFENG | 螺母 | C5210484
5 | MF40102VX-1Q03C-A99 |  | 40×40×10mm 10000RPM 1.92W 24V 11CFM 80mA 直流散热风扇 | 5 | SUNON | 散热风扇 | C456910
说明： 1. 请将序号1-6行示例内容删除！ 2. “型号”、“参数”、“封装”或“名称/描述”列不能同时为空 3. “单套用量”列不能为空或0 4. 物料编码即您自己对于该物料的自定义编码
