MARS-ROBOTICS-star/Dummy-Robot-Reproduction/source/1.Dummy V2任同学整理/4.Model/Dummy V2 版本 视频款/Dummy-B v2装配体.step

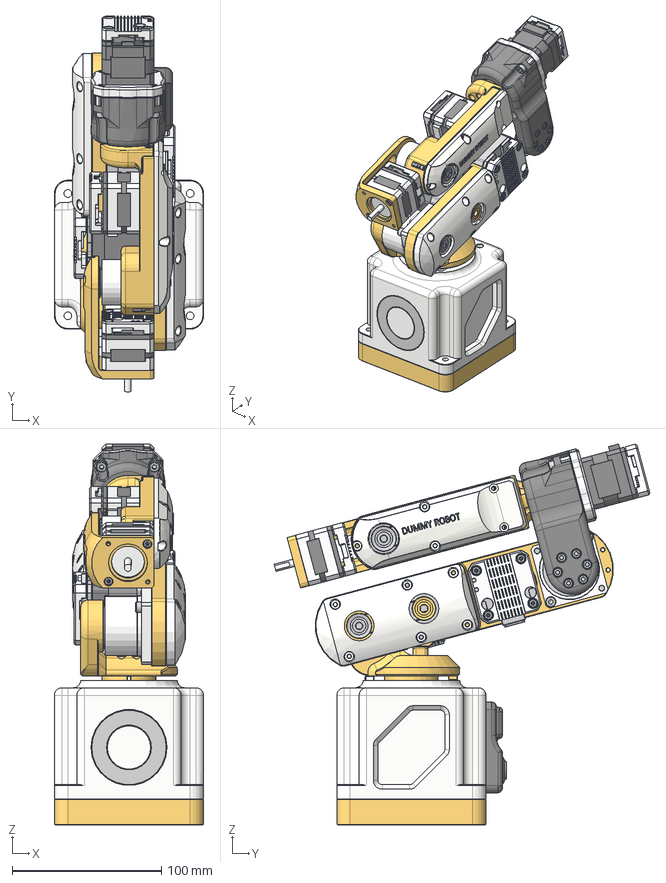
[picture p15: CAD file, 2026-10-22]
source/1.Dummy V2任同学整理/4.Model/Dummy V2 版本 视频款/Dummy-B v2装配体.step
100.0 x 252.0 x 255.5 mm
Dummy-0001
内六角螺丝 M3 x 14 x 12
42-34步进电机 x 2
Dummy-0018 x 3
Dummy-0019 x 3
42-40步进电机
NSK 轴承 695ZZ x 3
Dummy-0009
D字轴 5-30 x 2
TB 同步轮 GPA20GT2060-B-H5 x 3
普赢 减速机 minif-11-50 x 4
TB 同步轮 GPA20GT2060-A-H5 x 3
TB 同步带 GBN1302GT-60 x 2
Dummy-0012（外壳） x 2
Dummy-0013 x 2
Dummy-0036 x 6
内六角螺丝 M4-16 x 10
内六角螺丝 M4-12 x 8
平垫片 M3 x 12
内六角螺丝 M3 x 10 x 8
内六角螺丝 M3-45 x 4
内六角螺丝 M3-40 x 8
Dummy-0020 x 3
Dummy-0021 x 3
35-28步进电机
内六角螺丝 M3 x 16 x 14
Dummy-0022
Dummy-0008
内六角螺丝 M3-35 x 2
内六角螺丝 M3-8 x 11
普赢min8-50 谐波减速器
Dummy-0026
Dummy-0027
D字轴5-28
35-20步进电机 x 2
Dummy-0002
Dummy-0007(外壳)
TB 同步带 GBN1502GT-60
内六角螺丝 M3-10 x 7
Dummy-0011
内六角螺丝 M3-25 x 8
Dummy-0003
内六角螺丝 M3-5 x 4
Metal LED Illuminated Latching 16mm Power Push Button ON-OFF Switch 1 _2V (1)
DC5V_JACK
Dummy-0017
Dummy-0035
hex nuts, style 1-grades ab gb(GB_FASTENER_NUT_SNAB1 M3-N) x 4
Dummy-0004
Dummy-0006
Dummy-0016
Dummy-0037
内六角螺丝 M4-20 x 2
