MARS-ROBOTICS-star/Dummy-Robot-Reproduction/source/1.Dummy V2任同学整理/4.Model/稚晖君原版模型/Dummy v164.step

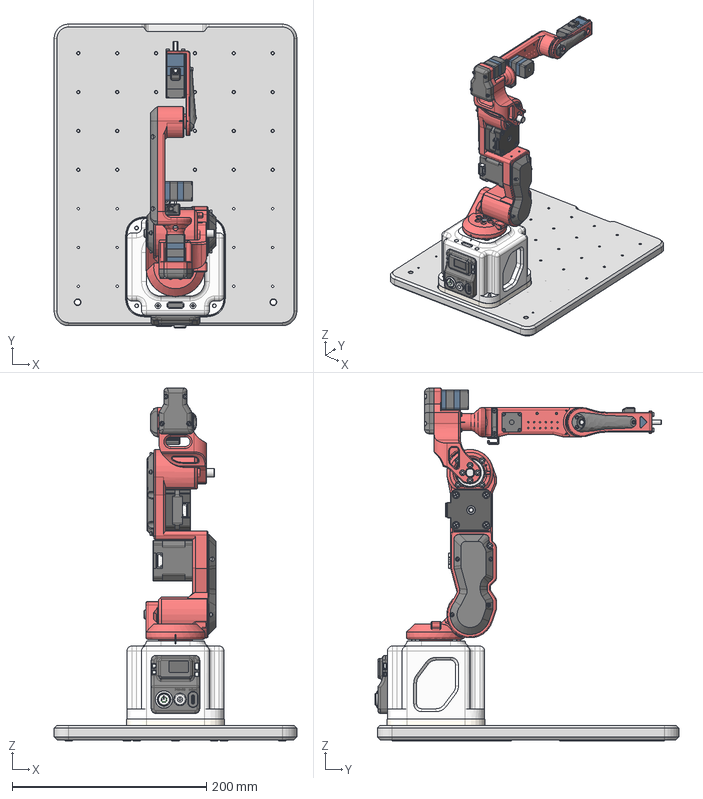
[picture p16: CAD file, 2026-10-22]
source/1.Dummy V2任同学整理/4.Model/稚晖君原版模型/Dummy v164.step
250.0 x 312.8 x 363.4 mm
3D打印盖
金属件
PK513PA-H50S v1
SH03W_KORP (3) (1) (1)
SHXX_PIN_(1) (3) (1) (1)
SHXX_PIN_2 (3) (1) (1)
金属件 (6)
零部件59
1375K176_MXL SERIES TIMING BELT PULLEY (2)
1375K176_MXL SERIES TIMING BELT PULLEY (3)
3D打印件
CSF-5-30-1U v2
PK513PA-H50S v2 (1) x 2
3D打印件 (1)
1375K176_MXL SERIES TIMING BELT PULLEY
1375K176_MXL SERIES TIMING BELT PULLEY (1)
金属件 (2)
CSF-5-30-1U v2 (1)
金属件 (3)
Nema 17_Slim
1375K179_MXL SERIES TIMING BELT PULLEY (1)
1375K179_MXL SERIES TIMING BELT PULLEY
3D打印件 (2)
3D打印件 (3)
CSF-8-30-1U v2
Nema17 Stepper Motor v1
CSF-8-30-1U v2 (1)
金属件 (4)
零部件41
CRK543AP-H50 v2
金属件 (5)
亚克力
M3 x 12 x 8
M3 x 18 x 6
M3 x 16 x 4
M3 x 10 x 8
M3 x 15 x 4
M2 x 5 x 13
M3 x 8 x 4
M2 x 6 x 23
M2 x 8 x 7
M2 x 20 x 3
M3 x 14 x 2
零部件69
零部件71
零部件73
零部件70
零部件75
零部件77
零部件74
零部件76
零部件72
垫片
Metal LED Illuminated Latching 16mm Power Push Button ON-OFF Switch 1 2V (1)
Metal LED Illuminated Latching 16mm Power Push Button ON-OFF Switch 1 2V (2)
DC5V_JACK
Open_CASCADE_STEP_translator_6.8_54.1.1 (7) x 8
Open_CASCADE_STEP_translator_6.8_54.1.2 (7) x 8
Open_CASCADE_STEP_translator_6.8_54.2.1 (7) x 8
Open_CASCADE_STEP_translator_6.8_54.1.1 (1) (4) x 3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
