MARS-ROBOTICS-star/Dummy-Robot-Reproduction/(list of files, cad)

Other CAD files:
source/1.Dummy V2任同学整理/4.Model/Dummy V2 版本 视频款/改版/35-28Motor Assembly.STEP.SLDASM
source/1.Dummy V2任同学整理/4.Model/Dummy V2 版本 视频款/改版/J4.STEP.SLDASM
source/1.Dummy V2任同学整理/4.Model/Dummy V2 版本 视频款/改版/BASE Moudle-普赢.STEP.SLDASM
source/1.Dummy V2任同学整理/4.Model/Dummy V2 版本 视频款/改版/35-20Motor Assembly.STEP.SLDASM
source/1.Dummy V2任同学整理/4.Model/Dummy V2 版本 视频款/改版/普赢改轴输入.STEP.SLDASM
source/1.Dummy V2任同学整理/4.Model/Dummy V2 版本 视频款/改版/35Motor Driver-1.STEP.SLDASM
source/1.Dummy V2任同学整理/4.Model/Dummy V2 版本 视频款/改版/42-40Motor Assembly.STEP.SLDASM
source/1.Dummy V2任同学整理/4.Model/Dummy V2 版本 视频款/改版/42-34Motor Assembly.STEP.SLDASM
source/1.Dummy V2任同学整理/4.Model/Dummy V2 版本 视频款/改版/J2&J3.STEP.SLDASM
source/1.Dummy V2任同学整理/4.Model/Dummy V2 版本 视频款/改版/35Motor Driver.STEP.SLDASM
source/1.Dummy V2任同学整理/4.Model/Dummy V2 版本 视频款/改版/J6.STEP.SLDASM
source/1.Dummy V2任同学整理/4.Model/Dummy V2 版本 视频款/改版/J5.STEP.SLDASM
source/1.Dummy V2任同学整理/4.Model/Dummy V2 版本 视频款/改版/35-20Motor Assembly-1.STEP.SLDASM
source/1.Dummy V2任同学整理/4.Model/Dummy V2 版本 视频款/改版/J1.STEP.SLDASM
source/1.Dummy V2任同学整理/4.Model/Dummy V2 版本 视频款/改版/35Motor Driver-2.STEP.SLDASM
source/1.Dummy V2任同学整理/4.Model/Dummy V2 版本 视频款/改版/42-40步进电机.STEP.SLDPRT
source/1.Dummy V2任同学整理/4.Model/Dummy V2 版本 视频款/改版/Dummy-0001.STEP.SLDPRT
source/1.Dummy V2任同学整理/4.Model/Dummy V2 版本 视频款/改版/D字轴 5-30.STEP.SLDPRT
source/1.Dummy V2任同学整理/4.Model/Dummy V2 版本 视频款/改版/Dummy-0011.STEP.SLDPRT
source/1.Dummy V2任同学整理/4.Model/Dummy V2 版本 视频款/改版/Dummy-0020.STEP.SLDPRT
source/1.Dummy V2任同学整理/4.Model/Dummy V2 版本 视频款/改版/内六角螺丝 M3 x 16.STEP.SLDPRT
source/1.Dummy V2任同学整理/4.Model/Dummy V2 版本 视频款/改版/Dummy-0022.STEP.SLDPRT
source/1.Dummy V2任同学整理/4.Model/Dummy V2 版本 视频款/改版/TB 同步带 GBN1302GT-60.STEP.SLDPRT
source/1.Dummy V2任同学整理/4.Model/Dummy V2 版本 视频款/改版/Dummy-0003.STEP.SLDPRT
source/1.Dummy V2任同学整理/4.Model/Dummy V2 版本 视频款/改版/Dummy-0008.STEP.SLDPRT
source/1.Dummy V2任同学整理/4.Model/Dummy V2 版本 视频款/改版/Dummy-0021.STEP.SLDPRT
source/1.Dummy V2任同学整理/4.Model/Dummy V2 版本 视频款/改版/平垫片 M3.STEP.SLDPRT
source/1.Dummy V2任同学整理/4.Model/Dummy V2 版本 视频款/改版/Dummy-0012（外壳）.STEP.SLDPRT
source/1.Dummy V2任同学整理/4.Model/Dummy V2 版本 视频款/改版/Dummy-0013.STEP.SLDPRT
source/1.Dummy V2任同学整理/4.Model/Dummy V2 版本 视频款/改版/TB 同步带 GBN1502GT-60.STEP.SLDPRT
source/1.Dummy V2任同学整理/4.Model/Dummy V2 版本 视频款/改版/Dummy-0009.STEP.SLDPRT
source/1.Dummy V2任同学整理/4.Model/Dummy V2 版本 视频款/改版/35-28步进电机.STEP.SLDPRT
source/1.Dummy V2任同学整理/4.Model/Dummy V2 版本 视频款/改版/NSK 轴承 695ZZ.STEP.SLDPRT
source/1.Dummy V2任同学整理/4.Model/Dummy V2 版本 视频款/改版/TB 同步轮 GPA20GT2060-B-H5.STEP.SLDPRT
source/1.Dummy V2任同学整理/4.Model/Dummy V2 版本 视频款/改版/普赢min8-50 谐波减速器.STEP.SLDPRT
source/1.Dummy V2任同学整理/4.Model/Dummy V2 版本 视频款/改版/Dummy-0026.STEP.SLDPRT
source/1.Dummy V2任同学整理/4.Model/Dummy V2 版本 视频款/改版/Dummy-0036.STEP.SLDPRT
source/1.Dummy V2任同学整理/4.Model/Dummy V2 版本 视频款/改版/内六角螺丝 M3-35.STEP.SLDPRT
source/1.Dummy V2任同学整理/4.Model/Dummy V2 版本 视频款/改版/D字轴5-28.STEP.SLDPRT
source/1.Dummy V2任同学整理/4.Model/Dummy V2 版本 视频款/改版/TB 同步轮 GPA20GT2060-A-H5.STEP.SLDPRT
source/1.Dummy V2任同学整理/4.Model/Dummy V2 版本 视频款/改版/内六角螺丝 M3-25.STEP.SLDPRT
source/1.Dummy V2任同学整理/4.Model/Dummy V2 版本 视频款/改版/Dummy-0007(外壳).STEP.SLDPRT
source/1.Dummy V2任同学整理/4.Model/Dummy V2 版本 视频款/改版/35-20步进电机.STEP.SLDPRT
source/1.Dummy V2任同学整理/4.Model/Dummy V2 版本 视频款/改版/内六角螺丝 M3 x 14.STEP.SLDPRT
source/1.Dummy V2任同学整理/4.Model/Dummy V2 版本 视频款/改版/内六角螺丝 M3-45.STEP.SLDPRT
source/1.Dummy V2任同学整理/4.Model/Dummy V2 版本 视频款/改版/内六角螺丝 M3 x 10.STEP.SLDPRT
source/1.Dummy V2任同学整理/4.Model/Dummy V2 版本 视频款/改版/Dummy-0002.STEP.SLDPRT
source/1.Dummy V2任同学整理/4.Model/Dummy V2 版本 视频款/改版/Dummy-0027.STEP.SLDPRT
