MARS-ROBOTICS-star/Dummy-Robot-Reproduction/notes/任同学视频字幕/srt_术语修正/11_Dummy机械臂整机调试教程.txt

[00:05] B站的小伙伴们大家好
[00:07] 我是不爱学习的任同学
[00:09] 经过前面十几期的课程
[00:11] 我相信已经有很多朋友已经复刻完成了
[00:14] 可能就剩下一些这个一些小问题没有解决呃
[00:18] 有很多朋友这个加了这个微信的交流群
[00:21] 然后呢并且呢分享了他们的这个复刻成功
[00:25] 也提了很多问题
[00:26] 我有时间一般都会回复
[00:29] 今天呢给大家呢
[00:30] 就是带来一个调试方面的一个视频呃
[00:34] 和一些就是说我发现的问题
[00:37] 大家提出的问题
[00:39] 我给大家进行一个简单的解答
[00:40] 因为平时工作比较忙呃
[00:43] 确实腾不出太多时间
[00:45] 而且最近呢也给大家发了很多这个团购的车呃
[00:49] 降低了这个呃一些成本
[00:52] CAC的成本呃
[00:54] PCB的成本
[00:55] 还有一些减速器的成本呃
[00:58] 希望每一个这个想复刻成功Dummy 机械臂的
[01:03] 这个朋友们都能复刻成功
[01:06] 后面呢我希望大家能多多关注呃
[01:09] 任同学还会分享更多好玩的东西
[01:11] 带大家一起进步
[01:13] 一起去制作一些小玩意儿
[01:17] 添加一些生活上的乐趣
[01:19] 呃下面呢就是我们开始今天的课程啊
[01:23] 我先那个简单讲一下
[01:25] 就是我们这个百度云文件里面的这些东西
[01:30] 因为我发现有很多人其实并拿到手里
[01:32] 下载这个百度云文件
[01:34] 并不知道这里边都是些什么啊
[01:36] 就比较手足无措
[01:38] 咱说了是保姆级的
[01:39] 一定要做到保姆级啊
[01:42] 首先呢我先带大家看一下这个
[01:45] 就是说我们下下来的这个百度云的文件是怎么
[01:51] 里边东西都是什么
[01:52] 因为很多人都问我啊
[01:53] 就搞得额我其实也很迷茫哈
[01:57] 也很困惑
[01:57] 所以说今天呢简单的给大家简介绍一下呃
[02:00] 首先呢呃这六个文件其实打开任何开源文件
[02:05] 如果有read me的时候
[02:06] 我们一定要去读一读
[02:07] 作者一般会把一些基本内容告诉大家
[02:12] 你看这个都是也写的很清楚
[02:15] 包括目录的介绍
[02:16] 还有一些我们论坛的链接
[02:19] 虚拟机的链接
[02:21] 这个串口助手的链接
[02:22] 烧录工具的链接对吧
[02:25] 这个Fusion 360
[02:26] 这些vs code好
[02:32] 我们先从第一个开始看啊
[02:34] 这个就是我们的PCB文件的这个PCB
[02:39] 原这个这个硬件啊
[02:41] 还有一些呃这些Gerber 文件啊
[02:44] Gerber 文件就是我们用来打板的
[02:46] 尽量不要把PCB这个点
[02:49] 这个就是这个PCB点
[02:51] DOS文件直接给到这个嘉立创啊
[02:55] 还是谁
[02:56] 因为大家可以这个根据上面的东西
[02:59] 直接就复刻出来了
[03:00] 当然大厂可能不需不会这么做哈
[03:03] 但接下我们给的是Gerber 文件
[03:06] 呃怎么GB怎么有这个GB文件呢
[03:10] 是不是你如果说这个不会的话
[03:13] 你可以用现成的
[03:14] 如果你就是想学一学的话
[03:16] 网上有很多攻略啊
[03:17] 大家一搜就搜完
[03:18] 那导出就可以了
[03:20] 第二个是三五驱动版的
[03:22] 就PCB源文件GB
[03:25] 还有这个这个是干什么的
[03:26] 这个是我们啊
[03:29] 还有这个这个是干什么
[03:30] 这是大家给生成好
[03:31] 这是用插件生成的
[03:32] 一个
[03:33] 就是说我们可以直接按照上面贴片的这个东西
[03:40] 42的驱动版
[03:42] 同样的哈
[03:42] 还有这个驱动
[03:43] 还有这个我们的控制器REF控制器啊
[03:48] 他就是控制我们灯
[03:51] 三五电机和42电机的一个总控制
[03:55] 是驱动
[03:56] 同样的
[03:57] 就是说我们需要把这个三五的烧录在三五的驱
[04:00] 三五的这个程序烧录在三五的这个驱动板里
[04:02] 四二的程序烧录在42的驱动板里
[04:05] 还有这个REF的程序
[04:07] 烧录在REF的驱动版里
[04:09] 这个ESP32的程序烧录到ESP32的程序版里
[04:12] 当然这里面还有我给大家注释的
[04:14] 一些单位的源码
[04:15] 后续呢可能会给大家讲
[04:17] 也可能会不出视频了
[04:18] 因为我觉得呃很多都是这个软件上的大佬啊
[04:23] 嗯大家希望能有这个软件上的大佬
[04:28] 这个呃作为这个社区的一个呃中坚力量
[04:32] 来给我们这些呃软件并不是很好的
[04:35] 同学们进行一个视频的讲解
[04:39] 让这个社区更丰富一些
[04:46] 哦对这个这个源码呢都包括些什么呢
[04:49] 其实就是我们的第一是模型
[04:53] 这两个第一是模型的头文件和CPP电机的驱动
[04:58] MOTO和control的驱动主函数
[05:01] 还有我们的这个呃
[05:03] 这个相当于就是这个robot
[05:07] 其实就是这个整个机械臂的一个参数哈
[05:10] 整个机械臂的一个参数
[05:16] 软件就是CLI-Tool
[05:18] 我其实更愿意称为它是一个万能的调试工具哈
[05:22] 这是对于Dummy来说
[05:23] 还有DummyStudio上位机啊
[05:27] 还有我们的一个木子做的一个啧
[05:32] 集合一个小工具
[05:33] 但是目前还不太完善
[05:35] 需要等待进一步开源模型
[05:39] 总共三个模型
[05:40] 木子的版本
[05:41] 稚晖君的版本V2版本
[05:43] 大家制作哪个根据哪个看就可以了
[05:46] 呃稚晖君呢这个应该是他的这个呃
[05:50] 就是装配体了
[05:51] 装配体
[05:53] 装配体怎么变成这些
[05:56] STL 文件和这个CNC文件呢
[05:58] 就大家STEP 文件就是大家可以去网上百度一下
[06:02] 因为你不管你是用SolidWorks还是用Fusion 360啊
[06:06] 他其实都都是可以导出的
[06:08] 很简单
[06:09] 就是右键导出就可以了
[06:11] 导出你想要的格式
[06:12] 稍微网上都是攻略
[06:13] 百度一下就可以
[06:14] 因为我觉得啊做成这个机械臂是结果
[06:21] 但是这个过程更重要
[06:22] 我们学习的过程才是做这个机械臂的
[06:24] 最重要的事情
[06:26] 不然其实你拿了一些这个东西组装起来
[06:31] 可能就有个大玩具
[06:32] 但是你从中会减少很多
[06:34] 你遇到这些挫折解决遇到这些挫折
[06:37] 解决挫折
[06:38] 解决困难的一个呃方法
[06:41] 和我们提高自己的一个心态的一个过程吧
[06:46] 这个简单说一下这个STEP 文件
[06:48] STEP 文件就是其实我们CNC做CNC的
[06:52] 给到CNC 厂家一些文件
[06:54] 做这些就可以
[06:56] 然后我们3D打印文件
[06:58] 因为我也把J1和这些的3D打印文件
[07:04] 也给到也给大家导出来了
[07:06] 因为我觉得真的可能会有人是不知道怎么导
[07:10] 所以说吧
[07:10] 但是就是说我们做做这个做呃
[07:16] 这个铝板啊
[07:16] 就金属板的
[07:17] 就忽略这些东西就可以
[07:19] 不需要不需要再再再去导
[07:22] 再去再去再去重复打印
[07:24] 我们只用打就是外壳件啊
[07:27] 外壳ABC这个控制器的外壳
[07:33] 外壳底衬和屏幕内衬
[07:36] 还有一个这个三五电机和42电机的一些文件
[07:41] 这个呢就是如果说有想做这个探索版的
[07:44] 切亚克力的
[07:45] 用这个就可以了
[07:46] 这是我后来画的
[07:56] 然后剂量呢大家是就是说如果说是呃
[07:59] 这个很多人会问
[08:00] 这个3D打印和CNC有什么区别啊
[08:03] 强度不同
[08:03] 精度不同
[08:05] 本着学习目的
[08:06] 3D 打印就够啊
[08:07] 如果你作为这个手里的比较宽裕的时候
[08:12] 就手里有些有有些闲钱的时候也可以做C
[08:16] 追求完美也可以做CNC版本
[08:19] 那很多人都会问我啊
[08:21] 我们这个下边这个亚克力的这个呃
[08:23] 怎么怎么怎么买呢
[08:25] 怎么也没有BOM 表啊
[08:26] 其实我已经放给大家了
[08:28] 我一直在这里边
[08:29] 因为那个没有必要用3D文件
[08:30] 我们直接你给到
[08:32] 在这个2D工程图里面有个baseball
[08:36] 我们使用这个把这个文件发给淘宝的任何一家
[08:41] 做亚克力床
[08:42] 亚亚克力板切割的人都可以做
[08:45] 因为他写标的很清楚
[08:47] 包括是多厚的板子啊
[08:49] 有多少个孔啊
[08:50] 每个孔的孔距是多少啊
[08:51] 总长是多少啊
[08:54] 没有螺纹的是40块钱
[08:55] 有螺纹的是50块钱
[08:57] 大概都是这个价
[08:58] 如果说大家就是说真的是找不到
[09:01] 找不到
[09:01] 我后续可能也会做这个做个团购给大家团一下
[09:08] 然后包括工程图
[09:10] 这些都是发给这个嘉立创啊
[09:12] 或者说是你用谁的厂子都可以
[09:14] 不同的场子
[09:15] 不管是哪个CNC厂
[09:17] 肯定都需要2D的
[09:18] 如果说不是2D的话
[09:20] 它的精度肯定也做不高啊
[09:22] 然后下边呢我们再看一下
[09:24] 就是这个BB这个BOM 表我更新过了
[09:27] 很多朋友说过很多问题我都也更新过了
[09:30] 为什么模型上面都是用的34长的电机
[09:34] 而我这个有的用42-34 / 42-40呃
[09:38] 模型是模型
[09:39] 我们实际安装调试过后时候
[09:41] 发现40的电机呢扭矩相比34呢更好一点
[09:47] 所以说呢我J2、J3的都选型用了40
[09:51] 而J1呢用34的
[09:52] 主要原因呢是J1的34会美观一点
[09:55] 并且呢它的它的承重和什么的话
[09:59] 三次也是够的啊
[10:01] 最重要的是这个J6必须得用20的
[10:04] 如果你不用20的话
[10:06] 你需要改一下模型
[10:08] 应该是也有人改过
[10:11] 我们使用的是这个
[10:13] 也有很多人问啊
[10:14] 我们V2和这个呃
[10:16] 这个谁和木子的和稚晖君的区别
[10:19] 和稚晖君的区别
[10:20] 就是我们减速器便宜和木子的区别
[10:22] 就是我们减速器使用的型号更大了
[10:26] 就是J2
[10:27] J3都使用的是42
[10:29] 配套42电机的谐波减速器
[10:31] 就是力矩更大一点
[10:34] 当然了
[10:34] 你反区也需要使更大的力气
[10:39] 嗯这个BM包括这元器件的BM
[10:42] 大家就是很多都被大家买断货了啊
[10:44] 我现在想买都买不到啊
[10:46] 大家再根据淘宝自己搜自己测就好了
[10:49] 如果使用一键购买 BOM
[10:51] 一定要验证啊
[10:52] 它并不是那么准
[10:53] 这个虽然是当初是我做的
[10:55] 但是但是因为我从来没有碰
[10:57] 嘉立创一键下单过啊
[10:58] 它里边有些东西是不准的
[11:00] 所以大家一定要注意细心一点
[11:03] 不要偷懒
[11:04] 当然你因为偷懒踩的坑也是你偷懒造成的啊
[11:12] 然后我们
[11:18] 最后看一下这个文件
[11:20] 其实这个文件是很重要的啊
[11:21] 大家可能说噢我没有什么
[11:23] 其实这个里面写的很多DH 参数
[11:26] 什么是DH 参数
[11:27] 就是让机械臂啊
[11:31] 不是就是让计算机知道
[11:32] 我们机械臂长什么样的一个东西
[11:34] 你要告诉他基座到J1的直线是多少
[11:38] 这个这个J1额基座到J1的直线是多少
[11:41] J1到J2的直线是多少
[11:43] J2到J3的直线是多少
[11:45] J3到J4
[11:46] 也就是DEM嗯
[11:48] D e l b
[11:49] 还有这个勾J4到J5
[11:51] J5到J6
[11:51] 这些直线是多少
[11:52] 这样计算机程序才能在他心里边模拟出来
[12:00] 一个机械臂的样子
[12:01] 包括这个我们J1能转多少度
[12:03] J2能转多少度
[12:04] J3能转多少度
[12:05] 不然他是不知道的
[12:07] 他没有图形化的一个
[12:09] 他没有图形化的一个东西啊
[12:15] 然后这个就是DH 参数
[12:17] 我们把这个数值一比一的填进去
[12:22] 需要填在哪里呢
[12:25] 需要填在我们收入的要收入的文件
[12:32] 要烧录的这个文件里边
[12:39] 就要填到这里边看到吗
[12:42] 这个文件在哪呢
[12:44] 这个文件在在这个reboot文件下的
[12:49] instances的dummy_robot.cpp里边
[12:54] 这个你稍微找一找就能找到了
[12:58] 大家这个制作是奔着学习来的
[13:02] 一定要有一个学习的态度
[13:04] 不然你做出来的时候你没有任何的提升
[13:09] 那为何不买一个呃成品的机械臂呢
[13:13] 那样功能又强大又方便
[13:18] 既然讲到这儿
[13:20] 就大概看一下这是什么
[13:23] 下面这一行就是DH模型
[13:27] 就是我们
[13:30] 就是我们这个图这个图里告诉计算机
[13:36] 我每一段到每一段的长是多少
[13:39] 如果再往后延伸
[13:41] 这个是什么
[13:42] 这个也是有文件的
[13:44] 这个是在六
[13:46] 这个这个也是
[13:54] 哦这个我确实用的不太
[13:56] 我我我我clean用的不是很习惯
[13:58] 我都用vs code啊
[14:00] 按理说应该是直接能这直接能飞过去的啊
[14:04] 飞过去就是我们直接到那嘶诶
[14:08] 他这是在哪啊
[14:10] 用个笨办法吧
[14:12] 函数C1下查找一下
[14:15] 哦对啊
[14:19] 这太笨了
[14:20] 这个办法
[14:21] 然后在这里啊
[14:22] 就这个文件啊
[14:23] 6dof_kinematic
[14:25] 这个其实就是DH的一个模型文件
[14:27] 它就完美的注释了
[14:29] 告诉你这是个头文件
[14:30] 还有一个.cpp 文件
[14:31] 他就是告诉你这个东西到底是怎么实现的啊
[14:35] 怎么实现
[14:36] 怎么实现这个DH 参数的啊
[14:43] 我们把我们把这些数值改完了之后
[14:47] 还有一个数值需要改
[14:51] 是有一个resetting
[14:54] 就是我们回到归巢位
[14:55] 也就是我们视频这个机械臂里面
[14:57] 现在的位置的一个数值
[15:02] 嗯跑哪儿去了
[15:19] 哦在这里这个resetting的这个位置
[15:22] 这个reset position啊
[15:25] 我们搜一下
[15:30] 在这儿看吗
[15:30] 就这个这个文件需要把这个70改成75
[15:34] 因为我们的归巢位的J2的最小
[15:37] 这个最最最最最小角度是-75
[15:41] 要改成-75
[15:42] 你可能你拿到文件可能是-73哈
[15:44] 因为木子的我记得是-73
[15:46] 需要改一下
[15:47] 然后我们就编译
[15:49] 编译成功了之后插入d link
[15:52] 这个大家应该都会的
[15:53] 能能看到调试这一步的人
[15:55] 肯定是知道怎么烧录的
[15:57] 我们编译烧录
[15:58] 当然我现在没有插了
[16:00] 肯定是开路的就完成了
[16:05] 我们接着看
[16:07] 接着看这个文件里面还有什么PIDPCB
[16:11] 这个就是PCB的照片啊
[16:12] 这个照片是早早早些时候木子嗯拍的上传的
[16:17] 这是上一个上一个版本
[16:18] 最新的板子会有一些调整啊
[16:21] 就是是什么调整呢
[16:22] 其实就是把CAN 通讯的这个插口进行了交换
[16:28] 变成了它现在原本的是中间两个是CAN 通讯
[16:31] KH和KL这一边是这个呃
[16:36] 这个电压的正一边是接地啊
[16:38] 后来他把这边换了
[16:40] 变成了两个是就是供电接地
[16:44] 然后和CAN 通讯
[16:46] 这样有效的保护了CAN 通讯
[16:47] 和这个供电的直接接触
[16:51] 减少这个这个针歪了之后
[16:54] 这个CAN 芯片的这种情况
[17:01] 我们最后说点击PID啊
[17:03] 减速器参数
[17:04] 其实就是这个减速器的一些扭矩啊和参数
[17:07] 我们可以看一下
[17:08] mini11要比mini8的扭矩要大多少哈
[17:12] 瞬间最大扭矩是50速
[17:15] 比的是17
[17:17] 平均是5.5对吧
[17:21] 你再看看迷你八是多少
[17:24] 6.6
[17:25] 2.3小了将近一半对吧还多
[17:29] 所以说你在J2、J3使用迷你11的时候
[17:33] 他肯定负载能力是更强的
[17:36] 配色也就是由我渲染的
[17:38] 我实际和帮粉丝做的一些配色
[17:43] 其他是稚晖君
[17:44] 当时那个文件夹里面
[17:46] 因为我还没看出什么东西
[17:48] 还有一些常用这个芯片
[17:50] 说明并并不全哈
[17:52] 所以说我觉得比较特殊的
[17:54] 我就放里边了啊
[17:59] 最后我们再看一下这个电机PID
[18:02] 为什么我没有把电机PID的参数
[18:04] 就是具体数值直接放在这里了
[18:06] 而是放了一个GBT解释的PID是什么
[18:11] 因为每一个PID每一个电机呃
[18:15] 大家买电机都不一样是吧
[18:17] 大家可能做版本型号也不一样对吧
[18:20] 使用减速器也不一样
[18:22] 它没有一个规范的值
[18:23] 而是靠试的
[18:25] 我们可以使用这个VOFA
[18:27] 开源的一个工具来测
[18:29] 也可以使用我给你的现场的
[18:31] 大家如果说用的是就是说跟我是一模一样
[18:37] 一比一的
[18:37] 可以直接用我的参数来进行调参
[18:40] 咱们看一下这个PID指的是什么
[18:42] GBT呢
[18:43] 现在GBT呢说PID控制
[18:45] 是是是一种常用的反馈控制方法
[18:50] 用于调节系统的输出
[18:53] 以使系统达到期望的状态
[18:55] PID代表的是比例积分微分这三个参数
[19:00] 它下面有一个详细的解释
[19:03] 用一个公式
[19:04] 所以说呢我们只需要调节KPKIKD的时候
[19:07] 就可以使这个电机达到一个完美状态
[19:10] 为什么什么叫完美状态呢
[19:14] 尤其是以谐波减速器
[19:15] 谐波减速器
[19:17] 大家可以看看啊
[19:18] 看看这个它减速器是个摆线
[19:24] 是靠波发生器
[19:25] 它输出的轴一定不是一个很输出的
[19:28] 不是一个圆形的一个波圆形的一个轨迹
[19:32] 而是一个椭圆形的
[19:34] 这个椭圆形和电机的椭圆形不匹配的时候
[19:36] 就会导致你的机械臂处于一个震动状态
[19:40] 当这两个这个摆幅的轨迹接近一致的时候
[19:46] 你的电机就不抖动了对吧
[19:49] 而谐波减速器的摆幅是固定的
[19:52] 因为它是个机械结构
[19:54] 从生产出来他就这样了
[19:56] 它而电机
[19:58] 所以说我们需要调节电机的PID
[20:01] 让它的摆幅和它一致来减小振动是吧
[20:05] 这就是我们通过软件来修饰硬件上的一些啊
[20:10] 不合理或者说是啊不好的东西啊
[20:21] 我们继续回到这个额这个文档
[20:25] 所以说我不给大家PID参数
[20:28] 更多的是基于希望大家能自己去尝试
[20:32] 因为我觉得我的PID调的也不是很好
[20:35] 我的PID在末端的时候
[20:37] J2和J3会有再回再回再回回
[20:41] 回到零位的时候会有一点点微颤
[20:44] 但是比原版的好多了
[20:46] 现在我再给大家看一下
[20:48] 这个是没有调PID
[20:50] 就是你拿到机械臂组装烧录完
[20:53] 程序烧录完
[20:54] 我刚刚说的这个
[21:01] 啊这沙鲁娃我刚刚说的这个DH 参数
[21:04] REF还有驱动
[21:05] 并且给电机做完校准了
[21:08] 电机校准
[21:09] 我想大家应该是啊
[21:11] 应该都会
[21:12] 我们按这个可以手动按K1键
[21:14] K2K1键来校准
[21:16] 也可以我们使用CLI-Tool里的do_calibration
[21:19] 来进行校准啊
[21:21] 你也可以把电机挂在机械臂上之后校准
[21:24] 你也可以在没把电机组装之前就进行校准
[21:28] 其效果是一样的
[21:30] 当然你为什么说大家肯定都知道校准呢
[21:33] 因为你测试你的板子好坏的
[21:36] 最快捷的办法就是给它通上电之后
[21:39] 给电机做个校准
[21:40] 它能它校准的数据
[21:42] 不是记录到这个REF 板里的
[21:45] 而是记录到这个
[21:46] 而是记录到STM32芯片里
[21:48] 它其实就是记录的是编码器的一个数据啊
[21:54] 下面我们上电看一下
[21:58] 我是把这个所有的调试参数都清了之后啊
[22:02] 来进行了这个嗯
[22:06] 给大家拍个视频
[22:08] 大家可以仔细看看这个有多抖哈
[22:14] 看到了吗
[22:16] 看到了吗
[22:17] 在抖
[22:17] 看到了吗
[22:19] 这是很正常的
[22:20] 因为因为大家仔细看
[22:25] 会发现这个的抖动是和那个的抖动哦
[22:28] 咱们看J3吧
[22:30] 你看他抖动和他的抖动是不一样的
[22:32] 知道吗
[22:33] 这两个转的抖动他不是是一个他不是转的圆
[22:38] 他是它的轨迹是一个椭圆形
[22:41] 好了吧
[22:46] 我们现在给他归位好吗
[22:56] 现在呢我来教大家怎么调节这个PID
[23:00] 也就是我们本节课的一个核心重点
[23:05] 首先我们进入
[23:09] CLI-Tool我已经再再加加强一遍
[23:12] 一定是烧录了正确的DNAH参数之后
[23:22] 好
[23:24] 首先我们连一下就是
[23:32] 应该大家都会连哈
[23:39] 还需要什么呢
[23:41] 需要借助我们到初始位置
[23:48] 实际上呢这是一个笨办法
[23:51] 在稚晖君原版里呢
[23:53] 我也不知道为什么我这个这个代码呢
[23:57] 就不能用了啊
[23:59] 呃在等待这个连接成功的时候
[24:01] 我们看一下CPU
[24:02] 看一下这个RE或者原本的这个函数哈
[24:07] 你看他这里
[24:12] 他这里有一个校准的
[24:15] 其实一个校准的一个函数就是calibration_home_offset
[24:19] 他让我们干什么呢
[24:22] 就不使能是否使能
[24:24] 判断是否使用对吧
[24:26] 然后手动把位置摆到一个L 型
[24:32] 其实就是七字形哈
[24:34] 然后呢他说设置这个限制电流是0.3对吧
[24:40] 然后延迟 500ms500ms啊
[24:44] 额然后呢
[24:46] 把这个位置呢设为这个这个home位置对吧
[24:51] 然后呢
[24:52] 它在自动回复到0~0到0~90再记录对吧
[24:58] 然后呢他又在回复到resetting的位置记录
[25:05] 而我用这个calibration教程之后
[25:08] 发现它会出现一个问题
[25:10] 就是他的从home位到归巢位的时候
[25:15] 会出现无限的就是电机嗡鸣和使能不记录数值
[25:21] 所以说我们现在用一个笨办法
[25:23] 来记录它的初始位置
[25:25] 就是我们让电机的关节记住它的定位
[25:34] 首先我们
[25:39] 技术够一的就是看这个屏幕是Dummy-Robot啊
[25:45] Jot 1a pay home offset
[25:49] 然后我们再记住第二个位置
[25:51] 就是当前的位置
[25:52] 我们手动摆好了
[25:52] 记住他当前的位置
[25:54] 记录电机的当前关节位置是一样的啊
[25:58] 四
[26:01] 五
[26:08] 完成然后我们REBOT
[26:12] 好断电重启
[26:18] 这个时候你每一次归巢的时候
[26:21] 就会回到这个位置
[26:22] 是准的
[26:23] 他不会说会抬起来一点
[26:25] 或者说是歪了一点好
[26:27] 因为我们已经手动的让关节
[26:29] 让每一个电机驱动板记录
[26:32] 现在的位置
[26:33] 是他的零位和和用机械臂里边的这个函数
[26:39] 实现的功能是一样的
[26:41] 唯一不好的就是他记录不到他的home 位就是零
[26:45] 就是他七字形的位置
[26:47] 也就是0~0到90度
[26:48] 零度零度零这个坐标
[26:53] 现在呢我们再调一下PID
[26:56] 大家跟着我的PID调就可以
[26:58] 只要你跟我用的是一样的啊
[27:04] 只用调J1、J2、J3
[27:06] 哪个抖调哪个不抖
[27:07] 你没有必要调的啊
[27:11] 先调KP吧
[27:14] KP是2000
[27:17] 其实J1也不抖
[27:18] 但是我还是给他调了
[27:25] 就是调123
[27:26] 然后我们再调一下KD吧
[27:29] KD是300
[27:38] 然后调K2K2是200
[27:43] 很多人问我
[27:44] 我说我也记不住啊
[27:45] 我说这让机器记啊
[27:50] 然后我们再调一下KV
[27:53] KV是120
[27:57] 按照我这个调吧
[27:59] 你可能不会非常完美
[28:01] 但是也可以有效提高
[28:04] 我们report一下
[28:08] 重启一下
[28:10] 现在我们用DummyStudio
[28:14] 然后连接一下看一下
[28:16] 他还抖吗
[28:18] 大家可以看一下啊
[28:20] 我们把它复位一下
[28:24] 你看不抖了吧是吧
[28:34] J1也不抖了对吧
[28:35] 我们刚刚看的最多的是J2三抖
[28:41] 一定要注意重心哈
[28:43] 他架的底板也并不是完全就行了
[28:49] 所有的电机嗡鸣都是正常的
[28:51] 因为它会在特定的角度
[28:55] 它产生的力矩不一样
[28:56] 他就会给更大电流
[28:58] 当然你在给他更大的电流的情况下可能会好好
[29:03] 所以说呢这个呢就是我们调节PID的意义
[29:08] 对吧啊
[29:09] 调节记录home 位的方法
[29:12] 其实这些调试完了
[29:13] 就是我能教给大家的就已经都教完了
[29:18] 也相当于是我们整个的这一期的这个课程
[29:21] 就结束了啊
[29:23] 也希望呢大家呢在后续的都能复刻成功
[29:28] 自己的机械臂
[29:30] 那后面呢小任同学呢可能会给大家讲讲代码
[29:34] 也可能会做一个结语的小视频
[29:37] 也谢谢大家陪伴了这么久
[29:40] 给了呃这个任同学这么多的动力啊
[29:45] 坚持去分享
[29:46] 去做一些东西
[29:48] 嗯谢谢大家
[29:50] 谢感谢观看
