MARS-ROBOTICS-star/Dummy-Robot-Reproduction/(list of files, drawings)

Other design files:
source/1.Dummy V2任同学整理/1.Hardware/motor35/PCB源文件/Motor_35.PrjPcb
source/1.Dummy V2任同学整理/1.Hardware/motor42/PCB源文件/Drive.SchDoc
source/1.Dummy V2任同学整理/1.Hardware/motor42/PCB源文件/Interface.SchDoc
source/1.Dummy V2任同学整理/1.Hardware/motor42/PCB源文件/MCU.SchDoc
source/1.Dummy V2任同学整理/1.Hardware/motor42/PCB源文件/Motor-42.PcbDoc
source/1.Dummy V2任同学整理/1.Hardware/motor42/PCB源文件/Motor-42.PrjPcb
source/1.Dummy V2任同学整理/1.Hardware/motor42/PCB源文件/Port.SchDoc
source/1.Dummy V2任同学整理/1.Hardware/motor42/PCB源文件/Power.SchDoc
source/1.Dummy V2任同学整理/1.Hardware/ref-controller/PCB源文件/REF-Base.PcbDoc
source/1.Dummy V2任同学整理/1.Hardware/ref-controller/PCB源文件/ref-controller.PrjPcb
