MARS-ROBOTICS-star/Dummy-Robot-Reproduction/source/1.Dummy V2任同学整理/2.Firmware/dummy-35motor-fw/Core/Src/can.c

/**
  ******************************************************************************
  * @file    can.c
  * @brief   This file provides code for the configuration
  *          of the CAN instances.
  ******************************************************************************
  * @attention
  *
  * <h2><center>&copy; Copyright (c) 2021 STMicroelectronics.
  * All rights reserved.</center></h2>
  *
  * This software component is licensed by ST under BSD 3-Clause license,
  * the "License"; You may not use this file except in compliance with the
  * License. You may obtain a copy of the License at:
  *                        opensource.org/licenses/BSD-3-Clause
  *
  ******************************************************************************
  */

/* Includes ------------------------------------------------------------------*/
#include "can.h"

/* USER CODE BEGIN 0 */
#include "common_inc.h"
#include "configurations.h"

CAN_TxHeaderTypeDef TxHeader;
CAN_RxHeaderTypeDef RxHeader;
uint8_t TxData[8];
uint8_t RxData[8];
uint32_t TxMailbox;

/* 发送失败的丢帧计数。原实现在发送失败时直接调 Error_Handler()
   (__disable_irq() + while(1))，总线繁忙 / 主控掉线 / 未接终端电阻时，
   一次发送失败就让关节板永久卡死，必须断电重启。现改为丢帧并在此计数。 */
volatile uint32_t canTxDropCount = 0;
/* 接收取帧失败计数（原来同样会死锁）。 */
volatile uint32_t canRxErrorCount = 0;

/* USER CODE END 0 */

CAN_HandleTypeDef hcan;

/* CAN init function */
void MX_CAN_Init(void)
{

  hcan.Instance = CAN1;
  hcan.Init.Prescaler = 4;
  hcan.Init.Mode = CAN_MODE_NORMAL;
  hcan.Init.SyncJumpWidth = CAN_SJW_1TQ;
  hcan.Init.TimeSeg1 = CAN_BS1_5TQ;
  hcan.Init.TimeSeg2 = CAN_BS2_3TQ;
  hcan.Init.TimeTriggeredMode = DISABLE;
  hcan.Init.AutoBusOff = DISABLE;
  hcan.Init.AutoWakeUp = ENABLE;
  hcan.Init.AutoRetransmission = DISABLE;
  hcan.Init.ReceiveFifoLocked = DISABLE;
  hcan.Init.TransmitFifoPriority = DISABLE;
  if (HAL_CAN_Init(&hcan) != HAL_OK)
  {
    Error_Handler();
  }
  /* USER CODE BEGIN CAN_Init 2 */
    CAN_FilterTypeDef sFilterConfig;
    //filter one (stack light blink)
    sFilterConfig.FilterBank = 0;
    sFilterConfig.FilterMode = CAN_FILTERMODE_IDMASK;
    sFilterConfig.FilterScale = CAN_FILTERSCALE_32BIT;
    sFilterConfig.FilterIdHigh = 0x0000;
    sFilterConfig.FilterIdLow = 0x0000;
    sFilterConfig.FilterMaskIdHigh = 0x0000;
    sFilterConfig.FilterMaskIdLow = 0x0000;
    sFilterConfig.FilterFIFOAssignment = CAN_RX_FIFO0;
    sFilterConfig.FilterActivation = ENABLE;
    sFilterConfig.SlaveStartFilterBank = 14;
    if (HAL_CAN_ConfigFilter(&hcan, &sFilterConfig) != HAL_OK)
    {
        /* Filter configuration Error */
        Error_Handler();
    }

    HAL_CAN_Start(&hcan); //start CAN

    HAL_CAN_ActivateNotification(&hcan,
                                 CAN_IT_TX_MAILBOX_EMPTY |
                                 CAN_IT_RX_FIFO0_MSG_PENDING | CAN_IT_RX_FIFO1_MSG_PENDING |
                                 /* we probably only want this */
                                 CAN_IT_RX_FIFO0_FULL | CAN_IT_RX_FIFO1_FULL |
                                 CAN_IT_RX_FIFO0_OVERRUN | CAN_IT_RX_FIFO1_OVERRUN |
                                 CAN_IT_WAKEUP | CAN_IT_SLEEP_ACK |
                                 CAN_IT_ERROR_WARNING | CAN_IT_ERROR_PASSIVE |
                                 CAN_IT_BUSOFF | CAN_IT_LAST_ERROR_CODE |
                                 CAN_IT_ERROR);

/* Configure Transmission process */
    TxHeader.StdId = boardConfig.canNodeId;
    TxHeader.ExtId = 0x00;
    TxHeader.RTR = CAN_RTR_DATA;
    TxHeader.IDE = CAN_ID_STD;
    TxHeader.DLC = 8;
    TxHeader.TransmitGlobalTime = DISABLE;

  /* USER CODE END CAN_Init 2 */

}

void HAL_CAN_MspInit(CAN_HandleTypeDef* canHandle)
{

  GPIO_InitTypeDef GPIO_InitStruct = {0};
  if(canHandle->Instance==CAN1)
  {
    /* CAN1 clock enable */
    __HAL_RCC_CAN1_CLK_ENABLE();

    __HAL_RCC_GPIOB_CLK_ENABLE();
    /**CAN GPIO Configuration
    PB8     ------> CAN_RX
    PB9     ------> CAN_TX
    */
    GPIO_InitStruct.Pin = GPIO_PIN_8;
    GPIO_InitStruct.Mode = GPIO_MODE_INPUT;
    GPIO_InitStruct.Pull = GPIO_NOPULL;
    HAL_GPIO_Init(GPIOB, &GPIO_InitStruct);

    GPIO_InitStruct.Pin = GPIO_PIN_9;
    GPIO_InitStruct.Mode = GPIO_MODE_AF_PP;
    GPIO_InitStruct.Speed = GPIO_SPEED_FREQ_HIGH;
    HAL_GPIO_Init(GPIOB, &GPIO_InitStruct);

    __HAL_AFIO_REMAP_CAN1_2();

    /* CAN1 interrupt Init */
    HAL_NVIC_SetPriority(USB_HP_CAN1_TX_IRQn, 3, 0);
    HAL_NVIC_EnableIRQ(USB_HP_CAN1_TX_IRQn);
    HAL_NVIC_SetPriority(USB_LP_CAN1_RX0_IRQn, 3, 0);
    HAL_NVIC_EnableIRQ(USB_LP_CAN1_RX0_IRQn);
    HAL_NVIC_SetPriority(CAN1_RX1_IRQn, 3, 0);
    HAL_NVIC_EnableIRQ(CAN1_RX1_IRQn);
    HAL_NVIC_SetPriority(CAN1_SCE_IRQn, 3, 0);
    HAL_NVIC_EnableIRQ(CAN1_SCE_IRQn);
  }
}

void HAL_CAN_MspDeInit(CAN_HandleTypeDef* canHandle)
{

  if(canHandle->Instance==CAN1)
  {
    /* Peripheral clock disable */
    __HAL_RCC_CAN1_CLK_DISABLE();

    /**CAN GPIO Configuration
    PB8     ------> CAN_RX
    PB9     ------> CAN_TX
    */
    HAL_GPIO_DeInit(GPIOB, GPIO_PIN_8|GPIO_PIN_9);

    /* CAN1 interrupt Deinit */
    HAL_NVIC_DisableIRQ(USB_HP_CAN1_TX_IRQn);
    HAL_NVIC_DisableIRQ(USB_LP_CAN1_RX0_IRQn);
    HAL_NVIC_DisableIRQ(CAN1_RX1_IRQn);
    HAL_NVIC_DisableIRQ(CAN1_SCE_IRQn);
  }
}

/* USER CODE BEGIN 1 */
/* 等空邮箱的最大轮询次数。CAN_Send 由 CAN RX ISR（抢占优先级 3）调用，
   而 20 kHz 电机控制环跑在 TIM4 ISR（抢占优先级 0），所以这里的自旋
   不会拖慢控制环。注意不能用 HAL_GetTick() 做超时：SysTick 的优先级
   低于本 ISR，uwTick 在这里根本不会递增。 */
#define CAN_TX_SPIN_LIMIT 2000U

void CAN_Send(CAN_TxHeaderTypeDef* pHeader, uint8_t* data)
{
    /* 三个发送邮箱可能短时占满，自旋等一个空出来；等不到就丢这一帧。
       这里绝不能调 Error_Handler()，那会永久卡死关节板。 */
    volatile uint32_t spin = CAN_TX_SPIN_LIMIT;
    while (HAL_CAN_GetTxMailboxesFreeLevel(&hcan) == 0U && spin != 0U)
    {
        spin--;
    }

    if (HAL_CAN_AddTxMessage(&hcan, pHeader, data, &TxMailbox) != HAL_OK)
    {
        canTxDropCount++;
    }
}

void HAL_CAN_RxFifo0MsgPendingCallback(CAN_HandleTypeDef* CanHandle)
{
    /* Get RX message */
    if (HAL_CAN_GetRxMessage(CanHandle, CAN_RX_FIFO0, &RxHeader, RxData) != HAL_OK)
    {
        /* 取帧失败：计数后直接返回。原实现调 Error_Handler() 会死锁；
           而继续往下走会把上一帧残留的 RxHeader / RxData 当成新帧处理。 */
        canRxErrorCount++;
        return;
    }

    uint8_t id = (RxHeader.StdId >> 7); // 4Bits ID & 7Bits Msg
    uint8_t cmd = RxHeader.StdId & 0x7F; // 4Bits ID & 7Bits Msg
    if (id == 0 || id == boardConfig.canNodeId)
    {
        OnCanCmd(cmd, RxData, RxHeader.DLC);
    }
}
/* USER CODE END 1 */

/************************ (C) COPYRIGHT STMicroelectronics *****END OF FILE****/
