MARS-ROBOTICS-star/Dummy-Robot-Reproduction/source/1.Dummy V2任同学整理/2.Firmware/dummy-35motor-fw/Core/Inc/can.h

/**
  ******************************************************************************
  * @file    can.h
  * @brief   This file contains all the function prototypes for
  *          the can.c file
  ******************************************************************************
  * @attention
  *
  * <h2><center>&copy; Copyright (c) 2021 STMicroelectronics.
  * All rights reserved.</center></h2>
  *
  * This software component is licensed by ST under BSD 3-Clause license,
  * the "License"; You may not use this file except in compliance with the
  * License. You may obtain a copy of the License at:
  *                        opensource.org/licenses/BSD-3-Clause
  *
  ******************************************************************************
  */
/* Define to prevent recursive inclusion -------------------------------------*/
#ifndef __CAN_H__
#define __CAN_H__

#ifdef __cplusplus
extern "C" {
#endif

/* Includes ------------------------------------------------------------------*/
#include "main.h"

/* USER CODE BEGIN Includes */
extern CAN_HandleTypeDef hcan;
extern CAN_TxHeaderTypeDef TxHeader;
extern CAN_RxHeaderTypeDef RxHeader;
extern uint8_t TxData[8];
extern uint8_t RxData[8];
extern uint32_t TxMailbox;
extern float motor_temperature;
/* USER CODE END Includes */

extern CAN_HandleTypeDef hcan;

void MX_CAN_Init(void);

/* USER CODE BEGIN Prototypes */
void CAN_Send(CAN_TxHeaderTypeDef* pHeader, uint8_t* data);

/* 发送丢帧 / 接收取帧失败的累计次数，供调试器或上层查询。
   原实现在这两种情况下调 Error_Handler()，会让板子永久卡死。 */
extern volatile uint32_t canTxDropCount;
extern volatile uint32_t canRxErrorCount;

/* USER CODE END Prototypes */

#ifdef __cplusplus
}
#endif

#endif /* __CAN_H__ */

/************************ (C) COPYRIGHT STMicroelectronics *****END OF FILE****/
