MARS-ROBOTICS-star/Dummy-Robot-Reproduction/(commit log)

2026-10-22 初始提交：Dummy V2 复刻项目全部资料
    包含任同学整理的 V2 资料包（固件/模型/软件/文档）、上游 dummy 仓库源码、
    复刻路线图与笔记、嵌入式学习字幕、PROJECT_INDEX.md 索引。
    已排除：source 下两个原始压缩包（超 GitHub 100MB 单文件限制）、
    上游仓库克隆的 .git 元数据、本地日志目录。
2026-10-23 chore: 补充本地产出,忽略 Altium 自动生成物
    - notes/motor42驱动板.md、notes/ref主控板.md:两块板的硬件分析笔记
    - notes/打板_2026-10-13/:Motor-42 与 REF-Base 的嘉立创打板上传包
    及 Gerber / 钻孔 / DRC 输出(135 个文件)
    - 5.Bom/:实际采购 iBOM 与立创商城 BOM 模板
    - 三块板的 *.PrjPcb:Altium 工程定义文件,缺了就打不开工程,
    属于源文件而非缓存,因此纳入版本管理
    - .gitignore:忽略 History/、__Previews/、*.PrjPcbStructure 等
    打开工程即自动重建的缓存;忽略 source/dummy2/(失败的 gitee
    克隆,零对象、无工作区文件)
    motor42/ref-controller 的 .SchDoc/.PcbDoc 与 Dummy_V2_BOM_Rya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
2026-10-23 chore: 不再跟踪 Altium History 自动备份包
    初始提交误收了 4 个 Altium 自动备份包(motor35 两个、ref-controller
    两个,合计约 10.6MB)。上一提交已把 History/ 写入 .gitignore,但
    .gitignore 不作用于已跟踪文件,导致同类备份包"4 个在仓库、其余被忽略"
    的不一致。
    本次仅从索引移除,磁盘文件保留;Altium 打开工程时会自行重建。
2026-11-02 docs: 七块板测试、维修与烧录记录，测点图
    - 七块板万用表与上电测试指南、测试记录（42-3 / 35-2 维修报告、排障方法总结、烧录记录、待采购清单）
    - Motor42 / Motor35 / REF 上电测点图与 3.3V 短路排查图、35-2 地线隔离图、R4 一带放大图
    - 电机驱动板 / LedRing 焊接指南、3D 打印与 CNC 清单、采购 BOM 交互页
2026-11-02 chore: 更新 Altium 源文件、BOM 与改版 3D 模型
    - motor42 / ref-controller 原理图与 PCB（Altium 打开后保存的版本）
    - Ryan BOM、实际采购 iBOM
    - 视频款改版 SolidWorks 零件 / 装配体、CNC 加工 STEP 压缩包
2026-11-02 chore: 不再跟踪 SolidWorks 临时锁文件
    改版/ 与 木子晓汶版本3D模型/Out_stp1/src/ 下有 53 个 6 字节的
    ~$*.SLDPRT / ~$*.SLDASM 文件，是 SolidWorks 打开模型时生成的锁文件，
    关闭软件后残留被误入库。从索引移除并在 .gitignore 加 ~$* 规则
    （同时覆盖 Office 的 ~$*.xlsx 锁文件）。本地文件保留不动。
2026-11-02 fix: 修补 35 与 REF 固件在 Linux + arm-none-eabi 下的编译阻塞
    35 电机固件（3 处）：stdint-gcc.h 是 GCC 私有头，当前 arm-none-eabi-gcc
    10.3.1 的三个 include 搜索路径里都不提供（全盘只有 x86_64 宿主 GCC 带它），
    必然报 No such file or directory。改为标准 <stdint.h>，与 42 侧 2026-09-06
    的修补方式一致。
    REF 主控固件（3 处）：include 写的是小写 mpu6050.hpp，实际文件名为
    MPU6050.hpp。Windows 文件系统不区分大小写所以上游未暴露，Linux 下直接
    fatal error。已扫全树确认仅此 3 处大小写不匹配。
    两份固件现均可构建通过（CMAKE_BUILD_TYPE=Debug）：
    35 : FLASH 7444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
2026-11-02 chore: 加入 35 与 REF 固件构建产物
    build/motor35-baseline/ 与 build/ref-baseline/，与已有的
    build/motor42-baseline/ 并列。烧录用 .hex（STM32CubeProgrammer 直接认）。
    与 42 那次不同，这次只跟踪 .elf/.hex/.bin/.map 四个产物本体，
    CMakeFiles/、CMakeCache.txt、cmake_install.cmake、Makefile 加进
    .gitignore（两个目录的中间产物合计约 27 MB，无保留价值）。
2026-11-02 fix: 电机固件 CAN 发送/接收失败不再死锁
    原实现在 Core/Src/can.c 的 CAN_Send() 与
    HAL_CAN_RxFifo0MsgPendingCallback() 里一失败就调 Error_Handler()，
    而 Core/Src/main.c:171-179 的 Error_Handler() 是 __disable_irq() +
    while(1){}。总线没接终端电阻、主控没上电、CAN 线序接错都会让发送失败，
    一次失败就让关节板永久卡死，必须断电重启。配合
    AutoRetransmission = DISABLE 更容易踩到。
    改法：
    - CAN_Send()：先自旋等一个空发送邮箱（上限 CAN_TX_SPIN_LIMIT = 2000
    次轮询），等不到就丢这一帧并 canTxDropCount++。
    - 接收回调：canRxErrorCount++ 后直接 return。不能只去掉
    Error_H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
2026-11-02 docs: 同步笔记、索引与 CLAUDE.md 到当前进度
    notes/七块板测试记录.md（5 处）：
    - 进度行改为「35/REF 已编译、CAN 死锁已修、42-1/42-2 需重烧」
    - 一·五 烧录记录表填上 35 与 REF 的 hex 路径，42 行加重烧提醒
    - 新增「一·四、固件编译记录」：工具链版本、编译命令、为何用外置
    build 目录、Linux 下改的 6 处及原因、三块板容量表、两条容量约束
    - 新增「一·四b、电机固件 CAN 死锁修复」：原问题、改法、两个设计
    取舍、没动的地方、代价与遗留
    PROJECT_INDEX.md（15 处）：
    - 第五节第 14 条（CAN 死锁，原标「全项目最该先改的一处」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
2026-11-02 fix: REF 未接电机板时 OLED 不亮，临时注释 dummy.Init()
    dummy.Init() 会连发 6 帧 CAN。CanSendMessage 的 TX 信号量只在发送成功回调里释放，
    总线上无节点回 ACK 时第 2 帧永久阻塞，Main 挂起，OLED 永远不初始化。
    接机械臂前须恢复。同步测试记录（一·四c）与索引第五节 21b。
2026-11-02 docs: 记录 REF USB 排障（换 J1、U11 损坏致 CAN1 初始化卡死）
    - 测试记录新增四·二：J1 内 D+/CC1 短路已换；限流 0.1 A 卡 4 V 插曲；
    Hot plug 定位到 MX_CAN1_Init → Error_Handler，U11 接收输出卡低，
    翘起第 4 脚后 USB 识别为 COM10
    - 总览、当前进度、采购单（SN65HVD232DR 至少 3 颗）同步更新
    - CLAUDE.md 项目现状同步
2026-11-04 docs: 录入 2026-11-04 采购清单、CNC 结构件与成本总览
    - 实际采购 iBOM：新增「螺丝」表（12 种螺丝 670 颗、螺母/平垫/超薄垫片，5 单 61.49 元）、
    新增「CNC结构件」表（全套 1393 + 底板 115，待发货）、新增「成本总览」表（跨表取数）
    - 元器件采购：新增「淘宝补购(2026-11-04)」——STM32F405RGT6×2、SN65HVD232DR×5、
    1008 2.2µH 3.8A 电感 20 只，实付 58.80 元；采购总览同步
    - 电机减速器：谐波 Mini11/Mini8、同步轮、同步带改为今日实付单价，新增 3P 短线行，
    总价公式纳入此前排除的 G10:G14
    - 成本：本体 3928.98 元 + 工具 694.58 元 = 4623.56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
