MARS-ROBOTICS-star/Dummy-Robot-Reproduction/(notices)

Notices in the files:
source/1.Dummy V2任同学整理/6.Docs/复刻审计_2026-09-06/extracted/6.Docs__芯片说明__STM32F405.pdf.txt:
OF ANY JURISDICTION), OR INFRINGEMENT OF ANY PATENT, COPYRIGHT OR OTHER INTELLECTUAL PROPERTY RIGHT.
© 2013 STMicroelectronics - All rights reserved
